temafey/ArduinoWindStation/tasks/README.md

# Сборка Wind Station — очередь задач

Каждая задача — отдельная сессия Claude Code.
Стартовый промпт: `Читай tasks/NN-name.md и выполни задачу шаг за шагом. Источники истины: CLAUDE.md, bom-photos.md.`

## Статус

Статусы 01–07 выставлены по факту: станция собрана на макетке и работает — читает батарею
и сигнал датчика, светодиодами рулит прошивка. Плата с 2026-09-11 — `d4:e9:f4:02:c4:48`
(старая признана бракованной), IP плавает по DHCP: искать
`arp -a | Select-String 'd4-e9-f4-02-c4-48'`, либо AP 192.168.4.1.
Файлы этих задач писались до сборки и внутри себя выполнение не отмечают.

| # | Задача | Статус | Блокер |
|---|---|---|---|
| 01 | [Светодиоды на макетке](01-leds.md) | ✅ Сделано | — |
| 02 | [Настройка boost-модулей](02-boost-config.md) | ✅ Сделано | — |
| 03 | [Подготовка батарей](03-batteries.md) | ✅ Сделано | — |
| 04 | [Силовая шина (diode-OR)](04-power-rail.md) | ✅ Сделано | — |
| 05 | [Делитель батареи GPIO32](05-battery-divider.md) | ✅ Сделано | — |
| 06 | [Делители сигнала GPIO34/35](06-signal-dividers.md) | ✅ Сделано (нужен только GPIO34 — датчик без направления) | — |
| 07 | [Подключение датчика](07-sensor.md) | ✅ Сделано | — |
| 08 | [Монтаж в корпус IP65](08-enclosure.md) | ⏸ **Делать последней** | сначала 10, иначе корпус вскрывать; PPTC нужен на 3 А, а не 2 А |
| 09 | [Пересоздать KiCad-проект (с тестами)](09-kicad-project.md) | ▶️ Pass 2 разблокирован | KiCad закрыт ✅ |
| 10 | [4G/GPS-модуль A7670E](10-a7670e-4g-gps.md) | ▶️ **Канал замкнут 2026-09-12.** Данные по 4G ходят, PPP поднимается, брокер HiveMQ работает с тремя учётками, прошивка публикует шесть топиков, **публичная копия дашборда показывает живой ветер с мачты** через свой MQTT-клиент по `wss://`. **Вся работа по коду и документам закрыта 2026-09-12** — pull-OTA сделан и проверен на железе (шаг 38), FQBN в `WindStation-kit.zip` поправлен (39), энергобюджет с модемом пересчитан (36). Остались только проверки на железе | ⛔ темп 5 Гц, радиополя по 4G и pull-OTA **через сам модем** — упираются в **11** и в ключ питания модема GPIO33 |
| 11 | [Выключатель и путь заряда](11-power-switch-and-charge-path.md) | ⏭ **Следующая после 10.** Отложена 2026-09-11, но задача 10 упёрлась в неё двумя пунктами: `powerSource` намертво `battery`, поэтому облако вечно в режиме 1 Гц, а 5 Гц физически непроверяем | — |
| 12 | [Плата J5019 — ресерч](12-j5019-evaluation.md) | 📋 Ресерч сделан, вердикт «в станцию не ставить» | — (стендовые замеры по желанию) |

Все компоненты на руках. Долги по железу собраны в **задачу 11**, но она отложена:
вход `IN+` TP4056 не припаян, банки в держателе нет, тумблер стоит после обоих бустов.
Там же — сверка номинала PPTC (нужен 3 А, не 2 А) и недоверие к делителю GPIO32.

⚠️ **Прямое следствие для задачи 10:** станция работает от USB, поэтому `battery` и
`batteryPercent` отдают `null`, `chargeState` — `absent`, `powerSource` — `battery`.
Это ожидаемо и за поломку не считается; дашборд уже разбирает такой случай по флагам
присутствия. Силовые замеры модема (TP1 под передачей, заряд до STDBY, пресет буста №3)
уехали в **задачу 08** — делать их до посадки модема в корпус не на чем.

## Порядок выполнения

```
Железо:  01 ✅ → 02 ✅ → 03 ✅ → 04 ✅ → 05 ✅ → 06 ✅ → 07 ✅ → 11 (отложена)
KiCad:   09 (документация электрики, независимо от железа)
4G/GPS:  10 (в работе) → 08 (корпус и вся силовая часть модема, в самом конце)
```

> **Порядок поменялся 2026-09-11: сначала 10, потом 11.** Прежний довод («мерить нечем,
> станция не отвечает») отпал — станция отвечает, модем отвечает, а работа фазы 3 задачи 10
> это код и один замер ваттметром, которым долги по зарядному узлу не мешают. Всё, что
> в 10 действительно упиралось в питание, перенесено в **08**: посадка модема в макетку,
> буст №3, TP1 под передачей, заряд до STDBY.

> **Актуальная схема — `wiring-v8.html`**: с 2026-09-06 в станции плата 38-pin DevKitC,
> она заняла колонки 1–19 вместо 1–15, и всё правее сдвинулось. Блок модема на ней
> нарисован целиком: кол. 36–42 наклейкой вниз, `GPIO27 (TX) → кол.37 «R»`,
> `GPIO25 (RX) ← кол.38 «T»`, SW1 в разрыве `OUT+` (вход блока — `51h`, не `49j`),
> земля модема — перемычка `41b`→`44b`. Контакты опознаются **по буквам шелкографии**,
> а не по номерам.
>
> ⚠️ **Но собрано сейчас не так.** До задачи 08 модем остаётся **внешним модулем со своим
> питанием**: три провода, и как именно — `wiring-v8-3.html`. Провод общей земли там
> обязателен, без него UART молчит при живом модеме. «Плюс» модема не брать с пина «5V» платы.
> `wiring-v7.html` (30-pin), `wiring-v6.html` и `wiring-v5.html` оставлены для сравнения.

> **08 переехала в конец очереди.** Закрывать корпус до интеграции 4G — значит вскрывать его
> обратно: модем добавляет блок питания, два провода UART и две антенны, которые надо разнести
> на 10–15 см. Заодно меняется и номинал PPTC (3 А вместо 2 А — расчёт в задаче 10, §Питание).

> Задача 09 опирается на `wind-station-schematic.md` — выверенный нетлист (источник истины для схемы).
