temafey/ArduinoWindStation/kicad/WindStation_drc_report.txt

** Drc report for WindStation.kicad_pcb **
** Created on 2026-06-30T23:53:48 **
** Report includes: Errors, Warnings **

** Found 34 DRC violations **
[silk_overlap]: Silkscreen clearance
    Rule: board setup constraints silk; warning
    @(115.9950 mm, 115.7750 mm): Rectangle of R5 on F.Silkscreen
    @(119.2650 mm, 118.8250 mm): Reference field of R6
[silk_overlap]: Silkscreen clearance
    Rule: board setup constraints silk; warning
    @(167.8550 mm, 98.2500 mm): Segment of BT2 on F.Silkscreen
    @(119.2650 mm, 98.5750 mm): Reference field of R1
[silk_overlap]: Silkscreen clearance
    Rule: board setup constraints silk; warning
    @(115.9950 mm, 99.5750 mm): Rectangle of R1 on F.Silkscreen
    @(119.2650 mm, 102.6250 mm): Reference field of R2
[silk_overlap]: Silkscreen clearance
    Rule: board setup constraints silk; warning
    @(129.6550 mm, 110.1250 mm): Arc of D4 on F.Silkscreen
    @(129.6550 mm, 113.6350 mm): Reference field of D5
[silk_overlap]: Silkscreen clearance
    Rule: board setup constraints silk; warning
    @(129.6550 mm, 117.5950 mm): Arc of D5 on F.Silkscreen
    @(129.6550 mm, 121.1050 mm): Reference field of D6
[silk_overlap]: Silkscreen clearance
    Rule: board setup constraints silk; warning
    @(119.2650 mm, 114.7750 mm): Reference field of R5
    @(115.9950 mm, 111.7250 mm): Rectangle of R4 on F.Silkscreen
[silk_overlap]: Silkscreen clearance
    Rule: board setup constraints silk; warning
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
    @(150.3750 mm, 99.5750 mm): Rectangle of D1 on F.Silkscreen
    @(153.0950 mm, 102.8250 mm): Reference field of D2
[silk_overlap]: Silkscreen clearance
    Rule: board setup constraints silk; warning
    @(115.9950 mm, 127.9250 mm): Rectangle of R8 on F.Silkscreen
    @(119.2650 mm, 130.9750 mm): Reference field of R9
[silk_overlap]: Silkscreen clearance
    Rule: board setup constraints silk; warning
    @(119.2650 mm, 135.0250 mm): Reference field of R10
    @(115.9950 mm, 131.9750 mm): Rectangle of R9 on F.Silkscreen
[silk_overlap]: Silkscreen clearance
    Rule: board setup constraints silk; warning
    @(129.6550 mm, 125.0650 mm): Arc of D6 on F.Silkscreen
    @(129.6550 mm, 128.5750 mm): Reference field of D7
[silk_overlap]: Silkscreen clearance
    Rule: board setup constraints silk; warning
    @(115.9950 mm, 119.8250 mm): Rectangle of R6 on F.Silkscreen
    @(119.2650 mm, 122.8750 mm): Reference field of R7
[silk_overlap]: Silkscreen clearance
    Rule: board setup constraints silk; warning
    @(119.2650 mm, 126.9250 mm): Reference field of R8
    @(115.9950 mm, 123.8750 mm): Rectangle of R7 on F.Silkscreen
[silk_overlap]: Silkscreen clearance
    Rule: board setup constraints silk; warning
    @(119.2650 mm, 139.0750 mm): Reference field of R11
    @(115.9950 mm, 136.0250 mm): Rectangle of R10 on F.Silkscreen

** Found 0 unconnected pads **

** Found 0 Footprint errors **

** Ignored checks **
    - Footprint has no courtyard defined
    - Track endpoint not centered on via
    - Tuning profile track geometries
    - Footprint doesn't match symbol's footprint filters
    - Footprint component type doesn't match footprint pads

** End of Report **
