temafey/ArduinoWindStation/DISPLAY.md

# Дисплей в корпусе — ESP32-2432S028 («Cheap Yellow Display»)

Отдельная плата со своим ESP32 и экраном 2.8″ 320×240. Показывает то же, что дашборд:
скорость, порыв, балл Бофорта, график за 10 минут, батарею, связь. Скетч —
`wind_display/wind_display.ino`, шрифты — `wind_display/display_fonts.h`
(генератор `gen_display_fonts.py`, руками не править), стеклянные фоны —
`wind_display/glass_bg.h` (генератор `gen_glass.py`, тоже руками не править).

## Что это за плата

«TPM408-2.8» — маркировка **стекла**, а не платы. На фото (`images/tft-tmp408-28.avif`)
у платы два USB (Type-C + micro), значит это **CYD 2USB**:

| Узел | Что стоит | Пины (зашиты платой) |
|---|---|---|
| MCU | ESP32-WROOM-32, 4 МБ | — |
| USB | **CH340C** (`VID_1A86&PID_7523`), не CP2102 как у станции | — |
| Экран | ST7789, 240×320, HSPI | SCK 14, MOSI 13, MISO 12, CS 15, DC 2, RST = EN |
| Подсветка | ШИМ | **GPIO21** |
| Тач | XPT2046, резистивный, свои пины | CLK 25, MOSI 32, MISO 39, CS 33, IRQ 36 |
| Датчик света | LDR | GPIO34 |
| RGB-светодиод | активный LOW | R 4, G 16, B 17 |
| Кнопки | BOOT / RST | GPIO0 / EN |

Разъёмы — Molex PicoBlade 1.25 мм (в комплекте обычно есть кабели):

- **P1**: `VIN` · `TX` · `RX` · `GND` — питание сюда
- **CN1**: `GND` · `IO22` · `IO27` · `3.3V` — данные сюда
- **P3**: `GND` · `IO35` · `IO22` · `IO21` — ⚠️ `IO21` это подсветка, не трогать

## Почему провод, а не WiFi

Дисплей мог бы подключиться к точке станции и читать `/api/stream`, но это ломает саму станцию:

- подключённый клиент AP **навсегда глушит поиск домашней сети** — `serviceUplink()`
  молчит, пока на точке кто-то есть (защита от дыр в чужом сеансе);
- занимает одно из четырёх мест на точке;
- зелёный WiFi-светодиод горит всегда и перестаёт что-либо означать, а `wifiRssi`
  начинает показывать сигнал дисплея вместо человека.

По проводу у дисплея радио выключено вовсе — это ещё и половина его тока.

## Разводка

Три провода, и только один из них — сигнал.

| От (станция) | Куда (дисплей) | Что |
|---|---|---|
| **GPIO23** — макетка **`18j`**, нижний ряд платы, между GPIO22 (`17j`) и GND (`19j`) | **CN1 `IO27`** | данные, 115200 8N1, 3.3 В логика с обеих сторон |
| «+» LOAD, **правая половина** рельса (колонки 32–61, там же, где питание модема) | **P1 `VIN`** | ~4.7 В шины; на плате свой AMS1117 |
| «−» **правая половина** рельса | **P1 `GND`** | единственная земля дисплея |

Не подключать: CN1 `3.3V`, P1 `TX`/`RX`, P3 целиком.

⚠️ **Землю дисплея — только на правую половину рельса.** Верхний «−» между колонками
21 и 31 — опорная земля АЦП: там низы делителей (`27a`, кол. 31), а слив с неё один —
перемычка в кол. 21. Подсветка на ШИМ — это десятки мА пульсирующего тока; пустить их
через этот участок значит смешать с сигналом датчика. Отдельный провод GND в кабеле
данных **не нужен и вреден**: земля у плат уже общая через рельс, второй путь сделал бы петлю.

**Проверка, что земля правильная:** в `/api/data` сравнить `speedMv` при подсветке 100%
и при погашенном экране (5 минут без касаний). Разница больше пары мВ — земля
подключена не туда.

Дисплей питается **после SW1** (см. `tasks/11`): выключил станцию — погас и дисплей.

Необязательно: герметичная кнопка между CN1 `IO22` и CN1 `GND` — будит подсветку, если
экран стоит за стеклом, через которое резистивный тач не нажать.

## Корпус

- Резистивный тач **через акрил не работает** — либо окно в крышке с уплотнителем
  по рамке стекла, либо стекло + кнопка на `IO22`.
- ЖК работает от −20 до +60 °C. На морозе ниже −20 он замедляется и бледнеет, но
  не портится; на солнце под чёрной крышкой нагрев — главный враг.
- Крепёж — четыре отверстия M3 по углам платы.

## Первый запуск

Библиотеки (ставятся один раз):

```powershell
& "C:\Program Files\Arduino CLI\arduino-cli.exe" lib install LovyanGFX ArduinoJson
```

TFT_eSPI **не нужна**: вся настройка LovyanGFX лежит в самом скетче. Драйвер CH340
Windows 11 ставит сам (устройство `USB-SERIAL CH340 (COMx)`).

Сборка:

```powershell
& "C:\Program Files\Arduino CLI\arduino-cli.exe" compile --fqbn esp32:esp32:esp32 `
  --output-dir build-display wind_display
```

Заливка. `arduino-cli upload -p COMx …` у этой платы часто падает с
**«Wrong boot mode detected (0x13)»**: конденсатор на EN мал, и автосброс не успевает.
Лечится руками — запустить заливку с ожиданием и перевести чип в загрузчик кнопками:

```powershell
$e = "$env:LOCALAPPDATA\Arduino15\packages\esp32\tools\esptool_py\5.3.0\esptool.exe"
$b = "$env:LOCALAPPDATA\Arduino15\packages\esp32\hardware\esp32\3.3.10\tools\partitions\boot_app0.bin"
cd build-display
& $e --chip esp32 --port COM8 --baud 115200 --before no-reset --connect-attempts 0 `
  write-flash -z --flash-mode dio --flash-freq 40m --flash-size detect `
  0x1000 wind_display.ino.bootloader.bin 0x8000 wind_display.ino.partitions.bin `
  0xe000 $b 0x10000 wind_display.ino.bin
```

Пока висит `Connecting…`: зажать **BOOT**, нажать и отпустить **RST**, отпустить **BOOT**.
Навсегда лечится заменой конденсатора EN на 1–10 мкФ (у Type-C версий это C4/C5), но для
редких заливок кнопок достаточно.

## Экран проверки цвета

Первые 2.5 с после включения — три полосы «КРАСНЫЙ / ЗЕЛЁНЫЙ / СИНИЙ» и стрелка в угол.
По ней одним взглядом настраиваются три константы в начале скетча:

| Что видно | Что поменять |
|---|---|
| красный и синий перепутаны | `PANEL_BGR` |
| фон белый, цвета негативом | `PANEL_INVERT` |
| стрелка не в левом верхнем углу | `DISPLAY_ROTATION` 1 ↔ 3 |

Если картинки нет вовсе (белый экран с подсветкой) — экземпляр с ILI9341:
`lgfx::Panel_ST7789` → `lgfx::Panel_ILI9341` в классе `LGFX`.

## Калибровка тача

Прошивка, как и станция, ничего не пишет в NVS. Калибровка — константа:
зажать **BOOT** при включении → коснуться четырёх меток → из Serial скопировать строку
`uint16_t touchCal[8] = {…};` поверх той, что в скетче, и поставить `TOUCH_CAL_VALID true`.
Для одного действия «тап = следующая страница» калибровка не обязательна.

## Что на экране

- **Главная**: часы (местное время из `epoch` станции, `--:--` пока у станции нет SNTP),
  плашки Wi-Fi / 4G / Облако (рисуются, только если поле есть в кадре), батарея;
  скорость крупно, порыв, балл Бофорта, шкала с отметками 5 и 15 м/с (пороги светодиодов
  станции, цвета те же); график за 10 минут — **пропуск, а не ноль**, если данных не было.
- **Тап** — страница «подробно»: напряжение, питание, адреса, 4G и оператор, облако,
  аптайм и причина ресета, `speedMv`/ноль, `loopMax`, счётчики провода.
- Нет кадров 3 с — красная строка «Нет данных от станции N с». Если кадров не было
  никогда, экран говорит, **где** искать: «не пришло ни байта» — провод или земля;
  «байты идут, кадров нет» — скорость порта или прошивка станции без `HAS_DISPLAY_LINK`.

## Стеклянный фон

Оформление — «Liquid Glass» из iOS 26/27 в варианте **Tinted** (плотное тонированное
стекло: читается издалека, а на экран ветра смотрят именно так). Выбран 2026-09-26
по превью из трёх вариантов: плоский, Clear, Tinted.

Посчитать стекло на лету плате нечем: размытие, линза у скруглённого края, блик по
кромке, тёмная кайма iOS 27 и тень — это работа для компьютера. Поэтому
`gen_glass.py` считает **готовый фон** 320×240 на каждую страницу и кладёт его во флеш
(`glass_bg.h`, два массива по 150 КБ). Плата только копирует нужный кусок фона в спрайт
области и рисует цифры сверху; полупрозрачные элементы (сетка графика, огибающая
порывов, отметки шкалы) — `fillRectAlpha()` поверх фона. У текста тень в 1 px, иначе
тусклые подписи тонут в светлых местах панели.

- Фон квантуется в RGB565 **с дизерингом Флойда–Стейнберга** — без него тёмный
  градиент на 16-битной панели ложится ступенями
- Всё неподвижное запечено в фон, включая дорожку шкалы. Поэтому раскладка в скетче
  обязана совпадать с `PANELS_MAIN` / `PANELS_DETAILS` / `TRACK` в генераторе: сдвинули
  панель — перегенерировать и пересобрать
- Цена — флеш: прошивка выросла с 48% до **71%** (931 203 из 1 310 720 байт)
- Скорость — **один размер на все значения**, 84 px. Это самый крупный кегль, при котором
  «28.8» (цифры DejaVu моноширинные, так что это худший случай) влезает слева от «м/с».
  На 96 px двузначная скорость уезжала за левый край; переключение размера на лету
  проверили и отвергли — прыгающие цифры хуже чуть более мелких
- Другой вариант: `GLASS_VARIANT` в генераторе. Превью всех вариантов:

```powershell
python wind_display\gen_glass.py --preview <папка>
```

## Подсветка

- гаснет через 5 минут без касаний (`BACKLIGHT_TIMEOUT_MS`, 0 = всегда горит);
- загорается сама при порыве ≥ 15 м/с;
- яркость по LDR. Пороги `LDR_BRIGHT_RAW`/`LDR_DARK_RAW` — стартовые: сырое значение
  печатается в Serial раз в 5 с, записать его в темноте и на свету и вписать.

## Проверка без станции

- `DEMO_WITHOUT_STATION 1` — синтетический ветер;
- или открыть монитор порта на 115200 и вставить строку, скопированную из
  `http://<станция>/api/data`, — USB-консоль читается тем же разборщиком, что и провод.

## На стороне станции

`HAS_DISPLAY_LINK 1` в `esp32_wind_station.ino`. UART1, только TX на GPIO23, кадр раз в
200 мс, пишется **только если целиком влезает** в кольцевой буфер, иначе пропускается и
считается в `dispDrop` строки телеметрии — `loop()` не блокируется никогда. Отключённый
или мёртвый дисплей станции не стоит ничего: UART не знает, слушает ли его кто-нибудь.

Ради этого PPP-аплинк переехал с UART1 на **UART2** (`MODEM_PPP_UART`): они с AT-консолью
`Serial2` и так никогда не держат порт одновременно. ⚠️ Это правка пути 4G — после заливки
проверить `/api/modem`: `state: online`.
