temafey/ArduinoWindStation/FLASHING.md

# Прошивка ESP32 Wind Station

Инструкция под конкретный ПК (Windows 11, PowerShell). Всё, что здесь написано, проверено на живой плате 2026-08-04; адреса и способ подключения обновлены 2026-08-07 под режим «только точка доступа» и 2026-08-15, когда плата снова стала появляться в домашней сети.

**Основной путь — OTA по WiFi.** Он быстрее (~20 секунд), не требует кабеля и не требует плясок с кнопками. USB нужен только когда OTA недоступен: точка доступа не поднялась, залита неисправная прошивка, или меняется схема разделов.

**Где искать плату.** Своя точка `WindStation` (пароль из `secrets.h`, плата всегда на 192.168.4.1) есть всегда — она не выключается ни при каких условиях. С 2026-08-15 плата вдобавок входит в домашнюю сеть `HomeSSID`, и тогда её видно оттуда по адресу от роутера. Заливать можно с любой из двух сторон; по домашней сети удобнее, потому что ПК не теряет интернет.

> **Разовая оговорка про первый переход.** Плата с *прежней* прошивкой сидит в домашней сети на 192.168.31.235 — именно туда и надо залить первое обновление, по старым адресам из истории этого файла (`-i 192.168.31.235 -I 192.168.31.150`). После перезагрузки она уже поднимет свою точку, и дальше действует раздел 2 в его нынешнем виде.

---

## 0. Окружение (уже установлено, проверять не нужно)

| Что | Версия | Где |
|---|---|---|
| arduino-cli | 1.5.1 | `C:\Program Files\Arduino CLI\arduino-cli.exe` |
| ядро ESP32 | `esp32:esp32@3.3.10` | `%LOCALAPPDATA%\Arduino15\packages\esp32\` |
| Python | 3.14.6 | `%LOCALAPPDATA%\Python\pythoncore-3.14-64\` |
| esptool | 5.3.1 | вызывать как `python -m esptool` |
| драйвер USB | **CP210x** (Silicon Labs), Windows 11 обычно ставит сам | порт — **посмотреть в диспетчере устройств** |

Плата: **ESP32 DevKitC, 38 pin**, модуль **ESP32-WROOM-32U** (антенна только внешняя, на u.FL),
мост **CP2102** (`VID_10C4&PID_EA60`). FQBN: **`esp32:esp32:esp32:PartitionScheme=min_spiffs`**
— от смены платы он не меняется, как и вся прошивка.

> **Схема разделов сменена 2026-09-11** с `default` на `min_spiffs`: `app0` вырос
> с 1 310 720 до 1 966 080 байт, `spiffs` ужался до 128 КБ, `nvs` остался на месте
> (`0x9000`, `0x5000`). Причина — задача 10: PPP + TLS + MQTT в остаток от 96% не помещались.
> **Суффикс обязателен во всех сборках**: без него компилятор сверяется со старым лимитом
> 1 310 720 и врёт про переполнение.

> **Плата сменилась 2026-09-06.** До этого стояла ESP32 DevKit V1, 30 pin, модуль
> ESP32-WROOM-32, мост CH340C (`VID_1A86&PID_7523`) на **COM15**. Отсюда два следствия
> для заливки: другой драйвер (Silicon Labs CP210x вместо WCH CH341SER) и **другой номер
> COM-порта** — команды ниже с `COM15` надо править под свой. Всё остальное — FQBN, адреса
> разделов, порядок кнопок, OTA — не изменилось. Оговорка «CH340 капризничает на 460800»
> к CP2102 **не относится**: 460800 для него штатная скорость.

Две ловушки, о которые легко споткнуться:

- **`arduino-cli` не виден в уже открытых окнах PowerShell.** Он попадает в machine PATH, но открытая сессия его не подхватит. Либо открой новое окно, либо зови по полному пути (как во всех командах ниже).
- **esptool 5.x перешёл на дефисы.** `write-flash`, `--before no-reset`. Старые `write_flash` и `no_reset` из гайдов под esptool 4 просто не запустятся.

---

## 1. Сборка

### Разовое исправление: имя папки

arduino-cli требует, чтобы **папка называлась ровно как главный `.ino`**. Сейчас папка `Esp-32`, а файл `esp32_wind_station.ino` — компиляция падает с «в скетче отсутствует основной файл: Esp-32.ino».

Проще всего исправить раз и навсегда:

```powershell
Rename-Item "C:\Users\temaf\OneDrive\Documents\Projects\TymurWindStation\Esp-32" -NewName "esp32_wind_station"
```

Дальше по тексту папка называется `esp32_wind_station`. Если переименовывать не хочешь — перед каждой сборкой копируй `esp32_wind_station.ino` и `web_content.h` во временную папку с правильным именем и собирай оттуда.

### Собственно сборка

```powershell
$cli = "C:\Program Files\Arduino CLI\arduino-cli.exe"
$sk  = "C:\Users\temaf\OneDrive\Documents\Projects\TymurWindStation\esp32_wind_station"
$out = "C:\Users\temaf\OneDrive\Documents\Projects\TymurWindStation\build"

& $cli compile --fqbn esp32:esp32:esp32:PartitionScheme=min_spiffs --output-dir $out $sk
```

Ожидаемый результат:

```
Скетч использует 1264219 байт (64%) памяти устройства. Всего доступно 1966080 байт.
Глобальные переменные используют 54432 байт (16%) динамической памяти.
```

**Запас снова есть: свободно ~685 КБ** (проверено 2026-09-11). На схеме `default` та же прошивка занимала 96% от 1 310 720, то есть 46 КБ свободных — и именно это заставило сменить разделы. Растёт при этом чаще не код прошивки, а дашборд внутри `web_content.h` — 13 ресурсов, 656 КБ исходно и **227 КБ в сжатом виде** (во флеше лежит сжатый): **если запас снова начнёт кончаться, сжимать надо дашборд, а не `.ino`**.

⚠️ **Суффикс `:PartitionScheme=min_spiffs` обязателен.** Без него сборка сверяется с лимитом 1 310 720 и сообщает о переполнении там, где его нет, а залитый образ окажется собран под другую таблицу разделов.

`web_content.h` генерируется из веб-исходников скриптом `gen_web_header.py`. Если правил дашборд — сначала прогони генератор, потом собирай (см. следующий раздел).

---

## 1a. Пересборка дашборда

Нужна, только если менял веб-интерфейс. Правки в самой прошивке (`.ino`) этот шаг не требуют — `web_content.h` уже лежит готовый и соответствует тому, что работает на плате (сверено побайтово).

Полный цикл:

```powershell
cd C:\Users\temaf\OneDrive\Documents\Projects\TymurWindStation\wind-ui
npm run build
cd ..
python esp32_wind_station\gen_web_header.py
```

Генератор ждёт исходники строго в `wind-ui/dist` и пишет `esp32_wind_station/web_content.h`. Дальше — обычная сборка прошивки из раздела 1 и заливка.

**Обязательная проверка после генерации (2026-09-12):**

```powershell
python esp32_wind_station\check_web_header.py
```

Сторож проверяет уже записанный заголовок — то есть ровно то, что уйдёт в git и во флеш, а не то, что генератор намеревался сделать. Ждём две вещи в его выводе: ни одного маршрута с префиксом `/assets/wind-cloud` и ни одного значения из `wind-ui/.env` внутри распакованного содержимого. Сам генератор при этом печатает, что облачный чанк **пропущен**, и **падает, если пропускать оказалось нечего** — молча промахнувшийся фильтр и есть тот самый регресс, ради которого всё это заведено.

⚠️ **Грепом заголовок проверять бесполезно.** Содержимое хранится как gzip, развёрнутый в десятичные байты, — искомой строки в файле нет как текста, и `Select-String` честно ответит «не найдено» на файл, где пароль лежит. Поэтому сторож распаковывает, в том числе массивы, на которые не ссылается ни один маршрут: такой ресурс прошивка никому не отдаст, но его байты всё равно уезжают в публичный коммит.

Почему это вообще важно: облачный чанк — **единственное исключение** из правила «один бандл на оба места». На хостинг он выкладывается (иначе публичная копия не покажет живой ветер), во флеш — нет. Разбор — `PUBLISHING.md` и `CLAUDE.md`, §Облачный канал.

Для разработки удобнее дев-сервер: `npm run dev` в `wind-ui`. Он слушает все интерфейсы (`server: { host: true }`), так что дашборд открывается с телефона по IP ноутбука — Vite печатает адрес в строке «Network». Обращается он при этом к живой плате по её адресу.

### Что где лежит

Код дашборда — **один файл `wind-dashboard.jsx` (~4300 строк) в корне проекта**, а не внутри `wind-ui/`. `wind-ui/src/App.jsx` только импортирует его как `'../../wind-dashboard.jsx'`. Об этом легко забыть при переносе проекта: скопировать одну папку `wind-ui` недостаточно, сборка упадёт на неразрешённом импорте.

Node.js 24.19.0 установлен (`winget install OpenJS.NodeJS.LTS`), npm 11.17.0. `node_modules/` уже на месте и переустановки не требует — бинарные зависимости в ней (`@rolldown/binding-win32-x64-msvc`, `lightningcss-win32-x64-msvc`) как раз под Windows x64. Если начнёт на них ругаться — `npm ci` в `wind-ui`.

Цикл проверен целиком 2026-08-04: пересборка даёт **бит в бит тот же `dist`**, что и был (совпадали и хэши в именах ассетов). Файлов в `dist` с тех пор стало 14, а маршрутов во флеше 13 — дашборд разъехался на ленивые чанки (`wind-map`, `wind-meteo`, `wind-live`, `wind-tutor`, `wind-permissions`, `wind-cloud`), и во флеш идут все, кроме последнего.

### Про размеры после пересборки

Длины gzip в новом `web_content.h` получатся немного другими, чем в текущем, даже если содержимое не менялось ни на байт: zlib в Python 3.14 жмёт чуть иначе, чем версия, которой генерировали исходный заголовок. Расхождение в пару сотен байт на файл — это норма, а не признак изменений. Проверять надо содержимое, а не размер.

**Чего ждать от строки «Скетч использует …» (2026-09-12, после шагов 26 и 33–35):**

| сборка | байт | % от `app0` |
|---|---|---|
| с облаком (`SECRET_HAS_CLOUD 1`) — то, что на плате | 1 500 769 | 76% |
| то же до полей шага 26 и новых панелей дашборда | 1 490 757 | 75% |
| без облака (`SECRET_HAS_CLOUD 0`) | 1 366 205 | 69% |

Разница в ~125 КБ между первой и последней строкой — это esp-mqtt, TLS и корневые сертификаты. ОЗУ: 59 400 байт глобальных, 18%. Сильное отклонение от этих чисел в меньшую сторону — повод посмотреть, а не выпал ли из сборки целый блок: **`SECRET_HAS_CLOUD` проверяется через `#if`, и в старом `secrets.h`, где макроса нет вовсе, он молча считается нулём.**

⚠️ **Отклонение вверх на десяток килобайт и больше после пересборки дашборда читать иначе: скорее всего во флеш уехал облачный чанк.** Он весит 9.4 КБ (4.3 КБ в gzip) и содержит учётку зрителя MQTT, а `web_content.h` коммитится в публичный репозиторий. Проверка — в следующем разделе; она стоит одну команду и делается **до** заливки, потому что после коммита секрет считается сгоревшим и меняется, а не вычищается.

---

## 2. Заливка по OTA (основной путь)

### 2.1 Выбрать сеть и узнать два адреса

Заливать можно двумя путями. `espota` в обоих случаях работает **с IP, а не с именем**, и ему нужны два адреса: платы и твоего ПК.

**Путь А — по домашней сети (основной с 2026-08-15).** Плата сидит в `HomeSSID` вместе с ПК, переключаться никуда не нужно, интернет не пропадает. Адрес платы выдал роутер, поэтому его надо спросить:

```powershell
(Invoke-WebRequest "http://192.168.4.1/api/data" -UseBasicParsing).Content |
  ConvertFrom-Json | Select-Object staConnected, staIp
```

— или, если плата уже видна из дома, тот же запрос по её домашнему адресу. Совсем без адреса: `staIp` печатается в Serial при подключении, а роутер показывает плату под именем `mywindprobebeta`. Стоит закрепить за ней адрес в DHCP роутера — иначе он однажды сменится.

Свой адрес в той же сети:

```powershell
Get-NetIPAddress -AddressFamily IPv4 -InterfaceAlias "Wi-Fi" |
  Select-Object IPAddress, InterfaceAlias
```

**Путь Б — через точку доступа платы.** Нужен, когда аплинка нет (плата на мачте, дома нет роутера) или когда на плате прошивка **старее 2026-08-15** — в ней домашней сети ещё не существует, и первая заливка возможна только так.

| | |
|---|---|
| SSID | `WindStation` |
| пароль | из `secrets.h` |
| IP платы | всегда **192.168.4.1** |
| дашборд | `http://MyWindProbeBETA.org` |
| IP ПК | выдаётся платой, обычно 192.168.4.2 |

Подключись к `WindStation` в системном меню WiFi. Дашборд после этого предложит открыться
сам — станция работает как captive-портал. Для заливки это не нужно, нужен адрес ПК:

```powershell
Get-NetIPAddress -AddressFamily IPv4 | Where-Object { $_.IPAddress -like "192.168.4.*" } |
  Select-Object IPAddress, InterfaceAlias
```

Пусто — значит ПК не в сети платы; всё остальное в этом разделе работать не будет. Искать адрес платы не нужно, он фиксированный.

Про интернет: пока ПК сидит на `WindStation`, интернета у него нет — точка никуда не ведёт. Это и есть причина, по которой путь А удобнее: собрал, залил, никуда не переключался.

### 2.2 Залить

```powershell
$ota = "$env:LOCALAPPDATA\Arduino15\packages\esp32\hardware\esp32\3.3.10\tools\espota.exe"
$bin = "C:\Users\temaf\OneDrive\Documents\Projects\TymurWindStation\build\esp32_wind_station.ino.bin"

# пароль OTA берём из secrets.h, а не пишем в командную строку: репозиторий публичный,
# а история PowerShell (ConsoleHost_history.txt) хранит всё, что было набрано руками
$otapw = (Select-String -Path C:\Users\temaf\OneDrive\Documents\Projects\TymurWindStation\esp32_wind_station\secrets.h `
  -Pattern 'SECRET_OTA_PASSWORD\s+"(.+)"').Matches.Groups[1].Value

# путь Б, через точку доступа платы
& $ota -i 192.168.4.1 -I 192.168.4.2 -p 3232 -P 45678 -a $otapw -f $bin -r

# путь А, по домашней сети — подставить staIp платы и свой адрес
& $ota -i 192.168.1.xxx -I 192.168.1.yyy -p 3232 -P 45678 -a $otapw -f $bin -r
```

`-I` — реальный адрес ПК из предыдущего шага; если DHCP платы выдал не `.2`, подставь свой.

> ⚠️ **Звать надо `espota.exe`, а не `python espota.py`** (проверено 2026-09-11).
> Скрипты делают одно и то же, но правило брандмауэра на этой машине заведено на
> **`espota.exe`**, а `python.exe` в нём не значится. Через питон заливка каждый раз
> доходит до `Authenticating … OK`, потом `Waiting for device...` и таймаут: плата
> аутентифицировалась и попыталась подключиться обратно на порт 45678, а Windows
> её не пустил. Симптом читается как «плата не отвечает», хотя не отвечает ПК.
> Тот же `.exe` лежит рядом с `.py` в `tools/`.
>
> ⛔ **`-d` не добавлять.** Debug-режим печатает `Namespace(... auth='…')` — то есть
> **пароль OTA открытым текстом** в консоль и в её историю. Репозиторий публичный;
> если это всё-таки случилось, пароль считать засвеченным и менять.

Параметры: `-i` — IP платы, `-I` — IP твоего ПК, `-p 3232` — OTA-порт платы, `-P 45678` — порт, который открывает у себя ПК, `-a` — пароль OTA (задан в `esp32_wind_station/secrets.h`, `SECRET_OTA_PASSWORD`).

Признак успеха:

```
Authenticating (PBKDF2-HMAC-SHA256)... OK
Result attempt 1: 'OK'
Success
```

Заливается только раздел приложения, примерно 20 секунд. Раздел `nvs` не трогается. После успеха плата перезагружается сама — и ПК на несколько секунд теряет её сеть, это ожидаемо.

Учти: OTA идёт через ту же точку доступа, на которой висит ПК. Обрыв заливки роняет соединение целиком, поэтому во время неё не трогай настройки WiFi на ПК и не подключай к плате телефон.

**OTA и 4G-модем — больше не враги, но по одной конкретной причине.** Перезагрузка ESP32 оставляет A7670E в CMUX, и на голый `AT` он отвечает полной тишиной (`total=0`), а снять CMUX нечем: PWRKEY притянут к земле через R104, штатный выход из CMUX у A7670 сломан. Лечится только снятием питания с модуля. Спасает то, что `ArduinoOTA.onStart()` выводит модем из CMUX **до** перезагрузки — проверено на четырёх OTA подряд, аплинк каждый раз возвращался с первой попытки за ~2 с и с тем же PPP-адресом, то есть PDP-контекст даже не рвался. Отсюда два следствия:

- после заливки смотреть `/api/modem`: **`tries: 1`** — модем вышел и вернулся штатно; больше единицы или `state: error` — застрял, и до снятия питания 4G не будет;
- **любая перезагрузка мимо кода** — паника, brownout, сторожевой таймер, а также **открытие USB-порта** (DTR дёргает ресет) — этой вежливости не получает. Посмотреть Serial кабелем на живой станции теперь стоит 4G-аплинка. Ровно за этим `loopMax`, `logMs` и `sseDrop` вынесены в `/api/data`.

**На мачте этот раздел не работает вовсе, и для неё есть отдельный путь.** `espota` требует входящего TCP-соединения к плате, а оператор выдаёт CGNAT-адрес — значит там обновление тянущее: станция сама скачивает образ по подписанной команде `ota`. Сделано и проверено на железе 2026-09-12, разбор — **раздел 2a** ниже. Локальный путь от этого главным быть не перестал: он быстрее и не требует класть прошивку на хостинг.

### 2.3 Если OTA не идёт

**`Test-NetConnection -Port 3232` показывает False — это НЕ проблема.** ArduinoOTA слушает 3232 по UDP, а не по TCP; TCP-соединение инициирует сама плата в сторону ПК. Не используй эту проверку как диагностику.

**Не суди об успехе по перехваченному выводу espota.** Строки `Result attempt 1: 'OK'` и `Success` печатает модуль `logging`, то есть они идут в **stderr**, и при захвате вывода в переменную (`$out = python … 2>&1`) в PowerShell 5.1 теряются. Внешне это выглядит как оборвавшаяся на середине заливка, хотя прошивка легла нормально. Надёжных признака два: **код возврата процесса** (`Start-Process -Wait -PassThru`, `ExitCode` 0) и состояние самой платы. Если вывод запускается прямо в консоль, без перехвата, строки видны и всё в порядке.

| Симптом | Причина |
|---|---|
| `Waiting for device...` и таймаут | Брандмауэр Windows блокирует входящее TCP на том процессе, который слушает 45678. **На этой машине правило заведено на `espota.exe`** — звать надо его, а не `python espota.py` (проверено 2026-09-11). Либо разреши `python.exe`, либо открой порт 45678 |
| `Authentication Failed` | Пароль не совпал с `SECRET_OTA_PASSWORD` той прошивки, которая **сейчас на плате** |
| `Error Uploading: timed out` на 8–35% по домашней сети | Не транзиент, а слабый канал. У ESP32 **одно радио** на свою точку и на аплинк, и при `uplinkRssi` около −75 dBm полтора мегабайта по нему не доходят: наблюдалось 2026-08-18, три попытки оборвались на 35%, 8% и отказе аутентификации подряд. Прошивка при этом не пострадала. Лечится не повтором, а сменой канала: заливать через точку платы (сильный сигнал, без хопа через роутер) или по USB |
| `Authentication Failed` сразу после сорвавшейся заливки | `ArduinoOTA` ещё не закончил откат прошлой сессии. Подождать полминуты, пароль тут не при чём |
| Windows не держится на точке платы | Ассоциируется, но не успевает взять DHCP и уходит назад «из-за отсутствия интернета». `netsh wlan set profileparameter name="WindStation" connectionmode=manual autoSwitch=no` этого **не** решает — наоборот, после него интерфейс может вообще перестать подключаться, и настройку придётся вернуть (`connectionmode=auto autoSwitch=yes`). Проверено 2026-08-18; проще уйти на USB |
| `No response from device` сразу после `Authenticating… OK` | Приглашение плата приняла, но обратное TCP-соединение к ПК не открыла. **Чаще всего транзиентно — просто повтори.** Наблюдалось 2026-08-07: первая попытка сорвалась, вторая с теми же параметрами прошла. Прошивка при неудаче не портится, на плате остаётся прежняя. Если повторяется устойчиво — проверь `-I` (адрес ПК мог смениться при переподключении) и брандмауэр: сеть станции Windows относит к профилю **Public**, а не Private |
| Плата на другой подсети | `-I` обязателен, если у ПК несколько интерфейсов — иначе espota сообщит плате неправильный обратный адрес |
| 192.168.4.1 не пингуется | ПК подключён не к `WindStation`, а к домашней сети. Проверь через `Get-NetIPAddress` из 2.1 |
| Windows сам ушёл с точки | «Нет интернета» — у точки его и нет. Сними у сети `WindStation` галку автопереключения на подключение с интернетом |

---

## 2a. Pull-OTA через облако (когда до платы не дойти)

Работает с 2026-09-12, проверено на железе. **Это не замена обычной заливке, а способ
дотянуться до станции, до которой нельзя дойти ногами.** Локальный путь — раздел 2 —
остаётся главным: он быстрее, он не требует хостинга, и он не оставляет копию прошивки
лежать в интернете.

**Почему вообще отдельный механизм.** `espota` открывает соединение **к плате**, а оператор
выдаёт станции CGNAT-адрес — входящего соединения до неё не существует в принципе, и
пробросом портов это не лечится. Значит обновление должно быть **тянущим**: станция сама
скачивает образ по ссылке, которую ей назвали подписанной командой.

### ⛔ Сначала про то, что лежит внутри `.bin`

Собранный образ несёт **открытым текстом все пароли станции**: ключи домашних сетей,
пароль точки, пароль OTA, учётку брокера и HMAC-ключ команд. Прошивка не пишет NVS, деть
их некуда — они просто лежат в коде.

Из этого три правила, и они не формальность:

- **хостинг не публичный и не индексируемый**, ссылка неугадываемая. Публичная копия
  дашборда для этого **не годится** — туда ходят посторонние;
- **файл удалить сразу после того, как станция его забрала.** Успешная заливка видна в
  ответном `ack` и по сброшенному аптайму;
- если образ всё-таки где-то полежал открыто — пароли считать сгоревшими и **менять**,
  ровно как с секретом в публичном коммите.

### Что послать

Команда — обычная подписанная команда облачного канала (формат подписи — §Облачный канал
в `CLAUDE.md` и `tasks/10`), операция `ota`, два обязательных аргумента:

```
op   = ota
args = url=https://хост/путь/wind-2026-09-12.bin&sha256=<64 hex>
```

`sha256` — хеш **того самого файла**, посчитанный до отправки:

```powershell
(Get-FileHash build\esp32_wind_station.ino.bin -Algorithm SHA256).Hash.ToLower()
```

Хеш здесь — не защита от битого скачивания, этим занят TCP. Он **и есть право на заливку**:
он едет внутри подписанной команды, поэтому подменённый на хостинге файл не сойдётся с
хешем, а подменённый хеш не сойдётся с подписью. Команда без хеша означала бы «залей то,
что по этой ссылке лежит сегодня», и поэтому отвергается, а не трактуется как «любой файл».

Ограничения, каждое из которых проверено на железе:

| | |
|---|---|
| URL не длиннее 159 символов | длиннее не влезет в аргументы команды, ответ — `need url=..., at most 159 chars` |
| **в URL не должно быть `&`** | разбор аргументов режет строку по `&`, хвост URL потеряется молча — наружу это выйдет как `http 404` |
| только `http://` и `https://` | всё прочее — `url must start with http:// or https://` |
| перенаправление **со сменой схемы не выполняется** | `http://`, который хост заворачивает на `https://`, кончается как `http 301`. Давать конечную ссылку |
| хост обязан отдавать `Content-Length` | без него ответ `no content-length (chunked?)`: чанковую передачу пришлось бы разбирать до того, как байты можно хешировать. Статика длину отдаёт всегда |
| образ меньше 200 000 байт не рассматривается | `N B is too small to be firmware` — это ловушка на страницу «404», отданную с кодом 200 |

### `https://` или `http://`

**Оба работают, и вопросы у них разные.**

- *Что можно залить* решают подпись и хеш — и они работают поверх обычного `http`. Поэтому
  `http://` здесь есть и должен остаться: в прошивке лежит корневая связка Let's Encrypt
  (`CLOUD_ROOT_CA`), и станция, умеющая тянуть обновление **только** по TLS, в день смены
  корня у хостинга превращается в мачту, которую уже нечем починить, кроме обновления,
  которое она больше не может получить.
- *Кто может прочитать образ* — вопрос отдельный, и ответ на него не «никому не интересно»
  (см. про пароли выше). По `http://` полтора мегабайта секретов едут по сотовой сети
  открытым текстом.

**Правило: `https://`, если корень хоста есть в прошивке; `http://` — запасной путь,
который работает всегда.** Проверено 2026-09-12: хост с сертификатом Let's Encrypt плата
принимает, хост с сертификатом GlobalSign — отвергает (`http -1`), то есть проверка цепочки
действительно работает, а не пропускает что попало.

### Как это выглядит со стороны оператора

На одну команду `ota` приходит **два подтверждения** — это нарочно:

```
ok=true   fetching over http in 1.5 s         ← приняли, начинаем (по TLS — «over TLS»)
ok=true   1548144 B in 9 s, sha ok, rebooting ← чем кончилось
```

Первое уезжает до того, как начнётся скачивание, иначе оператор ждал бы минуту в тишине.
Второе — результат. По каналу, где ответ может идти минутами, «начал» без «кончил» ответом
не является. Неудача выглядит так же, только `ok=false` и с причиной:

```
ok=false  sha256 mismatch, 1548064 B discarded   ← файл не тот, что назвали в команде
ok=false  http 404                                ← ссылка не туда; отрицательный код = транспорт
ok=false  stalled at 331776 of 1548064 B          ← 30 с ни одного байта
ok=false  link dropped at 331776 of 1548064 B     ← хост закрыл соединение
ok=false  heap 41000 B, need 60000 B              ← не хватило кучи, до рукопожатия
ok=false  an update is already queued             ← команду прислали дважды
```

**Провалившееся обновление не трогает работающую прошивку.** Хеш сверяется **до** того, как
раздел объявляется загрузочным: не сошёлся — образ выбрасывается, станция продолжает жить
на старой прошивке и остаётся на связи. Проверено: после подсунутого неверного хеша аптайм
не сбросился. Последняя причина отказа лежит ещё и в `/api/cloud` в поле `otaLast` — до
следующей перезагрузки.

### Чего это стоит станции

- **`loop()` стоит всё время скачивания** — то есть опрос датчика тоже. По домашней сети
  это 9 с на полтора мегабайта, по 4G — заметно дольше. Ровно та же цена, что у обычной
  заливки по воздуху, и по той же причине;
- порт 80 на это время закрывается, а подписчик SSE отключается — иначе неразобранные
  запросы съедают 16 TCP-соединений lwIP, и сборщик убивает саму загрузку;
- TLS-сессия просит десятки килобайт кучи поверх той, что уже держит MQTT. Если свободной
  меньше 60 КБ (20 КБ для `http`), станция откажется **до** рукопожатия и назовёт число —
  это лучше, чем падение посреди handshake, после которого читать нечего.

### Модем и pull-OTA

После успешной заливки станция выводит модем из CMUX ровно так же, как это делает
`ArduinoOTA.onStart()` (раздел 2.3) — иначе новая прошивка поднялась бы к модулю, который
молчит на голый `AT`, и на мачте это означало бы удачное обновление и мёртвую станцию.

⚠️ **Сам путь по 4G на 2026-09-12 не проверен**, и причина не в коде: модем сейчас сидит в
CMUX после одной из прошлых перезагрузок (`/api/modem` так и пишет: «needs its power
cycled»), а ключ питания на GPIO33 ещё не поставлен — это задача 11. Скачивание идёт по
маршруту по умолчанию, дома это WiFi (приоритет 100 против 20 у PPP), на мачте PPP будет
единственным маршрутом. Проверено всё, кроме последней мили: отказы, TLS, сверка хеша и
настоящая заливка с перезагрузкой — по домашней сети.

---

## 3. Заливка по USB (фолбэк)

Нужна, когда OTA недоступен. Здесь начинаются пляски с кнопками.

> **Наблюдение 2026-08-18: автосброс сработал.** С кабелем, который был в этот раз
> (CH340 на COM15), `esptool` 5.3.0 вошла в загрузчик **сама, с первой попытки** — подняла
> stub flasher, прочитала MAC, по окончании сделала `Hard resetting via RTS pin`. Кнопок
> не потребовалось, `--before no-reset` тоже. Полная заливка 1.16 МБ на 921600 прошла
> за 12.2 с, оба региона подтвердились хешем.
>
> Значит запрет ниже — не про чип, а про **конкретную сборку и кабель**: сопротивление
> и ёмкость в цепи сброса у разных кабелей и разных макеток разные. Порядок действий
> такой: сначала попробовать обычный `esptool ... chip-id` и посмотреть, синхронизируется
> ли она. Если да — заливать без кнопок. Если `Failed to connect` — тогда ручной вход
> по 3.1 и `--before no-reset`. **`arduino-cli upload` по-прежнему не использовать
> ни в каком случае**: он сам решает, когда и как сбрасывать, и подменяет адреса.
>
> Заливка по-адресно, которая сработала (`merged.bin` по `0x0` не трогать — затирает `nvs`):
>
> ```powershell
> $et = "$env:LOCALAPPDATA\Arduino15\packages\esp32\tools\esptool_py\5.3.0\esptool.exe"
> $b0 = "$env:LOCALAPPDATA\Arduino15\packages\esp32\hardware\esp32\3.3.10\tools\partitions\boot_app0.bin"
> & $et --chip esp32 --port COM15 --baud 921600 write-flash `
>     0xe000 $b0 `
>     0x10000 build\esp32_wind_station.ino.bin
> ```
>
> `0xe000` — это `otadata`, и писать его **обязательно**. Без него плата, однажды
> обновлённая по OTA, продолжит грузиться из `app1` со прежней прошивкой: заливка
> отрапортует успех, хеши сойдутся, а на устройстве ничего не изменится. `boot_app0.bin`
> возвращает выбор на `app0`. Загрузчик (`0x1000`) и таблицу разделов (`0x8000`) писать
> не нужно, если схема разделов не менялась.

> **Наблюдение 2026-09-07: на новой плате 38-pin автосброс НЕ сработал — и она была голой.**
> Первая заливка ESP32 DevKitC (ESP-32U, мост **CP2102**, `COM12`): плата на столе, одна,
> без макетки, без электролита, кабель тот же. `esptool ... chip-id` всё равно ответила
> `Wrong boot mode detected (0x13)! The chip needs to be in download mode` — то есть сброс
> прошёл, а GPIO0 при нём прижат не был. Помогли кнопки по 3.1. Вывод для документа:
> объяснение «виноват электролит» верно не всегда, дело ещё и в самой цепи автосброса
> на плате. Порядок остаётся прежним — сначала `chip-id`, и только при отказе кнопки.
>
> **Драйвер моста пришлось ставить отдельно.** До установки плата висела в диспетчере как
> `CP2102 USB to UART Bridge Controller` с ошибкой **28** («драйверы не установлены»)
> и COM-порта не давала вовсе: в системе был только CH340 от старой 30-pin платы.
> Ставится пакетом Silicon Labs `CP210x_Universal_Windows_Driver`
> (`pnputil /add-driver silabser.inf /install`, нужны права администратора; встал как
> `oem229.inf`). После `pnputil /scan-devices` появился `Silicon Labs CP210x USB to UART
> Bridge (COM12)`.
>
> Плата новая, флеш пустой, поэтому заливались **все четыре региона** — `0x1000` загрузчик,
> `0x8000` таблица разделов, `0xe000` `boot_app0`, `0x10000` прошивка. Сокращённый вариант
> из блока выше (только `0xe000` + `0x10000`) годится лишь для платы, на которой загрузчик
> уже есть.

**Почему вручную:** на плате стоит электролит по питанию, который ломает автосброс. Схема автоматического входа в download mode не срабатывает, а esptool своим дёрганьем DTR/RTS отменяет ручной вход. Поэтому — ручные кнопки плюс `--before no-reset`, и **никакого `arduino-cli upload`**.

### 3.1 Ввести плату в download mode

1. Зажми и держи **BOOT**.
2. Не отпуская BOOT — нажми и отпусти **EN**.
3. Продолжай держать **BOOT**. Отпустить можно, когда в выводе пойдёт `Writing at 0x...`.

### 3.2 Залить

```powershell
$core = "$env:LOCALAPPDATA\Arduino15\packages\esp32\hardware\esp32\3.3.10"
$b    = "C:\Users\temaf\OneDrive\Documents\Projects\TymurWindStation\build"

python -m esptool --chip esp32 --port COM15 --baud 460800 `
  --before no-reset --after no-reset `
  write-flash --flash-mode dio --flash-freq 40m --flash-size 4MB `
  0x1000  "$b\esp32_wind_station.ino.bootloader.bin" `
  0x8000  "$b\esp32_wind_station.ino.partitions.bin" `
  0xe000  "$core\tools\partitions\boot_app0.bin" `
  0x10000 "$b\esp32_wind_station.ino.bin"
```

После записи нажми **EN**, чтобы плата стартовала (`--after no-reset` намеренно не дёргает ресет сам).

> ⚠️ **`--flash-freq 40m` в этой команде — не опечатка и не временный костыль.** Частота
> шины флеша лежит в заголовке образа загрузчика по адресу `0x1000` (байт 3, младший
> полубайт: `0` = 40 МГц, `f` = 80 МГц), и **OTA этот заголовок не переписывает** —
> настройка переживает любое число заливок по воздуху. Значит поменять её можно только
> здесь, по USB, и **любая заливка с `0x1000` молча возвращает то, что стоит в этой
> строке**. До 2026-09-11 здесь стояло `80m`, и выполнение команды буквально откатывало
> плату обратно на 80 МГц. Обоснование выбора 40 МГц — в CLAUDE.md, раздел про схему v8:
> двойной запас по таймингам шины при незаметной на этой станции потере полосы.
> Проверить, что реально лежит на чипе:
>
> ```powershell
> python -m esptool --chip esp32 --port COM12 --before no-reset read-flash 0x1000 4 header.bin
> ```

> **Заливай поадресно, а не `merged.bin` на 0x0.** В папке сборки лежит готовый `esp32_wind_station.ino.merged.bin`, и соблазн залить его одной командой велик. Но он покрывает весь флеш целиком, включая раздел `nvs` на 0x9000 — а там сохранённые через `Preferences` настройки и WiFi-креды. После merged-заливки станция поднимется в режиме точки доступа `WindStation-Setup` и сеть придётся настраивать заново. Используй merged.bin только если именно этого и хочешь — полного сброса.

### 3.3 Если USB не идёт

| Симптом | Что делать |
|---|---|
| `Wrong boot mode detected (0x13)` | BOOT отпустили слишком рано. Повторить с шага 3.1 |
| `Failed to connect` | Плата не вошла в download mode. Повторить последовательность кнопок |
| Рвётся посреди записи | Снизить скорость: `--baud 115200`. Это была болячка CH340 на старой плате; у CP2102 460800 штатная, так что здесь смотреть в первую очередь на кабель |
| COM-порт вообще не появился | Кабель. Он должен быть data-capable, а не только зарядный — это самая частая причина |

Проверить, что порт на месте:

```powershell
Get-PnpDevice -PresentOnly | Where-Object { $_.InstanceId -match 'USB\\VID_10C4' } |
  Select-Object Status, Class, FriendlyName, InstanceId
```

Ожидается `Status: OK`, `Class: Ports`, `Silicon Labs CP210x USB to UART Bridge (COMxx)`.
Найденный номер порта и подставлять в команды выше. Для старой 30-пиновой платы тот же
запрос шёл по `VID_1A86` и находил `USB-SERIAL CH340 (COM15)`.

---

## 4. Проверка после заливки

Выполнять именно в таком порядке — каждая следующая проверка глубже предыдущей.

Выполнять с ПК, подключённого к точке `WindStation`.

```powershell
# 1. плата в сети и отзывается
Test-Connection -ComputerName 192.168.4.1 -Count 2

# 2. веб-дашборд поднялся
$r = Invoke-WebRequest -Uri "http://192.168.4.1/" -TimeoutSec 15 -UseBasicParsing
"$($r.StatusCode)"
if ($r.Content -match '<title>(.*?)</title>') { $matches[1] }

# 3. режим точки подтверждён самой прошивкой
(Invoke-WebRequest "http://192.168.4.1/api/wifi" -UseBasicParsing).Content

# 3a. облачный канал жив: connected=true, errors=0, pubLive растёт
#     (404 здесь означает сборку с SECRET_HAS_CLOUD 0, а не поломку)
(Invoke-WebRequest "http://192.168.4.1/api/cloud" -UseBasicParsing).Content

# 3b. 4G-аплинк пережил перезагрузку: state=online и tries=1
#     tries больше единицы или state=error — модем застрял в CMUX, см. ниже
(Invoke-WebRequest "http://192.168.4.1/api/modem" -UseBasicParsing).Content

# 4. имя резолвится через DNS-сервер платы
Resolve-DnsName MyWindProbeBETA.org -Server 192.168.4.1 -Type A
Invoke-WebRequest "http://MyWindProbeBETA.org/" -UseBasicParsing | Select-Object StatusCode
```

Ждём `200`, `MyWindProbe BETA`, `"mode":"ap"` с `"apOnly":true` и `192.168.4.1` в ответе DNS.

Отдельно стоит убедиться, что плата раздаёт **свежий** бандл, а не закэшированный старый: имя JS в `assets/` содержит хэш Vite и меняется с каждой сборкой. Возьми имя из вывода `npm run build` и запроси его напрямую — 200 означает, что на плате именно новая сборка.

Если DNS отвечает, а `Invoke-WebRequest` по имени — нет, значит ПК не спросил плату: Windows держит свой список DNS-серверов из DHCP. `ipconfig /all` покажет, какой сервер прописан на интерфейсе `WiFi`; должен быть 192.168.4.1.

Отдельная проверка, ради которой всё и затевалось: **точка должна остаться в списке сетей и через минуту, и через десять.** Если она пропадает секунд через пятнадцать после включения — на плате старая прошивка, заливка не прошла.

Проверка captive-портала (`Invoke-WebRequest` тут не годится — он превращает 302 в исключение,
чей ответ эта версия PowerShell не показывает):

```powershell
curl.exe -s -o NUL -m 15 -w "%{http_code} %{redirect_url}`n" http://192.168.4.1/generate_204
```

Ждём `302 http://MyWindProbeBETA.org/`. При этом `http://192.168.4.1/` обязан остаться `200` —
если редиректится и он, значит маршрут дашборда потерялся и портал зациклится.

### Serial-монитор

Штатный вариант (интерактивный, работает в обычном окне PowerShell):

```powershell
& "C:\Program Files\Arduino CLI\arduino-cli.exe" monitor -p COM15 -c baudrate=115200
```

Эталонный вывод исправной прошивки:

```
rst:0x1 (POWERON_RESET),boot:0x13 (SPI_FAST_FLASH_BOOT)
...
=== Wind Station ===
AP 'WindStation' up  IP: 192.168.4.1
DNS: catch-all -> 192.168.4.1  (http://MyWindProbeBETA.org)
Captive portal: DHCP option 114 advertised
mDNS: http://mywindprobebeta.local
OTA ready
HTTP: 80
Uplink: 1 network(s) to try in the background (2.4 GHz only)
Uplink: trying 'HomeSSID' (1/1)
V=0.0 m/s  D=0°  G=0.0  Bat=0.00V (0%) battery/absent  RSSI=-42
Uplink 'HomeSSID' joined  IP: 192.168.1.87  RSSI=-58
```

Нечитаемые символы в самом начале — это ROM-загрузчик, он говорит на 74880 baud. Норма, не баг. Дальше должен пойти читаемый текст.

**`Uplink ... joined` и адрес в ней** — то, ради чего этот лог стоит смотреть после заливки: другого способа узнать адрес платы в домашней сети без роутера нет (кроме поля `staIp` в `/api/data`). Строка приходит через несколько секунд после `HTTP: 80`, не мгновенно. Если её нет — плата не нашла сеть: проверь, что указана половина **2.4 ГГц**, а не `-5G`, и что пароль верен. Отсутствие аплинка ничего больше не ломает, точка доступа работает как работала.

Когда сетей в списке несколько, строки `Uplink: trying '…' (N/M)` идут одна за другой с шагом 12 секунд — это перебор кандидатов, а не ошибка. После неудачного прохода по всему списку следующий начнётся не раньше чем через 30 секунд, и дальше пауза удваивается до десяти минут.

Строк `Scanning for N known network(s)...` и `WiFi OK: …` быть не должно: их печатал **старый** станционный режим, который выключал точку доступа. Нынешний аплинк печатает `Uplink ...`. Если увидел старые строки — залита прошивка до 2026-08-07.

Строка `V=... D=... G=... Bat=...` печатается периодически. Нули в ней означают, что датчики ветра и батарея не подключены либо не отвечают. `RSSI` показывает уровень **подключённого к точке клиента**, а если на точке никого — уровень аплинка. `0` означает, что нет ни того ни другого, и это не признак неисправности.

---

## Быстрая шпаргалка

```powershell
# собрать
& "C:\Program Files\Arduino CLI\arduino-cli.exe" compile --fqbn esp32:esp32:esp32:PartitionScheme=min_spiffs `
  --output-dir C:\Users\temaf\OneDrive\Documents\Projects\TymurWindStation\build C:\Users\temaf\OneDrive\Documents\Projects\TymurWindStation\esp32_wind_station

# залить по воздуху. -i = адрес платы, -I = адрес ПК в той же сети:
#   из домашней сети — staIp платы и свой IP от роутера (интернет не пропадает)
#   через точку платы — 192.168.4.1 и 192.168.4.2 (сначала подключиться к 'WindStation', пароль из secrets.h)
$otapw = (Select-String -Path C:\Users\temaf\OneDrive\Documents\Projects\TymurWindStation\esp32_wind_station\secrets.h `
  -Pattern 'SECRET_OTA_PASSWORD\s+"(.+)"').Matches.Groups[1].Value
& "$env:LOCALAPPDATA\Arduino15\packages\esp32\hardware\esp32\3.3.10\tools\espota.exe" `
  -i 192.168.4.1 -I 192.168.4.2 -p 3232 -P 45678 -a $otapw `
  -f C:\Users\temaf\OneDrive\Documents\Projects\TymurWindStation\build\esp32_wind_station.ino.bin -r

# убедиться, что живая
Invoke-WebRequest http://192.168.4.1/ -UseBasicParsing | Select-Object StatusCode

# хеш образа — если заливка идёт тянущей командой ota из раздела 2a
(Get-FileHash C:\Users\temaf\OneDrive\Documents\Projects\TymurWindStation\build\esp32_wind_station.ino.bin `
  -Algorithm SHA256).Hash.ToLower()

# узнать адрес в домашней сети
(Invoke-WebRequest http://192.168.4.1/api/data -UseBasicParsing).Content |
  ConvertFrom-Json | Select-Object staConnected, staIp
```

---

## Справочные значения

| Параметр | Значение | Где задано |
|---|---|---|
| адрес дашборда | `MyWindProbeBETA.org` | `esp32_wind_station.ino`, `portalHost` |
| hostname / mDNS | `mywindprobebeta` → `mywindprobebeta.local` | `esp32_wind_station.ino`, `hostname` |
| пароль OTA | в документе не печатается | **`secrets.h`**, `SECRET_OTA_PASSWORD` |
| SSID точки | `WindStation` | `esp32_wind_station.ino`, `apSsid` |
| пароль точки | в документе не печатается (WPA2) | **`secrets.h`**, `SECRET_AP_PASSWORD` |
| домашние сети | список, 2.4 ГГц | **`secrets.h`**, `SECRET_HOME_NETWORKS` |
| аплинк вкл/выкл | `1` | **`secrets.h`**, `SECRET_HAS_HOME_NETWORK` |
| облачный канал вкл/выкл | `1` | **`secrets.h`**, `SECRET_HAS_CLOUD` |
| брокер MQTT | TLS, порт 8883 | **`secrets.h`**, `SECRET_MQTT_HOST`/`PORT` |
| учётка станции | в документе не печатается | **`secrets.h`**, `SECRET_MQTT_USER`/`PASSWORD` |
| ключ подписи команд | 64 hex-символа, в документе не печатается | **`secrets.h`**, `SECRET_CMD_HMAC_KEY` |
| учётка зрителя | в документе не печатается | **`wind-ui/.env`**, `VITE_MQTT_VIEWER_*` |
| топики станции | `wind/<id>/` + `live`, `state`, `status`, `hist`, `cmd`, `ack` | `<id>` = `SECRET_MQTT_STATION_ID` |
| OTA-порт платы | 3232 (UDP) | дефолт ArduinoOTA |
| HTTP-порт | 80 | прошивка |
| IP платы | 192.168.4.1 | фиксированный, дефолт SoftAP |
| IP ПК | 192.168.4.x | выдаёт DHCP платы |
| клиентов на точке | до 4 | `esp32_wind_station.ino`, `apMaxClients` |
| serial | 115200 baud | прошивка |

Домашняя сеть в схеме снова участвует — с 2026-08-15 плата работает в режиме **AP+STA**: точка доступа поднимается безусловно, домашняя сеть добавляется к ней. Имена сетей и пароли — в `secrets.h` (`SECRET_HOME_NETWORKS`), адрес платы в домашней сети — в `staIp` из `/api/data`. Старый *станционный* режим (пул сетей в NVS, точка гасилась после подключения) не вернулся — см. `FIRMWARE.md`, раздел 5.

Разделы флеша — **`min_spiffs`, сменены 2026-09-11** (было `default`): `nvs` 0x9000 (20 КБ), `otadata` 0xe000, `app0` 0x10000 (**0x1E0000 = 1.875 МБ**), `app1` 0x1F0000, `spiffs` 0x3D0000 (128 КБ), `coredump` 0x3F0000. Таблица вычитана с чипа и совпала. ⚠️ Сменить её можно **только по USB** — OTA не переписывает `0x8000`, и на мачте этот ход недоступен.
