temafey/ArduinoWindStation/A7670E-DRIVERS.md

# Драйверы и первый запуск платы 4G/GPS (BK-A7670 V1 / SIMCom A7670E)

Как поднять модуль на Windows и начать говорить с ним AT-командами. Всё проверено
на живом железе 2026-08-16: по этой процедуре модуль завёлся, показал GNSS, встал в LTE
и выдал координаты. Ставится один раз на машину; дальше плата просто определяется.

Плата, распиновка, питание и вся интеграция со станцией — в `tasks/10-a7670e-4g-gps.md`.
Здесь только про то, как компьютер начинает видеть модуль.

---

## Коротко

```powershell
# 1. распаковать вендорский архив (лежит в репозитории)
cd C:\Users\temaf\OneDrive\Documents\Projects\TymurWindStation\drivers
& "C:\Program Files\7-Zip\7z.exe" x A7600X-Windows-Driver.7z -oa7600x -y

# 2. поставить драйверы (скрипт сам попросит UAC)
.\install-drivers.ps1

# 3. проверить, что модуль отвечает (COM-порт взять из вывода шага 2)
.\at.ps1 -PortName COM10 -Cmds "ATI","AT+CPIN?","AT+CSQ"
```

Успех выглядит так: в диспетчере устройств три порта `SimTech HS-USB …` и модем,
а `ATI` возвращает `A7670E-MASA`.

---

## Шаг 0. Сначала физика, потом драйверы

**Это не формальность — на этой самой плате шаг 0 съел больше времени, чем всё остальное.**

Подключить micro-USB **до** установки драйверов и посмотреть в диспетчер устройств.
Питания платы хватает от порта ноутбука: VBUS заведён на VCC, внешний источник для
отладки не нужен.

Три возможных картины:

| Что видно | Что это значит |
|---|---|
| `SimTech HS-USB …` — уже есть | драйверы стоят, идти к шагу 3 |
| Неизвестные устройства с `VID_1E0E&PID_9011` | плата видна, не хватает драйверов → шаг 1 |
| `Unknown USB Device (Port Reset Failed)`, `VID_0000` | **проблема НЕ в драйверах** → см. ниже |

> ⚠️ **`Port Reset Failed` лечится сменой USB-порта, а не драйвером.** У нас плата
> висела именно так, при этом светодиод D5 на ней исправно мигал — то есть питание шло,
> а дескриптор не читался. Никакой драйвер тут не поможет: Windows ещё не знает, что
> это за устройство. **Помогло просто переткнуть кабель в другой USB-порт ноутбука.**
> Симптом «питание есть, а устройства нет» всегда отрабатывать портом и кабелем.

Проверить, что кабель именно **для данных**, а не только для зарядки — дешёвая
типовая причина того же симптома.

---

## Шаг 1. Пакет драйверов

**Архив лежит в репозитории: `drivers/A7600X-Windows-Driver.7z`.** Он закоммичен намеренно,
хотя это бинарник от вендора: единственный живой источник — GitHub стороннего человека,
а официальная страница Waveshare отдаёт 403 автозагрузчикам. Дважды искать этот файл
по форумам не хочется.

| | |
|---|---|
| Размер | 10 835 759 байт |
| SHA-256 | `E63208C1720A063577E041F7B23A537080C337AD44014E50444D36C7B2ADB4BF` |
| Источник | <https://github.com/TDLOGY/SIMCOM_USB_DRIVER> — их readme прямо называет этот архив для A7670 |

Проверить, если качаешь заново:

```powershell
Get-FileHash .\A7600X-Windows-Driver.7z -Algorithm SHA256
```

Распаковать в подпапку `a7600x` (её ждёт `install-drivers.ps1`):

```powershell
& "C:\Program Files\7-Zip\7z.exe" x A7600X-Windows-Driver.7z -oa7600x -y
```

Внутри — папки под XP-Vista / Windows7 / Windows8 / Windows10. **Нам нужна `Windows\Windows10`**,
она же годится для Windows 11.

---

## Шаг 2. Установка

```powershell
.\install-drivers.ps1
```

Скрипт сам перезапустится с запросом UAC и поставит **два** `.inf`:

- **`simser.inf`** — три COM-порта: Diagnostics, NMEA и **AT Port**. Ради последнего всё и делается
- **`simmdm.inf`** — модем

Остальные `.inf` в пакете (`simwwan`, `simfilter`, `simgnssusb`, `android_winusb`) не нужны:
WWAN/RNDIS-канал мы не используем, работа идёт через AT-порт.

Руками то же самое — две команды в консоли администратора:

```powershell
pnputil /add-driver .\a7600x\Windows\Windows10\simser.inf /install
pnputil /add-driver .\a7600x\Windows\Windows10\simmdm.inf /install
```

> **Подпись в порядке — отключать её проверку не нужно.** Все `.cat` и `.sys` в пакете
> подписаны WHQL, `Get-AuthenticodeSignature` даёт `Valid`. Любой совет из интернета
> «загрузись с отключённой проверкой подписи драйверов» для этого пакета — лишний риск
> без причины.

> ⚠️ **Встроенный `usbser.sys` не подходит.** Соблазн «указать драйвер вручную →
> USB Serial Device» есть, но у SimCom свой `simlteusbser.sys`. Через inbox-драйвер
> порты либо не поднимутся, либо будут вести себя странно.

---

## Шаг 3. Проверка: карта портов

После установки в диспетчере устройств должно появиться четыре записи. Композитное
устройство `VID_1E0E&PID_9011` раскладывается так:

| Интерфейс | Устройство | Зачем нам |
|---|---|---|
| `MI_00` | Remote NDIS | не используем |
| `MI_02` | SimTech HS-USB **Diagnostics** | не используем |
| `MI_03` | SimTech HS-USB **NMEA** | сюда идёт поток NMEA после `AT+CGNSSTST=1` |
| **`MI_04`** | **SimTech HS-USB AT Port** | **рабочий порт — сюда все AT-команды** |
| `MI_05` | SimTech HS-USB Modem | не используем |

Найти номера COM:

```powershell
Get-PnpDevice -Class Ports | Where-Object FriendlyName -like "*SimTech*" |
  Select-Object Status, FriendlyName
```

> ⚠️ **Номера COM плавают** от перетыкания кабеля и не закреплены за интерфейсами.
> В том сеансе вышло Diagnostics = COM7, NMEA = COM9, **AT = COM10**, но полагаться
> на эти числа нельзя — смотреть по имени. Заодно: в тот же день от перетыканий
> **CH340 самой станции уехал с COM8 на COM4**, так что после возни с модемом порт
> ESP32 тоже стоит перепроверить перед заливкой.

---

## Шаг 4. Первый разговор

```powershell
.\at.ps1 -PortName COM10 -Cmds "ATI","AT+SIMCOMATI","AT+CPIN?","AT+CSQ"
```

Что должно прийти:

```
Model: A7670E-MASA
Revision: A131B03A7670M6C_M
+CPIN: READY          ← PIN не запрошен, в прошивке setPin() не нужен
+CSQ: 27,99           ← ≈ −59 dBm
```

Скрипт `at.ps1` держит две вещи, без которых модуль молчит и это выглядит как поломка:

- **`DtrEnable` и `RtsEnable` в `$true`** — иначе модуль не считает порт открытым
- **завершать команду именно `CR` (`\r`), не `CRLF`**

Долгим командам давать окно: `-Wait 8000` для `AT+CFUN=1,1` и подобных.

---

## Разбор ошибок

**`Unknown USB Device (Port Reset Failed)` / `VID_0000`.**
Не драйвер. Другой USB-порт ноутбука, затем другой кабель. Мигающий светодиод на плате
означает только питание и ничего не говорит о данных.

**Порты появились, но на любую команду тишина.**
Скорее всего открыт не тот порт — Diagnostics или NMEA вместо AT. Проверить по имени
устройства, а не по номеру. Второе по частоте — не выставлены DTR/RTS.

**Порт есть, но открывается с ошибкой «занят».**
Порт держит другая программа: PuTTY, Arduino IDE, предыдущий зависший скрипт. Один порт —
один клиент.

**Порт исчез посреди сеанса, модуль перезагрузился.**
⚠️ **Это питание, а не софт.** У нас так случилось дважды подряд на USB ноутбука: пропадал
COM-порт, а после возврата оказывалось, что настройки GNSS сброшены. USB 2.0 на 500 мА
не тянет момент включения передатчика. Брать USB3 или порт с зарядным профилем, короткий
толстый кабель, а для долгих сеансов — внешние 5 В на VCC. Подробности и арифметика —
в `tasks/10-a7670e-4g-gps.md`, раздел «Питание».

**`AT+CGNSSINFO` вечно пустой.**
Два разных случая, и они лечатся по-разному:
- `AT+CGNSSPWR?` вернул `0` — **приёмник выключен**. Состояние GNSS не хранится в NVM,
  и любой перезапуск модуля его гасит. Давать `AT+CGNSSPWR=1` после каждого старта
- `AT+CGNSSPWR?` вернул `1`, а координат нет — **нет фикса**. Различить «мёртвая антенна»
  и «мало сигнала» за 30 секунд: `AT+CGNSSTST=1`, слушать **порт NMEA** (не AT!) и смотреть
  строки `GSV`. Проверено: в помещении SNR 9–30 и фикса не будет никогда, на улице SNR 33–46
  и фикс приходит за 15 секунд

**`AT+CLTS` отвечает `ERROR`.**
В этой прошивке команды нет, обычный рецепт SimCom не работает. Время включается
через `AT+CTZU=1`.

---

## Файлы

| | |
|---|---|
| `drivers/A7600X-Windows-Driver.7z` | вендорский пакет, закоммичен |
| `drivers/install-drivers.ps1` | установка через `pnputil`, сама просит UAC |
| `drivers/at.ps1` | отправить пачку AT-команд и показать ответы |
| `tasks/10-a7670e-4g-gps.md` | сама задача: питание, UART, прошивка, облако |
