temafey/ArduinoWindStation/full-sensor.md

# Полная сборка 01–07 — нетлист макетки (машиночитаемый)

> **Что это.** Полное определение станции на этапе задач 01–07: элементы, сети, пины, физические точки макетки. Портирование `full-sensor.html` в текст **без потери связей**.
>
> **Для кого.** Основной читатель — LLM-агент. Поэтому здесь нет картинки и нет ASCII-раскладки: схема представлена нетлистом. В EDA схема и нетлист — одна и та же информация, картинка лишь её рендер. Нетлист читается текстом и не теряет ничего, кроме внешнего вида.
>
> **Почему нет Mermaid/PlantUML-диаграммы.** Сеть — это *гиперребро*: она соединяет N пинов сразу. Графовые форматы умеют только парные рёбра, а сеть из 4+ пинов **невозможно** точно представить парными рёбрами — это доказанная теорема, а не вопрос вкуса: Ihler, Wagner & Wagner, «Modeling hypergraphs by graphs with the same mincut properties», *Information Processing Letters* 45(4):171–175, 1993 — *«There is no cut-model for k ≥ 4»* (модель существует только при k=3). `GND` здесь содержит 22 пина. Диаграмма не «упростила бы» её — она бы её подделала, выдумав порядок и электрическую дистанцию, которых нет.
>
> **Структура таблиц (§4 + §5) не компромисс, а необходимость.** Ни один формат не несёт одновременно точные сети и физическое размещение — это видно на этом же проекте: `kicad/WindStation.kicad_pcb` имеет координаты, но рассыпает `/GND` на 84 пада без списка; `.dsn` хранит сеть одной строкой, но без геометрии. Отсюда два слоя: §4 — физическая реализация сети, §5 — пины. §5 — это нормализованная форма гиперграфа (`сеть → {пины}` восстанавливается группировкой по колонке «Сеть»); в VLSI ровно эта форма стандартна — hMETIS `.hgr` пишет **одну строку на гиперребро со списком всех участников**.
>
> **Источники (сверено 2026-07-16).** Электрика — `wind-station-schematic.md` §3 (объявлен источником истины для KiCad). Физические координаты — сетка SVG внутри `full-sensor.html` (`x = 17·N + 71`, проверено на линейке колонок 20/25/30/35/40/45/50/55 → x=411/496/581/666/751/836/921/1006, отклонение 0). Распиновка и коэффициенты — `esp32_wind_station/esp32_wind_station.ino`.
>
> **Расхождения между источниками не сглажены, а вынесены в §9.** Одно из них (§9.1) — вероятный дефект схемы, а не разночтение.

---

## 1. Инварианты (нарушать нельзя)

1. **Аналоговые входы только на ADC1: GPIO32/34/35.** ADC2 (GPIO 0, 2, 4, 12–15, 25–27) не работает при активном WiFi.
2. **«−» пакета 18650 идёт на пад `B−` TP4056 отдельным проводом. НЕ на «−» рельс.** Между `B−` и `OUT−` внутри модуля стоят MOSFET'ы защиты DW01; связать их снаружи = отключить защиту.
3. **Делитель сигнала: верх 10k+5k = 15k (к сигналу), низ 10k (к GND).** Наоборот — нельзя.
4. **Верх делителя батареи (R5) — на `TP_B+`, после F1. НЕ на «+» рельс.**
5. **Питание ESP32 только через `VIN`** (шина ~4.7В), не через USB в рабочем режиме.
6. **Полоска (катод) обоих 1N5819 — к шине** (вправо).
7. **Рельсы 830-макетки разрезаны посередине. Нужны 4 моста** — по одному на каждый рельс.
8. **Boost#1 (U3) выдаёт 12В. На его вход 12В не подавать** — вход это `LOAD_RAIL` ~4.7В.
9. **Проверить `U3.OUT+` = 12В ДО подключения датчика.**
10. **GPIO ↔ роль жёстко связаны с прошивкой.** Менять GPIO = менять `.ino`.

---

## 2. Нотация

**Физическая точка** — где пин физически сидит:

| Запись | Значение |
|---|---|
| `f-j.48` | нижний банк (ряды f–j), колонка 48 |
| `a-e.10` | верхний банк (ряды a–e), колонка 10 |
| `рельс.низ.+` | нижний «+» рельс = сеть `RAIL_4V7` («ШИНА») |
| `рельс.низ.−` | нижний «−» рельс = `GND` |
| `рельс.верх.+` | верхний «+» рельс = сеть `LOAD_RAIL` («LOAD») |
| `рельс.верх.−` | верхний «−» рельс = `GND` |
| `клемма` | вывод модуля на проводах, вне макетки |

**Электрические правила макетки** — заявлены явно, выводить их самостоятельно не нужно и не следует:

1. Все 5 отверстий одной колонки одного банка (`a.10`, `b.10`, `c.10`, `d.10`, `e.10`) — **один узел**. Запись `a-e.10` обозначает этот узел целиком; конкретное отверстие внутри колонки роли не играет и в §5 не указывается.
2. Банки `a-e` и `f-j` **не соединены** между собой ничем, кроме явных перемычек из §4.
3. Каждый рельс — один узел по всей длине, **кроме разреза посередине**: у 830-точечной макетки половины каждого из 4 рельсов независимы. Сшивают их 4 связи типа `мост`; конкретные колонки разреза и мостов — только в §4, здесь не дублируются.
4. Ряды `a-e` и `f-j` разделены жёлобом; DIP-модули садятся верхом на жёлоб, и два их ряда пинов попадают в разные банки. У `U4` (ESP32) **все задействованные пины — в банке `a-e`** (`a-e.1` … `a-e.12`); противоположный ряд приходится на `f-j.1` … `f-j.15` и не разведён (см. §9.3 — прежде чем занимать эти колонки, сверься с платой).

> [!WARNING]
> **Номер колонки сам по себе не определяет узел — банки электрически независимы.** Ряды a–e и f–j разделены жёлобом, а нумерация колонок сквозная. Поэтому `f-j.48` (узел X, делитель батареи) и `a-e.48` (катод D6, WiFi-светодиод) — **разные сети с одним номером**. То же для колонок 20, 44, 46, 52, 54, 56. Всегда указывай банк.

> [!CAUTION]
> **Агенту, читающему этот файл: физический слой (колонка §4/§5) — твоё слабое место, и это измерено.** PCEval (arXiv 2601.02404) замерил LLM на физической разводке макетки против логической схемы: **13.6 % против 65.6 %** (Claude 3.7). То есть по сетям и пинам ты почти вчетверо надёжнее, чем по отверстиям.
> **Отсюда императивы:** координату колонки **бери из §4/§5 буквально, не выводи и не достраивай по соседям**. Обнаружил расхождение колонки с реальной платой — верь плате и скажи об этом, а не подгоняй. Собираешься занять колонку — сначала проверь по §5, не занята ли она **в том же банке**.

**Тип связи** — чем пин присоединён к сети:

| Тип | Значение |
|---|---|
| `колонка` | пружинный контакт колонки макетки (оба конца в одной колонке) |
| `рельс` | контакт через полосу рельса |
| `перемычка` | провод-перемычка макетки (цвет указан) |
| `мост` | перемычка через разрез рельса |
| `провод` | пайка / клемма модуля, вне макетки |
| `кабель` | внешний кабель (датчик на мачте, через PG7) |

**Пины** записаны как `элемент.пин` — номер пина символа из `wind-station-schematic.md` §1–2. Для двухвыводных деталей `.1`/`.2`; у полярных `.1` = «+»/анод.

---

## 3. Элементы

| Refdes | Тип | Номинал | Назначение |
|---|---|---|---|
| `U4` | ESP32 DevKit V1 (DOIT, 30 pin) | — | контроллер |
| `U1` | TP4056 Type-C | заряд + защита DW01 | заряд батареи, защита |
| `U2` | Mini Boost MT3608 | → 5.14 В | подъём батареи до шины |
| `U3` | Mini Boost MT3608 | → 12 В (пресет 1 1) | питание датчика |
| `D1` | 1N5819 Schottky | — | diode-OR, ветвь адаптера |
| `D2` | 1N5819 Schottky | — | diode-OR, ветвь батареи |
| `F1` | PPTC | 2 A | защита по току батареи |
| `BT1`, `BT2` | 18650 LG HG2 | ~3.95 В, 6000 мАч (параллель) | автономное питание |
| `C1` | конденсатор полярный | 1000 µF / 16 В | буфер шины |
| `C2` | конденсатор | 100 нФ | развязка питания ESP32 |
| `C3` | конденсатор | 100 нФ | фильтр узла скорости |
| `C4` | конденсатор | 100 нФ | фильтр узла направления |
| `C5` | конденсатор | 100 нФ | фильтр узла батареи |
| `R1` | резистор | 10 kΩ | верх делителя скорости, 1-й в серии |
| `R2` | резистор | 10 kΩ | низ делителя скорости |
| `R3` | резистор | 10 kΩ | верх делителя направления, 1-й в серии |
| `R4` | резистор | 10 kΩ | низ делителя направления |
| `R12` | резистор | 5 kΩ | верх делителя скорости, 2-й в серии (узел `SPEED_MID`) |
| `R13` | резистор | 5 kΩ | верх делителя направления, 2-й в серии (узел `DIR_MID`) |
| `R5` | резистор | 100 kΩ | верх делителя батареи |
| `R6` | резистор | 100 kΩ | низ делителя батареи |
| `R7`…`R11` | резистор | 220 Ω | токоограничение светодиодов |
| `D3` | LED зелёный | — | станция OK |
| `D4` | LED жёлтый | — | ветер > 5 м/с |
| `D5` | LED красный | — | ветер > 15 м/с |
| `D6` | LED зелёный | — | WiFi подключён |
| `D7` | LED красный | — | ошибка |
| `SW1` | выключатель SPDT | клавишный, на проводах | главный выключатель |
| `J1` | USB-C 5 В | панельный, пигтейл | внешний адаптер |
| `J2` | датчик ветра | Polycarbonate 0–5 В, 25 мА | 0–60 м/с, 0–360° |

---

## 4. Сети — физическая реализация

Уровень сети: чем сеть является физически и какие точки в неё входят. Пины — в §5.

| Сеть | В | Физические точки и связи между ними |
|---|---|---|
| `ADAPTER_5V` | 5.0 | `f-j.22` |
| `RAIL_4V7` | 4.6–4.8 | `f-j.25`, `f-j.33`, `f-j.38` — каждая красной перемычкой на `рельс.низ.+`. Рельс разрезан между кол.31/32 → **мост кол.30↔34** |
| `BOOST2_OUT` | 5.14 | `f-j.30` |
| `TP_OUT` | ~3.95 | только провод `U1.OUT+` → `U2.IN+`, вне макетки |
| `VBAT` | ~3.95 | `f-j.44` |
| `TP_B+` | ~3.98 | `f-j.46` |
| `PACK_MINUS` | 0 | **только отдельный фиолетовый провод пакет → `U1.B−`. Макетки не касается. См. §9.1** |
| `LOAD_RAIL` | 4.6–4.8 (SW1 вкл) | `рельс.верх.+`; `a-e.1` и `a-e.17` — красными перемычками на него. Рельс разрезан → **мост кол.30↔34** |
| `V12_SENSOR` | 12.0 | только провод `U3.OUT+` → `J2.VCC`, вне макетки |
| `SPEED_SIG` | 0–5 | `f-j.52` |
| `SPEED_ADC` | 0–2.0 | `f-j.54` («узел·54») → оранжевая перемычка на `a-e.12` |
| `DIR_SIG` | 0–5 | `f-j.16` |
| `DIR_ADC` | 0–2.0 | `f-j.18` («узел·18») → оранжевая перемычка на `a-e.11` |
| `BAT_ADC` | ~1.99 | `f-j.48` («узел X») → оранжевая перемычка на `a-e.10` |
| `LED_GREEN` | 0/3.3 | `a-e.7` → зелёная перемычка на `a-e.20` |
| `LED_YELLOW` | 0/3.3 | `a-e.6` → жёлтая перемычка на `a-e.28` |
| `LED_RED` | 0/3.3 | `a-e.5` → оранжевая перемычка на `a-e.36` |
| `LED_WIFI` | 0/3.3 | `a-e.8` → синяя перемычка на `a-e.44` |
| `LED_ERROR` | 0/3.3 | `a-e.9` → серая перемычка на `a-e.52` |
| `N_R7_D3` | — | `a-e.22` |
| `N_R8_D4` | — | `a-e.30` |
| `N_R9_D5` | — | `a-e.38` |
| `N_R10_D6` | — | `a-e.46` |
| `N_R11_D7` | — | `a-e.54` |
| `GND` | 0 | `рельс.верх.−` + `рельс.низ.−`, связаны **чёрной перемычкой по кол.57**. Оба рельса разрезаны → **мосты кол.29↔35** (по одному на рельс). Отводы: `a-e.2/19/24/32/40/48/56` на `рельс.верх.−`; `f-j.20/40/50/56` на `рельс.низ.−` |

**Итого 4 моста через разрез:** красные `кол.30↔34` на `рельс.верх.+` и `рельс.низ.+`; чёрные `кол.29↔35` на `рельс.верх.−` и `рельс.низ.−`.

---

## 5. Нетлист — соединения по пинам

Одна строка = один пин. Каждый подключённый пин каждого элемента присутствует ровно один раз.

### 5.1 Питание

| Сеть | Пин | Имя пина | Точка | Тип связи | Цвет |
|---|---|---|---|---|---|
| `ADAPTER_5V` | `J1.1` | +5В | клемма → `f-j.22` | провод | красный |
| `ADAPTER_5V` | `U1.1` | IN+ | клемма → `f-j.22` | провод | красный |
| `ADAPTER_5V` | `D1.1` | A (анод) | `f-j.22` | колонка | — |
| `RAIL_4V7` | `D1.2` | K (катод) | `f-j.25` | колонка | — |
| `RAIL_4V7` | `D2.2` | K (катод) | `f-j.33` | колонка | — |
| `RAIL_4V7` | `C1.1` | + (длинная ножка) | `f-j.38` | колонка | — |
| `RAIL_4V7` | `SW1.2` | B (общий) | `рельс.низ.+` @ кол.55 | провод | красный |
| `TP_OUT` | `U1.5` | OUT+ | клемма | провод | красный |
| `TP_OUT` | `U2.1` | IN+ | клемма | провод | красный |
| `BOOST2_OUT` | `U2.3` | OUT+ | клемма → `f-j.30` | провод | красный |
| `BOOST2_OUT` | `D2.1` | A (анод) | `f-j.30` | колонка | — |
| `VBAT` | `BT1.+` | + пакета | клемма → `f-j.44` | провод | красный |
| `VBAT` | `BT2.+` | + пакета | клемма → `f-j.44` | провод | красный |
| `VBAT` | `F1.1` | — | `f-j.44` | колонка | — |
| `TP_B+` | `F1.2` | — | `f-j.46` | колонка | — |
| `TP_B+` | `U1.3` | B+ | клемма → `f-j.46` | провод | красный |
| `TP_B+` | `R5.1` | — | `f-j.46` | колонка | — |
| `PACK_MINUS` | `BT1.−` | − пакета | клемма → `U1.4` | провод | **фиолетовый** |
| `PACK_MINUS` | `BT2.−` | − пакета | клемма → `U1.4` | провод | **фиолетовый** |
| `PACK_MINUS` | `U1.4` | B− | клемма | провод | **фиолетовый** |
| `LOAD_RAIL` | `SW1.1` | A (нагрузка) | `рельс.верх.+` @ кол.55 | провод | красный |
| `LOAD_RAIL` | `U4.1` | VIN | `a-e.1` | перемычка | красный |
| `LOAD_RAIL` | `U3.1` | IN+ | клемма ← SW1 LOAD | провод | красный |
| `LOAD_RAIL` | `C2.1` | — | `a-e.17` | перемычка | красный |
| `V12_SENSOR` | `U3.3` | OUT+ | клемма | провод | красный |
| `V12_SENSOR` | `J2.1` | VCC | клемма | кабель | красный |

`SW1.3` (пин C, третий бросок SPDT) — **не подключён**.

### 5.2 Сигнал — датчик → делители → ADC

| Сеть | Пин | Имя пина | Точка | Тип связи | Цвет |
|---|---|---|---|---|---|
| `SPEED_SIG` | `J2.3` | SPEED_OUT | клемма → `f-j.52` | кабель | бирюзовый |
| `SPEED_SIG` | `R1.1` | — | `f-j.52` | колонка | — |
| `SPEED_MID` | `R1.2` | — | `f-j.53` | колонка | — |
| `SPEED_MID` | `R12.1` | — | `f-j.53` | колонка | — |
| `SPEED_ADC` | `R12.2` | — | `f-j.54` | колонка | — |
| `SPEED_ADC` | `R2.1` | — | `f-j.54` | колонка | — |
| `SPEED_ADC` | `C3.1` | — | `f-j.54` | колонка | — |
| `SPEED_ADC` | `U4.12` | GPIO34 | `a-e.12` | перемычка | оранжевый |
| `DIR_SIG` | `J2.4` | DIR_OUT | клемма → `f-j.16` | кабель | бирюзовый |
| `DIR_SIG` | `R3.1` | — | `f-j.16` | колонка | — |
| `DIR_MID` | `R3.2` | — | `f-j.17` | колонка | — |
| `DIR_MID` | `R13.1` | — | `f-j.17` | колонка | — |
| `DIR_ADC` | `R13.2` | — | `f-j.18` | колонка | — |
| `DIR_ADC` | `R4.1` | — | `f-j.18` | колонка | — |
| `DIR_ADC` | `C4.1` | — | `f-j.18` | колонка | — |
| `DIR_ADC` | `U4.11` | GPIO35 | `a-e.11` | перемычка | оранжевый |
| `BAT_ADC` | `R5.2` | — | `f-j.48` | колонка | — |
| `BAT_ADC` | `R6.1` | — | `f-j.48` | колонка | — |
| `BAT_ADC` | `C5.1` | — | `f-j.48` | колонка | — |
| `BAT_ADC` | `U4.10` | GPIO32 | `a-e.10` | перемычка | оранжевый |

### 5.3 Светодиоды — GPIO → 220 Ω → анод, катод → GND

| Сеть | Пин | Имя пина | Точка | Тип связи | Цвет |
|---|---|---|---|---|---|
| `LED_GREEN` | `U4.7` | GPIO26 | `a-e.7` | перемычка | зелёный |
| `LED_GREEN` | `R7.1` | — | `a-e.20` | колонка | — |
| `N_R7_D3` | `R7.2` | — | `a-e.22` | колонка | — |
| `N_R7_D3` | `D3.A` | анод | `a-e.22` | колонка | — |
| `LED_YELLOW` | `U4.6` | GPIO27 | `a-e.6` | перемычка | жёлтый |
| `LED_YELLOW` | `R8.1` | — | `a-e.28` | колонка | — |
| `N_R8_D4` | `R8.2` | — | `a-e.30` | колонка | — |
| `N_R8_D4` | `D4.A` | анод | `a-e.30` | колонка | — |
| `LED_RED` | `U4.5` | GPIO14 | `a-e.5` | перемычка | оранжевый |
| `LED_RED` | `R9.1` | — | `a-e.36` | колонка | — |
| `N_R9_D5` | `R9.2` | — | `a-e.38` | колонка | — |
| `N_R9_D5` | `D5.A` | анод | `a-e.38` | колонка | — |
| `LED_WIFI` | `U4.8` | GPIO25 | `a-e.8` | перемычка | синий |
| `LED_WIFI` | `R10.1` | — | `a-e.44` | колонка | — |
| `N_R10_D6` | `R10.2` | — | `a-e.46` | колонка | — |
| `N_R10_D6` | `D6.A` | анод | `a-e.46` | колонка | — |
| `LED_ERROR` | `U4.9` | GPIO33 | `a-e.9` | перемычка | серый |
| `LED_ERROR` | `R11.1` | — | `a-e.52` | колонка | — |
| `N_R11_D7` | `R11.2` | — | `a-e.54` | колонка | — |
| `N_R11_D7` | `D7.A` | анод | `a-e.54` | колонка | — |

### 5.4 GND

| Сеть | Пин | Имя пина | Точка | Тип связи | Цвет |
|---|---|---|---|---|---|
| `GND` | `U4.2` | GND | `a-e.2` → `рельс.верх.−` | перемычка | чёрный |
| `GND` | `C2.2` | — | `a-e.19` → `рельс.верх.−` | перемычка | чёрный |
| `GND` | `D3.K` | катод | `a-e.24` → `рельс.верх.−` | перемычка | чёрный |
| `GND` | `D4.K` | катод | `a-e.32` → `рельс.верх.−` | перемычка | чёрный |
| `GND` | `D5.K` | катод | `a-e.40` → `рельс.верх.−` | перемычка | чёрный |
| `GND` | `D6.K` | катод | `a-e.48` → `рельс.верх.−` | перемычка | чёрный |
| `GND` | `D7.K` | катод | `a-e.56` → `рельс.верх.−` | перемычка | чёрный |
| `GND` | `C1.2` | − | `f-j.40` → `рельс.низ.−` | перемычка | чёрный |
| `GND` | `R2.2` | — | `f-j.56` → `рельс.низ.−` | перемычка | чёрный |
| `GND` | `C3.2` | — | `f-j.56` | колонка | — |
| `GND` | `R4.2` | — | `f-j.20` → `рельс.низ.−` | перемычка | чёрный |
| `GND` | `C4.2` | — | `f-j.20` | колонка | — |
| `GND` | `R6.2` | — | `f-j.50` → `рельс.низ.−` | перемычка | чёрный |
| `GND` | `C5.2` | — | `f-j.50` | колонка | — |
| `GND` | `J1.2` | GND | клемма → `рельс.низ.−` | провод | чёрный |
| `GND` | `U1.2` | IN− | клемма → `рельс.низ.−` | провод | чёрный |
| `GND` | `U1.6` | OUT− | клемма → `рельс.низ.−` | провод | чёрный |
| `GND` | `U2.2` | IN− | клемма → `рельс.низ.−` | провод | чёрный |
| `GND` | `U2.4` | OUT− | клемма → `рельс.низ.−` | провод | чёрный |
| `GND` | `U3.2` | IN− | клемма → `рельс.низ.−` | провод | чёрный |
| `GND` | `U3.4` | OUT− | клемма → `рельс.низ.−` | провод | чёрный |
| `GND` | `J2.2` | GND | клемма → `рельс.низ.−` | кабель | чёрный |

> `U4.17` (GND, нижний ряд ESP32) в KiCad-модели тоже на `GND`, но **на макетке не разведён** — используется только `U4.2`. См. §9.3.

---

## 6. ESP32 — физическая карта пинов

Модуль стоит верхом на жёлобе и занимает **колонки 1–15 в обоих банках**: верхний ряд пинов в банке `a-e`, нижний — в банке `f-j`.

| Колонка | 1 | 2 | 3 | 4 | 5 | 6 | 7 | 8 | 9 | 10 | 11 | 12 | 13 | 14 | 15 |
|---|---|---|---|---|---|---|---|---|---|---|---|---|---|---|---|
| **Ряд `a-e`** | VIN | GND | 13 | 12 | **14** | **27** | **26** | **25** | **33** | **32** | **35** | **34** | VN | VP | EN |
| **Ряд `f-j`** | 3V3 | GND | 15 | 2 | 4 | 16 | 17 | 5 | 18 | 19 | 21 | RX | TX | 22 | 23 |

Жирным — задействованные GPIO (все в банке `a-e`). Точная привязка к сетям — в §5.

**Свободные пины** — то, чего нет в нетлисте. Прежде чем занять любой из них, сверься с инвариантом №1:

| Пин | Колонка/банк | Можно занимать? |
|---|---|---|
| `13`, `12` | `a-e.3`, `a-e.4` | ⚠️ ADC2 — **нельзя** под аналог |
| `VN`, `VP` | `a-e.13`, `a-e.14` | ADC1 — можно (входы-only) |
| `EN` | `a-e.15` | нет — сигнал сброса |
| `3V3` | `f-j.1` | выход LDO, наружу не разводим |
| `GND` | `f-j.2` | земля платы; у нас берётся с `a-e.2` |
| `15`, `2`, `4` | `f-j.3`…`f-j.5` | ⚠️ ADC2 — **нельзя** под аналог |
| `16`, `17`, `5`, `18`, `19`, `21`, `22`, `23` | `f-j.6`…`f-j.11`, `f-j.14`, `f-j.15` | цифровые — можно |
| `RX`, `TX` | `f-j.12`, `f-j.13` | нет — занято USB/Serial при прошивке |

---

## 7. Математика делителей

Константы в `esp32_wind_station/esp32_wind_station.ino` (строки 45, 47) и номиналы обязаны совпадать. Изменил резистор — меняй константу.

| Делитель | Верх | Низ | Формула | Константа прошивки |
|---|---|---|---|---|
| Скорость (`R1`+`R12`/`R2`), направление (`R3`+`R13`/`R4`) | 10k+5k (=15 kΩ) | 10 kΩ | `Vsensor = Vadc × 2.5` | `SIGNAL_DIVIDER_RATIO = 2.5f` |
| Батарея (`R5`/`R6`) | 100 kΩ | 100 kΩ | `Vbat = Vadc × 2.0` | `BATTERY_DIVIDER_RATIO = 2.0f` |

**Почему 15k, а не 20k.** ADC ESP32 @ 11 dB линеен только в 150 мВ … 2.45 В. Со старым 20k полный размах датчика давал 3.0 В на входе — нелинейная зона, занижение скоростей >49 м/с на 5–15 %. С 15k: 5 В → 2.0 В, чистая зона. **15k набран из 10k+5k последовательно** (номинала 15k нет в наличии): сумма точна, `Vadc` и коэффициент 2.5 те же — прошивку менять не надо. Узел стыка пары (`SPEED_MID` = `f-j.53`, `DIR_MID` = `f-j.17`) несёт только эти два резистора, ничего больше.

**Почему два boost'а.** AMS1117 роняет 0.8–1.25 В (не 0.3 В). Без `U2` один диод от батареи оставил бы шину на 3.4 В → brownout ESP32 на WiFi TX. `U3` отдельный, потому что датчику нужно 12 В, а шина ~4.7 В.

**Читать АЦП только через `analogReadMilliVolts()`** — она применяет калибровку eFuse. Сырой `analogRead()` не применяет.

---

## 8. Точки замера

Мультиметр в `V⎓` (автодиапазон). Чёрный щуп — всегда в любую дырку `рельс.низ.−`.

| # | Красный щуп | Ждём | Если не так |
|---|---|---|---|
| 1 | `рельс.низ.+` | 4.6–4.8 В | питание не идёт по длине → проверь 4 моста |
| 2 | `рельс.верх.+` (SW1 вкл) | 4.6–4.8 В | SW1 выключен или не пропаян |
| 3 | `U2.3` (OUT+) | 5.14 В | сбит пресет boost'а (задача 02) |
| 4 | `BT1.+` / `BT2.+` | ~3.95 В | плохой контакт батареи |
| 5 | `f-j.46` (`TP_B+`) | ~3.98 В | плохой контакт пакет → `f-j.44` → F1 → `f-j.46` |
| 6 | `f-j.48` (`BAT_ADC`) | **~1.99 В и ровно** | пляшет → плохой контакт `R5`/`R6`/`C5` |
| 7 | `U3.3` (OUT+) — **до подключения датчика** | 12 В | не подключай `J2`, пока не увидел 12 В |

**Проверка по API:** `http://192.168.1.223/api/data` → `battery` ≈ 3.95, `batteryPercent` ≈ 64 %, `speed`/`direction` — реальные.

| Симптом | Причина |
|---|---|
| `battery` = 0.00 | `R5.1` не дошёл до `f-j.46` |
| `battery` ≈ 9.xx | `R6.2` не на `рельс.низ.−` (`f-j.50`) |
| `battery` скачет | нет `C5` — припаять `f-j.48` ↔ `f-j.50` |
| `battery` ≈ 4.7 | `R5.1` сидит на `рельс.низ.+` вместо `TP_B+` |

Дальше — **задача 08: монтаж в корпус**. Датчик внешний, на мачте, кабель через PG7.

---

## 9. Расхождения между источниками

Разночтения не сглажены. §9.1 — дефект, исправлен 2026-07-16. §9.2–9.3 — подписи `full-sensor.html`, приведены к канону тогда же; открытым остаётся только отсутствие refdes у `R1`…`R4` (§9.2).

### 9.1 ✅ `U1.B−` был закорочен на `OUT−` — исправлено 2026-07-16

> [!NOTE]
> **Дефект найден и устранён** в `kicad/WindStation.kicad_sch` и `kicad/WindStation.kicad_pcb` (копии — `*.bak-packminus`). Разбор сохранён: он объясняет, откуда взялась сеть `PACK_MINUS` и почему её нельзя сливать с `GND`. **Две связи осталось развести вручную** — см. конец раздела.

**Что было (проверено 2026-07-16 прямо в файлах проекта):**

| Пад | Сеть в `WindStation.kicad_pcb` |
|---|---|
| `U1.4` — **`B−`** | `/GND` |
| `U1.6` — **`OUT−`** | `/GND` |
| `BT1.2` — «−» банки | `/GND` |
| `BT2.2` — «−» банки | `/GND` |

Символ `WindStation_modules:TP4056_Module` объявляет `B−` пином **4** типа `passive`, а `OUT−` — пином **6**: это **разные узлы**, модуль не считает `B−` «точкой после защиты». Внутри модуля между ними стоят MOSFET'ы FS8205 под управлением DW01. Все четыре пада сведены на одну сеть `/GND` → медь замыкает защитные транзисторы. Сети «минус пакета» в проекте нет вовсе: полный список — 24 сети, `PACK_MINUS`/`BATT_NEG` отсутствуют.

**Это ровно та ошибка, от которой предупреждает `wind-station-assembly.md`** (предупреждение помечено там как load-bearing): ««−» пакета → пад `B−` своей перемычкой, НЕ на «−» рельс». В KiCad-проекте она зафиксирована в меди. Заметить её ERC/DRC не мог: электрически это корректная сеть, дефект — в модели, а не в правилах.

**Здесь смоделировано корректно:** отдельная сеть `PACK_MINUS` = {`BT1.−`, `BT2.−`, `U1.4`}; `GND` начинается с `U1.6` (`OUT−`). Ток пакета обязан идти `пакет −` → `B−` → (FS8205) → `OUT−` → рельс.

**Решено (2026-07-16):**
1. Имя `PACK_MINUS` — утверждено.
2. Починены оба слоя: `wind-station-schematic.md` §3 (источник истины) **и** сами `.kicad_sch`/`.kicad_pcb`.
3. Модуль подтверждён **с защитой**: `bom-photos.md` №2 и фото `images/TP4056-type-c-с-защитой.jpg` — DW01A + 8205A и **шесть** падов (`IN±`, `B±`, `OUT±`). Дефект реален. Вдобавок банки LG HG2 — **без** встроенной защиты, то есть DW01A в этой системе единственная.

**Что сделано в `kicad/`:**

- `.kicad_sch`: метки `GND` → `PACK_MINUS` на `U1.4`, `BT1.2`, `BT2.2`; 24 → 25 сетей.
- `.kicad_pcb`: те же три пада переведены на `/PACK_MINUS`; удалены **три** незаконных сегмента, 256 → 253.
- Проверено парсером: `/PACK_MINUS` = ровно {`BT1.2`, `BT2.2`, `U1.4`}; `U1.6` остался на `/GND`; меди у `U1.4` — **ноль**.

Удаление дорожек вскрыло, насколько глубоко сидел дефект: `GND` распался с одной группы на четыре, осиротив `C2.2`, `C3.2`, `C4.2`, `C5.2`, `U1.2`. Плата вела землю **через пад `B−`** как через перемычку — то есть медь была не просто неверно подписана, а физически заражена.

> [!WARNING]
> **Осталось развести вручную в pcbnew** (выдумывать трассировку я не стал):
> 1. `PACK_MINUS`: `BT2.2` → `U1.4`, ~39.2 мм — этой связи не было никогда.
> 2. `GND`: воссоединить осиротевший кластер — `U1.2`→`D3.1` ~7.4 мм либо `C5.2`→`U1.6` ~8.9 мм.
>
> Плюс `PWR_FLAG` на `PACK_MINUS` в eeschema (все три пина `passive` → ERC «no driver»). Плата намеренно оставлена **шумно недоделанной** (DRC покажет «unconnected items»), а не тихо неправильной. KiCad здесь не установлен — настоящие ERC/DRC не запускались, вся проверка сделана собственным парсером s-выражений.

### 9.2 Refdes конденсаторов и резисторов делителей

Здесь используются **канонические** имена из `wind-station-schematic.md`. Канон подтверждён независимо: футпринты в `kicad/WindStation.kicad_pcb` — ровно `C1`…`C5`, `R1`…`R11`, `D1`…`D7`, `U1`…`U4`, `F1`, `SW1`, `J1`, `J2`, `BT1`, `BT2`, и имена сетей там же совпадают с §4 один в один (25 сетей — после §9.1). `full-sensor.html` **приведён к канону 2026-07-16** (`C6`→`C3`, `C7`→`C4`). Осталось одно отличие:

| Деталь (по месту) | Канон (`wind-station-schematic.md`, здесь) | `full-sensor.html` |
|---|---|---|
| 10k верх-1 скорости, `f-j.52`→`f-j.53` | `R1` | без refdes |
| 5k верх-2 скорости, `f-j.53`→`f-j.54` | `R12` | без refdes |
| 10k низ скорости, `f-j.54`→`f-j.56` | `R2` | без refdes |
| 10k верх-1 направления, `f-j.16`→`f-j.17` | `R3` | без refdes |
| 5k верх-2 направления, `f-j.17`→`f-j.18` | `R13` | без refdes |
| 10k низ направления, `f-j.18`→`f-j.20` | `R4` | без refdes |

`R5`/`R6`, `C1`…`C5`, `D1`, `D2`, `F1`, `SW1` совпадают. Номиналы, колонки и топология сходятся полностью.

Отсутствие refdes у `R1`…`R4`, `R12`, `R13` — **не дефект, а следствие раскладки**: у каждого резистора в SVG ровно один текстовый слот, и занят он номиналом (сборщику из слота нужно знать, какой резистор взять). Вписать refdes рядом нельзя — линейка колонок стоит на `y=396` с шагом 17 px, и у подписи `«10k»`/`«5k»` зазор до соседнего номера уже ~3.5 px. Отдельный ряд `y=386` свободен только над верхними резисторами; у нижних свободного ряда нет. Номинал продублирован цветовыми полосками, и они нарисованы верно.

### 9.3 ✅ Нижний ряд пинов ESP32 — исправлено 2026-07-16

SVG подписывал нижний ряд `3V3, 15, 2, 0, 4, …` — без `GND` и с несуществующим `GPIO0`. У реального DOIT DevKit V1 (30 pin) второй пин со стороны `3V3` — это `GND`, а `GPIO0` на 30-пиновую гребёнку не выведен вовсе (он есть только на 36/38-пиновых). `wind-station-schematic.md` §2 подтверждает: пин символа 17 = `GND`.

Механика ошибки: потерян `GND`, `15`/`2` съехали на позицию влево, а образовавшаяся дырка заткнута правдоподобным `0`; с колонки 5 ряд сам вернулся в фазу — потому битых позиций ровно три. Такой сдвиг не ловится вычиткой: ряд выглядит осмысленным целиком.

Исправлено и в SVG, и в карте §6, которая воспроизводила подписи как есть. Канон: `3V3, GND, 15, 2, 4, 16, 17, 5, 18, 19, 21, RX, TX, 22, 23`.

На сборку это не влияло: `GND` на макетке берётся с `U4.2` (верхний ряд, `a-e.2`), нижний ряд не разведён.

---

## 10. Инварианты для самопроверки

Механически проверяемые утверждения. Агент, правящий эту схему, обязан их удержать:

1. Каждый подключённый пин из §3 встречается в §5 **ровно один раз**.
2. `SPEED_ADC` = ровно {`R12.2`, `R2.1`, `C3.1`, `U4.12`}; `DIR_ADC` = {`R13.2`, `R4.1`, `C4.1`, `U4.11`}; `BAT_ADC` = {`R5.2`, `R6.1`, `C5.1`, `U4.10`}. Верхнее плечо сигнальных делителей — пара 10k+5k: `SPEED_MID` = ровно {`R1.2`, `R12.1`}, `DIR_MID` = ровно {`R3.2`, `R13.1`}.
3. `U4.10/11/12` = GPIO32/35/34 — все на ADC1. Ни один аналоговый вход не сидит на GPIO 0, 2, 4, 12–15, 25–27.
4. GPIO ↔ роль в §5–6 совпадают с `PIN_*` в `esp32_wind_station/esp32_wind_station.ino` (строки 30–38).
5. Номиналы делителей в §3 дают коэффициенты §7, а те равны `SIGNAL_DIVIDER_RATIO` / `BATTERY_DIVIDER_RATIO` в прошивке.
6. `D1.2` и `D2.2` (катоды) оба в `RAIL_4V7`; аноды в **разных** сетях (`ADAPTER_5V` / `BOOST2_OUT`) — иначе diode-OR не работает.
7. `R5.1` в `TP_B+`, не в `RAIL_4V7`.
8. `U4.1` (VIN) в `LOAD_RAIL`, не в `RAIL_4V7`.
9. `U1.4` (B−) **не** в `GND` (см. §9.1).
10. Ни одна сеть не содержит одновременно точку `a-e.N` и `f-j.N` с одинаковым N без явной перемычки между ними.

> Пункты 1–5 проверяются скриптом-парсером этого файла против `.ino`. Такого скрипта в репозитории нет, и по `CLAUDE.md` инфраструктуры сборки/тестов здесь не заводят — скажи, если нужен, добавлю отдельно.
