temafey/ArduinoWindStation/tasks/11-power-switch-and-charge-path.md

# Задача 11: Выключатель в правильном месте + путь заряда

## Промпт для новой сессии
```
Читай tasks/11-power-switch-and-charge-path.md и выполни задачу шаг за шагом.
Источники истины: CLAUDE.md, wind-station-assembly.md.
```

## Статус
- Выключатель выбран и **куплен**: клавишный **KCD4, 250 В / 16 А, четыре ножевых
  контакта** — то есть два независимых полюса на одной клавише (DPST). Это и есть тот
  «апгрейд до двух полюсов», который в прежней редакции задачи был помечен как
  необязательный и «покупать отдельно»
- ✅ Схема нарисована под него — **`wiring-v9.html`** (2026-09-13), см. §Документация
- ⚠️ Станция сейчас **выключена владельцем намеренно** (не отказ). Прежний блокер
  «станция не отвечает» снят: 2026-09-11/12 она работала, канал 4G и MQTT подняты
- ⛔ Открытый долг, без которого половина этой задачи не проверяется: **перемычка от
  платы с диодом до `IN+` TP4056 не припаяна** (шаг 3). Пока её нет, состояние
  «OFF + адаптер = чистый заряд» физически не существует
- ⛔ Второй открытый долг, не из этой задачи, но лезть в ту же макетку:
  **провод датчика `33b` сидит в кол.14 (GPIO35) вместо кол.15 (GPIO34)** — отсюда
  `speedMv` намертво 142.0 при `speedSpreadMv 0`
- Связанные задачи: 04 (силовая шина — переделывается), 08 (корпус), 10 (модем)

## Зачем

Замечено 2026-08-16: **при выключенном тумблере питание всё равно идёт на A7670E, и оба
MT3608 продолжают тянуть из банки.** Это не сбой монтажа, а ошибка топологии — тумблер
стоит после обоих бустов и выключить их не может.

Сейчас (`wind-station-assembly.md`, блок-схема питания):

```
Адаптер ──Schottky_A──┐
                      ├── ШИНА ~4.7В ── SW1 ── ESP32 + Boost#1 (12В, датчик)
Банка ── Boost#2 ─────┘        ▲
   └──── Boost#3 (5.2В) ── модем A7670E    SW1 разрывает только то, что справа от него
```

Оба буста и модем висят на `OUT+` TP4056, то есть **выше по течению, чем SW1**. При
выключенном тумблере банка продолжает кормить холостой ход обоих MT3608 и модем целиком
(20–30 мА в покое, до ~0.65 А на LTE). Именно это высадило банку в ноль за один вечер
тестов 4G — `battery 3.25 В`, `batteryPercent 0`, мигающий красный.

## Решение: перенести SW1 на `OUT+` TP4056

Тумблер переезжает с входа шины (кол. 16/17 схемы v4) в **разрыв между `OUT+` TP4056 (кол. `49j`)
и всем, что от него питается** — входами буста №2 и буста №3. Это **полюс A** нового
выключателя; в схеме v9 он стоит ровно там, где в v8 стоял однополюсный SW1.

⚠️ **С колонки 49 уходят ДВА отвода, и переезжать они обязаны оба.** На схеме v6 это
`49i` → `55c` (вход буста №2, шина и ESP32) и `49j` → ключ → вход буста №3 (модем).
Тумблер встаёт в разрыв **до развилки**: общий контакт — на `OUT+` TP4056 (`49j`), второе
плечо — на новый узел **колонки 51** (`51j`; колонка 52 занята стояком земли датчика), и уже
из него берутся обе ветки — `51i`→`55c` и `51h`→ключ. Если перенести только `49j`, буст №2
останется висеть прямо на `OUT+` — тумблер снова окажется ниже по течению, чем половина
того, что он должен рвать, и таблица ниже станет неверной в двух строках из четырёх.
Проверка после монтажа простая: **при SW1 = OFF и вынутом адаптере на входах обоих
MT3608 ноль вольт**, а не 4 В.

Что даёт **один** полюс A (так было бы, останься выключатель однополюсным —
это состояние схемы v8, а не итог задачи):

| Полюс A | Адаптер | Поведение |
|---|---|---|
| ON | есть | как сейчас |
| OFF | есть | станция **продолжает жить** от адаптера через `D1` — модем и оба MT3608 обесточены, но шина под напряжением, и заряд идёт под нагрузкой ESP32 |
| OFF | нет | всё мертво, разряда **ноль** |
| ON | нет | автономный режим, как на мачте |

Вторая строка и есть причина, по которой одного полюса мало — разбор ниже.

Три следствия, ради которых это и делается:

1. **Выключено — значит выключено.** Банка перестаёт разряжаться в тумбочке.
2. **Разблокируется шаг 17 задачи 10.** Сейчас ток модема идёт через тот же узел и
   постоянно откладывает терминацию заряда, поэтому STDBY не загорается. С тумблером
   в положении OFF заряд идёт без нагрузки — и `chargeState: "full"` наконец можно увидеть.
3. Ток через контакты в худшем случае ~1.83 А (модем 1.5 А + станция 0.33 А на
   разряженной банке 3.0 В) — и это на полюсе A. У KCD4 паспортных 16 А, то есть запас
   почти десятикратный; полюс B несёт всего ~0.2 А. Постоянка при 4 В дугу не тянет,
   ограничение тут по нагреву контактов, а не по разрыву.

## Полюс B: почему одного полюса мало (схема v9)

Одного полюса не хватает по простой причине: **в шину входят два независимых источника** —
адаптер через `D1` и батарея через Boost#2 и `D2`. Полюс A стоит только в батарейной ветке,
поэтому при воткнутом адаптере `D1` продолжает кормить шину, и «выключено» означает
«выключено наполовину». Вынимать адаптер каждый раз — не решение, а ровно то неудобство,
из-за которого выключателем не пользуются.

**Полюс B стоит в разрыве самой шины, сразу за диодным ИЛИ:** `39j` (узел ШИНА, катоды
`D1`/`D2`) → контакт `B1`, контакт `B2` → **нижний «+» рельс, колонка 43** (правая половина;
в v8 она не использовалась вовсе). Ток через него скромный — ~0.2 А среднего
(ESP32 ~100 мА + вход Boost#1 ~75 мА), пики WiFi до 0.6 А.

Полюса ходят от одной клавиши, поэтому никакой новой последовательности действий не
появляется: щёлкнул — обесточено при любом источнике.

⚠️ **Питание платы после этого идёт СПРАВА НАЛЕВО, и мост `31↔32` стал единственной
точкой отказа ESP32.** Цепь: кол.43 низ → связка «+» кол.58 (верх↔низ) → верхний «+»
правый → `61a` (IN+ Boost#1) и параллельно мост `31↔32` через разрез рельса → верхний
«+» левый → кол.3 → по диагонали в `1a` («5V»). В v8 через этот мост шли 75 мА буста №1
слева направо; теперь через него идёт **весь** ток ESP32 в обратную сторону. Отойдёт
мост — умрёт плата, а датчик на 12 В останется живым: симптом читается как «ESP32 сдох»,
а не как «нет питания». Взамен исчез провод `39g` → кол.16 длиной около 40 см поперёк
всей макетки, который в v8 делал ровно ту же работу гораздо худшим способом.

### Четыре состояния — и одно из них новое

| Клавиша | Адаптер | Что происходит |
|---|---|---|
| ON | есть | рабочий режим. ⚠️ Boost#2 (5.14 В) **перебивает** адаптер (5.0 − 0.35 на `D1` = 4.65 В), то есть станция фактически ест из банки, пока TP4056 её заряжает |
| **OFF** | **есть** | **НОВОЕ в v9: всё обесточено полностью, а TP4056 заряжает банку вчистую, без нагрузки.** Это и есть единственный режим, в котором терминация заряда срабатывает и `chargeState` доходит до `"full"` |
| OFF | нет | всё мертво, разряда ноль |
| ON | нет | автономный режим, как на мачте |

⛔ **Вторая строка работает только после шага 3** (перемычка `37f` → `50b`): без неё
адаптер до `IN+` TP4056 не доходит вовсе, заряда нет ни при каком положении клавиши,
а `powerSource` намертво `battery`.

### ⚠️ Четыре контакта — это ещё не гарантия двух полюсов

У KCD4 с четырьмя ножевыми контактами бывает **две разные внутренности**: настоящий
DPST (два независимых полюса) и SPST **с подсветкой** (два контакта — силовые, два —
лампа). Снаружи они неотличимы, а перепутать — значит завести лампу в силовую цепь.

**Проверка мультиметром до монтажа, в режиме прозвонки:**

1. Найти пары. В каждой паре контакты замыкаются **вместе с клавишей**: в ON — звон,
   в OFF — обрыв. У DPST таких пар **две**, и они ведут себя одинаково.
2. **Померить МЕЖДУ парами** (любой контакт первой пары против любого контакта второй)
   в обоих положениях клавиши. У DPST здесь **обрыв всегда** — полюса независимы.
   Если между «парами» есть сопротивление в сотни ом или звон — это не второй полюс,
   а подсветка, и полюс там один.
3. Фолбэк, если попался вариант с подсветкой: **KCD4 ставится на полюс B** (шина, ~0.2 А),
   а полюс A остаётся на старом мини-тумблере из позиции 14 BOM. Схему это не меняет
   ни в одной точке — меняется только то, какая клавиша какой полюс держит, и щёлкать
   придётся две. Переделывать чертёж не надо.

**Это не отменяет P-FET на GPIO33.** Тумблер — ручной мастер-выключатель, полевик —
автоматический, и после ресерча v4 задачи 10 (2026-08-17) его работа изменилась.
Прежняя формулировка «гасить модем между сеансами связи, сеанс ~10 с раз в N минут»
**больше не верна**: канал теперь держится постоянно, 5 пакетов/с всё время работы станции,
пауз между сеансами нет вовсе. Остаются две работы, обе несократимые: снять зависший модем
(R104 держит PWRKEY на земле, выход из CMUX у A7670 сломан — VCC снять больше нечем) и
обесточить его на время заряда, чтобы терминация TP4056 наконец сработала.
⚠️ **И вместе с ключом ставится резистор 1 кΩ последовательно в GPIO27 → `R` модема.**
Ровно ключ и создаёт состояние, которого сегодня не бывает: модем обесточен, а ESP32
работает и держит на GPIO27 высокий уровень покоя UART — то есть питает вход
обесточенного модуля через его защитный диод. Отказ накопительный, а не мгновенный,
и вылезет молчащим модемом уже на мачте. Обратный провод (GPIO25 ← `T`) защищать
не от чего: там источник обесточен. На 115200 резистор не мешает. На мачте, где
тумблер трогать некому, это умеет только полевик.

## Порядок работ

Всё пайка/монтаж — за один заход, потому что лезть в один и тот же угол макетки.

1. **Оживить станцию.** Она пропала из сети целиком после снятия питания модема —
   ни HTTP, ни ping, ни ARP. Проверка «жив ли чип»: видна ли сеть `WindStation` со
   смартфона (точка безусловна, её отсутствие = питания нет; **ноутбук в неё не заводить**).
   Подозреваемые по убыванию: **F1 (PPTC) в кол. 44/46** (рядом C1 на 43/44 и провода
   буста №3; F1 уже давал ровно эту картину в июле, задача «brownout»), три «слепых»
   провода `44a`/`45a` (с 2026-08-30 их два, а не три: `35a` уехал на левый верхний
   «−», на колонку 31), провода буста №3, провода UART `37d`/`38d`.
2. **Померить ячейку без нагрузки.** Была 3.25 В под нагрузкой. ⚠️ Ниже ~2.5 В —
   **менять, не заряжать**: переразряженный Li-ion при зарядке опасен.
3. **Припаять перемычку от платы с диодом до `IN+` TP4056.** Долг с задачи 10, шаг 17:
   без неё банка не заряжается ни при каком адаптере.
4. **Прозвонить KCD4** — две независимые пары или пара + подсветка (методика выше).
   Делать до монтажа: результат решает, ставится ли один выключатель или два.
5. **Поставить полюс A** в разрыв `OUT+` (`49j` → `A1`, `A2` → `51j`), как выше.
6. **Поставить полюс B** в разрыв шины: `39j` → `B1`, `B2` → нижний «+» рельс, кол.43.
7. **Переложить питание платы на правую сторону:** снять связку «+» на кол.20, поставить
   связку «+» на **кол.58** (рядом с уже стоящей связкой «−»), убедиться, что мост «+»
   через разрез (`31↔32`) на месте и сидит плотно — теперь через него идёт весь ток ESP32.
   Длинный провод `39g` → кол.16 из v8 **снять целиком**.
8. **Сверить номинал PPTC в F1** — нужен 3 А, на 2 А сеанс модема идёт вплотную к порогу.
9. **Проверить делитель GPIO32 вольтметром** на живой ячейке. Он врёт: во время сеанса 4G
   показывал 4.24 → 4.33 В при `discharging` (для Li-ion невозможно), а банка при этом
   садилась в ноль. Калибровать батарею до этой сверки бессмысленно.
10. **Отложенные замеры задачи 10** (не блокер, данные по 4G ходят): пресет буста №3 = 5.2 В
   под нагрузкой, TP1 модема в момент передачи (норма ~4.0 В, ниже 3.9 → поднимать B3
   до 5.4 В; если U2 обжигает палец — наоборот, до 5.1 В).

## Проверка

- **Клавиша в OFF, адаптер воткнут:** станция **молчит целиком** — ни `/api/data`, ни сети
  `WindStation` со смартфона, все светодиоды погашены. На TP4056 при этом горит индикатор
  заряда, и через какое-то время он обязан смениться на STDBY: `chargeState` после
  включения покажет `"full"`. Это и есть закрытие шага 17 задачи 10, и ради этого
  состояния делался второй полюс.
  ⚠️ Если станция в этом положении **отвечает** — полюс B либо не поставлен, либо
  KCD4 оказался однополюсным с подсветкой (см. прозвонку выше).
- **Клавиша в OFF, адаптер вынут:** потребления нет, на входах обоих MT3608 ноль вольт
  (а не 4 В), на «+» рельсах ноль.
- **Клавиша в ON:** `powerSource` переключается, станция и модем работают как раньше.
  ⚠️ С воткнутым адаптером ждать `external` не стоит: Boost#2 (5.14 В) перебивает
  адаптер через `D1` (4.65 В), и станция честно рапортует `battery`. Это не ошибка
  прошивки и не повод чинить делитель.
- `speedMv` вернулся к эталону **142.0** при `speedSpreadMv 0` — значит делитель датчика
  при всей этой возне не задет.

## Документация — три пласта вместе

- `wind-station-assembly.md` — блок-схема Mermaid (`SW` переезжает с `RAIL --> SW`
  на разрыв после `TP`), таблица BOM позиция 14, раздел про монтаж тумблера
- ✅ **Схема под KCD4 нарисована — `wiring-v9.html`** (2026-09-13). Генераторы:
  `images/gen_wiring_v9_svg.py` → `images/wiring_v9.svg`, `images/gen_power_v9_svg.py`
  → `images/power_v9.svg`, сборка `images/build_wiring_v9.py`. **Руками не править** —
  генерируется. Что в ней нового по сравнению с v8:
  - выключатель нарисован блоком `bb.switch_dpst()` с четырьмя контактами `A1`/`A2`/`B1`/`B2`
    и пунктирной сцепкой «клавиша одна — полюса ходят вместе»;
  - **десять плюсовых цепей — каждая своим цветом**, с легендой `P1…P10` и подписью
    «что до выключателя, что после». Единый красный на все плюсы и был главной причиной,
    по которой v8 нельзя было читать пальцем;
  - длинный провод `39g` → кол.16 снят, питание платы пошло справа (кол.43 → кол.58 →
    мост `31↔32`), связка «+» на кол.20 удалена;
  - обходных проводов через весь лист больше нет; пересечения разведены дужками (`hop`).
- Прежняя схема под **один** полюс — `wiring-v7.html` (2026-08-30) и `wiring-v8.html`. Генераторы:
  `images/gen_wiring_v7_svg.py` → `images/wiring_v7.svg` → `images/build_wiring_v7.py`,
  копия SVG в корне (`wiring-v7.svg`, как у v4/v5/v6). **Руками не править** — генерируется.
  Что на ней: тумблер в разрыве `OUT+` (`49j` → SW1 → `51j`), новый узел на **колонке 51**
  (52 занята стояком земли датчика), оба отвода взяты уже за ним — `51i`→`55c` (буст №2,
  шина и ESP32) и `51h` → ключ (буст №3, модем), а узел ШИНА доходит до «+» LOAD прямым
  проводом `39g` → кол.4 (**на схеме v8 — кол.16**: плата 38-pin заняла колонки 1–19, а
  в колонках 1–4 у неё выведены контакты SPI-флеша, куда втыкать нельзя ничего).
  Провода `39g`→SW1 и SW1→«+» LOAD сняты. `wiring-v6.html` остаётся
  как «как собрано до этой задачи»; обе строки-предупреждения про невыключаемые бусты в v7
  заменены на разбор четырёх состояний тумблера
- `wind-station-assembly.md` — BOM позиция 14 переписана под KCD4, блок-схема питания
  показывает оба полюса, добавлена таблица четырёх состояний
- `tasks/04-power-rail.md` — пометить, что положение SW1 изменено этой задачей
- `tasks/10-a7670e-4g-gps.md` — шаг 17 разблокирован
