temafey/ArduinoWindStation/tasks/07-sensor.md

# Задача 07: Подключение датчика ветра

## Промпт для новой сессии
```
Читай tasks/07-sensor.md и выполни задачу шаг за шагом.
Источники истины: CLAUDE.md, bom-photos.md.
```

## Статус
- Блокеры: нет (датчик пришёл ✅, KF301-4P куплен ✅)
- Предыдущие задачи: 01–06 должны быть выполнены

---

## Цель
Подключить датчик к схеме, убедиться что скорость и направление показывают реальные данные.

## ⚠️ СТОП — проверь перед подключением датчика

**Обязательно измерь мультиметром:**
- Boost#1 OUT+ → должно быть **12.0 ± 0.3V**
- Если отклонение > 0.3V — НЕ подключай датчик, вернись к задаче 02

## Компоненты
| Компонент | Примечание |
|---|---|
| Датчик ветра Polycarbonate 0–5V | 4 провода (VCC, GND, скорость, направление) |
| KF301-4P клеммная колодка | 4-пин, шаг 5.08мм, под винт |
| Кабель FTP Cat5e 2×2×0.5 | ~3м, от датчика до корпуса |

## Провода датчика (типичная распиновка)
| Цвет | Сигнал | Подключение |
|---|---|---|
| Красный | VCC (10–30V) | Boost#1 OUT+ (12V) |
| Чёрный | GND | Общий GND |
| Жёлтый/зелёный | Скорость 0–5V | Вход делителя скорости (R_top 10k+5k) |
| Синий/белый | Направление 0–5V | Вход делителя направления (R_top 10k+5k) |

> ⚠️ Цвета могут отличаться — смотри инструкцию к своему датчику.
> Если инструкции нет: найди VCC/GND мультиметром (подай 12V, крути чашки — на сигнальных меняется напряжение).

## Проверки перед включением
1. Прозвонка: VCC датчика не замкнут с GND?
2. Прозвонка: сигнальные провода не замкнуты с VCC?

## Ожидаемое поведение
- При штиле: `"speed"` ≈ 0.0, `"direction"` = любое (флюгер в покое)
- При кручении чашек рукой: `"speed"` растёт
- При повороте флюгера рукой: `"direction"` меняется 0–360°
- `"adcError"` = false (оба сигнала > 10мВ)

## Результат задачи
- [ ] Датчик подключён
- [ ] speed меняется при кручении чашек
- [ ] direction меняется при повороте флюгера
- [ ] adcError = false
