temafey/ArduinoWindStation/tasks/09-kicad-project.md

# Задача 09: Пересоздать KiCad-проект «правильно, с тестами»

## Промпт для новой сессии
```
Читай tasks/09-kicad-project.md и выполни задачу шаг за шагом.
Источники истины: wind-station-schematic.md (нетлист!), CLAUDE.md, bom-photos.md.
KiCad должен быть ЗАКРЫТ перед началом.
```

## Статус
- Блокеры: **KiCad должен быть закрыт** (иначе нельзя архивировать старый проект и подменить fp/sym-lib-table).
- Pass 1 (этот документ + `wind-station-schematic.md`) — ✅ готово.
- Pass 2 (создание) — ⏳ ожидает закрытия KiCad.

## Цель
Заменить текущий KiCad-проект чистым, собранным строго по `wind-station-schematic.md`, с прохождением ERC=0, аудитом нетлиста против firmware и DRC=0.

## Что сохранить из старого проекта (выверенные активы)
- `esp32_devkit.kicad_sym` (символ ESP32_30Pin)
- `WindStation_modules.kicad_sym` (TP4056_Module, MiniBoost_HW085, WindSensor_0_5V)
- `WindStation.pretty/ESP32_DevKit_V1_30pin.kicad_mod` (футпринт ESP32, нумерация падов выверена по символу)

## Шаги
1. **Закрыть KiCad.** Проверить, что процесс не запущен.
2. **Архивировать** старый `kicad/` → `archive/kicad_v1/` (НЕ удалять безвозвратно). Скопировать активы выше в новый чистый `kicad/`.
3. `create_project` WindStation.
4. Прописать `sym-lib-table` (ESP32_DevKit, WindStation_modules, Device, Switch, Connector_Generic, power) и `fp-lib-table` (WindStation + глобальные).
5. Создать листы: root + `01_power`, `02_sensor`, `03_battery_monitor`, `04_leds` (иерархия — см. `wind-station-schematic.md §4`).
6. Разместить 33 компонента (§1), развести по нетлисту (§3), hier-метки (§4).
   - **Перед PWR_FLAG**: в `WindStation_modules.kicad_sym` сменить тип пинов `IN−/OUT−/B−` на `passive` (иначе конфликт power-output на GND — см. `wind-station-schematic.md §5.1`).
   - `PWR_FLAG` на `GND/ADAPTER_5V/VBAT/TP_B+/RAIL_4V7/LOAD_RAIL`.
   - `no_connect` на 3V3 ESP32, пин C тумблера и все неиспользуемые пины ESP32.
7. Назначить футпринты (§1).
8. **Тест 1 — ERC** (`run_erc`): добиться **0 ошибок** (§5.1).
9. **Тест 2 — полнота футпринтов** (§5.2): у всех 33 непустое поле, резолвится.
10. **Тест 3 — аудит нетлиста** (`export_netlist`) против §5.3 (галочки по каждому GPIO и делителю).
11. Annotate → `Update PCB from Schematic`.
12. Контур платы под перфоплату 90×60; класс сети POWER ≥0.8мм.
13. **Тест 4 — DRC** (`run_drc`): **0 нарушений** (§5.4).
14. **Тест 5 — кросс-чек BOM** (`export_bom`) против `bom-photos.md` (§5.5).
15. Экспорт: schematic PDF, BOM, netlist.

## Сверить с реальными деталями (см. wind-station-schematic.md §6)
- [ ] межрядное расстояние ESP32 (22.86 vs 25.4 мм)
- [ ] шаг ножек PPTC F1
- [ ] габарит холдера 18650

## Решения при сборке (Pass 2)
- **Схема собрана плоской (один лист), не иерархической.** Причина: связи через net-labels, привязанные к пинам инструментом `connect_to_net`, проверяемы и не зависят от геометрии sheet-pin'ов (в архивном проекте иерархия была разведена с ошибкой). Электрически идентично.
- **На `LOAD_RAIL` PWR_FLAG НЕ ставится**: пин `VIN` ESP32 в символе имеет тип `power_out`, он уже «драйвит» сеть; флаг там даёт ERC-конфликт «power output + power output». Флаги стоят на GND/ADAPTER_5V/VBAT/TP_B+/RAIL_4V7 (5 шт).

## Результат задачи
- [x] Старый проект в `archive/kicad_v1/`, новый `kicad/` собран по нетлисту
- [x] ERC = **0 ошибок** (145 warnings: off-grid из-за mm-координат + 1 lib-sync — безвредны)
- [x] Аудит нетлиста против firmware пройден (все галочки §5.3, 24 сети)
- [x] Все 33 футпринта назначены и резолвятся
- [x] BOM совпадает с `bom-photos.md`
- [x] Update PCB → **33 footprints** на плате (F8 в GUI)
- [x] Контур платы Edge.Cuts 78,48→170,150 (≈92×102 мм) добавлен
- [x] Классы цепей в `.kicad_pro`: **POWER 0.8 мм** (GND/RAIL/LOAD/VBAT/V12/BOOST2_OUT/TP_OUT/TP_B+/ADAPTER_5V), Default 0.4 мм
- [x] Экспорт PDF схемы (`WindStation_schematic.pdf`)
- [x] **Трассировка дорожек** ✅ — Freerouting (родной DSN/SES-круг): 56×0.8мм (POWER) + 25×0.4мм (signal), 0 incomplete
- [x] **DRC**: unconnected 61→**0**, footprint errors 0. Поправлен edge-clearance (контур правый край x170→x178, плата 100×102мм). **silk_overlap 34→0** (2026-07-01): reference-тексты сдвинуты с падов в свободные зоны + уменьшены до 0.8мм; 8 обозначений в тесных кластерах (диоды D1/D2 под холдером BT2; ряд хедеров J2/U2/U3/SW1/J1 4.6мм друг от друга, зажат U1+конденсаторами сверху и медью снизу) перенесены на слой **F.Fab** (designator в дизайне остаётся, на физической шелкографии нет — для перфоплаты неважно). Бэкап: `WindStation.kicad_pcb.bak-silk`.
- ⚠️ kicad-mcp `import_ses` пишет net именами вместо кодов → 61 unconnected; `export_dsn` теряет классы (ширины). Делать Specctra-круг РОДНЫМИ меню KiCad (см. память reference-kicad-mcp-routing).

## Как удалось развести (обход headless-блокеров)
- Поставил **локальную Windows-Java 21** (Temurin, portable, без админа) → у Java на Windows есть доступ к экрану, поэтому `HeadlessException` (как в Docker) не возникает.
- Пайплайн файловым бэкендом: `export_dsn` → `java -jar freerouting.jar -de in.dsn -do out.ses` (через Bash) → `import_ses`.
- ⚠️ Грабли: `import_ses` пишет плату из **stale in-memory** и затирает правки файла. Лечится `open_project` ПОСЛЕ правки файла и ДО `import_ses`.
- Контур сначала был обрезан (старый outline y88 отсекал батареи) → батареи не разводились; исправил контур на (78,48)→(172,150), пере-развёл — батареи подключились.

## Артефакты
- `kicad/WindStation.kicad_pcb` — разведённая плата (198 дорожек)
- `kicad/WindStation_2d_view.png` — рендер
- `kicad/WindStation.dsn` / `.ses` — обмен с Freerouting
