temafey/ArduinoWindStation/FIRMWARE.md

# Wind Station — как устроена прошивка

Разбор `esp32_wind_station.ino` по состоянию на 2026-08-04; раздел 5 и всё, что касается WiFi, переписано 2026-08-07 под режим «только точка доступа» и дополнено 2026-08-15, когда к точке добавился необязательный аплинк в домашнюю сеть (AP+STA). **Раздел 7 добавлен 2026-09-12** — 4G-аплинк по PPP и облачный канал MQTT; прежние разделы 7–9 сдвинулись на 8–10.

Метеостанция на ESP32: меряет скорость ветра аналоговым датчиком, следит за питанием и зарядом батареи, показывает состояние пятью светодиодами и раздаёт всё это по WiFi — веб-дашборд плюс JSON API. Обновляется по воздуху.

Станция **сама раздаёт закрытую паролем сеть, и эта точка безусловна** — её не гасит ни одна строка кода. Всё остальное добавляется к ней, а не заменяет: домашняя сеть (AP+STA, с 2026-08-15), 4G-аплинк по PPP через модем A7670E (с 2026-09-11) и постоянный канал к MQTT-брокеру (с 2026-09-12). Дашборд живёт на 192.168.4.1 при любом раскладе, и станция остаётся полностью работоспособной, когда наружу не ведёт ничего.

---

## 1. Общая картина

Одна задача Arduino, никакой RTOS и никаких потоков. Всё крутится в `loop()` как кооперативная многозадачность на `millis()`: каждая подсистема имеет свой интервал и свою переменную «когда последний раз». Надолго блокирует ровно одна вещь — приём OTA.

```
setup()                          loop()  ── каждые ~единицы мс ──┐
  пины, ADC, LED                   ArduinoOTA.handle()           │
  стереть STA-креды                server.handleClient()         │
  softAP(SSID, пароль) ───┐         20 мс  readSensors()         │
                          │        100 мс  readChargeStatus()    │
   ok ──► mDNS + OTA      │         50 мс  push SSE-кадра        │
   fail ──► LED ошибки    │        500 мс  updateLEDs()          │
                          │        2 с     строка в Serial       │
  регистрация маршрутов   │        5 с     RSSI клиента          │
  server.begin()          │        30 с    readBattery()         │
                          │        10 мин  сброс порыва          │
                          └────────────────────────────────────◄─┘
```

Состояние живёт в глобальных переменных (`windSpeed`, `batteryPercent`, `chargeState`, …). `buildDataJson()` сериализует их в один и тот же JSON и для `/api/data`, и для SSE-потока — единственный источник правды для дашборда.

---

## 2. Железо, на которое опирается код

### Питание — diode-OR с двумя бустами

```
Адаптер 5V ──► Шоттки A ──┐
                          ├──► шина ~4.7V ──► ESP32 VIN + Boost #1 → 12V на датчик
Батарея ─► PTC ─► TP4056 ─► Boost #2 (5V) ─► Шоттки B ──┘
```

Boost #2 существует не для повышения как такового, а чтобы держать шину на 4.7 В при работе от батареи: без него падение на AMS1117 (0.8–1.25 В) роняет ESP32 в brownout на пиках передачи WiFi.

### Датчик ветра

Аналоговый 0–5 В (клон DFRobot SEN0170), диапазон **0–30 м/с**, только скорость. Сигнал делится 15k/10k → максимум 2.0 В на АЦП.

Почему 2.0 В, а не 3.0 В: линейная зона ESP32 ADC на 11 dB — примерно 150 мВ … 2.45 В. Прежний делитель 10k/15k давал 3.0 В и заезжал в нелинейщину, из-за чего скорости выше 49 м/с занижались.

Канала направления у нового датчика нет — `HAS_DIRECTION 0`, GPIO35 висит неподключённым, API отдаёт `direction: null`. Код кругового усреднения через sin/cos (буфер на 5 отсчётов, корректная обработка перехода 0°↔360°) в файле сохранён и оживает установкой флага в 1, если вернут старый датчик 0–60 м/с с направлением.

### Распиновка

| GPIO | Назначение | Примечание |
|---|---|---|
| 34 | скорость ветра (ADC1) | input-only, делитель 15k/10k |
| 35 | направление (ADC1) | не подключён при `HAS_DIRECTION 0` |
| 32 | батарея (ADC1) | делитель 100k/100k |
| 4 | красный LED | ветер >15 м/с или батарея 10–30% |
| 16 | жёлтый LED | ветер >5 м/с или батарея 30–60% |
| 17 | зелёный LED | батарея >60% |
| 5 | LED WiFi | **strapping-пин**, кратко моргает при старте |
| 18 | LED ошибки | ошибка ADC или нет WiFi |
| 13 | TP4056 CHRG | открытый сток, LOW = идёт заряд |
| 19 | TP4056 STDBY | открытый сток, LOW = заряд окончен |
| 26 | UART2 TX → RXD модема | кол. 37 макетки, буква `R`; только при `HAS_MODEM 1` |
| 25 | UART2 RX ← TXD модема | кол. 38 макетки, буква `T`; только при `HAS_MODEM 1` |

Два выбора пинов здесь неслучайны и держат всю схему:

- **GPIO5 под WiFi-LED.** Это strapping-пин, при старте обязан быть HIGH. Светодиод через 220 Ω на землю не в силах удержать его в нуле, поэтому он лишь мигает на долю секунды при подаче питания. Ущерба нет ровно потому, что этот LED и так должен гореть только после подъёма WiFi.

  Что он значит: **ровный свет — станция кому-то доступна**, то есть либо к точке подключён клиент, либо жив аплинк. Мигание — ни того ни другого. До 2026-08-15 он смотрел только на клиентов точки, поэтому плата, спокойно сидящая в домашней сети, мигала бесконечно — и глаз привыкал не смотреть на единственную лампу, которая должна значить «подойди сюда». Зелёных ламп на плате две (вторая — GPIO17, заряд >60%), и путают их постоянно.
- **GPIO13/19 под статус зарядника.** Линии с открытым стоком, притянутые к земле в момент старта. Окажись они на GPIO0/2/12/15 — сменили бы режим загрузки или напряжение флеша и сломали бы запуск.
- **GPIO25/26 под UART модема.** Схема v6 рисовалась под 27/26, но косичка встала на один пин мимо, а переставить её нельзя, не разбирая узел — поэтому прошивка пошла за медью. GPIO27 освободился, затвор P-FET перепланирован на GPIO33. Оба пина формально относятся к ADC2, и это допустимо: запрет ADC2 при работающем радио касается только аналогового чтения, а здесь это UART — тот же случай, что GPIO4 (светодиод) и GPIO13 (вход). Важнее другое: **`Serial2` по умолчанию сидит на GPIO16/17, а это жёлтый и зелёный светодиоды.** Пины передаются в `Serial2.begin()` явно, и это не вопрос стиля — с умолчаниями прошивка начала бы гнать AT-команды в светодиодную панель.

---

## 3. Измерения

### Скорость ветра — каждые 20 мс

32 отсчёта `analogReadMilliVolts()`, **межквартильное среднее** (сортировка, отбрасываются 8 младших и 8 старших, усредняются оставшиеся 16), затем **порог 150 мВ как гейт**: на пороге и ниже — штиль и ноль, выше — милливольты идут в пересчёт как есть.

**Почему не простое среднее.** Пачка из 32 преобразований занимает ~2.6 мс, а передача WiFi — это ~1 мс, в течение которых через те же шины идут сотни миллиампер, а над платой стоит сильное ближнее поле. Пачка достаточно коротка, чтобы целиком попасть внутрь такой передачи, поэтому помеха приходит не белым шумом по всей выборке, а связным куском отсчётов, сдвинутых в одну сторону. Среднее тащит этот сдвиг прямо в показание; отбрасывание восьми крайних с каждой стороны переживает порчу до четверти выборки с каждого края. Плата за это — шум: усреднение по 16 вместо 32 отсчётов, то есть примерно в 1.4 раза больше дрожания на спокойной плате. Из двух ошибок эта дешевле.

Порог — это уровень, ниже которого АЦП ESP32 на 11 dB физически ничего не читает: при нуле на входе он упирается в 143–145 мВ. Измерено на этой плате, причём одинаково на GPIO34 и GPIO35 — совпадение на обоих каналах и доказывает, что дело в АЦП, а не в сигнале.

```
V_датчика = мВ_средн / 1000 × 2.5           (при мВ_средн > 150, иначе 0)
скорость  = V_датчика / 5.0 × 30.0          →  ограничение 0…30 м/с
```

**Почему гейт, а не вычитание.** До 2026-08-08 порог вычитался из каждого измерения — и это был баг, а не калибровка. Насыщение АЦП снизу не является аддитивным смещением сигнала: выше ~150 мВ калиброванное чтение уже верно, ниже — любой вход схлопывается в те же 145 мВ. Вычитание сдвигало вниз всю шкалу: цена деления 66.7 мВ на 1 м/с (5 В / 30 м/с × 0.4 делителя), значит каждое показание занижалось на 2.2 м/с. Реальные 3 м/с показывались как 0.8, реальные 10 — как 7.8, а всё до 2.2 м/с — как ноль. Снаружи это выглядело как «станция молчит, пока не раскрутишь вертушку сильно».

**Что не изменилось:** скорости ниже ~2.3 м/с по-прежнему показываются как 0, и при переходе через гейт число прыгает с нуля сразу на ~2.3. В км/ч это ровно та самая «станция оживает только на 8–12 км/ч»: 150 мВ гейта делить на 66.7 мВ на м/с — это 2.25 м/с, то есть 8.1 км/ч, а дашборд округляет км/ч до целых. Там просто нет измерения, которое можно интерпретировать. Это предел связки «делитель + АЦП»; сдвинуть границу можно только железом — см. следующий раздел.

**Проверка порога на месте:** поле `speedMv` в `/api/data` (и `(N mV)` в строке Serial) отдаёт то самое усреднённое сырое значение до гейта. При неподвижном датчике там должно быть 143–145; если плата изменилась — правится `SPEED_ZERO_MV` на пару милливольт выше измеренного. Подбирать значение можно без перепрошивки через `/api/zero` (см. раздел 6).

Рядом печатается **разброс пачки** — `±N` в Serial, `speedSpreadMv` в `/api/data`: это `max − min` по 32 сырым отсчётам. Два числа вместе отвечают на вопрос, чем вызвано неверное показание: сбитым нулём (мВ уехали, разброс маленький) или помехой (мВ скачут, разброс большой). На спокойной плате при неподвижном датчике разброс — единицы милливольт, и он не должен меняться от того, льётся ли поток на дашборд.

### Сдвиг уровня — как открыть низ шкалы

Ноль датчика лежит на 0 мВ, то есть внутри мёртвой зоны АЦП. Лечится третьим резистором **R3 = 47 кОм с 3V3 на узел делителя** (тот самый, что идёт на GPIO34), поверх существующих 15k/10k:

```
датчик ──[15k]──┬── GPIO34 ──[47k]── 3V3
              [10k]
               GND
```

Номинальная арифметика для 3.30 В на шине:

| | было | стало |
|---|---|---|
| напряжение при 0 м/с | 0 мВ (в мёртвой зоне) | 374 мВ |
| коэффициент делителя | 0.4 (обратный 2.5) | 0.3548 (обратный 2.819) |
| цена деления | 66.7 мВ на м/с | 59.1 мВ на м/с |
| полная шкала (30 м/с) | 2.00 В | 2.15 В — всё ещё в линейной зоне |
| нижняя граница | ~2.3 м/с | ~0.1 м/с (дальше упирается в сам датчик) |

Включается флагом `HAS_LEVEL_SHIFT 1`. **Только после того, как резистор реально впаян:** без него код вычитает смещение, которого нет, и всё показание уезжает вниз примерно на 6 м/с.

Обе константы — `SPEED_BIAS_MV_DEFAULT` (374.0) и `SIGNAL_DIVIDER_SHIFTED` (2.819) — номинальные и обязаны быть заменены измеренными. Шина не ровно 3.30 В, а пятипроцентные резисторы двигают смещение на десятки милливольт, что внизу шкалы — целые десятые доли м/с. Порядок калибровки:

1. Держа вертушку неподвижно, открыть `/api/zero?set=` — плата примет текущее чтение за ноль и вернёт готовую строку с константой. **Знак равенства обязателен**: аргумент без него WebServer выбрасывает, и запрос отработает как обычное чтение.
2. Раскрутить датчик до известной скорости (или сравнить с другим прибором) и подправить `SIGNAL_DIVIDER_SHIFTED` по отношению показанной скорости к настоящей.
3. Вписать оба числа в `.ino` и перезалить — `/api/zero` живёт только в RAM (см. раздел 6).

Альтернатива без пайки в делитель — **внешний АЦП ADS1115** по I²C: 16 бит, честный ноль, собственная опора, и заодно уводит измерение из шумного окружения ESP32. Делитель при этом остаётся 15k/10k, а `HAS_LEVEL_SHIFT` не нужен. Это правильное решение; резистор — то, которое делается сегодня вечером.

Порыв (`windGust`) — просто максимум с момента последнего сброса. Сбрасывается сам раз в 10 минут или вручную через `/api/gust`.

### Детектор потери сигнала

Если среднее держится ниже 10 мВ пятнадцать проходов подряд (~1.5 с) — поднимается `adcError` и зажигается LED ошибки. Ловит только жёсткое замыкание на землю: **оборванный провод поймать нельзя** — открытый вход даёт те же ~145 мВ, что и датчик в покое.

Побочный эффект сдвига уровня, который стоит знать: с впаянным R3 оборванный сигнальный провод перестаёт быть неотличимым от штиля. Верхний конец 15k повисает, и узел делят только R3 и R2 — 3.3 × 10/(47+10) = 579 мВ, то есть постоянные ~3.5 м/с ровно, без дрожания. Автоматически это по-прежнему не ловится, но в `speedMv` такой обрыв виден сразу.

### Батарея — каждые 30 секунд

10 отсчётов, делитель ×2.0, линейный процент между 3.5 В (0%) и 4.2 В (100%).

Нижняя граница 3.5 В взята не от разряда ячейки, а от схемы: ниже неё Boost #2 теряет запас регулирования и шина 4.7 В начинает проседать.

Отдельно решается «а есть ли вообще батарея»: если на пине меньше 500 мВ (то есть пакет ниже 1.0 В) — считается, что пакета нет, и API отдаёт `battery: null` вместо выдуманного напряжения. Делитель для этого специально подключён к проводу самого держателя, а не к TP_B+ — TP4056 подпитывает TP_B+ от USB и убедительно изображает несуществующую батарею.

### Состояние зарядки — каждые 100 мс

`CHRG` и `STDBY` — открытый сток, поэтому `INPUT_PULLUP` и активный уровень LOW.

Внешнее питание нигде не измеряется: TP4056 способен тянуть эти линии вниз только когда запитан сам, значит **любая активная линия равна «кабель воткнут»**. Экономит делитель и ножку АЦП.

Голого чтения тут мало. Без батареи микросхема скачет между «заряд» и «ожидание» примерно раз в секунду, и в промежутке обе линии выглядят неактивными. Поэтому состояние взводится по первому же активному отсчёту, а снимается только после 3 секунд тишины (`STATUS_HOLD_MS`). Дашборд не мигает, а выдернутый кабель всё равно замечается за пару секунд.

Флаги `chrgSeen`/`stdbySeen` закрывают окно загрузки: `millis()` стартует с нуля, и без них первые 3 секунды после сброса выглядели бы как «кабель только что был».

Итог сводится в два поля: `powerSource` (`external` / `battery`) и `chargeState` (`absent` / `charging` / `full` / `discharging`).

> Полезно знать при отладке на столе: питание через USB-разъём ESP32 **не** доходит до TP4056. Его вход — отдельный разъём зарядки. Поэтому плата, запитанная от компьютера, честно рапортует `battery/absent` — это не ошибка.

Константа `HAS_STDBY` стоит в 1. Пока STDBY не подключён, «заряжено» неотличимо от «работаю от батареи»: CHRG уходит в высокий импеданс и когда заряд закончен, и когда USB выдернули.

---

## 4. Светодиоды

Обновляются каждые 500 мс. У каждого три режима — `off` / `on` / `blink`; фаза мигания общая и переворачивается на каждом вызове, поэтому все мигающие LED идут синхронно с частотой 1 Гц.

Автоматическая логика (`ledAutoMode`, включена по умолчанию):

| LED | Условие |
|---|---|
| зелёный | батарея есть и >60% |
| жёлтый | ветер >5 м/с **или** батарея 30–60% |
| красный | ветер >15 м/с **или** батарея 10–30% |
| красный, мигает | батарея <10% — перебивает ветровую индикацию |
| WiFi | мигает, пока к точке никто не подключён; горит ровно, когда есть клиент |
| ошибка | ошибка ADC или точка доступа не поднялась |

Ветер и батарея объединены через ИЛИ. На практике конфликтуют редко: батарея разряжается только когда сети нет.

Через `/api/led?auto=false` автоматика отключается и цветами можно управлять вручную. LED ошибки — исключение: он всегда автоматический и в API не выведен.

Смысл WiFi-LED сменился вместе с режимом. Раньше «мигает» означало «идёт подключение», и на время блокирующей попытки мигание вешалось на аппаратный таймер `Ticker`, потому что `updateLEDs()` в эти 12 секунд не вызывался. Теперь подключаться не к чему, точка поднимается за доли секунды, и вечно горящий индикатор не нёс бы информации — поэтому «мигает» читается как «точка есть, клиентов нет», а «горит ровно» — «кто-то подключён». `Ticker` из проекта убран за ненадобностью.

---

## 5. WiFi — точка доступа плюс необязательный аплинк

### Своя сеть, безусловная

| | |
|---|---|
| SSID | `WindStation` |
| пароль | из `secrets.h` (WPA2-PSK) |
| адрес | `http://MyWindProbeBETA.org` |
| он же | 192.168.4.1 и `mywindprobebeta.local` |
| клиентов | до 4 |
| канал | 1, SSID не скрыт |

Всё это — константы `apSsid` / `apPassword` / `apMaxClients` в начале скетча, но **сам пароль лежит не там**: с 2026-08-16 он приходит из `esp32_wind_station/secrets.h` (`SECRET_AP_PASSWORD`), а этот файл вне git. Пароль обязан быть длиной 8–63 символа: короче — и `softAP()` молча поднимет **открытую** сеть вместо защищённой, без единого сообщения об ошибке.

Без `secrets.h` скетч не соберётся вовсе — `#error` под `__has_include` в начале файла. Это дешевле, чем фолбэк на константу: молчаливый фолбэк как раз и даёт открытую сеть, о которой узнаёшь последним.

SSID не прячется намеренно. Скрытие не мешает никому, у кого есть сканер эфира, зато заметно портит жизнь телефонам; от посторонних защищает пароль.

### Почему старого станционного режима больше нет

До 2026-08-07 плата держала в NVS пул до шести сетей, при старте 12 секунд искала самую сильную из них и подключалась. Точка доступа при этом была лишь запасным вариантом — и в момент успешного подключения `softAPdisconnect()` её гасил. Со стороны это выглядело так: плата раздаёт сеть, секунд через пятнадцать сеть пропадает. Никто к ней не подключался и она ни к кому не «уходила» — просто по замыслу переставала быть точкой доступа, как только находила знакомый роутер.

Вместе со станционным режимом ушли: список сетей в NVS (`wifinets`, функции `loadStoredNetworks` / `storeNetwork` / `removeNetwork`), `WiFiMulti`, `Preferences`, ручное переключение `/api/wifi?connect=`, пересканирование раз в 30 секунд и аварийная точка через 3 минуты офлайна. Флеша это освободило примерно 100 КБ: прошивка занимала ~92% `app0`, стала 84%.

Ничего из перечисленного не вернулось и в версии с аплинком: настраивать сеть через HTTP по-прежнему нельзя, пула нет, сканирования по расписанию нет. Вернулась ровно одна возможность — быть в домашней сети, — и на других условиях.

### Аплинк: AP+STA, а не «или-или»

С 2026-08-15 прошивка работает в `WIFI_AP_STA`: раздаёт свою сеть и одновременно входит в домашнюю. Ключевое отличие от того, что было до 08-07, — **ни одна строка не трогает точку доступа**. Аплинк добавляется к ней, а не заменяет её, и его провал не стоит ничего, кроме самого аплинка.

Зачем: дашборд открывается из дома, не выгоняя ноутбук из сети с интернетом, и OTA идёт по домашней сети, а не через точку без выхода наружу.

| | |
|---|---|
| флаг | `SECRET_HAS_HOME_NETWORK` в `secrets.h` (`0` — чистая точка, кода ретраев не существует) |
| сети | `SECRET_HOME_NETWORKS` в `secrets.h` — пары `{ssid, password}`, не форма на странице |
| попытка | `STA_ASSOC_MS` 12 с на кандидата, по одному за раз, без сканирования |
| ретрай | `STA_RETRY_MIN_MS` 30 с → `STA_RETRY_MAX_MS` 10 мин, удвоением, **между полными проходами** |
| обслуживание | `serviceUplink()` из `loop()`, каждый проход, без блокировок |

**Сетей может быть несколько.** `homeNetworks[]` — список пар «имя, пароль», порядок задаёт приоритет. Добавить сеть = дописать строку в скетч и перезалить: ни формы, ни NVS для этого нет, и это осознанно (см. ниже про пароли и про то, что прошивка не пишет NVS вовсе). Имена всех известных сетей отдаёт `/api/wifi` в поле `uplinkKnown`; пароли не отдаются нигде.

**Список обходится вслепую, без скана.** Один кандидат за попытку, каждому 12 секунд на ответ, дальше следующий. Сканировать эфир, чтобы выбрать сильнейшего, было бы «правильнее» — и стоило бы точке доступа отдельного замирания ещё до первой ассоциации, каждый раз. Список короткий, дешевле перебрать. Именно поэтому здесь нет `WiFiMulti`: он сканирует и блокирует.

**Только 2.4 ГГц.** У ESP32 нет радио на 5 ГГц. Половина `-5G` двухдиапазонного роутера для него не существует — сколько ни вписывай её в `homeNetworks[]`, попытка просто съест свои 12 секунд впустую.

**Радио одно, канал общий.** Точка стартует на канале 1. Когда аплинк ассоциируется с роутером на другом канале, точка **уезжает следом**, и подключённые к ней клиенты один раз отваливаются и переподключаются. На однорадийном чипе этого не обойти. Поэтому поиск аплинка запускается последним делом в `setup()`: к моменту переезда всё остальное уже поднято.

**Почему пауза с удвоением, а не раз в 30 секунд.** Ассоциация не бесплатна: драйвер уходит с канала точки, и на это время каждый клиент AP замирает. Изредка — терпимо. Каждые 30 секунд вечно — нет, а именно это и происходило бы на мачте или на даче, где ни одной из этих сетей рядом нет. Пауза удваивается до десяти минут и сбрасывается в 30 секунд, как только связь появилась. Считается она **по полному проходу списка**, а не по каждому кандидату: иначе пять сетей растянули бы первый же цикл на восемь минут ожидания вместо одной минуты перебора. По той же причине `WiFi.setAutoReconnect(false)`: иначе ретраями рулили бы два места сразу — драйвер и наш таймер, — и эфир занимался бы вдвое чаще.

**Почему не блокирует.** `WiFi.begin()` только запускает ассоциацию; результат читается на следующих проходах `loop()`. Блокирующий `wifiMulti.run()` на 30 секунд из старого режима — ровно то, чего здесь нет: он замораживал дашборд и морил голодом `readSensors()` (см. раздел 6 про то, почему пауза в `loop()` теряет данные, а не задерживает их).

**mDNS перезапускается при подключении.** Он стартует, когда единственным интерфейсом была точка, и на домашней сети имя иначе не отзывается. В момент появления аплинка `serviceUplink()` делает `MDNS.end()` и поднимает заново — теперь на обоих интерфейсах.

**Как узнать адрес платы дома.** Три способа, все без роутера: строка в Serial при подключении, поле `staIp` в `/api/data`, поле `uplinkIp` в `/api/wifi`. Какая именно сеть из списка отозвалась — `staSsid` / `uplinkSsid`; они читаются у драйвера (`WiFi.SSID()`), а не из констант, иначе при нескольких кандидатах поле говорило бы лишь о том, кого пробовали последним.

Пароли лежат в исходнике открытым текстом и попадают в историю git. Репозиторий локальный и без удалённого — но это стоит помнить, если он когда-нибудь куда-нибудь уедет. Спрятать их некуда: прошивка принципиально не пишет NVS, так что пароль, введённый в форму, не пережил бы и перезагрузки.

Цена: **+3.1 КБ флеша** (в тот момент 85% `app0`; на 2026-09-07 сборка занимает 96%).

### Стирание сохранённых кредов при старте

Драйвер WiFi хранит **свою собственную** копию последних SSID и пароля в разделе `nvs` и подключается по ней сам, как только включается станционный режим — в том числе по кредам, оставшимся от какой-нибудь прошлой сборки. Раздел `nvs` при OTA не переписывается, так что такая запись переживает любое обновление. Аплинком должно быть то, что написано в исходнике, и ничто другое, поэтому `setup()` один раз поднимает STA, стирает конфигурацию и только затем ставит рабочий режим:

```cpp
WiFi.mode(WIFI_STA);
WiFi.disconnect(true, true);   // второй аргумент — eraseap
WiFi.persistent(false);
WiFi.mode(WIFI_AP_STA);        // или WIFI_AP при HAS_HOME_NETWORK 0
```

Порядок здесь не косметический: `persistent(false)` переключает хранилище драйвера на RAM, и если поставить его первым, стирание не дойдёт до флеша, а креды останутся лежать на месте.

### Имя вместо адреса — свой DNS-сервер

Дашборд открывается по `http://MyWindProbeBETA.org`. Работает это так: DHCP точки доступа выдаёт клиентам её же адрес (192.168.4.1) в качестве DNS-сервера, а на плате поднят `DNSServer`, который на это одно имя отвечает A-записью с тем же адресом. Клиенту не нужна поддержка mDNS — поэтому имя одинаково работает и на Android, где `.local` капризничает.

Регистр значения не имеет: DNS регистронезависим, а библиотека приводит к нижнему регистру обе стороны сравнения. `MyWindProbeBETA` в коде и в документации — только ради того, как имя выглядит в адресной строке.

**Про `.org`.** Это настоящий TLD, и домен за нами не зарегистрирован — выбран сознательно, ради того как читается адрес. Два следствия, ни одно из которых здесь ничего не ломает:

- Пока устройство подключено к станции, оно спрашивает DNS у платы, поэтому настоящий сайт по этому имени с него не откроется. У точки всё равно нет выхода в интернет, так что не откроется и всё остальное.
- Для настоящего TLD браузер сначала пробует HTTPS и откатывается на HTTP, когда рукопожатие не удалось. На первом заходе это стоит секунды ожидания. Чинить на плате нечего: 443 она не слушает.

Изначально здесь стоял `.internal` — TLD, зарезервированный ICANN в 2024 году под частные сети и потому гарантированно ни с чем не конфликтующий. Заменён по прямому решению владельца станции на более представительный адрес.

### Дашборд открывается сам — captive-портал

С 2026-08-07 станция ведёт себя как страница входа в общественном WiFi: подключился к
сети — телефон сам предложил открыть дашборд, адрес набирать не нужно.

Сделано это тремя вещами:

1. **DNS отвечает на любое имя** (`dnsServer.start(53, "*", ...)`), в том числе на проверки
   связности — `connectivitycheck.gstatic.com`, `captive.apple.com`, `msftconnecttest.com`.
2. **`server.onNotFound()` отдаёт 302** на `http://MyWindProbeBETA.org/`. Каждая система ждёт
   от своей пробы строго определённый ответ (Android — код 204, Apple — страницу со словом
   Success, Windows — свой `connecttest.txt`), и редирект не удовлетворяет ни одну из них
   намеренно: именно так система понимает, что сеть за порталом, и предлагает его открыть.
3. **DHCP-опция 114** (`WiFi.AP.enableDhcpCaptivePortal()`) отдаёт адрес портала напрямую —
   современные клиенты берут его оттуда и не пробуют угадывать. Метод есть только при
   IDF ≥ 5.4.2, поэтому вызов закрыт условной компиляцией.

Редирект ведёт на имя, а не на 192.168.4.1, и это безопасно: чтобы вообще попасть в этот
обработчик, клиент уже должен был что-то разрешить через наш DNS — значит, имя у него
разрешится тоже.

**Почему пришлось.** Изначально DNS отвечал только на своё имя, как раз чтобы не ловить
проверки связности и не раздражать телефон предложением «войти в сеть». На практике
оказалось, что набранный адрес у людей не открывается, и причина не в плате: браузеры
всё чаще резолвят имена через собственный DNS-over-HTTPS (в Chrome и Edge это «Безопасный
DNS», в Android — «Частный DNS»), минуя тот сервер, который выдала точка доступа. Проверки
из PowerShell этого не показывали, потому что он спрашивает системный резолвер. Портал
проблему обходит целиком: адрес набирать не нужно.

**Что за это платим.** Сеть читается системой как «требующая входа», и любой другой сайт,
открытый на подключённом устройстве, приводит на дашборд. Выхода в интернет через эту
точку всё равно нет, так что терять было нечего.

Проверено 2026-08-07 на живой плате: все три пробы отдают `302` с `Location:
http://MyWindProbeBETA.org/`, при этом `/`, `/api/data` и запрос по имени остаются `200`.

Сервер асинхронный, на `AsyncUDP`, и обслуживает запросы из собственной задачи. `processNextRequest()` в этом ядре — пустая заглушка, дёргать его в `loop()` не нужно и бесполезно.

Стоимость: **+7.7 КБ флеша** (84% как было, свободно ~200 КБ) и ~112 байт статической RAM.

### RSSI: с какой стороны меряем

Поле в дашборде одно, а связей теперь может быть две, поэтому `readClientRssi()` отдаёт ту, через которую скорее всего и смотрят на страницу.

Приоритет у клиента точки доступа: список подключённых берётся у драйвера (`esp_wifi_ap_get_sta_list`), возвращается самый сильный. Это прямая связь с тем, кто читает дашборд. И только когда точка пуста, в ход идёт `WiFi.RSSI()` — то есть аплинк, потому что в этом случае страницу отдают по домашней сети и значима именно она. Ноль означает «нет ни того, ни другого».

Единицы и смысл одинаковы в обоих случаях — вопрос «нормальная ли связь», — меняется только то, с какой стороны он задан.

---

## 6. HTTP: API, поток и дашборд

### Почему SSE, а не опрос

`WebServer` обслуживает одного клиента за раз и всегда отвечает `Connection: close`. У lwIP всего 16 TCP-блоков, и каждый закрытый висит в TIME_WAIT по 60 секунд. Опрос чаще раза в секунду просто вычерпывал пул досуха.

Решение — один долгоживущий поток Server-Sent Events. Дашборд подписывается на `/api/stream` единожды, дальше прошивка сама шлёт кадр каждые 50 мс (20 Гц) в то же соединение. TCP-churn нулевой.

Держится это на том, что сокет `NetworkClient` внутри — `shared_ptr`: копия, сохранённая в `sseClient`, не даёт соединению закрыться после того, как `WebServer` отпустит свою ссылку. `server.send()` для этого маршрута намеренно не вызывается — ответ уже написан руками.

### Почему кадр отправляется через `lwip_send`, а не `print()`

Это не микрооптимизация, а обход блокировки, которая роняла всю станцию до неузнаваемости. `NetworkClient::write()` при переполненном окне получателя крутит `select()` с таймаутом 1 секунда и повторяет до 10 раз (`WIFI_CLIENT_SELECT_TIMEOUT_US` и `WIFI_CLIENT_MAX_WRITE_RETRY` в `NetworkClient.cpp` ядра). Значит один вызов `sseClient.print()` мог остановить `loop()` **до десяти секунд**.

А `loop()` здесь — кооперативная многозадачность: встал он — встало всё. В первую очередь `readSensors()`. Датчик в это время просто не опрашивается, и короткий эпизод медленного вращения целиком проваливается в слепое окно — на дашборде он не появляется никогда, а не «с опозданием». Те кадры, что доходили, отставали ровно на длительность затыка. Симптом со стороны: по Serial (без подключённого клиента, то есть без SSE) всё чётко и мгновенно, а в браузере — большая задержка и пропуск всего, кроме сильного ветра.

Стоявший здесь `c.setTimeout(500)` с комментарием «500 ms write timeout» не делал ничего. `NetworkClient` объявляет собственное поле `int _timeout`, перекрывающее одноимённое поле `Stream`, и не переопределяет `setTimeout()` — значение уходило в то поле `Stream`, которое `write()` не читает. А `send()` внутри `write()` вызывается с `MSG_DONTWAIT`, поэтому и `SO_SNDTIMEO` там ни при чём. Единственной реальной границей всегда был цикл повторов.

Теперь кадр уходит через `lwip_send(..., MSG_DONTWAIT)` из `sseFlush()`, которая вызывается каждый проход `loop()` и отдаёт ровно столько байт, сколько сокет готов принять сию секунду:

- в полёте одновременно **не больше одного кадра**; если предыдущий не дописан, очередной тик не ставит новый в очередь, а пропускает его и увеличивает `sseDropped`;
- недописанный кадр дописывается на следующих проходах, как только окно откроется;
- ошибка сокета (не `EAGAIN`) закрывает подписку.

Пропущенный кадр — правильный размен: через 50 мс будет более свежий отсчёт, а очередь из старых дашборду не нужна вовсе. Побочный эффект приятный: поток сам подстраивается под скорость клиента.

### Мощность передатчика

`WiFi.setTxPower()` просит **верх enum'а** — `WIFI_POWER_21dBm` (84 в четвертях дБм), а не значение, про которое заранее известно, что чип его выдаст. Драйвер сам обрежет до того, что позволяют PHY и калибровочные данные, так что запрос потолка даёт реальный потолок этой конкретной платы вместо догадки о нём. Раньше здесь стояло 19.5 дБм — на 1.5 дБ ниже, чем можно просить.

Поэтому же результат **читается обратно** и печатается в Serial. На этой плате (ESP32-D0WD-V3 rev 3.1), замер 2026-08-15:

```
TX power: 18.0 dBm (asked for the maximum the radio allows)
```

**18, а не 21.** Драйвер обрезал запрос по калибровочным данным из eFuse, и потолок этого чипа — 18 дБм. Значит и прежние `WIFI_POWER_19_5dBm` давали ровно те же 18: запрос был выше потолка и раньше, просто об этом никто не знал. **Реальный выигрыш от смены константы — ноль децибел.**

Смысл правки поэтому не в мощности, а в строке лога: до неё цифра в исходнике не имела отношения к тому, что излучает плата, и любые рассуждения про «19.5 дБм» были рассуждениями ни о чём. Теперь в логе стоит измеренное значение. Оставлять запрос на потолке enum'а по-прежнему правильно — он не может дать меньше, чем даст чип, и на плате с другой калибровкой возьмёт больше.

Ток при этом не вырос: 18 дБм были и до правки. Если бы вырос — на этой станции питание уже однажды было узким местом (см. историю с PPTC и brownout), и параметр стал бы первым кандидатом на откат.

Практический вывод: **дальность точки доступа настройками уже не улучшить**, остаётся только антенна — вынести дорожку девкита за край макетки, поставить плату вертикально, увести от бустов MT3608 или перейти на модуль с разъёмом u.FL и внешним штырём.

Настройки применяются **дважды**: в `setup()` после `softAP()` и ещё раз в `serviceUplink()` в момент подключения аплинка. Вход в домашнюю сеть поднимает станционный интерфейс и переводит точку на канал роутера — оба события пере-инициализируют драйвер, а тихо потерянная половина мощности выглядела бы как «точка со временем ослабла» и не отслеживалась бы никак.

### Задержка на радио: DTIM

Клиент в power save слушает эфир только на DTIM-beacon, до этого точка держит его кадры у себя. Arduino в `APClass::create()` обнуляет `wifi_config_t` и `dtim_period` больше не трогает — в драйвер уходит 0, вне документированного диапазона 1…10. Поэтому после `softAP()` конфигурация перечитывается и `dtim_period` явно ставится в 1 (каждый beacon, ~102 мс), `beacon_interval` — 100. Платит за это батарея клиента, а не станции.

Подписчик поддерживается **один** (дашборд и есть один). Новая подписка вытесняет предыдущую. На запись стоит таймаут 500 мс, чтобы полумёртвый клиент не подвесил `loop()` на секунды.

Датчик при этом опрашивается вдвое чаще отправки — каждые 20 мс. Так каждый кадр свежий, и короткие порывы, которые более медленный цикл проглатывал, попадают в максимум.

### Маршруты

| Маршрут | Что делает |
|---|---|
| `GET /api/data` | весь снимок состояния одним JSON |
| `GET /api/stream` | SSE-поток, кадр раз в 50 мс |
| `GET /api/led` | `auto=true\|false`, `green/yellow/red/wifi = off\|on\|blink` |
| `GET /api/gust` | сбросить накопленный порыв |
| `GET /api/zero` | нулевая точка скорости: без аргументов — что действует сейчас, **`?set=`** — принять текущее чтение, `?set=374.0` — задать явно, **`?reset=1`** — вернуть константу из прошивки |
| `GET /api/wifi` | только чтение: режим, SSID точки, её IP, имя `host`, число клиентов; `nets` пуст, `max` равен 0 |
| `GET /api/site` | где стоит станция: `lat`, `lon`, `altM`, `host` из `SECRET_STATION_*` |
| `GET`/`POST` `/api/at` | AT-консоль модема 4G/GPS, только при `HAS_MODEM 1` — см. ниже |
| `GET /api/modem` | 4G-аплинк: состояние netif, `?radio=1` — RSSI и оператор, `?probe=1`/`?ntp=1`/`?dns=` — проверки **с привязанного к PPP сокета**, `?off=1`/`?on=1` |
| `GET /api/cloud` | облачный канал: состояние и счётчики, `?off=1`/`?on=1`, `?via=ppp\|auto` — пришпилить сокет MQTT к модему. Только при `SECRET_HAS_CLOUD 1`, иначе маршрута нет вовсе |
| `GET /` и статика | встроенный дашборд |
| всё остальное | `302` на `http://MyWindProbeBETA.org/` — сигнал captive-портала |

⚠️ **Аргумент без `=` WebServer выбрасывает** (`_parseArguments()`, `log_e("arg missing value")`), поэтому голый `?set`, `?probe` или `?reset` до `hasArg()` не доходит вовсе, и эндпоинт отвечает так, будто его ни о чём не спрашивали. Молча. Рабочая форма — `?set=` или `?set=374.0`, и **`?reset=1` тоже**: он читается тем же `hasArg()` и голым не срабатывает. Проверять по ответу, а не по ожиданиям — эндпоинт в обоих случаях отвечает `200` и текущим состоянием.

Четыре маршрута записи (`/api/led`, `/api/gust`, `/api/zero`, `/api/at`) плюс `/api/modem` и `/api/cloud` начинаются с `crossSiteWrite()`. Угроза не сосед по сети, а **любая страница, уже открытая в том же браузере**: API принимает обычные GET-ы, wildcard CORS прячет от чужого скрипта только ответ, а запрос всё равно доходит и срабатывает. У `/api/at`, `/api/modem` и `/api/cloud` заголовка CORS нет вовсе — через них можно отправить SMS, уронить аплинк и прочитать, куда станция отчитывается.

Поля `/api/data`: `speed`, `direction`, `dirPresent`, `gust`, `speedMv` (диагностическое — сырые усреднённые милливольты на пине скорости до гейта; дашборд его не читает), `speedZeroMv` (действующая нулевая точка), `speedSpreadMv` (`max − min` по 32 отсчётам одной пачки — индикатор помехи), `ledGreen`, `ledYellow`, `ledRed`, `ledWifi`, `ledAuto`, `battery`, `batteryPercent`, `batteryPresent`, `chargeState`, `powerSource`, `speedMax`, `wifiRssi`, `adcError`, `staSsid`, `staConnected`, `staIp`, `hostname`, `uptime`, `resetReason`, `timeValid`, `epoch`, `loopMax`, `logMs`, `sseDrop`,
`siteLat`, `siteLon`, `siteAltM`, а при поднятом модеме и включённом облаке — ещё
`pppState`, `pppIp`, `netOperator`, `netRssi`, `netMode`, `netAttached`, `cloudConnected`
и `cloudError` (шаг 26 задачи 10, 2026-09-12; +2 060 байт флеша, `loopMax` не шевельнулся).

Последние восемь — **условные в буквальном смысле: если сказать нечего, ключа в JSON
нет вовсе.** Не `0`, не `""`, не `null`. Проверено на живой плате: модем заперт в CMUX,
`pppState` равен `"failed"` — и все пять ключей, которым нужен живой линк (`pppIp` и
четыре радиополя), отсутствуют целиком.
Ноль вместо отсутствующего показания — худшее, что может сделать метеостанция, потому
что `0 дБм` это уровень сигнала, а не «модема нет»; правило то же, что у `dirPresent`
и `batteryPresent`, только выраженное отсутствием ключа, а не отдельным флагом.

⛔ **`siteLat` / `siteLon` отдаются с ТРЕМЯ знаками после запятой, и это граница
безопасности, а не формат вывода.** Ровно этот же JSON публикуется в retained-топик
`state`, который читает учётка зрителя из публичного бандла — то есть всё, что попало
в кадр, публично. Три знака это ~100 м: хватит навести карту, мало чтобы получился
адрес. Полная точность осталась в `/api/site` — там плата разговаривает со своим же
дашбордом в своей же сети. Ошибка здесь необратима в одну сторону: retained-сообщение
с пятью знаками пролежит на брокере до перезаписи, а отозвать его нечем. Практическое
следствие шире самих координат: **добавить поле в `buildDataJson()` — значит
опубликовать его в интернете**, и решать это надо до того, как оно туда уедет.

Три диагностических числа в конце обнуляются **с прошлой строки телеметрии**, а не с включения, и их стоит читать вместе:

- `loopMax` — самый длинный проход `loop()`. Больше единиц миллисекунд = что-то блокирует опрос датчика;
- `logMs` — сколько заняла сама строка телеметрии на 115200, и она из `loopMax` **вычтена**. Разделить пришлось потому, что число врало на себя же: `Serial.printf` выполняется, потом `loopMaxMs` обнуляется, и первым в свежий счётчик попадает стоимость этой же диагностической строки — 12–13 мс. `loopMax` показывал длину собственной диагностики, то есть отвечал на вопрос, которого никто не задавал. Та же операция, что уже делалась с `modemBusy`;
- `sseDrop` — сколько кадров потока пропущено из-за неуспевающего клиента.

Отсутствующие величины отдаются как `null` (`direction` без датчика направления, `battery` без пакета) — дашборд отличает «нет данных» от «ноль». Светодиоды передаются строками режима; булевы значения старых прошивок дашборд разбирает для совместимости, но сама прошивка их больше не шлёт. Поле `hostname` содержит человеческий адрес (`MyWindProbeBETA.org`), а не mDNS-метку, как раньше.

`/api/zero` живёт **только в RAM и намеренно**. Прошивка никогда не пишет NVS (образ, залитый по неверному смещению, унёс бы настройки с собой), поэтому смысл эндпоинта — найти число за пять минут проб с неподвижной вертушкой перед глазами, а не хранить его. В ответе есть поле `constant` с готовой строкой исходника, которую остаётся вставить в `.ino`: значение — свойство впаянных резисторов, а они между перезагрузками не меняются. Значения вне 20…1000 мВ отвергаются: ноль отключил бы гейт совсем и пол АЦП читался бы как постоянные 2.2 м/с фантомного ветра.

`/api/wifi` теперь только на чтение: параметры `add` / `del` / `connect` не разбираются вовсе, а дашборд показывает по нему сведения о точке доступа на вкладке «система». Поля `nets: []` и `max: 0` остались в ответе как совместимость со старыми сборками фронтенда.

### AT-консоль модема — `/api/at`

Появилась 2026-08-16 вместе с флагом `HAS_MODEM`. Существует потому, что модуль A7670E сидит штырями на макетке **наклейкой вниз** и его собственный micro-USB смотрит в стол — воткнуться в него нельзя, а два провода UART уже подключены. Альтернатива была бы хуже: временный скетч-мост без WiFi унёс бы с собой дашборд, телеметрию и саму возможность заливать по воздуху.

| Форма | Зачем |
|---|---|
| `GET /api/at?cmd=AT%2BCSQ` | из адресной строки браузера. `+` **обязан** записываться как `%2B`: WebServer декодирует литеральный `+` как пробел |
| `POST /api/at`, тело — сырая команда, `Content-Type: text/plain` | из терминала, без экранирования. Тип содержимого существен: с дефолтным для curl `application/x-www-form-urlencoded` тело снова разбирается как форма и `+` опять станет пробелом |
| `GET /api/at` без аргументов | забрать то, что модем сказал позже: URC, поток NMEA, ответ долгой команды |
| `&wait=N` | сколько ждать ответа, мс. По умолчанию 500, зажимается в 0…3000 |
| `&pins=RX,TX` | переоткрыть UART2 на других пинах, например `pins=25,27`. Принимаются только 25, 26 и 27 — три, на которых эта косичка вообще может оказаться. Рабочее сочетание на плате 38-pin — **RX 25 / TX 27** (на 30-pin было 25/26) |
| `&baud=N` | переоткрыть на другой скорости (9600…921600). Модем, отвечающий не на той скорости, неотличим от неподключённого |

Ответ — не JSON, а `text/plain`: строка `> команда`, сырые байты модема как есть, и трейлер `-- buf=… total=… waited=…мс uart=RX25/TX27@115200`. Пины и скорость печатаются в каждом ответе, чтобы молчащий модем не оставлял вопроса, кто вообще слушал. Обе настройки живут **только в RAM**, как и `/api/zero`: сочетание, которое заработало, надо перенести в константы `PIN_MODEM_RX` / `PIN_MODEM_TX` / `MODEM_BAUD`, иначе оно не переживёт перезагрузку. Экранировать CR/LF модема в строковый литерал значило бы сделать каждый ответ менее читаемым без единого выигрыша.

Три вещи, которые стоит знать до того, как консоль понадобится:

- **`total` — главная диагностика.** Это счётчик всех байтов, принятых с момента загрузки. Консоль, которая честно повторяет команду, но держит `total` на нуле, говорит однозначно: на GPIO25 не приходит ничего. Провода перепутаны, промахнулись колонкой, не та скорость или модем без питания — но не прошивка.
- **Ожидание блокирует `loop()`** на время `wait`, и при 500 мс дашборд замирает примерно на десяток кадров SSE. Это видно в `loopMax` и это ожидаемо: остановка ограничена сверху и вызвана человеком. Она принципиально отличается от неограниченной блокировки на `sseClient.print()`, ради обхода которой существует `sseFlush()`. Выход досрочный — как только последняя строка буфера оказывается финальным кодом (`OK`, `ERROR`, `+CME ERROR`, `+CMS ERROR`, приглашение `>`), так что полный таймаут платит только команда, которая не ответила вовсе. Долгие команды (`AT+COPS=?` — до двух минут) запускаются с `wait=0`, ответ забирается следующим запросом; ради этого буфер и живёт дольше запроса.
- **Буфер 2 КБ, при переполнении выбрасывается старшая половина.** `AT+CGNSSTST=1` включает бесконечный поток NMEA, и на потоке нужен хвост, а не начало.

Единственное место в API, где **намеренно не выставляется** `Access-Control-Allow-Origin`. Весь остальной API — телеметрия на чтение, а здесь команда может отправить SMS или перезагрузить модем. Без этого заголовка страница, открытая в браузере на той же сети, всё ещё может выстрелить запросом вслепую, но **прочитать ответ уже не может** — то есть вытащить IMEI, ICCID или содержимое SIM через чужую вкладку не выйдет. Это сужает дыру, а закрывает её `HAS_MODEM 0`, которым консоль и выключается перед выносом на мачту.

### Встроенный дашборд

Фронтенд (сборка Vite, PWA) вкомпилирован прямо в прошивку: `gen_web_header.py` берёт `wind-ui/dist`, жмёт каждый файл gzip и превращает в массивы PROGMEM плюс таблицу маршрутов в `web_content.h`. Прошивка раздаёт их с `Content-Encoding: gzip`. Сейчас это **13 ресурсов, 656 КБ исходно и 227 КБ в сжатом виде** — во флеше лежит именно сжатый размер; хэшированные имена в `assets/` отдаются с `immutable` на год, остальное — `no-cache`.

⛔ **Одно исключение, и оно единственное: `wind-cloud-*.js` во встроенную копию не попадает** (2026-09-12). Причина не в размере — в чанке лежит учётка зрителя MQTT, а `web_content.h` коммитится в публичный репозиторий. Изоляция сделана в три слоя, потому что у каждого своя дыра: детерминированное имя чанка в `vite.config.js`, `SKIP_PREFIXES` в генераторе **с падением, если под фильтр не попал ни один файл**, и сторож `check_web_header.py` по уже закоммиченному заголовку. Третий слой нужен отдельно: во флеш уходит не то, что генератор собрал сегодня, а то, что лежит в git. ⚠️ Проверять заголовок грепом бесполезно — gzip развёрнут в десятичные байты, текста в файле нет вовсе, поэтому сторож распаковывает содержимое, включая массивы, на которые не ссылается ни один маршрут. Такой ресурс прошивка никому не отдаст, но его байты всё равно уезжают в публичный коммит, а секрет в публичном коммите считается сгоревшим независимо от того, подавал ли его кто-то по HTTP. На плате этот чанк не запрашивается вовсе: импорт стоит под `PUBLIC_COPY`, а страница с платы отдана по HTTP.

Стек — React 19 на Vite 8, зависимостей минимум (`react`, `react-dom`, плюс нативные бинарники rolldown и lightningcss под win32-x64). Никаких библиотек графиков, и облачный клиент тоже написан свой (MQTT 3.1.1 поверх `WebSocket`, ~4.3 КБ gzip): зритель только читает, а подписка на QoS 0 понижает доставку всего, поэтому от полноценной библиотеки требовалось бы ровно то, что в ней не нужно.

Устроен проект необычно: `wind-ui/src/App.jsx` — обёртка в пять строк, а весь дашборд лежит **одним файлом `wind-dashboard.jsx` (~4300 строк) в корне репозитория**, уровнем выше `wind-ui/`. Ради этого в `vite.config.js` прописан `dedupe: ['react', 'react-dom']` — начиная с Vite 8.2 rolldown резолвит импорты от самого файла и не находит react в корне. При переносе проекта об этом файле легко забыть: одной папки `wind-ui` для сборки не хватит.

Цепочка сборки рабочая и проверена 2026-08-07 целиком, вплоть до заливки: `npm run build` → `gen_web_header.py` → `arduino-cli compile` → OTA. Команды — в `CLAUDE.md`.

### Интерфейс

Оформление с 2026-08-07: **чистый чёрный фон, весь текст белый со свечением**, единственное цветное пятно — скорость ветра (цвет по шкале Бофорта, отключается в настройках). Свечение делается `text-shadow` в два слоя и целиком считается в JS из настроек — поэтому оформление живёт инлайн-стилями, а не в CSS-файле.

Экран поделён на три вкладки: **ветер** (шкала, порыв, аптайм, спарклайн, компас при живом датчике направления), **система** (батарея, заряд, сигнал, светодиоды, сведения о точке доступа, а с 2026-09-12 ещё «Место станции», «Связь и время» и «Модем и облако») и **настройки**.

⛔ **`/api/modem` вкладка периодически не опрашивает, и это не лень.** `?radio=1` — четыре синхронных AT-раунда в `loop()`, который держит 50-герцовый опрос датчика; блокировка видна ровно в `loopMax`, то есть регулярный опрос **портил бы собственную метрику той же карточки**. Поэтому один голый запрос при открытии вкладки и отдельные кнопки для `?radio=1`, `?probe=1` и `?ntp=1`, каждая с подписью о цене прямо на месте. Панели «Связь и время» видны по обоим каналам: они собраны из полей кадра, а не из эндпоинтов — по облаку `/api/wifi` и `/api/modem` недостижимы принципиально (нет CORS, нет маршрута). Выбранная вкладка сохраняется в `localStorage`.

Настройки (все — в `localStorage`, ключ `wind_ui_settings`):

| Настройка | Значения |
|---|---|
| единицы скорости | м/с, км/ч, миль/ч, узлы, фут/с, Бофорт |
| знаков после запятой | авто / 0 / 1 / 2 |
| свечение | выкл / обычное / сильное |
| цвет скорости | по Бофорту / белый (полностью монохромный UI) |
| окно графика | 1 / 2 / 5 / 10 мин |
| компас | показывать / скрыть |
| источник данных | станция / демо |

**Пересчёт единиц целиком на стороне UI.** Прошивка всегда отдаёт м/с; смена единиц не требует ни round-trip к плате, ни перезаливки. Бофорт — не множитель, а таблица порогов, поэтому обрабатывается отдельной веткой. Подписи делений на шкале пересчитываются вместе с числом: иначе `30` на дуге и `108` в центре читались бы как ошибка.

Две вещи, убранные оттуда намеренно:

- **Управление WiFi-сетями.** Панель добавления/удаления/переключения сетей дёргала `/api/wifi?add|del|connect`, которых в прошивке больше нет. Вместо неё — сведения о собственной точке доступа только на чтение.
- **`@import` шрифта с fonts.googleapis.com.** Станция раздаёт дашборд без выхода в интернет, так что этот шрифт не загружался никогда и лишь добавлял блокирующий запрос. Заменён на системный моноширинный стек.

---

## 7. Наружу: 4G-аплинк и облачный канал

Добавлено 2026-09-11/12. Обе части необязательны и обе выключаются одним макросом
(`HAS_MODEM` / `MODEM_USE_PPP` в `.ino`, `SECRET_HAS_CLOUD` в `secrets.h`); при нуле
соответствующий код не попадает в сборку вовсе. Цена в байтах: PPP + esp-modem ~80 КБ,
облачный клиент ~125 КБ.

### PPP, и почему `begin()` живёт в `loop()`

Модем поднимается ретрай-машиной из `loop()`, а не одним вызовом в `setup()`. Причина
та же, что у WiFi-аплинка: регистрация в сети занимает десятки секунд, а `setup()`,
который их ждёт, — это станция, которая не показывает ветер, пока оператор не приедет.
`PPP.begin()` только запускает процесс, состояние читается на следующих проходах.

Два следствия, которые видно в API:

- **приоритет маршрута у PPP — 20, у WiFi STA — 100.** Дома маршрут по умолчанию
  всегда WiFi, поэтому любая проверка «а работает ли это через 4G» обязана
  **привязываться к интерфейсу**, иначе она молча измерит домашний роутер. Отсюда
  весь набор аргументов `/api/modem?probe=1|ntp=1|dns=` и `/api/cloud?via=ppp`;
- **`Serial2` и CMUX — один и тот же провод.** Пока PPP не поднят, `/api/at` говорит
  с модемом сырым `Serial2`; когда поднят — те же команды идут AT-каналом внутри CMUX
  и работают одновременно с трафиком. `&pins=`/`&baud=` при живом PPP игнорируются:
  второй UART на те же ноги — это драка за пины.

⛔ **Главная ловушка модема — не в коде.** Перезагрузка ESP32 оставляет A7670E в CMUX,
и на голый `AT` он отвечает **полной тишиной** (`total=0` в трейлере `/api/at`), что
выглядит ровно как оборванный или сожжённый провод. Снять CMUX нечем: PWRKEY притянут
к земле через R104, а штатный выход из CMUX у A7670 сломан прошивкой модуля. Лекарство
одно — снять питание. Единственное место, где это удалось закрыть программно, —
перезагрузка **через код**: `ArduinoOTA.onStart()` выводит модем из CMUX до ресета
(проверено на четырёх OTA подряд — аплинк возвращался за ~2 с с тем же PPP-адресом,
то есть PDP-контекст не рвался), и то же самое делает команда `reboot` из облачного
канала. Паника, brownout, сторожевой таймер и **открытие USB-порта** (DTR дёргает ресет)
до кода не доходят. Именно поэтому `loopMax`, `logMs` и `sseDrop` вынесены в `/api/data`:
посмотреть их кабелем теперь стоит 4G-аплинка.

### Радиосостояние — кэш, а не чтение по требованию

`PPP.RSSI()`, `networkMode()`, `operatorName()` и `attached()` выглядят геттерами, но
каждый из них — **AT-раунд через CMUX**, то есть отправка команды модему и ожидание
ответа. Четыре таких раунда в каждом кадре на 20 Гц остановили бы 50-герцовый опрос
датчика; поэтому в `/api/data` они попадают из структуры `ModemRadio`, которую
`modemRadioRefresh()` обновляет **раз в 60 с** (`MODEM_RADIO_POLL_MS`) и только когда
PPP действительно онлайн. Кэш сбрасывается в `modemPppRelease()`: показывать RSSI
от аплинка, которого больше нет, хуже, чем не показывать ничего.

⚠️ **Стоимость обновления списывается в `modemBusyMaxMs`, а не в `loopMax`** — вызов
стоит внутри того же замера, что и `serviceModem()`. Иначе раз в минуту метрика
«что-то голодает опрос датчика» показывала бы собственную диагностику: ровно та
история, из-за которой пришлось выделить `logMs` из `loopMax`.

Имя оператора приходит из сети свободным текстом и наружу идёт только через
`modemSafeText()` — фильтр выбрасывает кавычки, обратные слэши и управляющие символы.
Дело не в аккуратности вывода: кадр собирается склейкой строк, и одна кавычка в
alpha-tag ломает не поле, а **весь JSON-объект**, причём у каждого зрителя
retained-топика сразу. Через тот же фильтр идёт и `/api/modem?radio=1`.

### Часы — ворота перед первым TLS

Сертификат проверяется по часам, и плата, стартовавшая в 1970 году, отвергнет любой
действующий сертификат. Время берёт SNTP по маршруту по умолчанию; `clockValid` —
это и есть условие, при котором вообще разрешено поднимать MQTT, и оно же ворота для
проверки `exp` у команд.

⛔ **Ни GNSS, ни `AT+CCLK?` источником не годятся, и это проверено, а не предположено.**
GNSS в Киеве подменяют: модуль отдавал связный движущийся фикс в Перу с датой 2028 года,
причём **с качеством лучше настоящего** (HDOP 0.63 против 6.01) — отбор фиксов по
качеству такую подделку принимает. Часы модема врут иначе: `AT+CCLK?` вернул
`26/09/11,16:57:42+00` при настоящем UTC `08:57:42` — дата верна, ход верен, время
суток ровно на 8 часов вперёд (Пекин) при заявленном нулевом смещении.

### Облачный канал

Станция за CGNAT — входящее соединение до неё невозможно в принципе. Поэтому обе
стороны ходят наружу и встречаются на брокере (TLS 8883). Клиент `esp-mqtt` лежит
в SDK ядра и крутится **в собственной задаче FreeRTOS**, а не в `loop()`; из этого
следует всё остальное устройство:

- **публикация только `esp_mqtt_client_enqueue()`.** `publish()` по своей же
  документации «might block for several seconds» в задаче вызывающего — а вызывающий
  здесь `loop()`, то есть 50-герцовый опрос датчика. Это ровно та неограниченная
  блокировка, ради обхода которой в разделе 6 существует `sseFlush()`;
- ⚠️ **аргумент `store` обязан быть `true`.** При `false` в очередь идут только QoS 1
  и 2, а **QoS 0 молча выбрасывается** — то есть вся быстрая половина канала перестаёт
  публиковать, не сообщая ни о какой ошибке;
- **команды исполняются в `loop()`**, а не на задаче MQTT. Обработчик событий делает
  минимум: поднимает флаг или копирует payload в очередь. Всё, чего касается команда, —
  состояние, которым владеет `loop()`, и лезть в него с другого ядра значит получить
  гонку, которая проявляется только невозможным показанием.

Шесть топиков, темпы и подпись команд разобраны в `CLAUDE.md`, §Облачный канал —
здесь только то, что касается самого кода.

**Задержка ~1 с — это очередь, а не сеть.** Измерено 2026-09-12: задача MQTT сидит
в опросе сокета и разгребает outbox только проснувшись, поэтому положенный в очередь
ack ждёт остатка цикла. Круг команды — медиана **1162 мс** сам по себе и **442 мс**,
если разбудить задачу входящим сообщением через 250 мс; настоящий путь ~200 мс.
Запаздывание при этом **постоянное, а не рваное** (живые кадры 1 Гц приходят с медианой
1005 мс). Публичного способа разбудить задачу нет, и размен сделан в пользу сэмплера.

---

## 8. OTA

`ArduinoOTA` на стандартном порту 3232, hostname `windstation`, пароль — `SECRET_OTA_PASSWORD` в `secrets.h`.

Самое интересное здесь — обработчик старта, который **закрывает веб-сервер на время загрузки**:

```cpp
ArduinoOTA.onStart([]() { sseClient.stop(); server.close(); ... });
```

Причина в том же дефиците TCP-блоков. `ArduinoOTA.handle()` блокирует выполнение на всю загрузку, `server.handleClient()` в это время не вызывается, и запросы дашборда копятся непринятыми. Шестнадцать блоков заканчиваются секунд за восемь, после чего lwIP начинает освобождать место принудительно — и первым сносит сам OTA-сокет. Загрузка умирала около 5%.

Поэтому порт 80 закрывается, а SSE-подписчик отключается (его кадры на 20 Гц отбирали бы эфир и буферы у передачи). Успешное обновление заканчивается перезагрузкой, неудачное — восстанавливает сервер через `onError`.

### Вторая половина: pull-OTA

С 2026-09-12 у прошивки есть второй путь обновления, и он существует потому, что первый
на мачте неприменим: `espota` открывает соединение **к плате**, а за CGNAT такого
соединения не бывает. Значит станция идёт за образом сама — команда `ota` облачного канала
несёт `url=` и `sha256=`, и обе половины этой пары важны по-разному.

**Чем занята безопасность, и чем она не занята.** Право на заливку даёт **подпись команды**:
хеш едет внутри подписанного конверта, поэтому подменённый на хостинге файл не сойдётся
с хешем, а подменённый хеш — с подписью. TLS в этом не участвует и `http://` остаётся
рабочим путём: `CLOUD_ROOT_CA` — это связка Let's Encrypt, и обновление, работающее только
по TLS, добавило бы станции второй срок годности. ⛔ А вот **конфиденциальность** — вопрос
отдельный и не праздный: образ несёт все пароли станции открытым текстом, поэтому `https://`
предпочтительнее там, где корень хоста в прошивке есть, и в любом случае файл не место
публичному хостингу.

Устройство кода, по порядку исполнения:

- **исполнение отложено на 1.5 с** (`cloudOtaAt = millis() + 1500`) и стоит в `serviceCloud()`
  **вторым**, сразу за отложенной перезагрузкой. Причина та же: подтверждение обязано уехать
  до того, как `loop()` встанет на минуту. Проверка «канал включён» при этом **не**
  обходится — скачивание обошлось бы без MQTT, а вот отчёт о результате нет, и обновление,
  исхода которого никто не услышит, начинать незачем;
- **ворота по куче**: 60 КБ для https, 20 КБ для http. Отказ с настоящим числом лучше
  провала аллокации посреди рукопожатия, после которого читать нечего;
- **порт 80 закрывается и SSE отключается** — ровно как в `ArduinoOTA.onStart()` и ровно
  по той же причине с шестнадцатью TCP-блоками lwIP;
- **`Content-Length` обязателен.** Без него передача чанковая, а чанки пришлось бы
  де-фреймить прежде, чем байты можно хешировать. Образ меньше 200 000 байт отвергается
  сразу — это ловушка на страницу «не найдено», отданную с кодом 200;
- **SHA-256 считается вручную**, потоком через mbedtls: у `Update` есть только `setMD5()`.
  Сверка идёт **до `Update.end()`**, то есть до того, как раздел объявляется загрузочным;
  не сошлось — `Update.abort()`, и работающая прошивка остаётся работающей. Проверено
  подсунутым образом: `sha256 mismatch, 1548064 B discarded`, аптайм не сбросился;
- **один повтор, и только на отрицательный код.** Это транспортные ошибки `HTTPClient`,
  поднятые до чтения первого байта, поэтому повтор ничего не дублирует; настоящий
  HTTP-статус не повторяется никогда. Причина измеренная: самое первое исходящее соединение
  к незнакомому хосту вернуло `http -1` при том, что запрос до сервера не дошёл вовсе,
  а следующие три к тому же URL дали чистые `404`;
- ⚠️ **редирект со сменой схемы не выполняется** — `HTTPClient::setURL()` отказывается
  менять протокол, поэтому `http://` на хосте, заворачивающем всё на `https://`, кончается
  как `http 301`. Давать конечную ссылку;
- **на успехе модем выводится из CMUX** перед `ESP.restart()` — та же вежливость, что
  в `ArduinoOTA.onStart()`, иначе новая прошивка поднялась бы к модулю, который молчит
  на голый `AT`;
- **подтверждений два**: «начал» уезжает до скачивания, «чем кончилось» — после. По каналу,
  где ответ идёт секундами, первое без второго ответом не является. Последний результат
  лежит в `/api/cloud` в поле `otaLast` — в кадр данных он не попадает намеренно, тот
  публичен.

Цена та же, что у обычной OTA: `loop()` стоит всё время загрузки, то есть опрос датчика
тоже. По домашней сети это 9 с на полтора мегабайта. Инструкция оператора — раздел 2a
в `FLASHING.md`.

---

## 9. Тайминги одним списком

| Что | Период |
|---|---|
| опрос датчика ветра | 20 мс |
| опрос линий зарядника | 100 мс |
| кадр SSE | 50 мс |
| обновление светодиодов | 500 мс |
| строка в Serial | 2 с |
| замер RSSI клиента | 5 с |
| замер батареи | 30 с |
| автосброс порыва | 10 мин |
| удержание статуса зарядки | 3 с |
| облако: отсчёт в пачку | 50 мс |
| облако: пакет `live` | 200 мс от внешнего питания, **1 с от батареи** |
| облако: `state` | 5 с, либо сразу по изменению, но не чаще 1 с |
| облако: минутный агрегат | 60 с (кольцо на 200 = 3.3 часа) |
| облако: keepalive / переподключение | 60 с / 10 с |

⚠️ Реальный темп `live` сейчас всегда 1 Гц: `powerSource` намертво `battery`, пока
внешнее питание не доходит до `IN+` TP4056 (задача 11). И ещё одно, что стоит держать
в голове при чтении этой таблицы: **периоды публикации — не периоды доставки**. Между
ними стоит цикл опроса сокета в esp-mqtt, около секунды (см. раздел 7).

---

## 10. Замечания по итогам разбора

Код аккуратный и необычно хорошо прокомментированный — почти каждое решение объяснено вместе с причиной. Ниже то, что стоит знать; исправлений в коде по итогам самого разбора **не делалось**.

Три замечания из первой редакции этого раздела закрылись сами, когда 2026-08-07 убрали станционный режим, — вместе с кодом, о котором они были: невалидный JSON в списке сетей `/api/wifi` (списка больше нет), подвисание дашборда на 8 секунд при пересканировании (пересканирования больше нет) и молчаливый отказ `/api/wifi?add=` на полном списке.

### Первые 30 секунд батарея не измеряется

`readBattery()` впервые вызывается только когда `millis()` перевалит за 30000 — отдельного вызова в `setup()` нет. До этого момента `batteryPresent = false`, и API с Serial честно показывают `battery: null` / `Bat=0.00V (0%) absent` независимо от того, подключён пакет или нет.

Практический вывод: **нули в первые полминуты после старта ничего не значат.** Судить о батарее можно только со второй минуты. Лечится одним вызовом `readBattery()` в конце `setup()`.

### API по-прежнему без аутентификации

Аутентификации нет, `Access-Control-Allow-Origin: *` стоит на всех ответах, и все операции выполняются обычным GET. Переход на закрытую точку доступа сузил проблему, но не убрал её: теперь дотянуться до API может только тот, кто знает пароль сети, — зато это ровно те же люди, что и раньше, плюс любая веб-страница, открытая в браузере уже подключённого телефона. Опасного из оставшегося немного (управление светодиодами, сброс порыва), самое чувствительное — `/api/wifi?add=…&pass=…` — исчезло вместе со списком сетей.

Для домашней метеостанции размен приемлемый. Знать о нём стоит: пароль на WiFi — это и есть вся защита API.

### Мелочи

- Пара `powerSource` / `chargeState` умеет вставать в логически невозможное сочетание **`battery` + `absent`** — «питаюсь от батареи, батареи нет». Именно это и видно, когда плата запитана от USB-разъёма ESP32: TP4056 не запитан, обе его линии молчат, значит «внешнего питания нет», а пакета действительно нет. Поля вычисляются независимо и не сверяются между собой; разруливать сочетание приходится дашборду.
- `analogSetPinAttenuation()` для пина направления и буферы `dirSinBuf`/`dirCosBuf` живут в коде и при `HAS_DIRECTION 0`. Безвредно, немного мёртвого кода.
- Смена `batteryPresent` доходит до `chargeState` с задержкой до 30 секунд: опрос зарядника идёт каждые 100 мс, но опирается на флаг, обновляемый раз в полминуты.
- Переполнение `millis()` (49.7 суток) обработано корректно — везде беззнаковая разность, а не сравнение абсолютных значений.
