temafey/ArduinoWindStation/PUBLISHING.md

# Публичная копия дашборда

Станция раздаёт дашборд сама, но только внутри своей точки доступа и только когда включена.
Публичная копия — та же самая сборка, выложенная на обычный статический хостинг, чтобы адрес
открывался всегда и с любого устройства.

## Чем публичная копия сильнее платы

Неочевидное следствие: на настоящем HTTPS-хостинге дашборд оказывается **способнее**, чем
на самой станции. Работает всё, что требует интернета и защищённого контекста и чего
у платы нет в принципе:

- живые слои карты — предупреждения NWS, донесения SPC, прогноз конвекции, отражаемость NOAA;
- «Эфир» — снимки GOES и радарные петли;
- фотографии приборов в справочнике «Метеорология»;
- геолокация и уведомления о шквале: браузер даёт их только защищённому контексту;
- **с 2026-09-12 — живой ветер с мачты**, если у станции есть облачный канал.

То есть публичная копия — не урезанная витрина, а вторая половина проекта.

## Что публичная копия может и чего не может

⚠️ **Этот раздел до 2026-09-12 утверждал «живых показаний на ней нет». Для станции
с облачным каналом это больше не так.**

Два запрета, из-за которых их не было, никуда не делись — оба остаются в силе:

1. Хостинг отдаёт страницу по **HTTPS**, а станция слушает только HTTP. Браузер блокирует
   запрос с HTTPS-страницы на `http://` как mixed content — без вариантов и без обхода.
2. Станция сидит за CGNAT оператора либо в изолированной точке доступа, и снаружи
   не адресуема в принципе — никакой проброс портов этого не чинит.

Изменилось направление. Станция **сама** выходит наружу по TLS и публикует показания на
брокер, а страница читает их оттуда по `wss://` — то есть в том же защищённом контексте,
без смешанного содержимого и без входящего соединения. Оба запрета обойдены не нарушением,
а тем, что больше никто не пытается достучаться до платы снаружи.

Что публичная копия умеет и чего не умеет теперь:

| | напрямую (из сети станции) | через облако (откуда угодно) |
|---|---|---|
| показания | поток SSE 20 Гц, задержка ~0 | пачками, задержка **постоянная, ~1 с** |
| управление (светодиоды, сброс порыва, ноль) | ✅ | ❌ по HTTP недостижимо; в канале есть подписанные команды, но дашборд их не шлёт |
| `/api/wifi`, `/api/modem`, `/api/cloud` | ✅ | ❌ у этих эндпоинтов нет CORS и нет маршрута снаружи |
| работает при выключенной станции | ❌ | retained-кадр остаётся видимым с меткой времени, рядом — «станция офлайн» |

⚠️ **Задержка ~1 с — это очередь на плате, а не сеть**, и она постоянная, а не рваная.
Искать её в качестве 4G бесполезно; разбор — `CLAUDE.md`, §Облачный канал.

Станция без облачного канала ведёт себя ровно как раньше: демо-данные и плашка с
объяснением. Различает эти два случая поле `cloudId` в сохранённой записи станции —
не `PUBLIC_COPY`. Три признака, которые до облака выглядели одним и которые теперь
нельзя путать: `PUBLIC_COPY` — «прямого HTTP к плате нет» (**лечится облаком**),
`!GEO_AVAILABLE` — «браузер не отдаёт координаты смотрящего» (не лечится ничем, кроме
HTTPS), `cloudId` — «у ЭТОЙ станции канал есть».

### Один бандл на оба места — принцип с одним исключением

Тот же бандл по-прежнему работает и там и там: на плате он отдаётся по HTTP, значит
`PUBLIC_COPY` там ложь. Отдельной сборки для публикации нет и заводить её не надо.

**Но с 2026-09-12 у принципа есть одно намеренное исключение, и его надо знать:**
облачный транспорт (`wind-cloud-*.js`) собирается в отдельный чанк, который
`gen_web_header.py` во встроенную копию **не кладёт**. Причина не в размере — в чанке
лежит учётка зрителя MQTT, а `web_content.h` коммитится в публичный репозиторий и
зашивается во флеш. Учётка эта по построению публична (она умеет только смотреть), но
одно дело публиковать её в бандле на хостинге, и совсем другое — в git и в образе
прошивки, откуда её уже не вынуть.

Практически это значит две вещи:

- **на хостинг выкладывается `wind-ui/dist` целиком**, вместе с облачным чанком — иначе
  публичная копия останется без живых данных;
- **во флеш идёт тот же `dist` минус этот чанк**, и следит за этим генератор, а не человек.
  На плате чанк не запрашивается вовсе: импорт стоит под `PUBLIC_COPY`, а страница
  с платы отдана по HTTP.

⛔ **Сборка `WIND_SINGLE=1` — отдельный случай, и её нельзя путать с публичной.** Она
склеивает всё в один файл для вставки в артефакт claude.ai, и облачный модуль там
**выброшен**, а не встроен: другой канал, другая аудитория, отозвать нельзя.

## Подключение станции с публичной копии

При первом заходе показывается окно с тремя вариантами: найти ближайшую станцию,
подключить свою или просто посмотреть демо. Отметка о показе лежит в `wind_ui_welcomed`,
вернуть окно можно кнопкой «найти ближайшую» в настройках.

**Каталога станций не существует, и это принципиально.** Станция автономна, сидит в
собственной сети и никуда о себе не сообщает — никакого реестра с координатами нет.
Поэтому «ближайшая» ищется среди станций, которые пользователь сам сохранил в этом
браузере (`wind_ui_stations`), и запрос геоданных осмыслен: он выбирает ближайшую из
своих. Когда сохранять нечего, интерфейс так и говорит, а не подсовывает выдуманные
показания под видом соседской станции.

Расстояние считается по большому кругу (`distanceKm`), Земля — шар: нужна не точность,
а порядок сортировки.

Чем сценарий заканчивается — зависит от того, откуда открыта страница:

| Откуда открыта | Что происходит |
|---|---|
| публичная копия (HTTPS), у станции есть `cloudId` | ближайшая выбирается и **показывает живые данные через брокер**; управление недоступно, и интерфейс объясняет почему |
| публичная копия (HTTPS), `cloudId` нет | ближайшая выбирается, но данные не подтянуть — mixed content. Показывается прямая ссылка `http://<адрес>/`, переход по ней браузер разрешает |
| копия на плате (HTTP) | окно не показывается вовсе: вы уже на станции, выбирать нечего |
| dev-сервер на localhost | работает полностью — localhost считается защищённым контекстом |

Геолокация требует защищённого контекста, поэтому по обычному HTTP браузер её не даёт
(`GEO_AVAILABLE` в коде). На плате это неважно, там поиск и не нужен.

## Что выкладывать

Каталог `wind-ui/dist` целиком — 14 файлов, ~665 КБ. Почти тот же набор зашивается
в прошивку (без облачного чанка, см. выше), так что специально ничего готовить не надо:

```powershell
cd C:\Users\temaf\OneDrive\Documents\Projects\TymurWindStation\wind-ui
& "C:\Program Files\nodejs\npm.cmd" run build
```

⚠️ **`wind-ui/.env` должен существовать на момент сборки.** В нём лежат
`VITE_MQTT_VIEWER_URL` / `_USER` / `_PASSWORD` / `VITE_MQTT_STATION_ID`, и Vite
подставляет их **литералами в момент сборки** — файла нет, значит в бандле нет учётки,
значит публичная копия молча вернётся к демо-режиму. Собирать с чужой машины, где
`.env` не создан (он вне git, шаблона у него нет), — самый вероятный способ выложить
неработающую копию, и признак ровно один: страница показывает демо вместо ветра.

⚠️ **Проверять после сборки, что облачный чанк действительно один и он отдельный.**
В `wind-ui/dist/assets/` должен быть ровно один `wind-cloud-*.js`. Его отсутствие
означает, что код-сплит схлопнулся и облачный код уехал в entry, то есть в прошивку —
а именно этого вся конструкция и не должна допускать. Генератор `gen_web_header.py`
на такой случай падает, но узнать об этом лучше здесь, а не на заливке.

## Куда выкладывать

**Обновление 2026-08-19: git на этой машине установлен** (2.55.0), и репозиторий уже
опубликован на GitHub. Значит GitHub Pages стал возможен — но с оговоркой, которая и
решает выбор площадки.

### Путь к ассетам решает, куда можно выкладывать

Vite собирает страницу с **абсолютными** путями: `/assets/index-*.js`. Плате это ровно то,
что нужно — она отдаёт дашборд из корня. Но это же делает непригодным «проектный» сайт
GitHub Pages вида `temafey.github.io/ArduinoWindStation/`: браузер пойдёт за скриптом на
`temafey.github.io/assets/...` и получит 404.

Чинится параметром `base` в `vite.config.js` — но тогда **тот же бандл перестанет работать
на плате**, а «один бандл на оба места» здесь несущий принцип: из-за него и нет отдельной
сборки для публикации. Отсюда таблица:

| площадка | адрес | работает без правок |
|---|---|---|
| Cloudflare Pages | `<имя>.pages.dev` | **да**, страница в корне |
| Netlify, Vercel | поддомен в корне | **да** |
| GitHub Pages со своим доменом | корень домена | **да** |
| GitHub Pages, проектный сайт | `/ArduinoWindStation/` | нет: нужен `base` и вторая сборка |

Вывод прежний, но теперь обоснованный: проще всего Cloudflare Pages в режиме прямой
загрузки — ни `base`, ни push, ни второй сборки.

1. Завести бесплатный аккаунт на `dash.cloudflare.com`.
2. Workers & Pages → Create → Pages → **Upload assets**.
3. Имя проекта задаёт адрес: `<имя>.pages.dev`. HTTPS-сертификат выпускается сам.
4. Перетащить туда содержимое `wind-ui/dist`.

Обновление после правок дашборда — пересобрать и залить папку заново тем же способом.

Альтернатива без аккаунта у хостера — опубликовать одностраничную версию как артефакт
claude.ai. Для этого `dist` нужно склеить в один самодостаточный файл: CSS и JS внутрь,
ссылки на favicon и манифест выбросить (этих файлов рядом не будет).

## Свой домен вместо поддомена

`mywindprobebeta.org` на 2026-08-07 свободен — в публичном DNS у него нет даже NS-записей.
Чтобы адрес совпал с тем, что вшит в прошивку, домен надо зарегистрировать (~$10–15 в год)
и добавить его в проект Pages как Custom domain; DNS-записи площадка подскажет сама.

Важная оговорка: это **не сделает станцию доступной из интернета**. Совпадёт только имя.
Внутри сети станции то же имя будет резолвиться в 192.168.4.1 её собственным DNS-сервером,
а снаружи — в адрес хостинга. Два разных места под одним адресом, и наружу смотрит витрина.
