temafey/ArduinoWindStation/images/7392863293_w640_h640_shtativ-professionalnyj-2m.webp

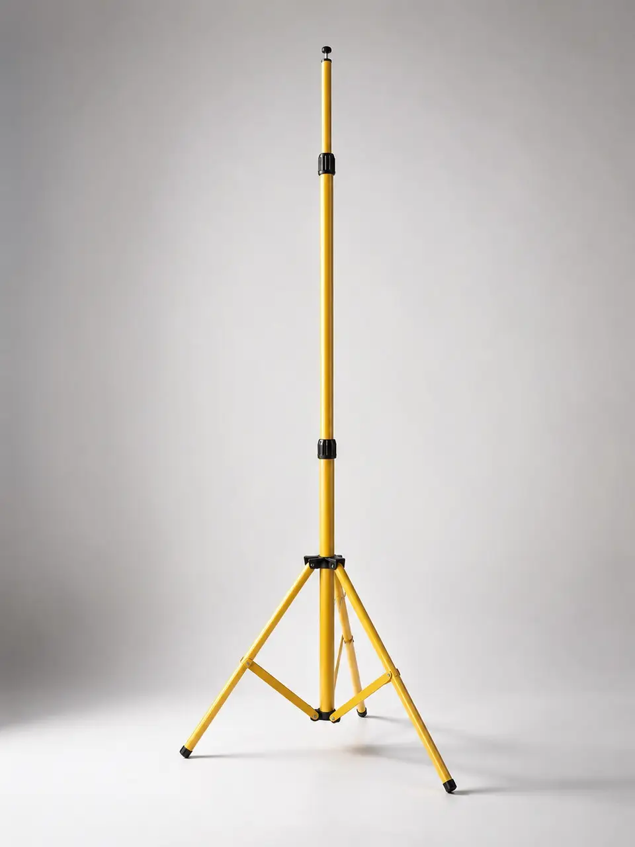
images/7392863293_w640_h640_shtativ-professionalnyj-2m.webp
