temafey/ArduinoWindStation/images/photo_2026-07-01_09-40-58.jpg

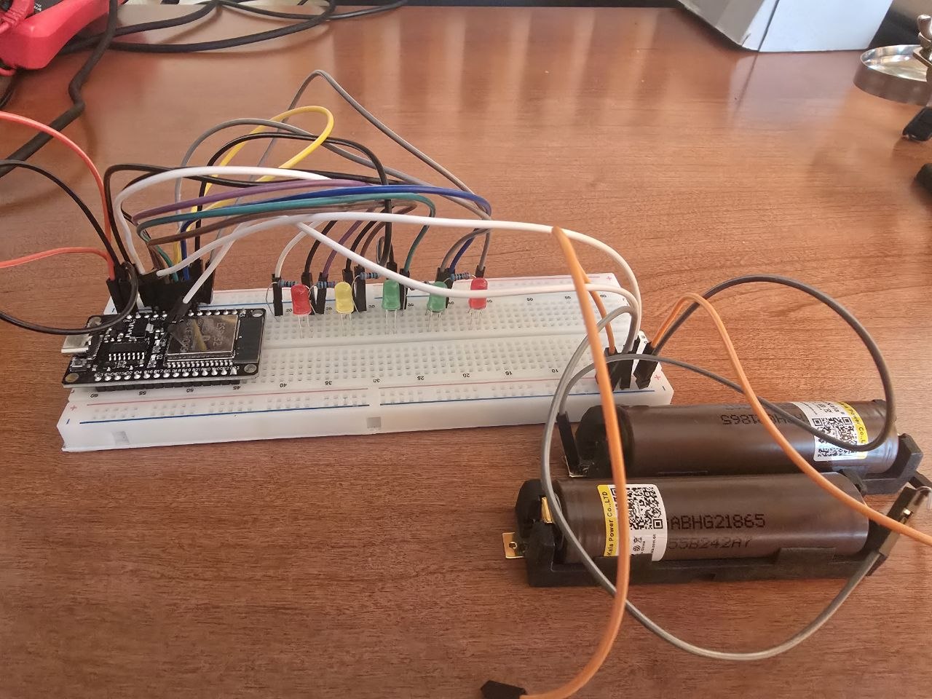
images/photo_2026-07-01_09-40-58.jpg
