temafey/ArduinoWindStation/images/Screenshot 2026-07-01 020659.png

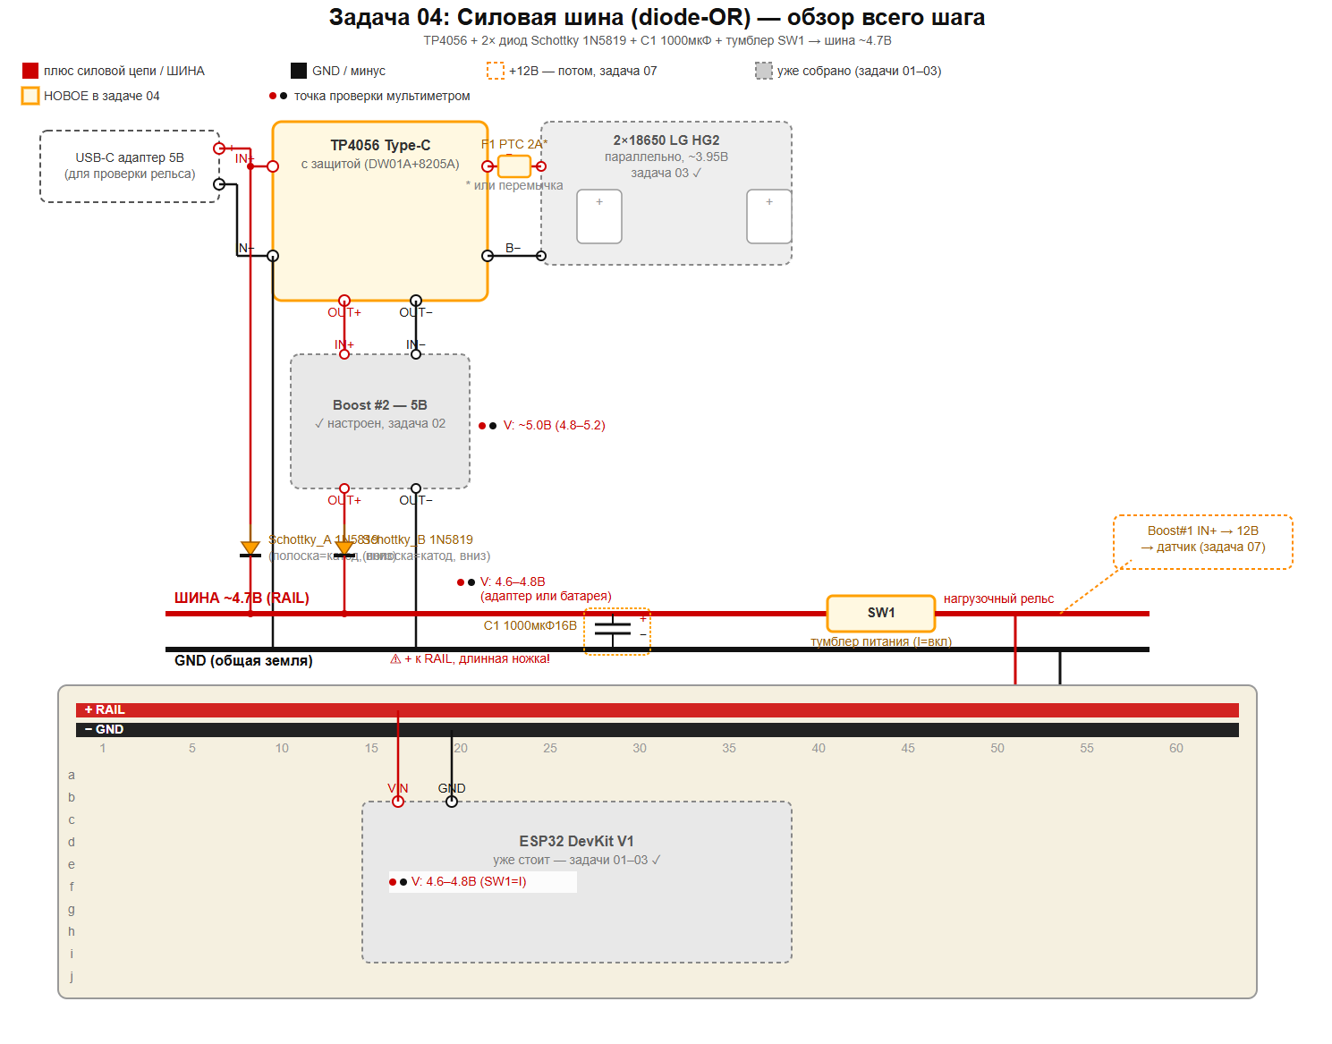
images/Screenshot 2026-07-01 020659.png
