temafey/ArduinoWindStation/images/Screenshot 2026-07-01 091603.png

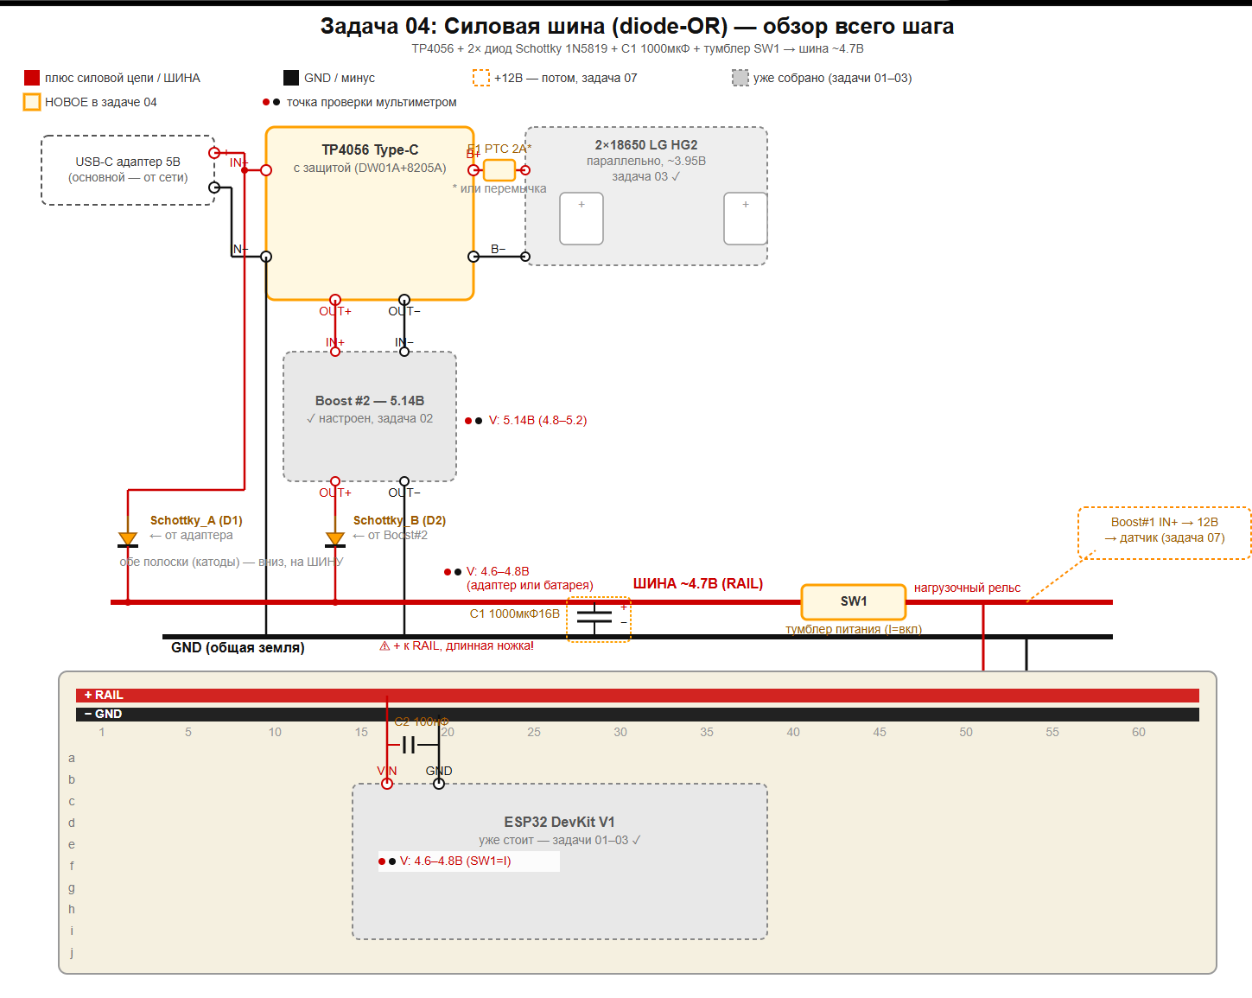
images/Screenshot 2026-07-01 091603.png
