temafey/ArduinoWindStation/images/Screenshot 2026-07-18 212147.png

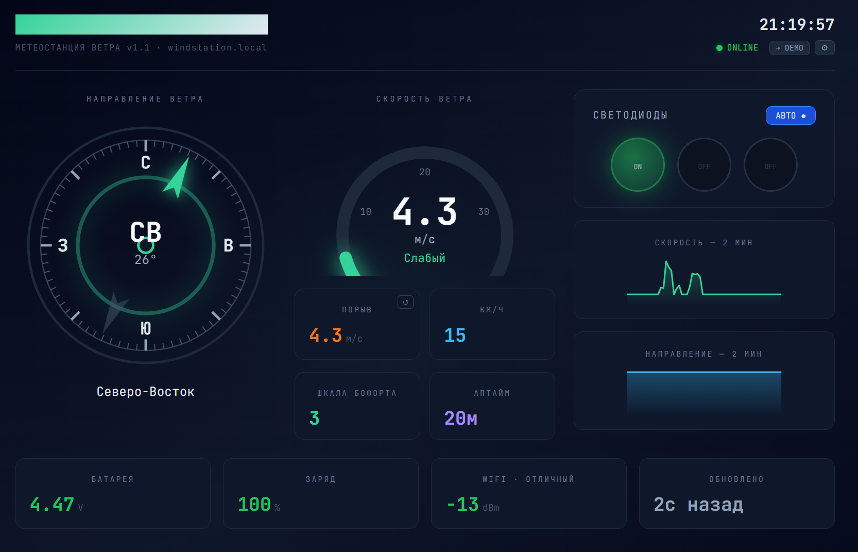
images/Screenshot 2026-07-18 212147.png
