temafey/ArduinoWindStation/images/Screenshot 2026-08-02 115919.png

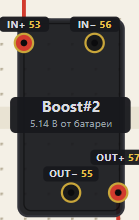
images/Screenshot 2026-08-02 115919.png
