temafey/ArduinoWindStation/images/skins/photo_2026-08-15_18-43-16 (2).jpg

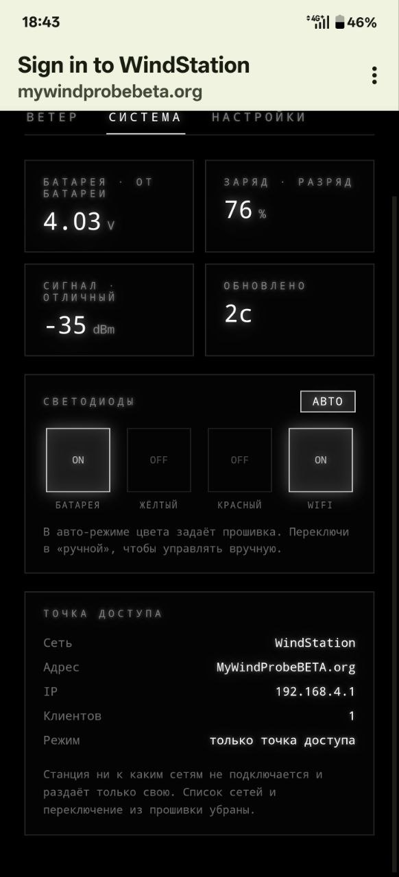
images/skins/photo_2026-08-15_18-43-16 (2).jpg
