temafey/ArduinoWindStation/images/skins/photo_2026-08-15_20-44-21 (2).jpg

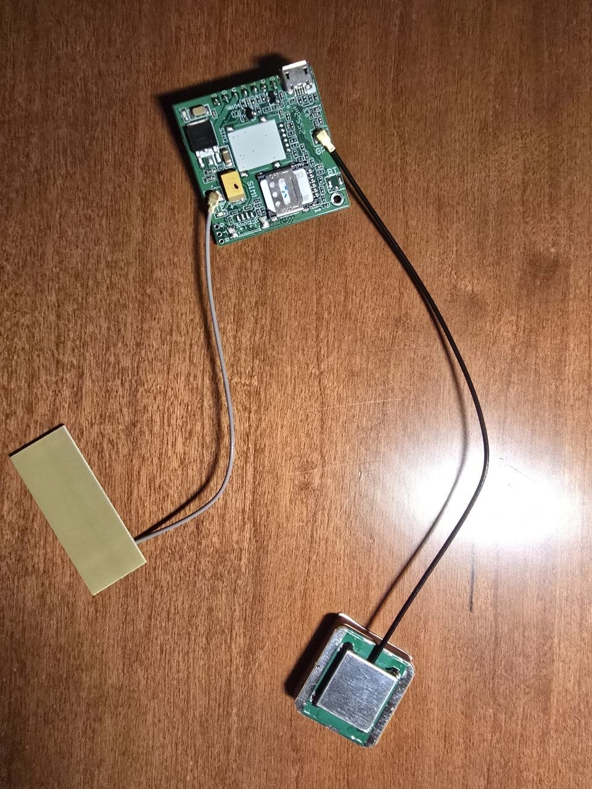
images/skins/photo_2026-08-15_20-44-21 (2).jpg
