temafey/ArduinoWindStation/images/skins/photo_2026-08-15_20-44-21.jpg

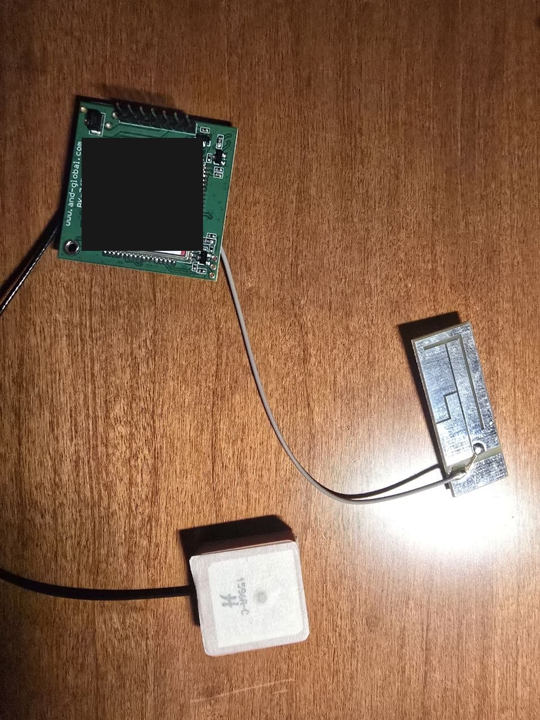
images/skins/photo_2026-08-15_20-44-21.jpg
