temafey/ArduinoWindStation/images/skins/photo_2026-08-15_20-44-44 (2).jpg

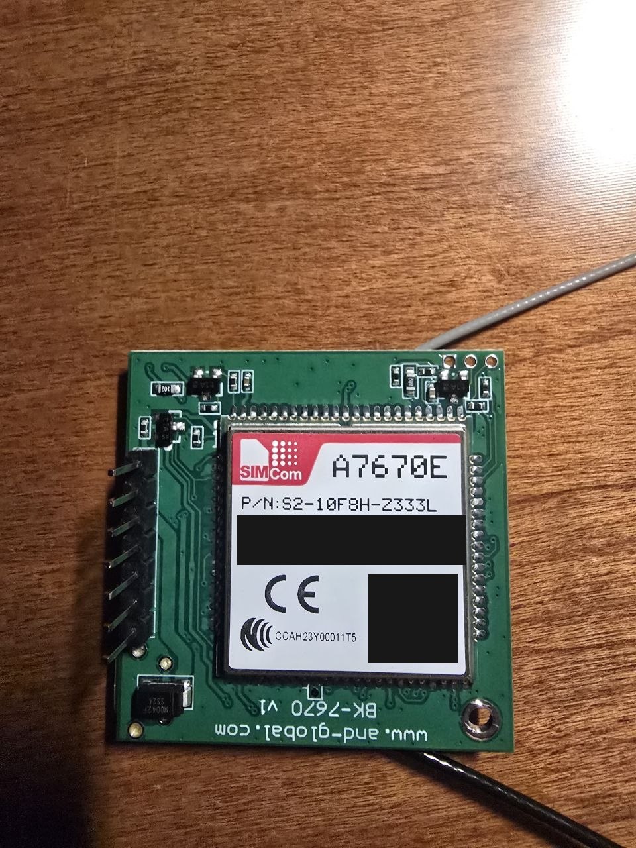
images/skins/photo_2026-08-15_20-44-44 (2).jpg
