temafey/ArduinoWindStation/images/skins/S1ee45f7bb5124ec68ab51d3155c19c0a2.jpg

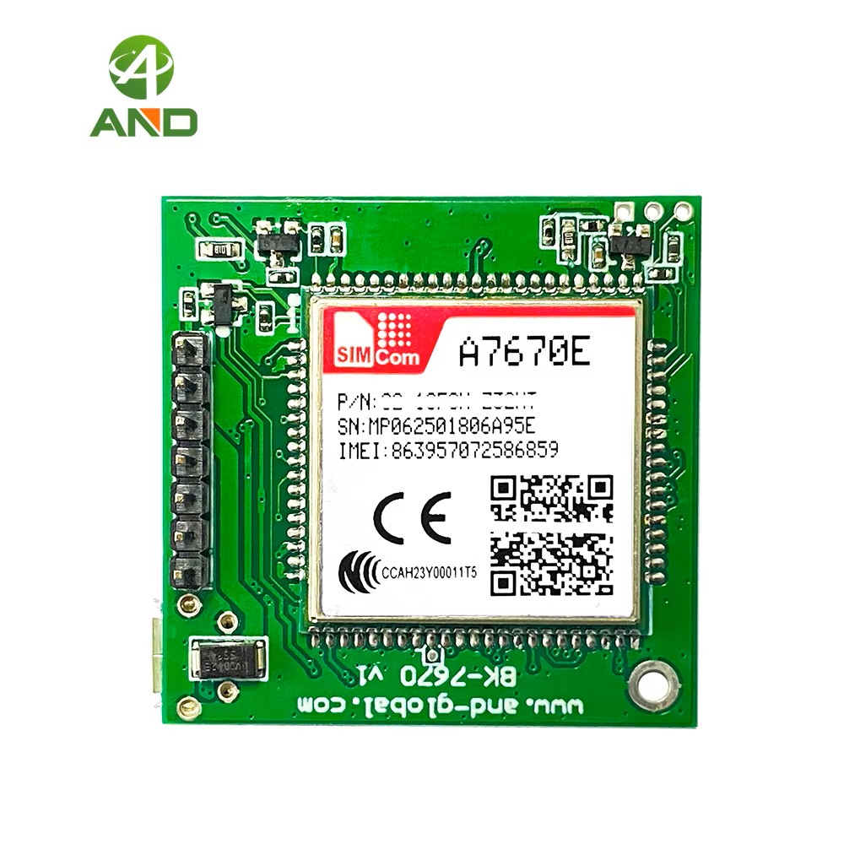
images/skins/S1ee45f7bb5124ec68ab51d3155c19c0a2.jpg
