temafey/ArduinoWindStation/images/skins/S2bed18294ac8498aa4fd548a45347a02p.jpg

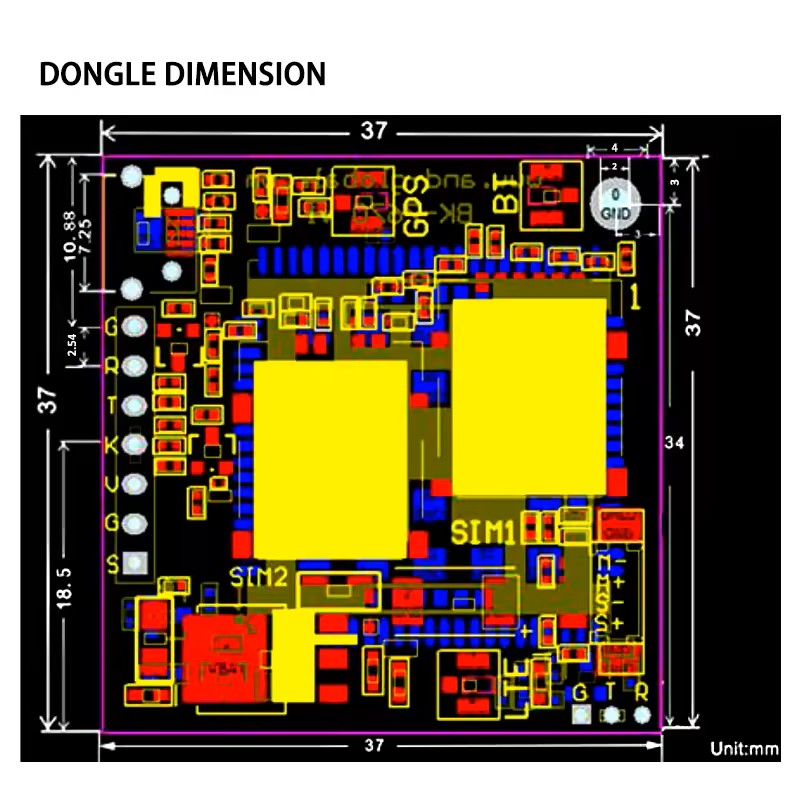
images/skins/S2bed18294ac8498aa4fd548a45347a02p.jpg
