temafey/ArduinoWindStation/images/skins/S3c510f06d18846e48f0040113247b576n.jpg

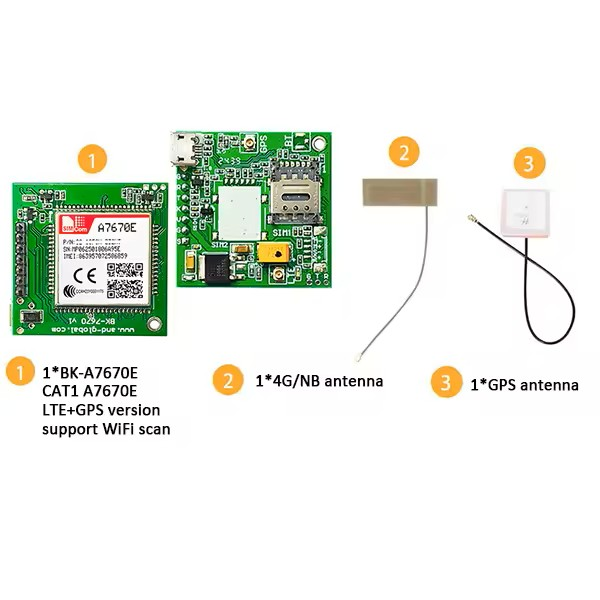
images/skins/S3c510f06d18846e48f0040113247b576n.jpg
