temafey/ArduinoWindStation/images/skins/S15e41d54491f41009dd0d34522d9f2cfC.jpg

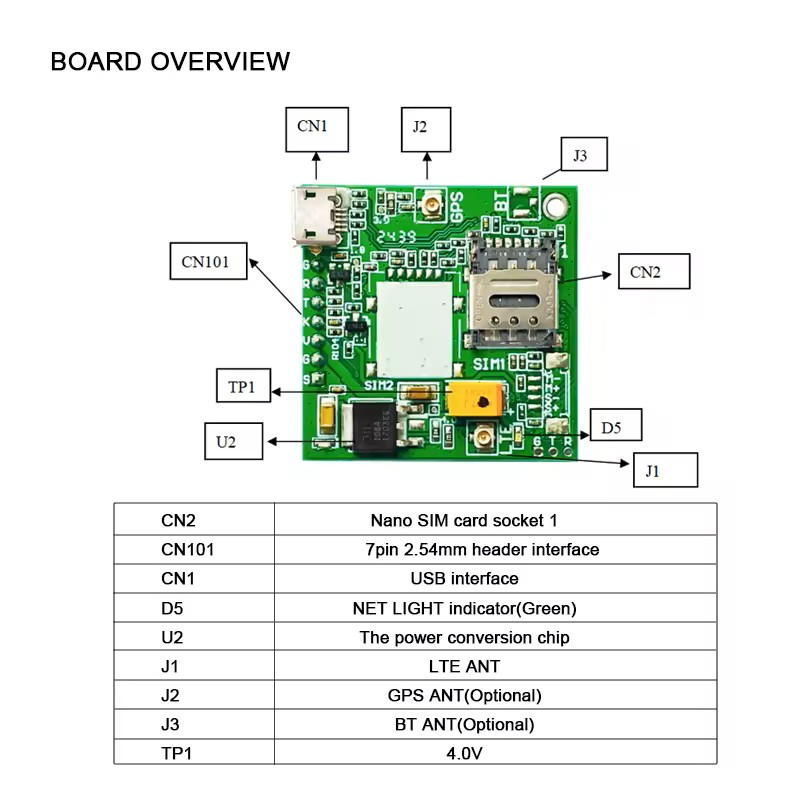
images/skins/S15e41d54491f41009dd0d34522d9f2cfC.jpg
