temafey/ArduinoWindStation/images/skins/S73257e41c41b4d34aadf0ac0ff61f845P.jpg

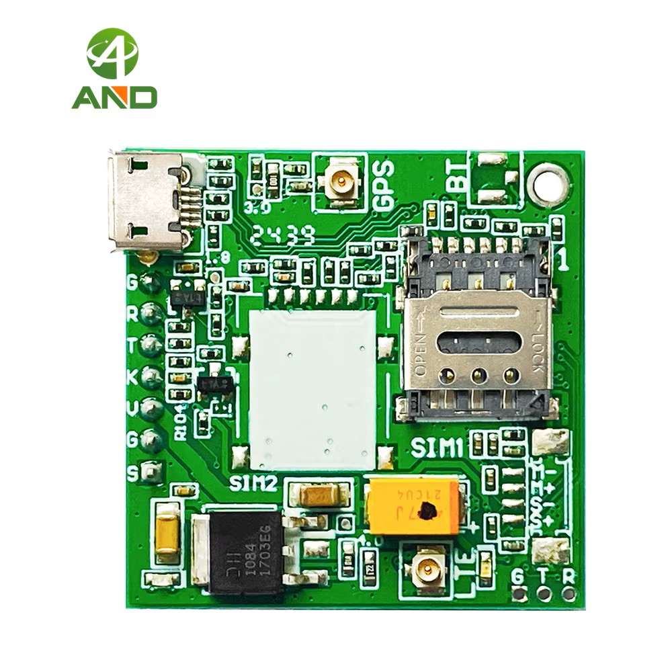
images/skins/S73257e41c41b4d34aadf0ac0ff61f845P.jpg
