temafey/ArduinoWindStation/kicad/WindStation_2d_view.png

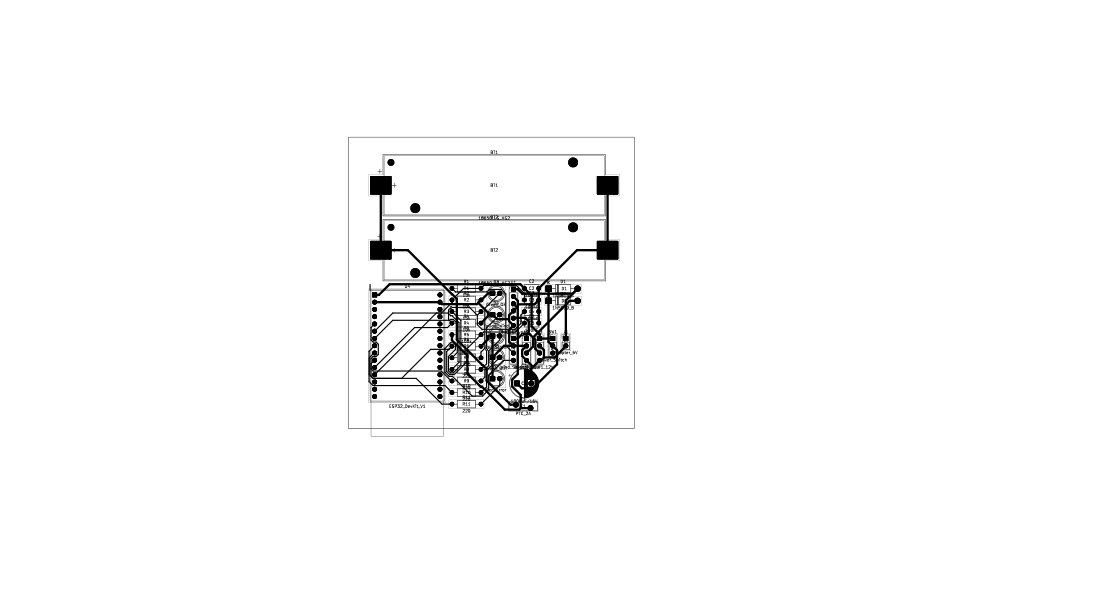
kicad/WindStation_2d_view.png
