temafey/ArduinoWindStation/wind-station-assembly.md

# Метеостанция ветра на ESP32 — Сборочный документ

## Описание проекта

DIY метеостанция для измерения ветра с резервным питанием от аккумулятора 18650 и выводом красивого дашборда на телефон, планшет или монитор через Android TV приставку. Станция **сама раздаёт WiFi** — подключаешься к её сети и открываешь дашборд, домашний роутер не нужен. Обновления прошивки — по OTA без вскрытия корпуса.

**Как открыть дашборд:** подключиться к сети `WindStation` (пароль — в `secrets.h`) и открыть `http://MyWindProbeBETA.org` — или `http://192.168.4.1`, если браузер капризничает. Обычно портал всплывает сам сразу после подключения.

**Датчик:** анемометр 0-5V, **только скорость** (с AliExpress)
**Диапазон:** скорость **0–30 м/с**. Канала направления нет
**Питание датчика:** 10–30V DC (используем 12V)
**Выходной сигнал:** аналоговый 0–5V (один канал)

> ⚠️ **Датчик сменился, и это важнее, чем выглядит.** Раньше стоял Polycarbonate
> «Wind Speed & Direction» на 0–60 м/с с каналом направления. Нынешний — **0–30 м/с
> и без направления**. В прошивке за это отвечают `SPEED_MAX = 30.0` и `HAS_DIRECTION 0`:
> оставленные от старого датчика 60 **удваивают каждое показание**. Канал направления
> (GPIO35) в коде выключен, провод к нему не идёт, второй делитель не собран.

---

## Список компонентов

| # | Компонент | Назначение |
|---|---|---|
| 1 | **ESP32 DevKitC (38 pin, Type-C)** на модуле **ESP-32U**, мост **CP2102** | Контроллер, WiFi, веб-сервер, чтение ADC. С 2026-09-06 заменяет 30-pin DOIT DevKit V1: набор пинов у 38-pin — надмножество 30-pin, прошивка та же, переделывается только медь на макетке (схема v8). ⚠️ У ESP-32U **нет печатной антенны**, только u.FL |
| 1a | Антенна 2.4 ГГц на u.FL (пигтейл либо клеевая плёнка) | Обязательна: без неё плата почти не передаёт. Взамен антенна выносится **за стенку глухого IP65-бокса** и разносится с LTE-антенной модема — B7 (2500–2570 МГц) стоит вплотную к 2.4 ГГц |
| 2 | Датчик ветра 0-5V, **0–30 м/с, только скорость** | Измерение скорости. Канала направления у него нет — прошивка собрана с `HAS_DIRECTION 0` |
| 3 | Mini Boost Module HW-085 / TMF002 (фиксированные пресеты 5/8/9/12V) ×**2** | #1 — повышает 5V→12V для питания датчика; #2 — повышает 3.7V→5V от батареи на шину (даёт стабильные 4.7V при отключении адаптера, без него ESP32 уходит в brownout на рывках WiFi) |
| 4 | TP4056 Type-C с защитой DW01A | Зарядка аккумулятора 18650 |
| 5 | Диод Шоттки 1N5819 ×**2** | Diode-OR load sharing: Schottky_A от адаптера, Schottky_B от boost#2 — на общую шину ~4.7V |
| 6 | Аккумулятор 18650 LG HG2 (INR18650HG2) 3000 мАч ×2 | Резервное питание (параллельно, суммарно 6000 мАч) |
| 7 | Холдер 18650 (1 слот) ×2 | Установка батарей (соединение параллельно) |
| 8 | Резисторы 10kΩ ×4 | Сигнальный делитель: **нижнее** плечо + **верхнее** плечо, 1-й резистор в серии. Собирается **один** делитель (скорость), на него нужно 2 шт; остальные 2 куплены под второй делитель для направления и лежат в запасе |
| 9 | Резисторы 5kΩ ×2 | **Верхнее** плечо сигнального делителя, 2-й резистор в серии (10k+5k = 15k; 5V → 2.0V, чистая линейная зона ADC). Отдельного 15kΩ в наборе нет. Нужен 1 шт, второй — запас |
| 10 | Резисторы 100kΩ ×2 | Делитель для мониторинга напряжения батареи на GPIO32 |
| 11 | Резисторы 220Ω ×5 | Токоограничение для LED |
| 12 | Керамический конденсатор 100 нФ ×4 | Фильтр ADC-входа скорости (×1), VIN (×1), батарейный делитель (×1). Четвёртый — запас, он предназначался второму ADC-входу (направление) |
| 13 | Электролитический конденсатор 1000 мкФ **16V** (или 10V как минимум) ×1 | Буфер на шине ~4.7V (гасит просадки при старте WiFi). **16V рекомендован** вместо 10V: защищает от случайной ошибки, если boost #2 настроен на 12V вместо 5V (10V версия в таком случае вздуется). Предпочтителен рейтинг 105°C. |
| 14 | **Клавиша KCD4, 250 В / 16 А, 4 контакта** (куплена 2026-09-13) | Главный выключатель станции, **на ДВА полюса** (DPST): полюс A рвёт `OUT+` TP4056 (до 1.83 А), полюс B — шину сразу за диодным ИЛИ (~0.2 А). Два полюса нужны потому, что в шину входят два независимых источника, и одним полюсом «выключено» получается только наполовину. Схема — `wiring-v9.html`, монтаж и прозвонка — задача 11. ⚠️ Перед установкой **прозвонить**: четыре контакта бывают и у SPST с подсветкой |
| 14a | Тумблер мини SPDT (~6A/125VAC) | Прежний главный выключатель. Остаётся в запасе: если купленный KCD4 окажется однополюсным с подсветкой, KCD4 ставится на полюс B, а этот — на полюс A. Схему это не меняет |
| 14b | PTC-предохранитель 2A radial самовосстанавливающийся (жёлтый дисковый TAIWAN) | Защита батарейной линии от КЗ (заменяет SMD «N») |
| 15 | LED зелёный 5мм ×2 | Заряд батареи >60% + WiFi (горит, пока станция кому-то доступна) |
| 16 | LED жёлтый 5мм ×1 | Средний ветер (>5 м/с) или заряд 30–60% |
| 17 | LED красный 5мм ×2 | Сильный ветер / низкий заряд (мигает при <10%) + ошибка |
| 18 | Breadboard 830 точек (165×55 мм) | Сборка без пайки |
| 19 | Провода dupont м-м 40 шт | Соединения на breadboard |
| 20 | Провода dupont м-ж 40 шт | Подключение модулей и LED |
| 21 | Корпус IP65 190×150×75 мм | Защита от влаги. ⚠️ Купленный экземпляр **глухой/чёрный, крышка непрозрачная** — исходный план «светодиоды видно через крышку» не сработал, светить придётся наружу или смотреть по дашборду |
| 22 | Гермовводы PG7 ×2 | Ввод кабелей в корпус |
| 23 | Адаптер 5V 2A (USB Type-C) | Основное питание от сети |
| 24 | Мультиметр | Опциональная проверка 12V на выходе boost-модуля |
| 25 | Силикагель (пакетик) | От конденсата в корпусе |

### Планируется для задачи 10 (4G/GPS) — ещё не в сборке

Ничего из этого блока в станции пока не стоит, но **докупать тоже нечего**: после перехода
на компоновку v6 «Компакт-1» весь список закрывается тем, что уже в хозяйстве. Расчёты, из
которых он получен, лежат в `tasks/10-a7670e-4g-gps.md`, §Питание. Позиция 30 не добавляется,
а **заменяет** уже стоящее (PPTC вместо позиции 14b).

| # | Компонент | Наличие | Назначение и почему именно такой |
|---|---|---|---|
| 26 | Плата BK-A7670 V1 (SIMCom A7670E) + плёночная LTE-антенна + патч GPS 1575 МГц | ✅ на руках | 4G-аплинк и координаты. Антенны подключены к J1/J2. Гребёнка CN101 распаяна — паять не нужно. ⚠️ **Штыри торчат со стороны наклейки**, поэтому на макетку модуль ложится наклейкой вниз, а micro-USB после посадки недоступен |
| 27 | Mini Boost MT3608 **№3** | ✅ есть | Отдельный источник 5.2 В для VCC модуля. Шина станции 4.7 В ниже минимума платы (5 В), буст №1 на 12 В — выше максимума |
| 29 | Электролит 1000 мкФ **≥10 В** ×1 | ✅ есть | C4 — в колонки 40/41 макетки, два ряда от контакта VCC модема. **Та же деталь, что позиция 13** (C1 на шине). Штатный тантал 470 мкФ на плате стоит **после** линейного стабилизатора и входную просадку не держит. Корпус ⌀8 мм удобнее ⌀10: рядом стоит C1 |
| 30 | PTC-предохранитель **3 А** radial (замена позиции 14b) | ✅ есть | Пик на разряженной банке ~1.83 А: модем 1.50 А + станция 0.33 А. Двухамперный работал бы на границе срабатывания — а его в июле уже вышибало |
| 32 | P-канальный MOSFET (high-side ключ) + обвязка затвора, на GPIO33 | ⏳ перед мачтой | Снятие питания с модема. PWRKEY прижат к земле через R104, а выход из CMUX у A7670 сломан — повисший модем поднять больше нечем. **Пока плата в руках, вместо ключа стоит перемычка → B3 IN+** (`49j` на схеме v6, после переноса SW1 — `51h`, схема v7). В v6 у него вторая работа: между сеансами он снимает нагрузку с зарядного узла |

> ⚠️ **Ключ обязан быть логического уровня.** `Rds(on)` в даташите должен нормироваться при
> `Vgs = −4.5 В` (годятся AO3401A, IRLML6402, NDP6020P); обычный IRF9540 нормируется при −10 В
> и на наших 4.2 В будет полуоткрыт и горяч. Кроме транзистора нужны **подтяжка 100 кΩ
> затвор→исток** (иначе при сбросе ESP32 состояние ключа неопределённое) и **NPN/N-FET снизу**,
> который тянет затвор к земле по GPIO33 — напрямую с 3.3 В логики верхний ключ не закрывается.
> Логика при этом инвертируется: **GPIO33 HIGH = модем включён**.

> ⚠️ **Вместе с ключом поставить резистор 1 кΩ последовательно в GPIO27 → `R` модема.**
> Сейчас он не нужен: ESP32 и модем включаются и выключаются вместе, и линия UART
> никогда не оказывается под напряжением у обесточенного соседа. Ключ это меняет —
> он выключает модем, **пока ESP32 работает**, и тогда GPIO27, стоящий в высоком уровне
> покоя UART, начинает кормить вход `RXD` обесточенного модуля через его собственный
> защитный диод на шину питания. Ток мелкий, но постоянный, и это худший вид поломки:
> не мгновенная, а накопительная, и проявится она молчащим модемом через месяц на мачте.
> Резистор ограничивает ток и ничего не стоит, а на 115200 не мешает совершенно.
> Второй провод (GPIO25 ← `T`) в такой защите не нуждается: там источник — обесточенный
> модем, то есть источника нет.

> **Как это подключается:** разводка блока нарисована в **`wiring-v7.html`** (модуль воткнут
> штырями прямо в ряд `a`, кол. 36–42, буст №3 кормится только с `OUT+` TP4056, UART
> на GPIO27/25 приходит в колонки 37/38 — на 38-pin передача уехала с GPIO26 на GPIO27). С макетки уходят **три** провода — `51h`, `45i`
> и один обратно в колонку 40 (5.2 В); земля модема — **перемычка `41b` → `44b`** на самой
> макетке (обоснование — в задаче 10, §Питание). Правок существующей платы две:
> **C1 переезжает с 39/41 на 43/44** и **SW1 уходит в разрыв `OUT+`** (задача 11) — из-за
> второй вход блока модема и берётся с `51h`, а не с `49j`, как было в v6.
> `wiring-v6.html` — «как собрано сейчас», без переноса тумблера; ещё более ранний вариант
> (модем на весу, своё диодное ИЛИ на двух Шоттки 3 А) лежит в `wiring-v5.html`
> и к исполнению не берётся. **Актуальная схема — `wiring-v8.html`**: она отличается
> от v7 только платой контроллера (38-pin вместо 30-pin) и сдвигом всего, что правее
> колонки 15. Блок модема в ней не тронут ни одним проводом.
>
> ⚠️ **Контакты CN101 опознаются по буквам, а не по номерам** — цифр у пятаков на плате нет.
> Вдоль ребра идут `S`·`G`·`V`·`K`·`T`·`R`·`G`, и вторая `G` стоит вплотную к **micro-USB**.
> Модуль лежит наклейкой вниз, поэтому вдоль колонок это читается от разъёма: кол.36 = `G`
> (контакт 7), 37 = `R` (RXD), 38 = `T` (TXD), 39 = `K` (PWRKEY), 40 = `V` (VCC), 41 = `G`
> (контакт 2), 42 = `S` (SLEEP). Перепутанные концы = 5.2 В на TXD модуля.
>
> **Что выпало из этого списка при переходе на v6:** гнездовая планка PLS-7 (штыри идут прямо
> в отверстия макетки), два Шоттки 3 А (SS34 / 1N5822 / SR340), адаптер 5 В 3 А либо Rprog
> 2.4 кΩ и стойка M2. Диодного ИЛИ у модема больше нет, а заряд идёт своим током — штатного
> адаптера 2 А (позиция 23) хватает. Цена решения: **без установленной банки модем
> не заводится**, TP4056 в одиночку пик 1.5 А не отдаст. Разбор — в
> `tasks/10-a7670e-4g-gps.md`, §Топология.
>
> **Почему НЕ YX-850:** рассматривался как альтернатива связке TP4056 + диод Шоттки, но не нужен — diode-OR c двух Schottky дешевле и универсальнее. Вычеркнут из списка.
>
> **Почему два boost-модуля:** первый повышает шину 5V до 12V для сенсора (как раньше). Второй поднимает напряжение батареи 3.7V до 5V, чтобы при отключении адаптера шина оставалась в районе 4.7V — это обязательно, потому что у AMS1117 на ESP32 dropout 0.8–1.25V, и из 3.4V (батарея минус диод) регулятор не выдаёт стабильные 3.3V, ESP32 падает в brownout на пиках WiFi (500 мА).

---

## Блок-схема питания и сигналов

```mermaid
flowchart TB
    ADAPTER[Адаптер 5V 2A от розетки]
    SCHOTTKY_A[Schottky_A 1N5819]
    TP[TP4056<br/>зарядка 18650]
    PTC[F1 · PTC-предохранитель 3A<br/>позиция 30, замена двухамперного]
    BAT[2× LG HG2 18650<br/>параллельно — 3.6V / 6000 мАч]
    BOOST2[Mini Boost #2<br/>пресет 5V от батареи]
    KEY[Ключ GPIO33<br/>сейчас перемычка 49j]
    BOOST3[Mini Boost #3<br/>пресет 5.2V]
    MODEM[BK-A7670 4G/GPS<br/>до 1.5 А на передаче]
    SCHOTTKY_B[Schottky_B 1N5819]
    RAIL[Шина питания ~4.7V<br/>буфер 1000 мкФ]
    SW[Тумблер I/O<br/>главный выключатель]
    MT[Mini Boost Module #1<br/>пресет 12V]
    ESP[ESP32 DevKitC 38-pin<br/>модуль ESP-32U · пин VIN]
    SENSOR[Датчик ветра 0–30 м/с<br/>выход 0-5V, только скорость]
    DIV1[Делитель 10k+5k / 10k<br/>канал скорости + 100нФ]
    BATDIV[Делитель 100k+100k<br/>мониторинг батареи]
    LEDS[5 светодиодов<br/>через резисторы 220Ω]
    ANT_LTE[Антенна LTE<br/>снаружи корпуса]
    ANT_GPS[Патч GPS 1575 МГц<br/>снаружи, иначе фикса нет]
    WIFI[WiFi роутер]
    TV[Android TV<br/>+ монитор HDMI]
    BROKER[Сеть оператора<br/>брокер MQTT, TLS 8883]

    ADAPTER --> SCHOTTKY_A
    SCHOTTKY_A --> RAIL
    ADAPTER -.зарядка.-> TP
    TP <-->|B+ через PTC · заряд и разряд по одному проводу| PTC
    PTC <--> BAT
    TP -->|OUT+ · кол.49| BOOST2
    TP -->|OUT+ · тот же узел, кол.49| KEY
    KEY --> BOOST3
    BOOST3 -->|5.2V| MODEM
    BOOST2 --> SCHOTTKY_B
    SCHOTTKY_B --> RAIL
    RAIL --> SW
    SW --> ESP
    SW --> MT
    MT -->|12V питание| SENSOR
    SENSOR -->|скорость 0-5V| DIV1
    DIV1 -->|0-2.0V| ESP
    BAT --> BATDIV
    BATDIV -->|0-2.1V на GPIO32| ESP
    TP -.CHRG + STDBY, катоды LED, LOW=активно.-> ESP
    ESP --> LEDS
    ESP <-->|UART 115200 · GPIO27 в R, GPIO25 из T| MODEM
    MODEM --- ANT_LTE
    MODEM --- ANT_GPS
    MODEM <-->|PPP · маршрут по умолчанию на мачте| BROKER
    ESP <-->|HTTP / JSON / mDNS| WIFI
    WIFI <--> TV

    style SW stroke:#c0392b,stroke-width:3px
    style BOOST2 stroke:#c0392b,stroke-width:3px
    style BOOST3 stroke:#c0392b,stroke-width:3px
```

⚠️ **Обе антенны модема обязаны быть снаружи глухого бокса, и это не перестраховка.**
Патч GPS в помещении давал 5 спутников с SNR 9–30 и ни одного фикса; на подоконнике —
14–36; на улице — 8 спутников с SNR 33–46 и фикс за 15 секунд. Разница +10…25 дБ,
стенка IP65 съедает её целиком. LTE-антенна выносится по другой причине: сеть регулярно
садится на **band 7 (2500–2570 МГц)**, то есть вплотную к 2.4 ГГц — антенну модема
и антенну ESP32 разносить, а не класть рядом.

⚠️ **Красным обведено то, что выключатель не выключает.** SW1 стоит **после** диодного ИЛИ,
на входе нагрузочного рельса, поэтому рвёт он только ESP32 и Boost#1 (12 В на датчик).
Boost#2 и Boost#3 подключены прямо к `OUT+` TP4056 — **выше по течению**, и в положении O
продолжают тянуть из банки: холостой ход обоих MT3608 плюс модем целиком (20–30 мА в покое,
до ~0.65 А на LTE). Именно это высадило банку в ноль за один вечер тестов 4G 2026-08-16.

Два следствия, пока тумблер не переехал:

- **«Выключено» не значит выключено.** Станция в тумбочке разряжается; на хранение — вынимать
  банки или адаптер.
- **Терминация заряда не срабатывает.** Ток модема идёт через тот же узел `OUT+` и постоянно
  перекрывает порог окончания заряда (~1/10 Iprog), поэтому STDBY не загорается и
  `chargeState` не доходит до `"full"`.

Лечится переносом выключателя в разрыв `OUT+` — **`tasks/11-power-switch-and-charge-path.md`**.
Важно, что при переносе за тумблер уходят **оба** отвода с колонки 49: `49i`→`55c` (Boost#2)
и `49j`→ключ (Boost#3). Перенести один — значит оставить под питанием половину того, ради
чего всё затевалось.

**И одного полюса всё равно мало.** В шину входят ДВА независимых источника: адаптер через
`D1` и батарея через Boost#2 и `D2`. Полюс в разрыве `OUT+` стоит только в батарейной ветке,
поэтому при воткнутом адаптере `D1` продолжает кормить шину — «выключено» означает
«выключено наполовину», и заряд по-прежнему идёт под нагрузкой ESP32. Поэтому с 2026-09-13
выключатель — **клавиша KCD4 на два полюса** (позиция 14 BOM), и второй полюс рвёт саму
шину сразу за диодным ИЛИ: `39j` → `B1`, `B2` → нижний «+» рельс, кол.43. Схема — `wiring-v9.html`.

**Четыре состояния клавиши:**

| Клавиша | Адаптер | Что происходит |
|---|---|---|
| ON | есть | рабочий режим. ⚠️ Boost#2 (5.14 В) **перебивает** адаптер (5.0 − 0.35 на `D1` = 4.65 В), то есть станция ест из банки, пока TP4056 её заряжает, и честно рапортует `powerSource: battery` |
| **OFF** | **есть** | **всё обесточено полностью, TP4056 заряжает банку вчистую.** Единственный режим, в котором терминация заряда срабатывает и `chargeState` доходит до `"full"` |
| OFF | нет | всё мертво, разряда ноль — режим хранения |
| ON | нет | автономный режим, как на мачте |

⛔ **Вторая строка работает только после того, как припаяна перемычка от платы с диодом
до `IN+` TP4056** (долг задачи 10, шаг 17). Пока её нет, адаптер до зарядного не доходит
вовсе, банка не заряжается ни при каком положении клавиши, а `powerSource` намертво `battery`.

⚠️ **Питание платы в схеме v9 идёт СПРАВА НАЛЕВО.** Цепь: кол.43 низ → связка «+» кол.58
(верх↔низ) → верхний «+» правый → `61a` (IN+ Boost#1) и параллельно мост `31↔32` через
разрез рельса → верхний «+» левый → кол.3 → по диагонали в `1a` («5V»). **Мост `31↔32`
стал единственной точкой отказа ESP32**: отойдёт — плата умрёт, а датчик на 12 В останется
живым, и симптом прочитается как «ESP32 сдох», а не как «нет питания». Взамен исчез провод
`39g` → кол.16 длиной около 40 см поперёк всей макетки.

**Поток питания в целевой схеме v9** (`ADAPTER` и `BAT` — те же источники, что на большой
диаграмме выше; здесь показано только то, что меняет задача 11):

```mermaid
flowchart LR
    ADAPTER[Адаптер 5 В] --> D1[D1 · 1N5819]
    ADAPTER -.перемычка 37f-50b<br/>НЕ ПРИПАЯНА.-> TP[TP4056]
    BAT[2× 18650] <-->|F1 · PTC 3 А| TP
    TP -->|OUT+ · 49j| A1(["полюс A"])
    A1 -->|51j| NODE51[узел кол.51]
    NODE51 -->|51i| BOOST2[Boost#2 · 5.14 В]
    NODE51 -->|51h| KEY[Ключ GPIO33] --> BOOST3[Boost#3 · 5.2 В] --> MODEM[Модем A7670E]
    BOOST2 --> D2[D2 · 1N5819]
    D1 --> BUS[узел ШИНА · кол.39<br/>катоды D1 и D2]
    D2 --> BUS
    BUS -->|39j| B1(["полюс B"])
    B1 -->|"«+» низ кол.43"| RAILB["«+» LOAD низ"]
    RAILB -->|связка кол.58| RAILT["«+» LOAD верх"]
    RAILT -->|61a| MT[Boost#1 · 12 В] --> SENSOR[Датчик ветра]
    RAILT -->|"мост 31↔32 → кол.3 → 1a"| ESP[ESP32 · пин 5V]
    A1 -.клавиша одна.-> B1

    style A1 stroke:#c0392b,stroke-width:3px
    style B1 stroke:#c0392b,stroke-width:3px
    style RAILT stroke:#c0392b,stroke-width:3px
```

Читается это так: **полюс A снимает питание с обоих бустов и модема, полюс B — со всей
шины**, включая ту её половину, которую кормит адаптер. Пунктир между полюсами — не провод,
а механическая сцепка: клавиша одна.

**Почему diode-OR с двумя Schottky, а не один диод:**

Один диод между TP4056 OUT+ и шиной (старая схема) оставлял шину на 3.4V при отключённом адаптере (батарея 3.7V − 0.35V на диоде). Для AMS1117 ESP32 это ниже dropout 0.8–1.25V ([datasheet](http://www.advanced-monolithic.com/pdf/ds1117.pdf)) — регулятор уже не держит 3.3V под нагрузкой, и любой пик WiFi TX (500 мА) роняет 3V3 ниже порога brownout ESP32 (2.43V).

Новая схема (diode-OR):
- **Адаптер → Schottky_A → шина** — адаптер в работе, шина 5V − 0.35V ≈ **4.7V**
- **Battery → PTC → TP4056 → OUT+ → Mini Boost #2 (пресет 5V) → Schottky_B → шина** — при отключении адаптера boost поднимает 3.7V до 5V, далее через диод: шина остаётся ≈ **4.7V**
- Оба Schottky смотрят катодами на одну и ту же шину; выигрывает источник с большим напряжением, другой закрыт
- AMS1117 на 4.7V VIN с dropout до 1.25V → 3.45V выхода с запасом 0.15V к минимуму 3.3V (под пики WiFi TX этого достаточно плюс буферный электролит 1000 мкФ)

Батарея изолирована от перезаряда: TP4056 работает штатно (IN+ получает 5V с адаптера, B+ подключён к ячейке через PTC, OUT+ замкнут на вход boost#2). Boost#2 не «утекает» в батарею — у него ноль обратной проводимости.

---

## Распиновка ESP32

> **Плата — 38-pin DevKitC (модуль ESP-32U), с 2026-09-06.** Номера GPIO и их назначение
> от смены платы **не изменились ни одним пином**: набор 38-pin — надмножество 30-pin,
> прошивка и FQBN те же. Изменились только колонки макетки: плата занимает **1–19**
> вместо 1–15. Разводка — `wiring-v8.html`, карта колонок ниже.

| Пин ESP32 | Подключение | Назначение |
|---|---|---|
| VIN (5V) | Шина питания | Основное питание платы |
| GND | Общая земля | — |
| GPIO34 (ADC1) | Выход делителя (10k+5k)/10k — скорость | Чтение скорости ветра (0–2.0V) |
| GPIO35 (ADC1) | **Не подключён** — висит в воздухе | Был каналом направления у старого датчика. У нынешнего направления нет, в прошивке `HAS_DIRECTION 0`. Пин зарезервирован на случай возврата старого датчика |
| GPIO32 (ADC1) | Делитель 100k/100k от батареи | Мониторинг напряжения батареи |
| GPIO4  | 220Ω (на плате) → анод LED на крышке | Красный — ветер > 15 м/с или заряд 10–30%; мигает при заряде <10% |
| GPIO16 | 220Ω (на плате) → анод LED на крышке | Жёлтый — ветер > 5 м/с или заряд 30–60% |
| GPIO17 | 220Ω (на плате) → анод LED на крышке | Зелёный — заряд батареи > 60% |
| GPIO5  | 220Ω (на плате) → анод LED на крышке | Зелёный — WiFi: **горит, когда станция кому-то доступна** (клиент на точке ИЛИ домашняя сеть), мигает, когда ни того ни другого (strapping-пин, кратко мигает при загрузке) |
| GPIO18 | 220Ω (на плате) → анод LED на крышке | Красный — ошибка ADC или WiFi |
| GPIO13 | Катод индикаторного LED TP4056 (CHRG), напрямую | Идёт заряд батареи (активный LOW) |
| GPIO19 | Катод второго LED TP4056 (STDBY), напрямую | Заряд завершён (активный LOW); вместе с GPIO13 даёт «от сети / от батареи» |
| GPIO27 | Колонка **37** макетки (буква `R` на модуле A7670E) | UART2 TX → **RXD** модема. Буквы через линк намеренно не совпадают. На 30-pin здесь был GPIO26 — на 38-pin косичка легла иначе |
| GPIO25 | Колонка **38** макетки (буква `T` на модуле A7670E) | UART2 RX ← **TXD** модема. В прошивке включается флагом `HAS_MODEM` |
| GPIO23 | Провод на дисплей CYD (ESP32-2432S028), разъём **CN1, контакт IO27** | UART1 TX → дисплей, JSON-кадр `/api/data` строкой 5 раз в секунду, 115200 8N1. Только передача, ответа нет. Флаг `HAS_DISPLAY_LINK`. Разбор — `DISPLAY.md` |
| GPIO26 | **Не подключён** — лежит между двумя проводами UART | Освободился при переезде на 38-pin. ⚠️ Втыкать в него ничего нельзя: пара UART разъедется, и молчащий модем будет выглядеть как дохлый |
| GPIO33 | **Пока не подключён** — зарезервирован под затвор P-FET, питание модема | Ключ снятия питания с модема (позиция 32). Сейчас вместо ключа стоит перемычка на вход буста №3, то есть модем запитан всегда. **HIGH = модем включён** — логика инвертируется нижним N-транзистором в обвязке затвора. Пока плата в руках, это неудобство; на мачте — единственный способ поднять зависший модем, потому что PWRKEY прижат к земле через R104, а выход из CMUX у A7670 сломан. ⚠️ Ставится **вместе** с резистором 1 кΩ в GPIO27 → `R` |

### Куда сели пины на макетке (плата 38-pin, схема v8)

Плата садится штырями в ряды `a` (верхний ряд пинов) и `j` (нижний), занимая колонки **1–19**.
Отсчёт от USB-C, который смотрит за край макетки.

| Пин | Колонка v8 | Было на 30-pin | Что подключено |
|---|---|---|---|
| 5V (VIN) | **1a** | 1a | «+» LOAD верхнего рельса. Сам пин не уехал, но перемычка от него идёт **по диагонали в кол.3** — см. ниже |
| CLK · D0 · D1 | 1j–3j | *не выведены* | ⛔ **SPI-флеш, держать пустыми** |
| CMD · D3 · D2 | 2a–4a | *не выведены* | ⛔ **SPI-флеш, держать пустыми** |
| GPIO13 (CHRG) | **5a** | 3a | катод CHRG на TP4056 |
| GND | **6a** | 2a | «−» верхнего рельса. Опора АЦП считается относительно **этого** вывода |
| GPIO4 · 16 · 17 · 5 · 18 | **7j…11j** | 5j…9j | пять светодиодов через резисторы 220 Ω |
| GPIO27 / GPIO25 | **9a / 11a** | 7a / 8a (было 26/25) | UART2 к модему (кол.37 / кол.38 макетки) |
| GPIO26 | 10a | — | ⚠️ свободен и лежит **между** проводами UART — не занимать |
| GPIO19 (STDBY) | **12j** | 10j | катод STDBY на TP4056 |
| GPIO33 | **12a** | 9a | затвор ключа питания модема (пока не установлен) |
| GPIO32 | **13a** | 10a | делитель батареи 100k/100k |
| GPIO35 | 14a | 11a | не подключён |
| GPIO34 | **15a** | 12a | делитель датчика (10k+5k)/10k |
| GPIO23 | **18j** | — | провод на дисплей CYD, CN1 IO27 (сосед слева `17j` = GPIO22, справа `19j` = GND) |
| 3V3 | **19a** | *первый в нижнем ряду* | сменил сторону платы; сейчас не разведён |

⚠️ **Рельсы этой макетки короче банка на две колонки с каждой стороны.** Полосы «+»/«−»
идут только от **колонки 3** до **колонки 61**, а ряды `a`…`j` — от 1 до 63. Плата села
от самой первой колонки, поэтому прямо над её «5V» отверстия «+» просто нет: перемычка
идёт **по диагонали**, `1a` → «+» верх, колонка 3. Электрически это ничего не меняет —
полурельс одна цепь по всей длине, важно попасть в цепь, а не в конкретное отверстие.
Тот же случай на правом краю: **Boost#1 IN− сидит в `62a`**, и его перемычка тоже
наискосок, в колонку 61.

⛔ **Шесть контактов SPI-флеша — главная ловушка новой платы.** На 30-pin GPIO6–11 просто
не были выведены. Здесь они есть: снизу `CLK · D0 · D1` (колонки 1–3), сверху `CMD · D3 · D2`
(колонки 2–4). Это ноги кристалла флеша, а не свободные GPIO: **одна перемычка в любую
из них — и плата не загружается вообще**, молча, без сообщения в Serial. Колонки 1–4
держать пустыми. По этой же причине посадка «+» LOAD переехала с колонки 4 на **колонку 16**:
провод там читался бы ровно как такая перемычка.

Три перестановки, которыми оплачены четыре лишние колонки на уже полной макетке:
связки рельсов **16/17 → 20/21**, C2 воткнут **прямо в рельсы** (кол.18 «+» и 19 «−»,
по диагонали, две перемычки к нему исчезли), светодиодные резисторы уплотнились с шага
4 колонки до **3** и встали в полосу **22–36**. Колонки 20 и 21 нижнего банка остаются
**пустыми** — через них проходят связки рельсов.

**Важно:** GPIO32, 34, 35 — это пины ADC1 (34/35 input-only). ADC2 (GPIO 0, 2, 4, 12–15, 25–27) **не работает одновременно с WiFi**, поэтому все аналоговые входы используем только на ADC1 (GPIO32–39).

GPIO13 формально относится к ADC2, но здесь он работает **цифровым входом** — запрет ADC2 касается только аналогового чтения при активном WiFi, цифровые вход/выход на этих пинах разрешены. По той же причине светодиод «ветер >15» стоит на **GPIO4** (тоже ADC2), а он работает **цифровым выходом** — это допустимо. **GPIO5 — strapping-пин** (должен быть HIGH при загрузке): светодиод на землю через 220 Ω не удерживает его в 0, поэтому лишь кратко мигает при включении. Назначен на WiFi-индикатор, который до подключения к сети и так погашен — безвредно.

**GPIO25/27 (UART модема) — тоже ADC2**, и по той же причине это допустимо: они работают как UART, а не как аналоговые входы. Отдельная ловушка не в ADC2, а в другом: **`Serial2` по умолчанию сидит на GPIO16/17, то есть на жёлтом и зелёном светодиодах**. В прошивке пины передаются в `Serial2.begin()` явно — с умолчаниями AT-команды пошли бы в светодиодную панель.

### Индикация заряда: CHRG / STDBY

**Отдельных пятачков `CHRG` и `STDBY` на модуле TP4056 нет** — наружу выведены только `IN+/IN−`, `B+/B−`, `OUT+/OUT−` (см. раздел про TP4056 в `tasks/04-power-rail.md`). Сигнал снимается **с катода индикаторного светодиода**; катодная площадка крупнее ножки микросхемы, паять к ней удобнее.

⚠️ **Какой светодиод есть какой — проверить на своей плате, не полагаться на цвет.** Распайка отличается между партиями. Проверка занимает секунду: вставь батарею и воткни зарядку — светодиод, который загорится и погаснет по окончании заряда, и есть `CHRG`; второй — `STDBY`.

**Делители не нужны, дополнительных деталей в BOM не добавляется.** Выводы `CHRG`/`STDBY` — открытый сток: при активном состоянии микросхема сажает узел на землю, в покое вывод в высокоимпедансном состоянии. Прошивка поднимает пин внутренней подтяжкой (`INPUT_PULLUP`), и уровни получаются полными: ~0.1 В активно, ~3.3 В в покое.

Делитель на землю здесь **применять нельзя**. В покое узел катода подтягивается через светодиод от 5 В и садится нагрузкой делителя примерно до 3.1 В; делитель 10k/15k даёт на пине 1.2–1.9 В — это между `Vil` (0.83 В) и `Vih` (2.48 В), то есть запрещённая зона, состояние будет плавать. Если нужна защита входа — ставится **последовательный** резистор 10 кΩ, но не делитель.

**Диагностика:** мультиметр между выбранным GPIO и землёй. Идёт заряд — около **0 В**; заряд закончен или зарядка не подключена — около **3.3 В**. Если при снятой батарее показания дёргаются примерно раз в секунду, это нормально: TP4056 без банки циклит индикацию.

#### Откуда берётся `powerSource` — почему отдельный съём с `IN+` не нужен

TP4056 способен посадить `CHRG` или `STDBY` к земле **только когда на его собственном входе есть питание** — активный вывод питается от той же шины `IN+`. Значит, обратное тоже верно: если обе линии в покое, на входе питания нет, и станция живёт от банок.

| `CHRG` | `STDBY` | `chargeState` | `powerSource` |
|---|---|---|---|
| активен (0 В) | покой | `charging` | `external` |
| покой | активен (0 В) | `full` | `external` |
| покой | покой | `discharging` | `battery` |

Поэтому **отдельный провод на `IN+` с делителем 100k/100k не ставится**: те же два состояния уже читаются с линий, которые всё равно заводятся ради индикации заряда. Экономия — один вывод ADC, два резистора и пайка к занятому пятачку.

**Оба провода обязательны.** По одному `CHRG` источник питания не определяется: линия уходит в покой и когда зарядка окончена, и когда шнур выдернут — состояния неразличимы. Прошивочный флаг `HAS_STDBY` переведён в `1`; пока `STDBY` физически не припаян, станция будет постоянно показывать `discharging` / «от батареи» — это не сбой, а отсутствие сигнала.

**Дребезг гасится в прошивке, RC-цепочки не нужны.** Без установленной банки TP4056 перекидывается между зарядом и standby примерно раз в секунду, и в момент переключения обе линии успевают побыть в покое. Прошивка опрашивает пины каждые 100 мс и **держит состояние ещё 3 с после пропадания сигнала** (`STATUS_HOLD_MS`) — надпись на дашборде не мигает, но выдернутый шнур замечается за пару секунд. Опрос вынесен отдельно от `readBattery()`: тот вызывается раз в 30 с и попадал бы в случайную фазу мигания.

**Про ADC 2.0V, а не 3.0V/3.3V:** делитель **(10k+5k)+10k** (верхнее плечо 15k собрано из 10k+5k последовательно) снижает 5V до 2.0V. Это сознательно ниже 3.3V, потому что ESP32 ADC при 11dB аттенюации **чисто линеен только в 150 мВ … 2.45V** ([ESP32 Forum](https://esp32.com/viewtopic.php?t=2881), [Arduino-ESP32 docs](https://docs.espressif.com/projects/arduino-esp32/en/latest/api/adc.html)); от 2.45V до 3.10V идёт нелинейная зона, которую factory two-point eFuse калибровка **не компенсирует полностью**, выше 3.10V — насыщение. Обратный вариант (большее плечо 10k+5k снизу, 10k сверху) давал бы 3.0V при 5V и заходил в нелинейную зону: на скоростях ветра >49 м/с показания занижались на 5–15%. Текущий (10k+5k)+10k даёт 0–2.0V — весь диапазон датчика 0–30 м/с в чистой линейной зоне, с запасом и на старый 0–60, если он когда-нибудь вернётся.

Прошивка использует `analogReadMilliVolts()` — функция применяет eFuse-калибровку и выдаёт мВ. Реальная точность в DIY-условиях (наводки на длинный кабель, температурный дрейф) — **±50–100 мВ**, а не ±30 мВ, как часто пишут в туториалах.

---

## Компоновка в корпусе 190×150×75 мм

```mermaid
flowchart TB
    subgraph BOX["КОРПУС IP65  190 × 150 × 75 мм  крышка глухая"]
        direction TB
        subgraph TOP["Верхний уровень — breadboard 165×55"]
            ESP32["ESP32 DevKitC 38-pin<br/>антенна на u.FL — наружу"]
            MODEMMOD["BK-A7670 37 × 37 мм<br/>штырями в ряд a, кол. 36–42<br/>наклейкой вниз, micro-USB недоступен"]
            DIV["Делитель сигнала<br/>резисторы 10k+5k / 10k"]
            LEDROW["5 LED — наружу через отверстия<br/>на проводах dupont"]
        end
        subgraph MID["Средний уровень — модули питания"]
            TP4056MOD["TP4056 Type-C"]
            MT3608MOD1["Mini Boost #1 — пресет 12V"]
            MT3608MOD2["Mini Boost #2 — пресет 5V"]
            MT3608MOD3["Mini Boost #3 — пресет 5.2V<br/>только на модем, с OUT+ TP4056"]
            SCHOTTKYA["Schottky_A 1N5819"]
            SCHOTTKYB["Schottky_B 1N5819"]
            PTCMOD["PTC-предохранитель 3A<br/>позиция 30, замена двухамперного"]
            CAPMOD["Электролит 1000 мкФ ×2<br/>C1 на шине, C4 у VCC модема"]
        end
        subgraph BOTTOM["Нижний уровень"]
            HOLDER["2× Холдер 18650 + аккумуляторы<br/>соединены параллельно"]
            SILICA["Силикагель"]
        end
        subgraph SIDES["Боковые стенки — вводы"]
            PG1["PG7 — кабель датчика"]
            PG2["PG7 — кабель адаптера 5V"]
            ANTHOLE["Три антенны наружу:<br/>2.4 ГГц ESP32, LTE, патч GPS"]
        end
    end
    SENSOR_EXT([Датчик ветра на мачте])
    ADAPT_EXT([Адаптер 5V из розетки])
    SENSOR_EXT -.через PG7.-> PG1
    ADAPT_EXT -.через PG7.-> PG2
```

**Размещение светодиодов:** все 5 LED выносятся длинными проводами dupont м-ж к крышке или стенке корпуса — чтобы статус станции был виден снаружи без открытия.

**Модем занимает правый край макетки и греется.** Плата 37 × 37 мм садится штырями прямо
в ряд `a`, колонки 36–42, и остаётся на верхнем уровне вместе с ESP32 — не вплотную к
банкам. Причина конкретная: **U2 на плате модема — линейный стабилизатор 1084**, дросселя
нет, поэтому весь ток модуля проходит через него, а разница между входными 5.2 В и
рабочими 4.0 В сгорает в тепло. На пике это около 0.8 Вт с корпуса размером с ноготь.
Греть этим литиевые банки в глухом боксе — ровно то, чего делать не надо, и заодно
поплывут показания делителя батареи.

Три вещи, которые вытекают из посадки, а не из схемы:

- **micro-USB модуля после посадки недоступен** — он смотрит в макетку. Поэтому AT-команды
  идут через `/api/at`, а не кабелем; это не удобство, а единственный путь;
- **над модемом нужен зазор для двух пигтейлов** (LTE и GPS), а разъёмы J1/J2 стоят с той
  же стороны, что штыри. Провода уходят вверх и вбок, крышку они держать не должны;
- **выведенный наружу micro-USB как сервисный вход не планируется**: чтобы им пользоваться,
  модуль надо вынуть из макетки, а это и так вскрытие корпуса.

> ⚠️ **Крышка у купленного корпуса непрозрачная.** Исходный план «поставить LED под крышку и смотреть сквозь неё» не работает: нужны отверстия под 5-мм светодиоды с герметизацией (держатель с уплотнителем или капля прозрачного герметика), иначе IP65 теряется. Альтернатива, которая ничего не сверлит: смотреть состояние на дашборде — там те же четыре индикатора отдаются в `/api/data` полями `led*`.

---

## Делитель напряжения сигнала датчика

Сигнал датчика 0–5V нужно понизить до **0–2.0V** — это внутри чистой линейной зоны ADC ESP32 (150 мВ … 2.45V при 11dB).

```
  Сигнал датчика (0-5V)
         │
         ▼
      ┌──┴──┐
      │ 10k │  ← ВЕРХНЕЕ плечо, 1-й в серии
      └──┬──┘
      ┌──┴──┐
      │  5k │  ← ВЕРХНЕЕ плечо, 2-й в серии  (10k+5k = 15k)
      └──┬──┘
         ├─────► GPIO34 (макс 2.0V)
         ├──── 100 нФ ── GND   (фильтр шума от длинного кабеля)
      ┌──┴──┐
      │ 10k │  ← НИЖНИЙ резистор
      └──┬──┘
         │
        GND
```

**Формула:** `V_out = V_in × 10k / ((10k+5k) + 10k) = V_in × 0.4`
При V_in = 5V → V_out = **2.0V** ✓ (целиком внутри линейной зоны ADC 150 мВ – 2.45V, запас до 3.3V — большой буфер)

Инверсный коэффициент в прошивке: `((10+5)+10)/10 = 2.5` — умножаем на него напряжение с ADC, чтобы получить исходное напряжение датчика.

> **Почему именно так (большее плечо 10k+5k сверху), а не наоборот — 10k сверху + большее плечо снизу (то, что обычно советуют в туториалах):** обратный вариант давал бы 3.0V при 5V, что выходит за 2.45V — в нелинейную зону, где eFuse-калибровка не компенсирует ошибку. На скоростях >49 м/с (= 0.6 × 5V × 2.45/3 / делимое) показания занижались на 5–15%. Для метеостанции с потенциально ураганным ветром (>49 м/с это шторм 7 по Бофорту) это критично.

Делитель нужен **один** — канал скорости на GPIO34. У нынешнего датчика второго выхода нет, и в прошивке стоит `HAS_DIRECTION 0`, поэтому делитель направления не собирается, а GPIO35 остаётся не подключённым. Конденсатор 100 нФ на выходе делителя между GPIO34 и GND — фильтр высокочастотных наводок с длинного кабеля от мачты.

> Комплекты резисторов в BOM (10kΩ ×4, 5kΩ ×2) и конденсаторов посчитаны на **два** делителя — так покупалось под старый датчик с направлением. Уменьшать закупку смысла нет: лишние резисторы уже лежат, и второй делитель собирается за пять минут, если старый датчик вернётся.

---

## Делитель для мониторинга батареи

Напряжение батареи 3.0–4.2V нужно понизить, чтобы ADC ESP32 мог его читать (предел линейной зоны ~2.45V).

```
   Батарея (+) ─── PTC 2A ──── шина 3.7V
                                   │
                                ┌──┴──┐
                                │ 100k│
                                └──┬──┘
                                   ├──► GPIO32
                                   ├── 100 нФ ── GND
                                ┌──┴──┐
                                │ 100k│
                                └──┬──┘
                                  GND
```

**Формула:** `V_bat = V_adc × 2.0` (делитель 1:2)
При батарее 4.2V → на GPIO32 будет 2.1V (чистый линейный диапазон).

Прошивка пересчитывает в проценты: **3.5V = 0%**, 4.2V = 100%. 3.5V, а не 2.4V (предел защиты DW01A) — потому что при батарее ниже 3.5V Mini Boost #2 начинает терять регулировку (минимальное входное ≈ 2.0V по datasheet чипа MT3608, но при 3.5V запас для подъёма в 5V быстро тает), шина просаживается ниже 4.3V и AMS1117 на ESP32 выходит из регулировки. Индикатор коррелирует с реальным моментом, когда станция становится нестабильной, а не с теоретическим пределом ячейки (2.4V у DW01A).

**Почему 100k + 100k (большие резисторы):** через делитель постоянно течёт ток `V/(R1+R2) = 3.7V / 200k = 18.5 мкА` — на порядок меньше, чем через сигнальный делитель (10k+5k)+10k (при 5V это `5V/25k = 200 мкА`). За сутки расход `18.5 мкА × 24 ч = 0.44 мАч` — абсолютно ничтожно для батареи 5000 мАч.

---

## Фильтры по питанию

Помимо конденсаторов на делителях, добавь ещё два по питанию:

| Конденсатор | Где ставить | Зачем |
|---|---|---|
| **1000 мкФ 16V электролит** (или 10V как минимум) | на шину ~4.7V breadboard, «плюсом» к шине, «минусом» к GND | гасит просадки при рывке тока на старте WiFi (ESP32 может кратковременно потреблять 500–800 мА). 16V рекомендован: защита от ошибки пресета boost #2. Рейтинг 105°C предпочтителен (долгая жизнь в тёплом корпусе). |
| **100 нФ керамика** | как можно ближе к пинам VIN/GND ESP32 | фильтр высокочастотных помех, стабилизирует LDO на плате |

Обязательно соблюдай полярность электролита — длинная ножка `+`, полоска на корпусе указывает на минус.

---

## USB-Serial драйвер для Windows 11

На плате рядом с AMS1117 стоит USB-Serial мост — один из трёх вариантов: **CP2102**, **CH9102X** или **CH340**. Это определяет, какой драйвер нужен.

> **На нынешней плате станции (38-pin DevKitC, с 2026-09-06) стоит CP2102** — `VID_10C4 & PID_EA60`,
> драйвер Silicon Labs CP210x, Windows 11 обычно ставит его сам из Windows Update. На прежней
> 30-pin плате был CH340C (`VID_1A86 & PID_7523`), поэтому **номер COM-порта после замены
> сменится**, а скрипты из `WindStation-kit.zip` ставят драйвер по VID/PID и требуют правки.
> Оговорка «CH340 нестабилен на 460800» к CP2102 не относится.

**Порядок проверки:**

1. Воткни ESP32 в USB (**до установки датчика и батарей** — просто посмотреть, определяется ли плата)
2. Открой `Диспетчер устройств` → раздел `Порты (COM и LPT)` или `Другие устройства`
3. Найди новое устройство, ПКМ → `Свойства` → вкладка `Сведения` → `ИД оборудования`
4. По VID/PID определи чип:

| VID & PID | Чип | Драйвер |
|---|---|---|
| `VID_10C4 & PID_EA60` | **CP2102** | Silicon Labs CP210x (обычно Windows 11 ставит сам) |
| `VID_1A86 & PID_55D4` | **CH9102X** | WCH CH343SER (скачать с wch-ic.com) |
| `VID_1A86 & PID_7523` | **CH340C** | WCH CH341SER |

**Если плата не появляется вообще** — попробуй другой USB-C кабель: у дешёвых бывает только заряд без data. Кабель должен быть **data-capable**.

**Если появляется как «неизвестное устройство» с жёлтым треугольником** — нужен драйвер, см. таблицу выше.

После установки драйвера в Arduino IDE появится новый COM-порт — его и выбирай для прошивки.

---

## PWR LED и автономность

На плате ESP32 DevKit стоит красный PWR LED, который горит всегда, пока есть питание. Он потребляет ~5 мА непрерывно.

**Реалистичная автономка от батареи (2× LG HG2 6000 мАч суммарно, прошивка always-on webserver, три boost-модуля).**

Считать надо **не по току, а по ватт-часам**, и обязательно **со стороны батареи**: у станции
две независимые ветки с разными КПД, и складывать их токи бессмысленно. ESP32 и датчик
питаются с шины 4.7 В через boost#2 (η ≈ 85%), а модем — со своего boost#3 на 5.2 В,
подключённого прямо к `OUT+` TP4056.

- **Запас батареи: `6000 мАч × 3.6 В = 21.6 Вт·ч`** — это точка отсчёта для обеих веток

**Ветка 1 — станция (шина 4.7 В):**

| Потребитель | Ток на шине |
|---|---|
| ESP32 + WiFi (сервер, SSE, облачный клиент) | ~100 мА |
| датчик 25 мА через boost#1 на 12 В (η ≈ 85%) | ~75 мА на входе boost#1 |
| PWR LED на плате DevKit | ~5 мА |
| статусные LED (в среднем 2 активных) | ~10 мА |
| **итого** | **≈ 190 мА × 4.7 В ≈ 0.89 Вт на шине** |

С учётом boost#2 от батареи уходит `0.89 / 0.85` ≈ **1.05 Вт**. Потери на Schottky_B
(`0.35 В × 0.2 А ≈ 0.07 Вт`) в эту цифру уже входят — они часть тех же 190 мА.

**Ветка 2 — модем (5.2 В со своего буста):**

Модуль **не спит и не сваливается в idle**: облачный канал шлёт пакет каждую секунду
от батареи и каждые 200 мс от внешнего питания, и этого трафика достаточно, чтобы
RRC-соединение держалось постоянно. То есть платить приходится за работающее радио,
а не за средний ток «редких сеансов».

| Режим | Ток модуля | От батареи (boost#3, η 0.9, 5.2 В) |
|---|---|---|
| зарегистрирован, канал молчит | ~25 мА | ~39 мА @3.7 В ≈ 0.14 Вт |
| **постоянный канал (рабочий режим)** | **~100–200 мА** | **~155–310 мА @3.7 В ≈ 0.57–1.15 Вт** |
| GNSS включён | +30–50 мА | **не платим** — фикс снимается один раз и гасится |

⚠️ **Ток модуля = ток по VCC, без деления.** На плате BK-A7670 стоит **линейный** U2 (1084),
дросселя нет — значит от буста уходит `I × 5.2 В`, а не `I × 3.8 В`, и разница сгорает
в стабилизаторе. Это и есть причина, по которой модем греется (см. раскладку в корпусе)
и по которой его нельзя считать «как обычную 3.8-вольтовую нагрузку».

**Итог:**

```
От батареи:  станция 1.05 Вт  +  модем 0.57–1.15 Вт  =  1.62–2.20 Вт
Автономка:   21.6 Вт·ч / 2.20 ≈ 9.8 ч   …   21.6 Вт·ч / 1.62 ≈ 13.3 ч
```

**≈ 10–13 часов** против 20.7 без модема — то есть 4G съедает примерно половину резерва.
(В `tasks/10`, §Энергобюджет та же оценка записана как 9–12 часов; расхождение целиком
внутри погрешности неизмеренного тока и содержательным не является.)

> ⚠️ **Диапазон 100–200 мА — оценка по классу модулей Cat-1, а не замер.** В `A7670 Series
> Hardware Design` раздел Current Consumption (стр. 46) лежит картинкой без текстового слоя.
> Замер USB-ваттметром — открытый долг задачи 10, и сейчас от него зависит половина этого
> расчёта. **Мерить в разрыв входа буста №3, а не по USB модуля**: по USB питание идёт
> мимо VCC и мимо U2, то есть меряется не то.

**Что даёт выпайка PWR LED.** На шине это 5 мА × 4.7 В ≈ 23.5 мВт, от батареи ≈ 28 мВт.
За 11 часов — 0.3 Вт·ч из 21.6, то есть **1.4% расхода, примерно 9 минут автономки**.
С модемом аргумент стал слабее, чем был: раньше выигрыш считался в полчаса.

**Рекомендация та же: оставить.** Станция работает у розетки, батарея — резерв на часы
перебоев, и девять минут не стоят вскрытия SMD. Если всё же хочется выпаять: паяльником
25–40 Вт разогреть одну сторону компонента, наклонить плату, перенести кончик на вторую —
компонент отскочит. Искать резистор 1 кΩ или сам LED рядом с надписью `PWR` возле AMS1117.

**Чем можно растянуть, если понадобится.** Ровно двумя вещами, и обе уже есть в прошивке
или в плане:

1. **темп облачного канала от батареи уже снижен** — 1 Гц вместо 5 Гц (`CLOUD_LIVE_MS_BATTERY`).
   Дальше вниз это уже не темп, а сеансы: канал раз в несколько минут отпускает RRC
   и роняет средний ток модема к ~39 мА, то есть возвращает автономку почти к 20 часам —
   ценой того, что «живой ветер» перестаёт быть живым;
2. **ключ на GPIO33** (позиция 32) — он умеет полностью снимать питание с модема, а не
   только с радио. Ставился он ради аварийного ресета, но между сеансами это ещё и
   единственный способ убрать модуль из расхода целиком, включая холостой ход U2.

**Многодневная автономия** с этой прошивкой недостижима в принципе: WiFi always-on,
опрос датчика 50 Гц, канал наружу постоянный. Для недель нужен Deep Sleep с отключением
датчика и модема между замерами — это переделка и прошивки, и питания, см. «Что можно
улучшить потом».

---

## Сеть станции, портал и OTA

**Своя сеть у станции есть всегда.** Она поднимается при включении, и никакая логика в прошивке
её не выключает — это главное отличие от прежней версии, где AP жила лишь пока не найдена
знакомая сеть, и через ~15 секунд после включения станция просто пропадала с телефона.

**Вдобавок к своей сети плата с 2026-08-15 входит в домашнюю** (режим AP+STA). Это не возврат
старого поведения: домашняя сеть — дополнение, а не замена, и если её нет рядом, не меняется
ровно ничего.

| Параметр | Значение |
|---|---|
| Имя сети (SSID) | `WindStation` |
| Пароль | из `secrets.h` |
| Адрес дашборда | `http://MyWindProbeBETA.org` |
| Он же по IP | `http://192.168.4.1` |
| Клиентов одновременно | до 4 |
| Домашние сети | список `SECRET_HOME_NETWORKS` в `esp32_wind_station/secrets.h` (файл вне git) |
| Адрес в домашней сети | выдаёт роутер; смотреть поле `staIp` в `/api/data` или строку в Serial |

**Про домашнюю сеть.** Вписывать её через дашборд нельзя и не задумано — это список констант
в скетче, меняется вместе с перепрошивкой. Что важно знать:

- **Сетей может быть сколько нужно.** `SECRET_HOME_NETWORKS` в `secrets.h` — список пар
  «имя, пароль», порядок задаёт приоритет: дом, дача, телефон-раздача. Плата пробует их по очереди, по 12 секунд
  на каждую, и останавливается на первой, которая отозвалась
- **Только 2.4 ГГц.** У ESP32 нет радио на 5 ГГц, поэтому сеть с суффиксом `-5G` он не увидит
  никогда. У двухдиапазонного роутера нужна вторая половина, без суффикса
- **Точка доступа один раз моргнёт.** Радио у чипа одно: своя сеть стартует на канале 1, а при
  входе в роутер переезжает на его канал. Подключённый к `WindStation` телефон в этот момент
  отвалится и подключится заново. Это происходит один раз, через несколько секунд после включения
- **Если ни одной из сетей рядом нет** (мачта, дача, поле) — плата пробует всё реже:
  30 секунд, минута, две… до десяти минут между полными проходами по списку. Так сделано потому,
  что каждая попытка уводит радио с канала своей сети, и дашборд на это время замирает.
  Совсем отключить попытки — поставить `SECRET_HAS_HOME_NETWORK 0` в `secrets.h`

**Про адрес.** Имя резолвится DNS-сервером самой платы, который отвечает этим адресом на любой
запрос. Поэтому оно работает даже там, где `.local` ненадёжен — например на Android. Плата ещё
анонсирует captive-portal через DHCP option 114, так что телефон обычно сам предлагает открыть
дашборд сразу после подключения. Bonjour и прочие пляски с mDNS больше не нужны.

Две мелочи, которые не сломают ничего, но заметны:
- домен на нас не зарегистрирован, поэтому пока устройство подключено к станции, настоящий сайт
  по этому адресу для него будет недоступен. У точки всё равно нет выхода в интернет
- браузер для настоящего домена сначала пробует HTTPS и только потом откатывается на HTTP —
  первое открытие занимает лишнюю секунду. Плата на 443 порту не слушает и слушать не будет

**mDNS** тоже работает, как запасной путь: `http://mywindprobebeta.local` — и из своей сети
станции, и из домашней (при подключении к домашней сети mDNS перезапускается на обоих
интерфейсах). На Windows `.local` капризничает, там надёжнее IP.

**OTA (обновление по воздуху):**
- Из домашней сети — по адресу из `staIp`. Компьютер никуда переключать не нужно, интернет
  не пропадает. Это основной путь
- Если аплинка нет (или прошивка на плате старее 2026-08-15) — подключить компьютер к сети
  `WindStation` и заливать по `192.168.4.1`
- Arduino IDE → `Инструменты → Порт → Network Port` → `mywindprobebeta`
- Пароль OTA: `SECRET_OTA_PASSWORD` в `esp32_wind_station/secrets.h` — этот файл вне git,
  на свежем клоне копируется из `secrets.example.h`
- Прошивай, не открывая корпус IP65. Подробности и разбор ошибок — в `FLASHING.md`

---

## Пошаговая сборка

### Этап 1: Проверка пресетов двух boost-модулей (ОБЯЗАТЕЛЬНО до подключения датчика и батареи!)

У тебя **два** модуля Mini Boost, оба с фиксированными пресетами (5V / 8V / 9V / 12V), которые выбираются джамперами — двумя падами `A` и `B` на лицевой стороне платы.

**Нужные пресеты:**
- **Boost #1** → **12V** (для датчика ветра) — пресет `1 1`
- **Boost #2** → **5V** (поднимает батарею на шину) — пресет `0 0`

**Таблица выбора напряжения (типовая для HW-085, см. врезку ниже):**

| A | B | VOUT | Применение в проекте |
|---|---|---|---|
| **0** | **0** | **5V** | ← **Boost #2** (от батареи на шину) |
| 0 | 1 | 8V | — |
| 1 | 0 | 9V | — |
| **1** | **1** | **12V** | ← **Boost #1** (для датчика) |

`0` = пад разомкнут, `1` = пад замкнут каплей припоя. С завода обычно оба пада замкнуты → **12V**. Для boost#2 **надо снять припой** с обоих падов.

⚠️ **Таблица для HW-085.** У клонов (TMF002 и безымянные) логика пресета может быть инвертирована или пары расположены иначе. Доверяй мультиметру, не таблице.

⚠️ **Не перепутай физически IN и OUT.** Различающий признак — расстояние между контактами, а не сторона платы: **два коннектора, расположенные РЯДОМ (близко друг к другу) — это IN**; **два коннектора, разнесённые К КРАЯМ платы — это OUT**. Оба модуля легко вставить в макетку развёрнутыми на 180° — визуально они почти симметричны. Ошибка не бьёт по защите (нет защиты от переполюсовки, см. ниже), но выход остаётся без питания или недобирает напряжение: датчик или шина молчат, а прошивка это не отличит от обрыва сигнального провода. Проверяй ориентацию мультиметром на шаге 3 ниже, а не на глаз.

**Пошагово для каждого модуля:**

1. Посмотри на лицевую сторону модуля — найди пады с буквами `A` и `B`
2. Настрой пресет:
   - **Boost #1** (для датчика, 12V): убедись, что оба пада замкнуты припоем (конфигурация `1 1`)
   - **Boost #2** (для батареи, 5V): оба пада должны быть **разомкнуты**. Если залиты припоем с завода — аккуратно выпаять/размыть паяльником
3. **Обязательная** проверка мультиметром (для обоих):
   - Подай на вход (IN+/IN−) 5V от USB-адаптера (соблюдай полярность! нет защиты от переполюсовки)
   - **Ничего не подключай к выходу**
   - Измерь OUT+/OUT−:
     - Boost #1 → ~12V (11.5–12.5)
     - Boost #2 → ~5V (4.8–5.2)
   - Если не сходится — перепаяй пады по результату, а не по таблице
4. Отключи питание, промаркируй модули «#1 12V» и «#2 5V» маркером

⚠️ **Важные отличия от классического MT3608:**
- Входное напряжение **должно быть меньше выходного** (Vin < Vout − 0.5V). При пресете 12V — вход 5V или 3.7V норм, но **нельзя подавать 12V на вход**.
- Максимальный ток на выходе: ~0.5A при входе 3.7V или 5V. Для датчика ветра (25 мА) это с огромным запасом.
- Нет защиты от переполюсовки — будь внимателен с плюсом/минусом на входе.

### Этап 2: Подготовка и сборка питания

#### 2.1 Выравнивание напряжений батарей (ОБЯЗАТЕЛЬНО перед соединением!)

⚠️ **Два Li-ion аккумулятора нельзя просто так соединять параллельно** — если их напряжения различаются, один начнёт заряжать другой большим током через себя. Это приводит к перегреву, вздутию и в худшем случае возгоранию.

1. Измерь мультиметром напряжение **каждой** батареи отдельно
2. Разница должна быть **не больше 0.05V**
3. Если разница больше — зарядить каждую батарею отдельно (в отдельном TP4056 или бытовом зарядном) до одинакового уровня (например, обе по ~3.7–3.8V)
4. Проверь ещё раз после "отдыха" 30 минут — напряжение должно устояться

#### 2.2 Параллельное соединение батарей

1. Установи обе 18650 в холдеры (соблюдай полярность — знаки на дне холдеров)
2. Соедини холдеры параллельно:
   - Плюс холдера 1 + Плюс холдера 2 → общий провод **+**
   - Минус холдера 1 + Минус холдера 2 → общий провод **−**
3. Получаешь одну виртуальную "батарею" 3.7V / 5000 мАч

```
  Холдер 1 (+) ──┬──► общий +  (к B+ TP4056)
  Холдер 2 (+) ──┘

  Холдер 1 (−) ──┬──► общий −  (к B− TP4056)
  Холдер 2 (−) ──┘
```

#### 2.3 Подключение к TP4056 и схеме питания (diode-OR load sharing с двумя Schottky)

1. Соедини общий **+** батарей → **PTC-предохранитель 2A** → B+ на TP4056
2. Соедини общий **−** батарей → B− на TP4056
3. **Адаптер → Schottky_A → шина:**
   - Плюс адаптера 5V → анод Schottky_A (1N5819, без полоски)
   - Катод Schottky_A (с полоской) → шина breadboard
   - Минус адаптера → общий GND
4. **Батарея → boost#2 → Schottky_B → шина:**
   - От OUT+ TP4056 → IN+ второго Mini Boost (#2, пресет 5V, проверь пады A/B — см. Этап 1)
   - От OUT− TP4056 → IN− boost#2 → общий GND
   - OUT+ boost#2 → анод Schottky_B (без полоски)
   - Катод Schottky_B (с полоской) → шина breadboard (та же шина, что и после Schottky_A — оба диода сходятся в одной точке)
   - OUT− boost#2 → GND
5. Поставь **электролит 1000 мкФ 16V** (или 10V) между шиной и GND (плюс к шине, минус/полоска к GND)
6. Установи **тумблер SPDT** между шиной и нагрузочным рельсом:
   - Один крайний пин тумблера → шина ~4.7V (после конденсатора)
   - Другой крайний или средний пин → нагрузочный рельс (к VIN ESP32 и IN+ Boost#1)
   - SPDT: используй средний пин как «общий» и один крайний как «нагрузка». Третий пин оставь висеть (или на GND через 10k).
   - В положении I (замкнуто): станция работает; в положении O: ESP32 и датчик обесточены (батарея продолжает заряжаться от адаптера через TP4056)
   - ⚠️ **В положении O Boost#2 и Boost#3 остаются под питанием** — они сидят на `OUT+` TP4056, до тумблера. Разряд банки не прекращается, а терминация заряда не срабатывает. Это известная ошибка топологии, разбор и переделка — в `tasks/11-power-switch-and-charge-path.md`; там тумблер переезжает в разрыв `OUT+`, и за ним уходят **оба** отвода с колонки 49
   - ⚠️ **Этот шаг описывает, как собрано сейчас, а не как надо.** Целевая схема — `wiring-v9.html`: вместо одного тумблера здесь стоит **клавиша KCD4 на два полюса**, полюс A в разрыве `OUT+` (`49j` → `A1`, `A2` → `51j`), полюс B в разрыве шины (`39j` → `B1`, `B2` → нижний «+» рельс, кол.43). Провод от шины к нагрузочному рельсу при этом снимается целиком
7. Соедини все GND в одну общую точку:
   - GND TP4056
   - Минус адаптера
   - GND breadboard
   - Общий минус батарей
   - GND boost#2
8. Подай 5V от адаптера → красный LED на TP4056 должен загореться (идёт зарядка), тумблер переведи в I → на нагрузочном рельсе мультиметр показывает **4.6–4.8V**

**Время зарядки:** ~7 часов до полной зарядки (ток 1A на 6000 мАч = 0.17C — щадящий режим, увеличивает срок службы батарей LG HG2).

**Автономность при отключении сети:** ~19–21 час непрерывной работы (считай из энергии: 6000 мАч × 3.6V × 0.85 КПД boost#2 ≈ 18.4 Вт·ч / 0.89 Вт потребления на шине). Без boost#2 (старая схема) было бы 0 часов автономки — шина падала до 3.4V, ESP32 уходил в brownout на первом пике WiFi. Для многодневной автономки всё равно нужен Deep Sleep — см. «Что можно улучшить потом».

### Этап 3: Сборка на breadboard

1. **До посадки платы:** померить штангенциркулем шаг между рядами штырей — должно быть **0.9″**
   (22.9 мм). У части клонов 38-pin ряды разнесены на 1.1″, и тогда свободных отверстий по краям
   не остаётся вовсе, а разводка v8 не собирается. Заодно прозвонить в режиме диода **VBUS
   разъёма USB-C ↔ пин 5V**: если диода нет, воткнутый USB при живом адаптере погонит 5 В назад
   в шину 4.7 В и в выходы обоих MT3608 — тогда USB и адаптер вместе не втыкать
2. **До посадки платы:** прикрутить антенну на u.FL (разъём хрупкий, ставить вертикально, до щелчка)
   и залить прошивку по USB на голой плате — проверить, что точка `WindStation` поднимается.
   Искать причину молчания внутри уже собранной схемы — худший из возможных порядков
3. Установи ESP32 в ряды `a` и `j`, колонки **1–19**, USB-C за край макетки.
   ⛔ **Колонки 1–4 не занимать ничем** — там выведены шесть контактов SPI-флеша
   (`CLK·D0·D1` снизу, `CMD·D3·D2` сверху): перемычка в любую из них, и плата не грузится
4. Подключи VIN ESP32 (кол.1) → шина ~4.7V (посадка «+» LOAD — **колонка 16**, не 4),
   GND (кол.6) → общая земля
5. Поставь керамику **100 нФ** между VIN и GND ESP32 как можно ближе к пинам.
   В v8 она втыкается **прямо в рельсы** (колонки 18 «+» и 19 «−», по диагонали): колонок
   банка под неё не осталось, а обе ноги и так попадают на те же две цепи
6. Собери **один** сигнальный делитель (канал скорости): сверху **10k + 5k последовательно (= 15k)**, снизу **10k**. Второй делитель не нужен — у датчика нет канала направления
   > ⚠️ **Низ делителя — не «любая земля»**. Он задаёт опору АЦП, поэтому сажать его надо в тот кусок «−», по которому ничего не течёт: на схеме v8 это **левая половина верхнего рельса** (провод с `35a` по ряду `a` до колонки **31**, разрез рельсов на 31/32; единственный сток слева — связка на **колонке 21**, поэтому по участку 21…31 не течёт ничего). Правая половина принимает возвратный ток модема — 0.65 А через пружинные контакты дают 11–17 мВ, а это **0.15–0.25 м/с призрачного ветра** в каждом отсчёте, пока идёт передача. Делитель батареи (`27a`) стоит в той же мёртвой зоне и по той же причине
7. На выход делителя (перед GPIO34) поставь **100 нФ** на землю — фильтр шумов
8. Подключи выход делителя к GPIO34 (скорость). **GPIO35 не трогай** — он остаётся не подключённым, в прошивке `HAS_DIRECTION 0`
9. Собери делитель мониторинга батареи: **100k + 100k** между шиной 3.7V (после PTC) и GND, средняя точка → GPIO32 + **100 нФ** на GND
10. Поставь 5 резисторов 220Ω **на плату** (нижний банк), к пинам нижнего ряда ESP32; сами светодиоды — на крышке:
    - GPIO нижнего ряда (**4, 16, 17, 5, 18**, колонки **7–11** на плате 38-pin) → резистор 220Ω
      на плате → провод к длинной ножке (аноду) LED на крышке
    - Резисторы стоят в ряду `i`, полоса **22–36**, шаг 3 колонки: (22,24) (25,27) (28,30) (31,33) (34,36).
      Колонки **20 и 21 остаются пустыми** — через них проходят связки рельсов, обойти плату им негде.
      Правее колонки 36 нельзя: там D1, диод ряда `h` и резистор ряда `i` разошлись бы на 2.5 мм
    - Короткие ножки (катоды) всех 5 LED соединены вместе → общий провод назад на GND
    - Всего к крышке идёт 6 проводов: 5 анодов + 1 общий катод
11. Подключи **Mini Boost #1** (IN+/IN-) к шине ~4.7V, выход (OUT+/OUT-) 12V выведи на клеммы для датчика
12. **Mini Boost #2** уже подключён в Этапе 2.3 (вход от OUT+ TP4056, выход через Schottky_B на шину). Проверь мультиметром: OUT+ boost#2 должен показывать **~5V** при подключённой батарее (даже если адаптер в розетке)

### Этап 4: Прошивка и проверка без датчика

1. Подключи ESP32 к компьютеру через USB
2. Если плата не определяется или COM-порт не появляется → см. раздел **«USB-Serial драйвер для Windows 11»** выше
3. Открой Arduino IDE, установи ESP32 Board Manager
4. Открой скетч `esp32_wind_station.ino`
5. **Скопируй `esp32_wind_station/secrets.example.h` в `secrets.h`** — без него скетч не
   соберётся, компилятор так и напишет. Ничего дописывать туда не обязательно: в шаблоне
   уже лежат пароли точки и OTA из этого документа, а домашние сети выключены.
   Пароль точки — строго 8–63 символа, короче ESP32 молча поднимет **открытую** сеть
6. Выбери плату: **ESP32 Dev Module**, правильный COM-порт
7. Нажми Upload
8. Открой Serial Monitor (115200 бод) — увидишь `AP 'WindStation' up  IP: 192.168.4.1`
   и строку про DNS catch-all
9. Подключи телефон или ПК к сети `WindStation` (пароль — в `secrets.h`) и открой
   `http://MyWindProbeBETA.org`. Обычно портал всплывает сам
10. При отсутствии датчика LED `ОШИБКА` (GPIO18) **не загорится** — это не поломка.
    Детектор срабатывает только на глухое замыкание сигнала на землю (<10 мВ), а
    неподключённый вход читается тем же полом АЦП ~145 мВ, что и датчик на нуле.
    Скорость на дашборде при этом будет `0.00` — гейт `SPEED_ZERO_MV = 150` режет всё,
    что ниже порога
11. Дальше обновления идут по OTA — но только с компьютера, подключённого к сети станции:
    Arduino IDE → `Инструменты → Порт → Network Port → mywindprobebeta`

### Этап 5: Подключение датчика

1. **Выключи питание полностью**
2. Подключи провода датчика по схеме (цвета уточни в инструкции датчика):
   - VCC (обычно красный) → выход Mini Boost **#1** +12V
   - GND (обычно чёрный) → общая земля
   - Сигнал скорости (0–5V) → вход делителя
   - Четвёртого провода (направление) у этого датчика нет
3. Подай питание
4. Проверь что датчик вращается свободно (подуй на чашки)
5. Открой веб-дашборд — должно появиться реальное значение скорости. Направление там не показывается: `dirPresent` в `/api/data` всегда `false`

### Этап 6: Монтаж в корпус

1. Выключи питание
2. Просверли 2 отверстия под гермовводы PG7 в боковой стенке корпуса
3. Установи гермовводы, протяни через них кабели датчика и адаптера
4. Закрепи breadboard на дно корпуса (двусторонний скотч 3M или термоклей)
5. Модули питания (TP4056, Mini Boost **#1** для 12V, Mini Boost **#2** для 5V) → на термоклей к дну
6. Холдер 18650 → в свободный угол
7. Выведи светодиоды проводами к крышке — крышка глухая, так что либо отверстия с герметизацией, либо смотреть статус на дашборде (см. «Размещение светодиодов»)
8. Брось внутрь пакетик силикагеля
9. Закрой крышку, проверь что уплотнитель плотно прилегает

### Этап 7: Дашборд на мониторе

1. На Android TV приставке установи **Fully Kiosk Browser** (APK)
2. Подключи приставку к домашней сети — станция там тоже есть, и интернет у приставки
   останется. Если дома роутера нет, подключай к `WindStation` (пароль — в `secrets.h`), но учти:
   в этой сети интернета у приставки не будет — станция его не раздаёт
3. Пропиши в настройках URL: адрес станции в домашней сети (`staIp` из `/api/data`) либо
   `http://192.168.4.1`, если приставка сидит на сети станции. Для киоска лучше именно IP:
   он не зависит ни от DNS, ни от того, как прошивка Fully обрабатывает переход с HTTPS на HTTP.
   Адрес в домашней сети стоит закрепить в роутере за MAC платы, иначе DHCP его однажды сменит
4. Включи автозапуск и полноэкранный режим
5. Подключи монитор по HDMI
6. При включении приставка будет сразу показывать дашборд
7. В дашборде есть кнопка ⚙ в правом верхнем углу — там можно поменять хост ESP32 без правки кода (сохраняется в localStorage браузера)

---

## Безопасность

⚠️ **Li-ion 18650 — опасны при неправильном обращении:**
- Никогда не замыкай клеммы аккумулятора
- Используй только защищённую схему (DW01A в TP4056 защищает от переразряда и перегрузки)
- При вздутии, нагреве или запахе — немедленно изолируй и утилизируй
- Не заряжай при температуре ниже 0°C или выше +45°C

⚠️ **Оба boost-модуля — проверь пресеты ДО подключения:**
- Boost **#1** → 12V (пады A и B **замкнуты** припоем) — иначе датчик не запустится
- Boost **#2** → 5V (пады A и B **разомкнуты**) — иначе шина при автономке либо не дотянет до нужных 4.7V (пресет меньше), либо даст слишком много и опасно нагрузит электролит. При 16V электролите риск только выше 16V (пресета такого нет, безопасно); при 10V электролите — взорвётся при любом пресете от 12V. Рекомендуется 16V.

⚠️ **Полярность аккумуляторов** — TP4056 не имеет защиты от переполюсовки. Перепутаешь плюс и минус — модуль сгорит сразу. При параллельном соединении двух батарей будь особенно внимателен: неправильно соединённые батареи (плюс к минусу) дадут короткое замыкание на ~5000 мАч — это очень опасно.

⚠️ **Выравнивание напряжений** — перед соединением двух 18650 параллельно обязательно проверь мультиметром что у обеих напряжение одинаковое (разница < 0.05V). Иначе одна батарея начнёт заряжать другую большим током через себя — перегрев, вздутие, возможно возгорание.

⚠️ **Корпус не на солнце** — внутри IP65 без вентиляции быстро перегреется ESP32 и батарея. Монтируй в тень или под козырёк крыши.

⚠️ **ESP32 не любит 5V на GPIO** — поэтому делитель напряжения обязателен. Без него ADC пин получит 5V и может выйти из строя.

⚠️ **Грозовая защита** — длинный кабель датчика на мачте работает как антенна. Для серьёзного монтажа добавь газовый разрядник или TVS-диоды на линии датчика. Для домашнего варианта на балконе можно не делать.

---

## Проверочный чеклист перед запуском

- [ ] USB-Serial драйвер установлен, плата определяется как COM-порт в Arduino IDE
      (на 38-pin это **CP2102**, `VID_10C4 & PID_EA60` — номер порта после замены платы другой)
- [ ] **Антенна прикручена к u.FL** — у ESP-32U печатной антенны нет, без пигтейла связь на метр
- [ ] **Колонки 1–4 макетки пустые** — там выведены контакты SPI-флеша, перемычка в любую = плата не грузится
- [ ] Шаг между рядами штырей 0.9″ (не 1.1″), диод VBUS↔5V прозвонен
- [ ] Связки рельсов на колонках **20/21**, C2 воткнут прямо в рельсы (18/19), колонки 20–21 нижнего банка пусты
- [ ] Mini Boost **#1** настроен на 12V (пады A и B замкнуты, проверено мультиметром)
- [ ] Mini Boost **#2** настроен на 5V (пады A и B разомкнуты — конфигурация `0 0`, проверено мультиметром)
- [ ] Напряжения обеих 18650 выровнены до разницы < 0.05V **перед** соединением
- [ ] Полярность 18650 правильная (проверена по маркировке холдеров)
- [ ] Батареи соединены параллельно: плюс к плюсу, минус к минусу
- [ ] PTC-предохранитель 2A установлен на плюсовой линии батарей
- [ ] **Schottky_A** установлен между плюсом адаптера 5V (анод) и шиной (катод/полоска)
- [ ] **Schottky_B** установлен между OUT+ boost#2 (анод) и шиной (катод/полоска)
- [ ] Обе катодные стороны Schottky_A и Schottky_B сходятся в одну точку шины
- [ ] Все GND объединены в одну общую точку (включая GND boost#2)
- [ ] Электролит 1000 мкФ стоит на шине ~4.7V (полярность соблюдена)
- [ ] Тумблер SPDT установлен между шиной и нагрузочным рельсом (средний пин → шина, крайний → нагрузка) — *состояние до задачи 11*
- [ ] **Целевое (схема v9):** KCD4 прозвонен (две независимые пары, между парами обрыв в обоих положениях); полюс A в разрыве `OUT+` (`49j`→`A1`, `A2`→`51j`); полюс B в разрыве шины (`39j`→`B1`, `B2`→«+» низ кол.43); связка «+» кол.58 стоит, связка «+» кол.20 снята, мост `31↔32` сидит плотно
- [ ] Керамика 100 нФ стоит у VIN ESP32 и на выходе сигнального делителя (GPIO34)
- [ ] Сигнальный делитель собран **один**: сверху **10k + 5k последовательно (= 15k)** (со стороны сигнала), **10k** снизу (к GND); GPIO35 не подключён
- [ ] Делитель батареи: 100k + 100k на GPIO32, конденсатор 100 нФ на GND
- [ ] Резисторы 220Ω стоят на плате (ряд `i`, полоса **22–36**, шаг 3 колонки), 5 LED — на крышке; анод каждого LED через резистор к GPIO (4, 16, 17, 5, 18 — колонки 7–11), катоды общие → GND
- [ ] Сеть `WindStation` видна с телефона и пускает по паролю из `secrets.h`
- [ ] Дашборд открывается по `http://MyWindProbeBETA.org` (и по `http://192.168.4.1`)
- [ ] Датчик вращается свободно, показания меняются при ветре
- [ ] Напряжение батареи на дашборде адекватное (3.5–4.2V)
- [ ] Гермовводы затянуты, силикагель внутри, крышка закрыта
- [ ] Корпус не под прямыми солнечными лучами

---

## Диагностика проблем

| Проблема | Возможная причина | Решение |
|---|---|---|
| Плата не определяется как COM-порт | Нет драйвера USB-Serial | См. раздел «USB-Serial драйвер». Проверь также что кабель data-capable |
| Плата видна но не прошивается | Выбран неверный чип в Arduino IDE | ESP32 Dev Module + правильный COM + скорость 115200 |
| Плата вообще не запускается: тишина в Serial, точки доступа нет | Что-то воткнуто в колонки **1–4** — там на 38-pin выведены шесть контактов SPI-флеша (`CLK·D0·D1` снизу, `CMD·D3·D2` сверху) | Вынуть всё из колонок 1–4. Это единственная ловушка, которой на 30-pin плате не было: перемычка туда останавливает загрузку молча, без сообщения |
| Связь есть, но на метр: телефон видит сеть только вплотную | На плате ESP-32U **не прикручена антенна** — печатной у этого модуля нет вовсе | Поставить пигтейл или плёнку на u.FL. Разъём хрупкий, до щелчка, вертикально. Не путать с историей «ноутбук заходит, телефон никогда» — та про WPA3/PMF и закрыта прошивкой 2026-08-23 |
| ESP32 не включается | Нет 5V на VIN | Проверь диод Шоттки, полярность |
| Сети `WindStation` нет в списке | Плата не запустилась или AP не поднялась | Смотри Serial: должна быть строка `AP 'WindStation' up`. Нет строки — питание/brownout |
| Сеть открытая, без пароля | `apPassword` короче 8 символов | ESP32 в этом случае молча поднимает открытую сеть. Верни пароль длиной 8–63 |
| Подключился, но дашборд не открывается | Браузер ушёл на HTTPS | Открой `http://192.168.4.1` напрямую — плата на 443 не слушает |
| Телефон отваливается от сети станции | Android уходит на сеть с интернетом | Выключить «переключаться на мобильные данные» / «умный выбор сети» |
| OTA не видит плату | Другая подсеть или файрвол | Прошей один раз по USB, проверь что Arduino IDE и ESP32 в одной сети |
| Датчик показывает 0 | Нет 12V питания | Проверь пресет A/B на boost **#1** (12V для сенсора) и выход мультиметром |
| Автономка не работает (ESP32 уходит в brownout при отключении адаптера) | boost #2 не выдаёт 5V или неправильный пресет | Мультиметр на OUT+ boost #2: должно быть ~5V. Проверь пресет A/B = `0 0` (оба пада **разомкнуты**). Schottky_B в правильную сторону (анод к boost, катод к шине) |
| Дашборд показывает «ADC · ОШИБКА» | Сигнальный провод замкнут на землю (<10 мВ дольше 1.5 с) | Обрыв этот детектор **не ловит** — висящий вход даёт те же ~145 мВ, что и датчик на нуле. Ищи короткое: выход делителя, 100 нФ, пайку GPIO34 |
| Скорость всегда `0.00`, а датчик крутится | Нет 12V на датчике, оборван сигнальный провод, или скорость реально ниже ~2.3 м/с | Посмотри `speedMv` в `/api/data`: ~145 мВ = сигнала нет вовсе; выше 150 мВ = сигнал есть, но гейт `SPEED_ZERO_MV` его режет — это предел железа, см. раздел про порог АЦП |
| Значения скачут | Наводки на кабель | Укороти кабель, добавь экранирование, конденсаторы 100 нФ на ADC |
| Батарея не заряжается | Адаптер слабый | Используй 5V 2A минимум |
| TP4056 греется | Ток заряда 1A слишком большой | Это нормально, добавь радиатор |
| ESP32 перезагружается | Просадка по питанию | Проверь электролит 1000 мкФ на шине ~4.7V; также проверь, что boost#2 выдаёт 5V и Schottky_B подключён правильно |
| LED не горят | Перепутан катод/анод | Переверни LED |
| Показывает «Заряд: 0%» при подключённом адаптере | Делитель батареи не подключён или GPIO32 висит | Проверь делитель 100k/100k на GPIO32 |
| Автономия меньше ожидаемой | С модемом это норма: 10–13 ч вместо 20. Радио держит RRC постоянно и ест больше всей остальной станции | См. «PWR LED и автономность». Выпайка PWR LED даёт ~9 минут и проблемы не решает; либо реже сеансы канала, либо ключ GPIO33 |

---

## Что можно улучшить потом

- **OLED дисплей SSD1306 0.96"** прямо на корпусе для локального отображения
- **WS2812B лента** вместо обычных LED — красивая шкала ветра
- **RS485 версия датчика** — если кабель будет длиннее 10 метров
- **SIM800L / A7670E** — для работы без WiFi, в поле
- **Grafana + InfluxDB** на домашнем сервере — для истории и графиков за месяцы
- **Deep Sleep** — если работает только от батареи, можно растянуть автономность на недели (потребует переделки питания)
- ~~**WiFiManager / Captive Portal** — настройка SSID/пароля без перепрошивки~~ — ✅ снято с повестки (2026-08-07): станция стала точкой доступа и только ей, настраивать нечего. Промежуточный вариант с пулом до 6 сетей в NVS и своей AP `WindStation-Setup` прожил с 2026-08-02 по 2026-08-07 и лежит в `archive/firmware-v2-multiwifi-2026-08-02/`
- **Возврат в домашнюю сеть вторым режимом** — если однажды захочется и дашборда из дома, и автономности в поле. Осознанно не сделано: именно совмещение двух ролей и приводило к тому, что AP гасла через 15 секунд после старта
- **TVS-диоды или газовый разрядник** на линии датчика — грозовая защита для монтажа на высокой мачте

---

## Итог

После сборки у тебя будет:
- Автономная метеостанция с резервным питанием и мониторингом заряда
- Красивый дашборд в реальном времени на телефоне или большом мониторе — станция раздаёт его сама, без роутера и интернета
- Индикация состояния через 5 LED (видно снаружи корпуса)
- Защита от дождя (IP65), от КЗ на батарее (PTC), от помех на ADC (конденсаторы)
- Возможность управлять светодиодами с дашборда и сбрасывать порыв
- Обновление прошивки по WiFi (OTA) без вскрытия корпуса
- Калиброванные показания ADC через `analogReadMilliVolts()` (точность ±50–100 мВ в DIY-условиях)

Удачи со сборкой! 🌬️
