temafey/ArduinoWindStation/tasks/12-j5019-evaluation.md

# Задача 12: Плата J5019 — ресерч и решение, ставить ли её в станцию

## Промпт для новой сессии
```
Читай tasks/12-j5019-evaluation.md и выполни задачу шаг за шагом.
Источники истины: CLAUDE.md, wind-station-assembly.md, tasks/11-power-switch-and-charge-path.md.
```

## Статус
- Ресерч по документации: сделан 2026-08-30 (этот файл)
- Стендовые замеры: **не сделаны** — они и есть работа этой задачи
- Блокеров нет, станцию не трогает: вся проверка делается на столе, отдельно от макетки
- Связанные задачи: 04 (силовая шина), 11 (перенос SW1 — именно с ней J5019 конфликтует)

## Что это за плата

Комбо-модуль на одной плате 33×24 мм: **зарядка Li-ion на TP4056 + повышающий
преобразователь на MT3608**, холдер/пады 18650, вход micro-USB либо Type-C, выход
регулируемый подстроечником. `J5019` и `HW-357` — одна и та же плата, маркировки
разных партий; попадается ещё имя `AC01`. Куплена 2026-07-18 как возможная замена
связке «TP4056 + Mini Boost №2» одной платой.

Ревизия на руках (подтверждено осмотром 2026-07-18): **вход Type-C**, **выход
регулируемый** подстроечником.

## Что известно достоверно (уровень datasheet, а не описания продавца)

Описания магазинов противоречат друг другу вплоть до физически невозможного —
один и тот же модуль продаётся как «ток заряда до 2.5 А» (TP4056 больше 1 А не отдаёт
в принципе), как «есть защита DW01A» и тут же как «защиты батареи нет, при просадке
вынимайте банку». Верить можно только двум datasheet'ам и осмотру конкретной платы.

**TP4056** ([разбор](https://www.best-microcontroller-projects.com/tp4056.html)):
- Терминация заряда — по спаданию тока до **C/10**. Ток заряда задан Rprog, 1.2 кΩ = 1 А
- **Нагрузка, висящая параллельно банке во время заряда, ломает терминацию**: ток
  не падает до C/10, чип не заканчивает заряд. Это datasheet-уровень факта, не мнение
- **Сам по себе TP4056 защиты от переразряда не имеет** — она приходит только с
  DW01A + 8205A на конкретной плате

**MT3608** ([параметры модуля](https://components101.com/modules/mt3608-2a-dc-dc-step-up-power-module)):
- Вход 2–24 В, выход до 28 В, внутренний ключ ~4 А, выпрямитель внешний (Шоттки на плате)
- Собственное потребление в работе **1.6–2.2 мА** — это «всегда включено», пока
  на входе есть банка
- **2 А — это ток ключа, а не выход.** Реалистичный потолок этой платы на 5 В от
  ячейки 3.7 В — около **1–1.4 А**, дальше греется дроссель и просаживается выход
- Выход **не может быть ниже входа**: при пресете ниже напряжения банки плата
  просто пропускает вход через дроссель и диод

## Четыре вывода, ради которых ресерч делался

### 1. «Заряд и разряд одновременно» — работает физически, но ломает индикацию заряда

Вход буста на J5019 сидит на узле батареи, поэтому выход **не гаснет** при воткнутом
заряде (отсюда и продажа как «mini UPS»). Цена — та самая терминация: пока нагрузка
тянет ток, TP4056 никогда не увидит C/10, `CHRG` горит вечно, `STDBY` не загорается
никогда, а ячейка стоит в CV на 4.2 В сколько угодно долго (ускоренная деградация).

Для станции это не абстракция: **ровно этот симптом уже пойман** — шаг 17 задачи 10
не закрывается, потому что модем тянет ток мимо терминации. Задача 11 лечит его
переносом SW1 на `OUT+`, то есть «заряд — только без нагрузки». J5019 отменил бы
этот фикс: `chargeState` в `/api/data` навсегда застрял бы в `"charging"`.

### 2. J5019 конфликтует с топологией задачи 11 — это главный аргумент против

Смысл задачи 11 — тумблер в разрыве **`OUT+` TP4056**, то есть между зарядным узлом
и обоими бустами. Этот узел существует именно потому, что зарядка и буст — разные платы.

**На J5019 такого узла наружу не выведено:** вход MT3608 разведён внутри платы. SW1
сможет рвать только `OUT+` самого J5019, а это:
- не гасит внутренний буст (1.6–2.2 мА из банки круглосуточно, ~1 А·ч в месяц);
- не гасит буст №3 и модем, если их не перевесить на пады `B+` — а это отвод
  **до** тумблера, то есть снова «выключено, а разряжается».

Обходной путь есть (тянуть отвод с пад `B+` и ставить SW1 туда), но он возвращает
ровно ту ошибку, которую задача 11 исправляет.

### 3. Подстроечник на мачте — минус, а не плюс

Регулируемый выход 4.3…27 В означает, что **сбитый подстроечник кладёт на шину 4.7 В
до 27 В**: ESP32 и электролит на 16 В умирают сразу. Mini Boost HW-085 в этой роли
безопаснее принципиально — у него пресет паяными падами `A`/`B`, дрейфовать нечему,
а вибрация мачты — рабочее условие, а не гипотеза. Лак на винт помогает, но не
меняет класс отказа.

### 4. Мощности хватает только на шину, не на модем

~1–1.4 А на 5 В — это шина станции (ESP32 + буст №1, ~0.2–0.35 А) с запасом.
Пик модема 1.5 А на 5.2 В (≈2 А от ячейки 3.7 В) — **вне возможностей платы**.
Буст №3 J5019 не заменяет ни при каком раскладе.

## Вердикт

**В станцию не ставить.** Не из-за качества платы, а из-за топологии: она убирает
узел, на котором стоит весь фикс задачи 11, и меняет фиксированный пресет на
подстроечник в вибрации. Текущая связка «TP4056 с DW01A + Mini Boost №2» для мачты
строго лучше.

**Где плата полезна:**
- **план Б по зарядному узлу** — TP4056 уже подозревался в отказе (см. `tasks/11`,
  история brownout), а J5019 это готовая зарядка с холдером;
- автономная переносная снасть на столе (питание чего угодно от 18650 с регулировкой),
  где нет ни мачты, ни требования «выключено — значит выключено».

## Стендовые замеры (то, что закрывает задачу)

Всё делается мультиметром UT33A+, без БП, вне макетки. Пять пунктов, ~20 минут.

1. **Есть ли защита банки.** Осмотреть плату у пад `B-`: DW01A — корпус SOT-23-6 с
   надписью `DW01A`, рядом SOT-23-8 `8205A`. Электрическая проверка: без банки
   померить сопротивление `B-` ↔ `OUT-` в обе стороны. **0 Ω в обе стороны = защиты
   нет** (пады соединены напрямую), несимметричные показания = стоят полевики защиты.
   ⚠️ Если защиты нет — плату **нельзя** использовать с незащищённой ячейкой: MT3608
   работает до 2 В входа и высадит банку насмерть. Ровно так 2026-08-16 ушла в ноль
   текущая банка (3.25 В под нагрузкой).
2. **Тип выхода и диапазон.** Вставить банку, померить `OUT+`, покрутить подстроечник
   от края до края, записать минимум и максимум. Убедиться, что 5.10–5.15 В ставится
   уверенно, а не на самом краю хода.
3. **Выход при воткнутом заряде.** С банкой и нагрузкой на `OUT+` воткнуть Type-C:
   держит ли выход 5 В, что делают светодиоды. Ожидание по ресерчу — держит, красный
   горит не выключаясь. Если выход **падает в 0** — это ревизия «глохнет при заряде»,
   и она годится только в схеме с диодным ИЛИ и живой адаптерной веткой.
4. **Ток покоя.** Банка вставлена, нагрузки нет, `OUT+` свободен: измерить ток по
   входу от банки (ожидание 1.5–3 мА). Это цифра «сколько плата ест в тумбочке».
5. **Индикация для прошивки.** Если плату когда-нибудь поставят в станцию: проверить,
   что светодиоды сидят на выводах `CHRG`/`STDBY` TP4056 (катод к земле через LED,
   активный уровень LOW), и найти пады под провода на GPIO13/19. У некоторых комбо-плат
   индикация разведена иначе, и прошивка тогда прочитает мусор.

## Документация — если по итогам замеров решение изменится

Только при решении «ставим»; сейчас ожидание — «не ставим», и тогда правится один
этот файл + строка в `tasks/README.md`.

- `wind-station-assembly.md` — BOM (позиции 3, 4), блок-схема Mermaid потока питания,
  раздел «Этап 2.3», чек-лист
- `images/gen_wiring_v7_svg.py` → перегенерировать схему (руками не править;
  действующая версия — `wiring-v7.html`)
- `tasks/04-power-rail.md` и `tasks/11-power-switch-and-charge-path.md` — положение SW1

## Источники

- [TP4056: терминация C/10, Rprog, load sharing, отсутствие защиты в голом чипе](https://www.best-microcontroller-projects.com/tp4056.html)
- [MT3608 — параметры модуля и datasheet](https://components101.com/modules/mt3608-2a-dc-dc-step-up-power-module)
- [DW01A — пороги защиты (4.3 В / 2.4 В / ~3 А с 8205A)](https://www.best-microcontroller-projects.com/dw01a.html)
- [J5019/HW-357 — карточка с пинами и токами по напряжениям (5 В 1.4 А / 9 В 0.8 А / 12 В 0.6 А)](https://www.circuitpointbd.com/product/DC%20to%20DC%20Boost%20Module%20-%20J5019%20HW-357)
- [J5019 — вариант Type-C, регулировка подстроечником](https://www.robotics.org.za/J5019-USBC)
- [Модификация TP4056 под load sharing (P-FET + Шоттки + резистор) — если когда-нибудь понадобится](https://forum.arduino.cc/t/tp4056-lithium-charger-module-modification-to-add-power-sharing/1008473)
