temafey/ArduinoWindStation/diag-measure.png

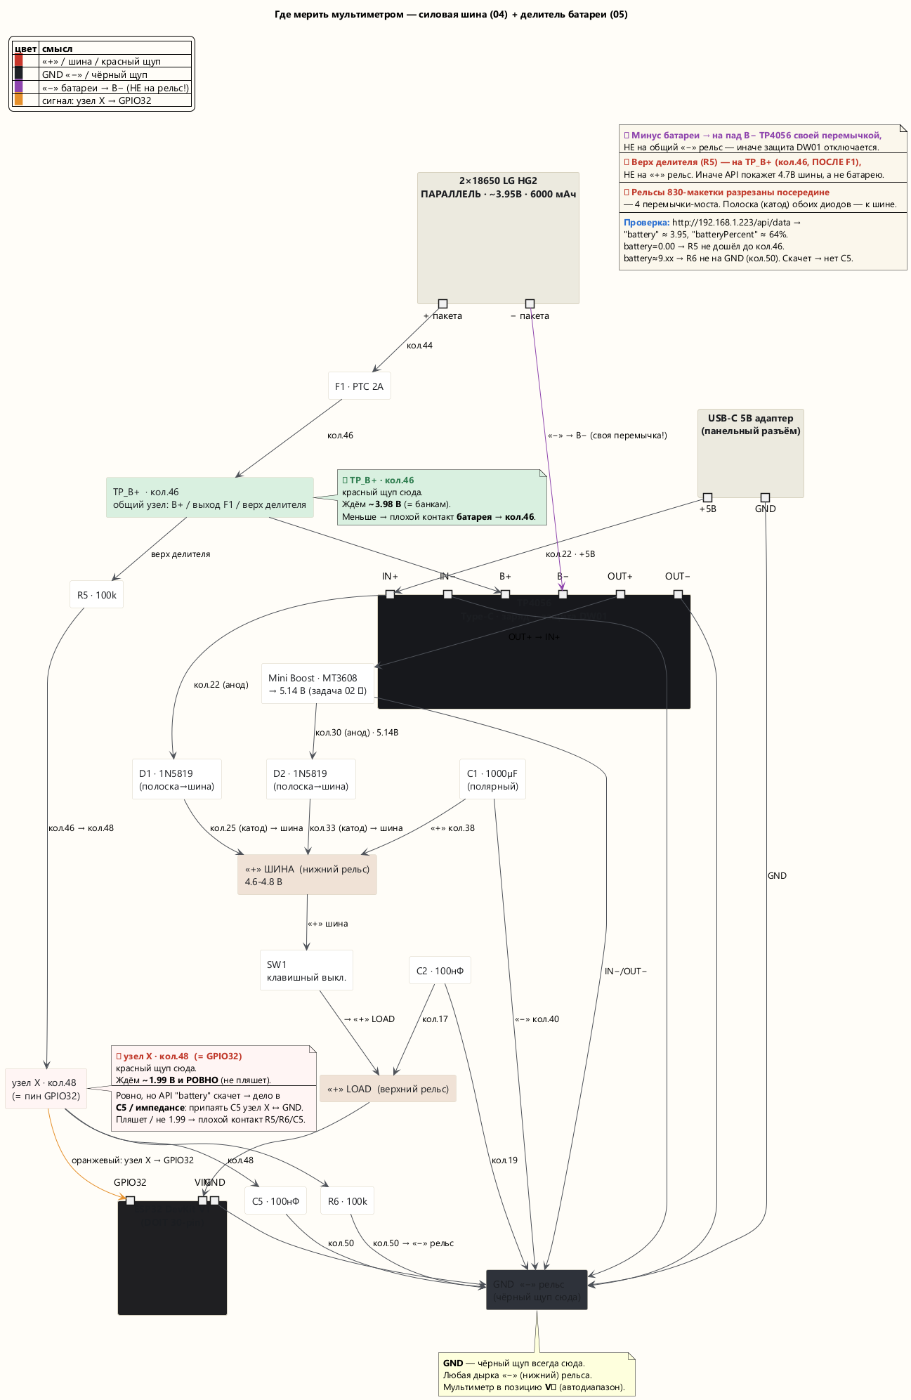
diag-measure.png
