temafey/ArduinoWindStation/kicad/WindStation_schematic.pdf

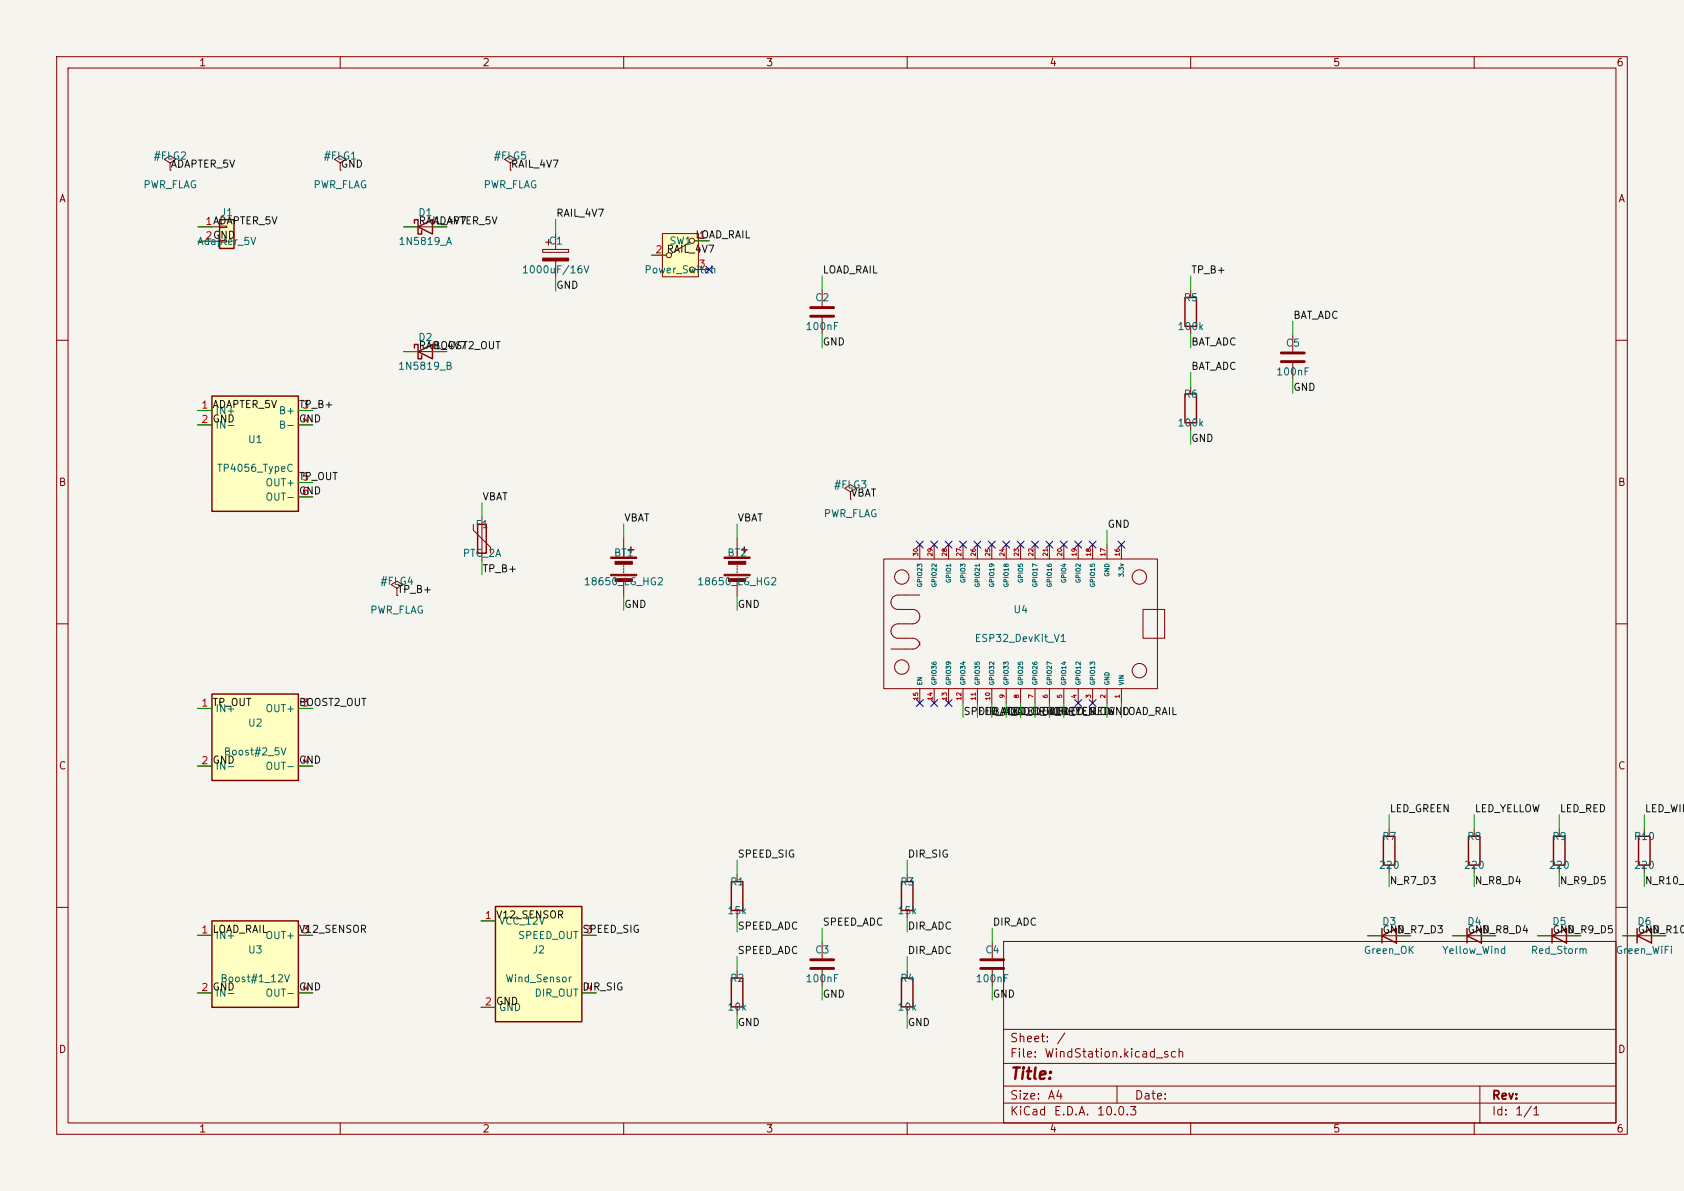
[picture p56: page 1]

Size: A4 | Rev:
KiCad E.D.A. 10.0.3 | Id: 1/1
