temafey/ArduinoWindStation/(list of files, drawings)

Other design files:
kicad/freerouting.dsn
kicad/temp-freerouting.dsn
kicad/WindStation.dsn
