temafey/ArduinoWindStation/kicad/WindStation.kicad_pcb

## KiCad design kicad/WindStation.kicad_pcb (2026-08-15)

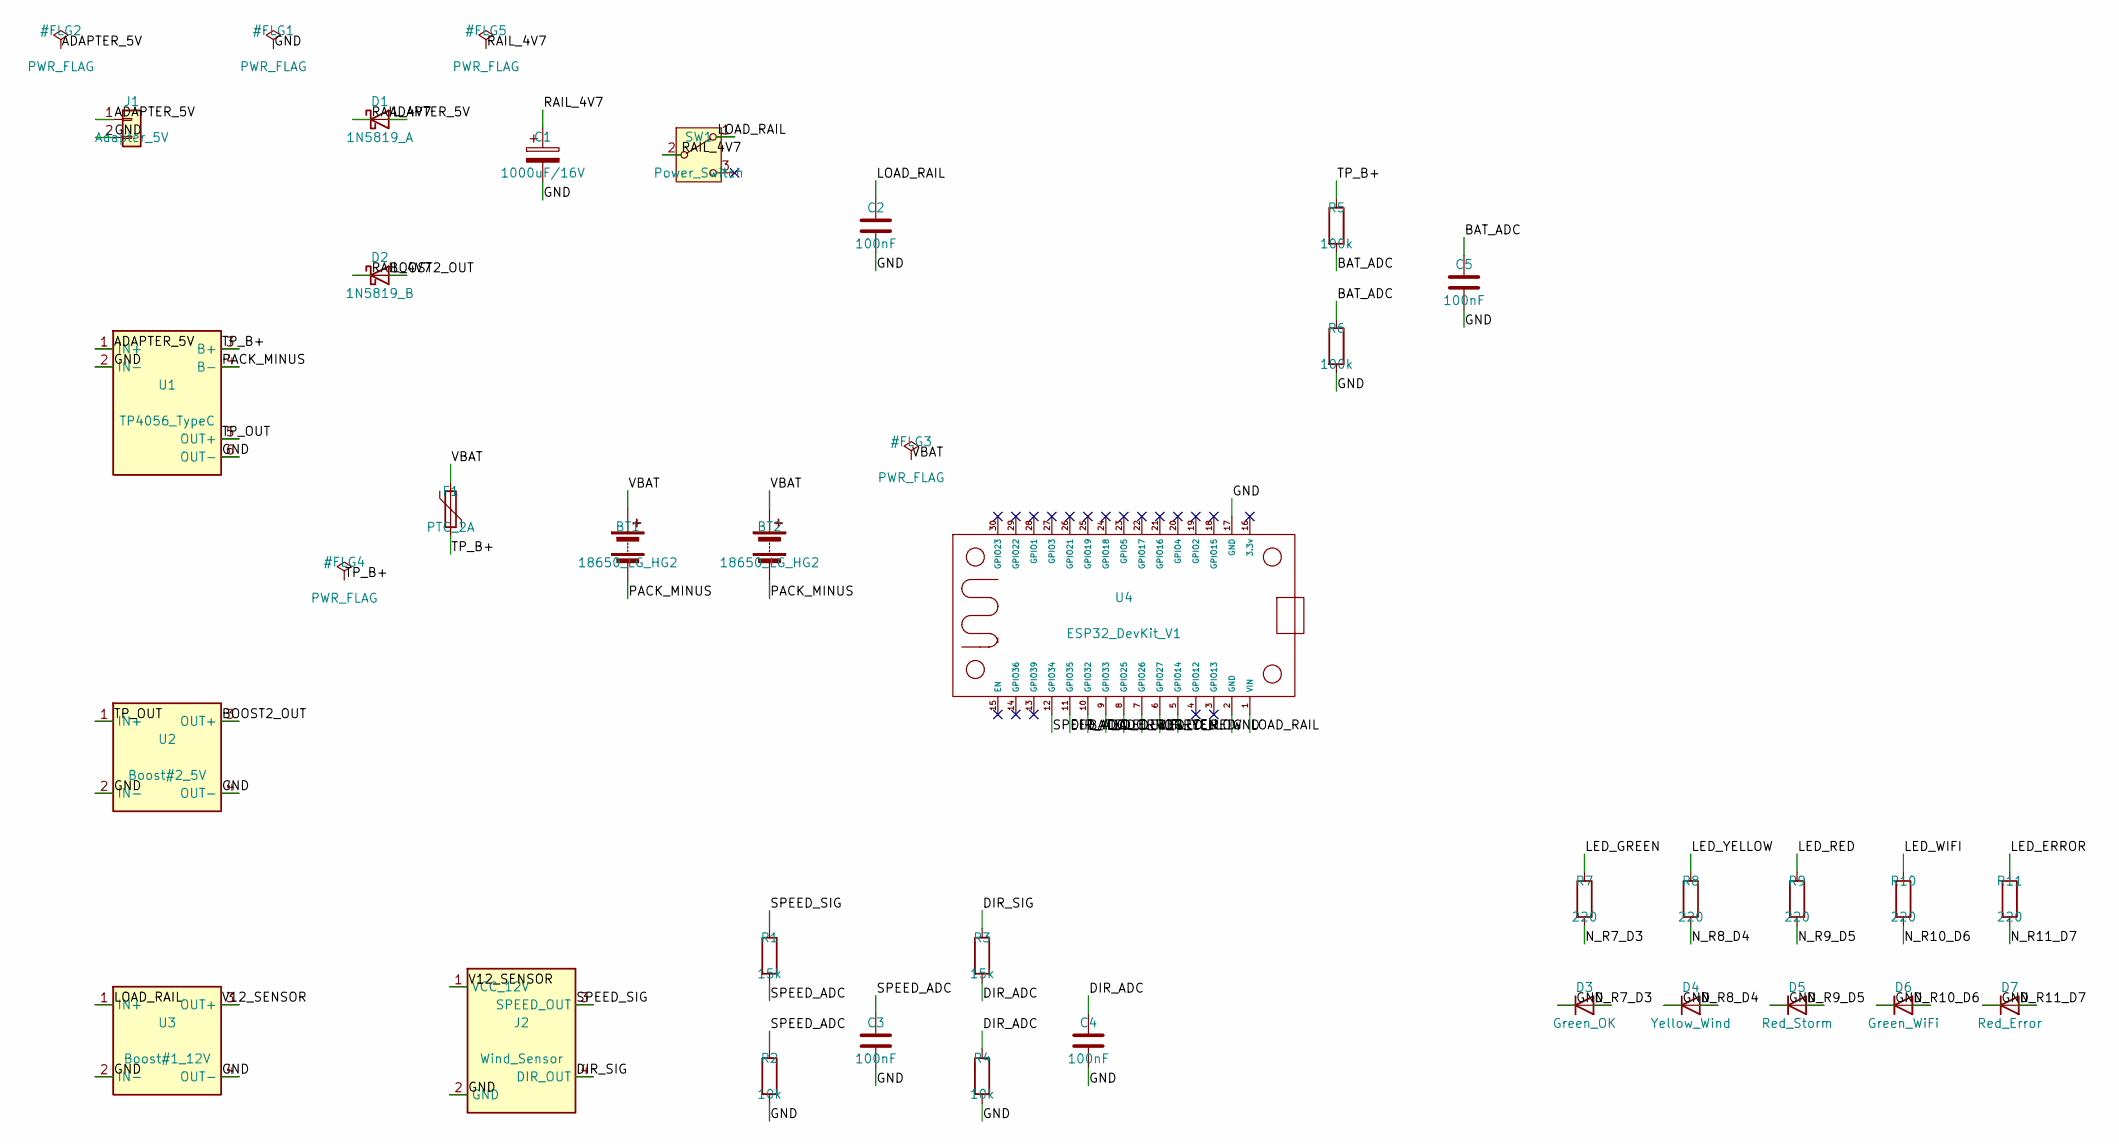
[picture p57: schematic WindStation.kicad_sch]

Parts:
BT1, BT2: 18650_LG_HG2; BatteryHolder_Keystone_1042_1x18650
C1: 1000uF/16V; CP_Radial_D10.0mm_P5.00mm
C2, C3, C4, C5: 100nF; C_Disc_D5.0mm_W2.5mm_P5.00mm
D1: 1N5819_A; D_DO-41_SOD81_P10.16mm_Horizontal
D2: 1N5819_B; D_DO-41_SOD81_P10.16mm_Horizontal
D3: Green_OK; LED_D5.0mm
D4: Yellow_Wind; LED_D5.0mm
D5: Red_Storm; LED_D5.0mm
D6: Green_WiFi; LED_D5.0mm
D7: Red_Error; LED_D5.0mm
F1: PTC_2A; Fuse_Bourns_MF-RG400
J1: Adapter_5V; PinHeader_1x02_P2.54mm_Vertical
J2: Wind_Sensor; PinHeader_1x04_P2.54mm_Vertical
R1, R3: 15k; R_Axial_DIN0207_L6.3mm_D2.5mm_P10.16mm_Horizontal
R2, R4: 10k; R_Axial_DIN0207_L6.3mm_D2.5mm_P10.16mm_Horizontal
R5, R6: 100k; R_Axial_DIN0207_L6.3mm_D2.5mm_P10.16mm_Horizontal
R7, R8, R9, R10, R11: 220; R_Axial_DIN0207_L6.3mm_D2.5mm_P10.16mm_Horizontal
SW1: Power_Switch; PinHeader_1x03_P2.54mm_Vertical
U1: TP4056_TypeC; PinHeader_1x06_P2.54mm_Vertical
U2: Boost#2_5V; PinHeader_1x04_P2.54mm_Vertical
U3: Boost#1_12V; PinHeader_1x04_P2.54mm_Vertical
U4: ESP32_DevKit_V1; ESP32_DevKit_V1_30pin

Connections:
/ADAPTER_5V: D1.2 (A), J1.1, U1.1 (IN+)
/BAT_ADC: C5.1, R5.2, R6.1, U4.10 (GPIO32)
/BOOST2_OUT: D2.2 (A), U2.3 (OUT+)
/DIR_ADC: C4.1, R3.2, R4.1, U4.11 (GPIO35)
/DIR_SIG: J2.4 (DIR_OUT), R3.1
/GND: C1.2, C2.2, C3.2, C4.2, C5.2, D3.1 (K), D4.1 (K), D5.1 (K), D6.1 (K), D7.1 (K), J1.2, J2.2 (GND), R2.2, R4.2, R6.2, U1.2 (IN-), U1.6 (OUT-), U2.2 (IN-), U2.4 (OUT-), U3.2 (IN-), U3.4 (OUT-), U4.2 (GND), U4.17 (GND)
/LED_ERROR: R11.1, U4.9 (GPIO33)
/LED_GREEN: R7.1, U4.7 (GPIO26)
/LED_RED: R9.1, U4.5 (GPIO14)
/LED_WIFI: R10.1, U4.8 (GPIO25)
/LED_YELLOW: R8.1, U4.6 (GPIO27)
/LOAD_RAIL: C2.1, SW1.1 (A), U3.1 (IN+), U4.1 (VIN)
/N_R7_D3: D3.2 (A), R7.2
/N_R8_D4: D4.2 (A), R8.2
/N_R9_D5: D5.2 (A), R9.2
/N_R10_D6: D6.2 (A), R10.2
/N_R11_D7: D7.2 (A), R11.2
/PACK_MINUS: BT1.2 (-), BT2.2 (-), U1.4 (B-)
/RAIL_4V7: C1.1, D1.1 (K), D2.1 (K), SW1.2 (B)
/SPEED_ADC: C3.1, R1.2, R2.1, U4.12 (GPIO34)
/SPEED_SIG: J2.3 (SPEED_OUT), R1.1
/TP_B+: F1.2, R5.1, U1.3 (B+)
/TP_OUT: U1.5 (OUT+), U2.1 (IN+)
/V12_SENSOR: J2.1 (VCC_12V), U3.3 (OUT+)
/VBAT: BT1.1 (+), BT2.1 (+), F1.1

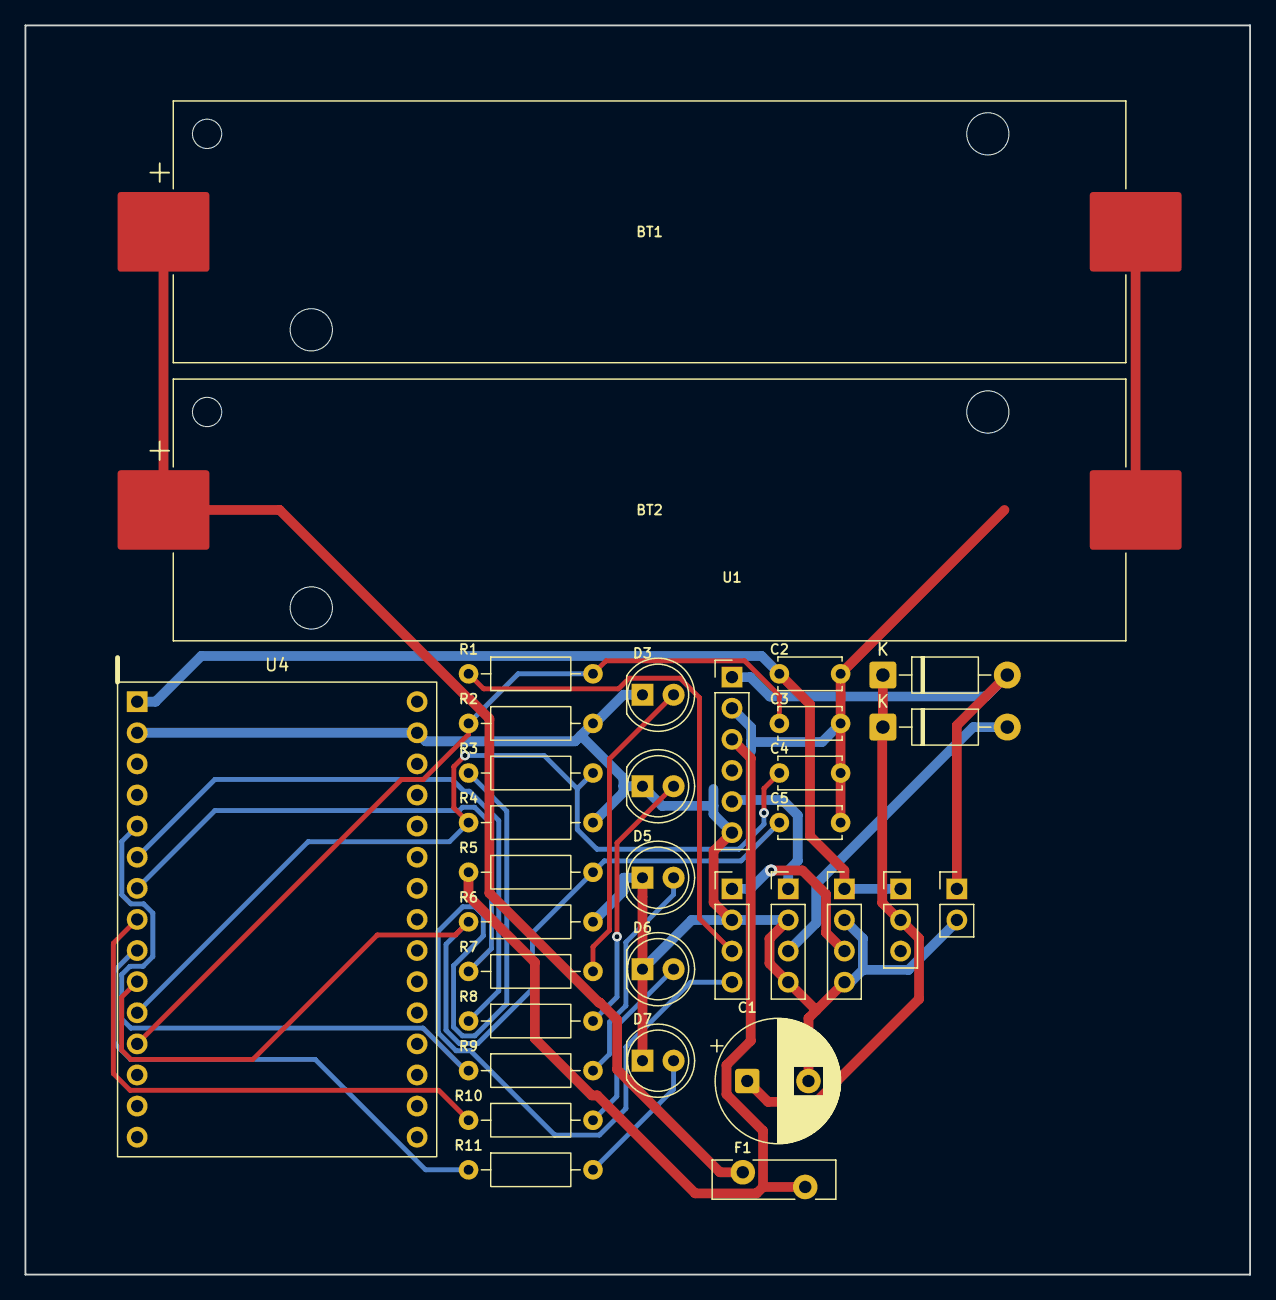
[picture p58: board WindStation.kicad_pcb from above]

Board: 2 copper layers, 100.0 x 102.0 mm, 33 parts (0 on the bottom side), 25 nets.
