temafey/ArduinoWindStation/esp32_wind_station/esp32_wind_station.ino

// ============================================
// WIND STATION — ESP32
// ============================================
// Sensor: Polycarbonate 0-5V (speed + direction)
// Signal divider: 15kΩ top + 10kΩ bottom → 5V → 2.0V (linear ADC zone 150 mV … 2.45V)
// Battery divider: 100kΩ + 100kΩ → GPIO32
// LEDs: 5 standard through 220Ω resistors
// Power (diode-OR load sharing):
//   Adapter 5V ─► Schottky_A ─┐
//                             ├─► Rail ~4.7V ─► ESP32 VIN + Mini Boost #1 → 12V for sensor
//   Bat ─► PTC ─► TP4056 ─► Mini Boost #2 (5V) ─► Schottky_B ─┘
//   Boost #2 keeps rail at 4.7V on battery — without it AMS1117 dropout (0.8–1.25V)
//   causes ESP32 brownout on WiFi TX peaks.
//   Both boosts: Mini Boost Module (HW-085/TMF002, MT3608 IC).
// Access: join the station's own WPA2 network, then http://MyWindProbeBETA.org
//         (192.168.4.1 always works too, and .local where mDNS is supported)
// OTA: flash over that same AP via Arduino IDE → Network Port
// ============================================

#include <WiFi.h>
#include <esp_wifi.h>     // esp_wifi_ap_get_sta_list — RSSI of the connected client
#include <DNSServer.h>    // resolves the station's own name for every client
#include <WebServer.h>
#include <ESPmDNS.h>
#include <ArduinoOTA.h>
#include <PPP.h>          // 4G uplink through the A7670E — see serviceModem()
#include <lwip/sockets.h> // lwip_send — the SSE frame goes out non-blocking, see sseFlush()
                          // and the interface-pinned reachability probe in modemProbe()
#include "web_content.h"  // dashboard build (gzip, PROGMEM) — see gen_web_header.py

// Every password this firmware needs lives in secrets.h, which is NOT in git.
// A missing file stops the build on purpose: the alternative is a board that
// silently comes up on an open network, and that failure is invisible until
// someone else is already on it.
#if __has_include("secrets.h")
  #include "secrets.h"
#else
  #error "secrets.h missing - copy esp32_wind_station/secrets.example.h to secrets.h and fill it in"
#endif

// The cloud channel is compiled in only when secrets.h says so, which is why these
// includes sit below it rather than with the others. All three ship inside the ESP32
// core already — esp-mqtt as libmqtt.a, mbedTLS for the command signatures, esp_random
// for the session nonce — so there is nothing to install and no library manager entry.
#if SECRET_HAS_CLOUD
  #include "mqtt_client.h"
  #include "mbedtls/md.h"
  #include "esp_random.h"
  // Pull-OTA: the station fetches its own image over the default route. HTTPClient pulls
  // NetworkClientSecure in with it, Update is the same staging code ArduinoOTA drives.
  #include <HTTPClient.h>
  #include <Update.h>
#endif

// ===== ACCESS POINT =====
// The AP is the station's own network and it is unconditional: it comes up at boot
// and nothing in this firmware ever takes it down. That is the whole lesson of the
// old station mode, which kept a pool of home/hotspot networks in NVS and joined
// the strongest one at boot — the moment it associated, softAPdisconnect() shut the
// AP down ~15 s after power-up and the station vanished from the phone.
//
// An uplink is back (see HAS_HOME_NETWORK below) but on the opposite terms: AP+STA,
// where joining a network is something the board does IN ADDITION to being an
// access point, never instead of it. What has not come back is the configurable
// part — the network list in NVS, /api/wifi?add|del|connect, the 30 s rescan and
// the 3-minute fallback AP are all still gone, and the uplink is one constant in
// this file rather than a form on a page.
// The address people actually type. It resolves because the station runs its own
// DNS server for exactly this one name — no mDNS support needed on the client, so
// it works on Android too, where .local is unreliable.
//
// A real TLD, chosen deliberately for how it reads. Two consequences worth knowing,
// neither of which breaks anything here:
//   - This name is not registered to us. While a device is joined to the station it
//     asks the board for DNS, so a genuine site at this domain would be shadowed for
//     that device. The AP has no uplink anyway, so nothing else is reachable either.
//   - Browsers try HTTPS first for a real TLD and fall back to HTTP when the
//     handshake fails, which costs a moment on the first visit. Nothing to fix on
//     the board — it never listens on 443.
// Case is irrelevant (DNS is case-insensitive and the server lowercases both sides);
// it is spelled out this way only because that is how it looks in the address bar.
const char* portalHost  = "MyWindProbeBETA.org";
// mDNS label (single word, no dots) → also answers as mywindprobebeta.local, and
// this is the name ArduinoOTA advertises in the IDE's network port list.
const char* hostname    = "mywindprobebeta";
const char* otaPassword = SECRET_OTA_PASSWORD;   // secrets.h
const char* apSsid      = "WindStation";
// WPA2-PSK. The ESP32 needs 8..63 characters here; below 8 softAP() silently
// falls back to an open network, so this length is not incidental.
const char* apPassword  = SECRET_AP_PASSWORD;    // secrets.h
// Four is the driver default and more than one dashboard ever needs — a lower cap
// is one less way for a stranger to occupy a slot even without the password.
const int   apMaxClients = 4;

// ===== HOME NETWORK (optional uplink) =====
// AP+STA: the AP above stays up unconditionally and the board ALSO joins a known
// 2.4 GHz network when one is in range. This is not the station mode that was
// removed — that one called softAPdisconnect() the moment it associated, which is
// why the station used to vanish from the phone ~15 s after power-up. Nothing here
// ever touches the AP; the uplink is strictly additive and its failure costs
// nothing but the uplink itself.
//
// What it buys: the dashboard is reachable from the house without leaving the
// network that has internet, and OTA runs over the LAN instead of forcing the
// laptop onto an AP with no uplink.
//
// Set to 0 for a pure access point (mast, field, anywhere the home net is out of
// range) — the retry loop below then does not exist at all.
// Comes from secrets.h so that a checkout whose secrets.h lists no networks still
// builds — as a pure access point, which is a working station and not a broken one.
#ifdef SECRET_HAS_HOME_NETWORK
  #define HAS_HOME_NETWORK SECRET_HAS_HOME_NETWORK
#else
  #define HAS_HOME_NETWORK 0
#endif

#if HAS_HOME_NETWORK
// The networks to try, in order of preference: home first, then the places the
// station actually travels to. Tried one per attempt, round-robin — never scanned.
// A scan would cost the AP a stall of its own before a single association is even
// attempted, and the list is short enough that walking it blind is cheaper.
//
// 2.4 GHz ONLY. The ESP32 has no 5 GHz radio, so the "-5G" twin of a dual-band
// router is invisible to it no matter what is written here.
//
// The list itself is SECRET_HOME_NETWORKS in secrets.h, which git does not track.
// It still ends up in plain text inside the compiled binary — that has not changed
// and cannot, since the firmware never writes NVS. What changed is that the
// passwords are no longer in the repository or its history.
struct HomeNetwork {
  const char* ssid;
  const char* password;
};
const HomeNetwork homeNetworks[] = { SECRET_HOME_NETWORKS };
const int homeNetworkCount = sizeof(homeNetworks) / sizeof(homeNetworks[0]);
#endif

// One association attempt gets this long before it is abandoned. A successful join
// takes 2-5 s; the rest is margin for a router that answers slowly. Only ever spent
// on a network a scan has just seen, so it is a wait for a slow answer and not a
// wait for silence.
const unsigned long STA_ASSOC_MS = 12000;
// Milliseconds the scan dwells on each of the 13 channels. Thirteen times this is
// how long the AP goes quiet per search, so the number is a direct cost: 120 ms
// gives ~1.6 s, short enough that an associated client rides it out on beacon-miss
// tolerance alone, long enough for a router's probe response to come back.
const unsigned long STA_SCAN_MS_PER_CHAN = 120;
// Backoff between searches. A search costs the AP its channel — the radio is one
// radio, and while it looks elsewhere the station's own network is off the air.
// That is what used to make the board unreachable from a phone in a field: six
// blind WiFi.begin() calls at 12 s each meant 72 s of thrashing after every
// power-up, and a phone's association simply does not survive it (a laptop retries
// long enough to slip through, which is why the fault looked like "phones only").
// Now a search is one scan, and if none of the known networks is on the air it ends
// there — no association is attempted at all. The wait still doubles after each
// failed search and resets the moment a link comes up.
const unsigned long STA_RETRY_MIN_MS = 30000;    // after the first failed search, 30 s
const unsigned long STA_RETRY_MAX_MS = 600000;   // ceiling, 10 min

// ===== PINS =====
#define PIN_WIND_SPEED   34   // ADC1 input-only — speed (via 15k/10k divider, Vadc 0-2.0V)
#define PIN_WIND_DIR     35   // ADC1 input-only — direction (via 15k/10k divider)
#define PIN_BATTERY      32   // ADC1 — battery (via 100k/100k divider)

// v4: LEDs moved to the ESP32 bottom pin row, 220Ω resistors now on the board.
// Old top-row pins were 26/27/14/25/33. GPIO4/16/17/18 are plain GPIO; GPIO5 is a strapping pin
// (must be HIGH at boot) — an LED-to-GND via 220Ω doesn't hold it low, so it only flickers briefly
// at power-up. Harmless: assigned to WiFi LED, which is meant to be off until WiFi is up anyway.
// Breadboard columns below are for the 38-pin DevKitC (schematic v8, board seated from column 1);
// on the old 30-pin board the same five pins sat two columns to the left, in 5..9.
#define PIN_LED_RED       4   // Red — wind > 15 m/s OR battery 10-30% (blink <10%) (col 7, was 14)
#define PIN_LED_YELLOW   16   // Yellow — wind > 5 m/s OR battery 30-60%            (col 8, was 27)
#define PIN_LED_GREEN    17   // Green — battery > 60% (was "station OK")           (col 9, was 26)
#define PIN_LED_WIFI      5   // Green — solid when reachable (AP client or uplink)  (col 10, was 25; strapping, boot flicker)
#define PIN_LED_ERROR    18   // Red — error (ADC/WiFi)                             (col 11, was 33)

// TP4056 status, open-drain: the IC pulls the pin to GND, so INPUT_PULLUP and LOW=active.
// GPIO13/19 chosen because neither is a strapping pin — an open-drain line held LOW at
// power-up on GPIO0/2/12/15 would change boot mode or flash voltage and brick the boot.
#define PIN_CHARGE       13   // TP4056 CHRG  — LOW while charging
#define PIN_STDBY        19   // TP4056 STDBY — LOW when charge complete (see HAS_STDBY)

// ===== 4G MODEM (A7670E) — AT CONSOLE OVER THE NETWORK =====
// Set to 0 on a board with no modem wired and none of this is compiled in. It is a flag
// rather than plain code for two reasons: the spare board has no modem at all, and on the
// mast the console has no business being reachable (see handleAt for what that buys).
#define HAS_MODEM 1

#if HAS_MODEM
// v6 layout: the module sits label-DOWN across breadboard columns 36..42 and its pads are
// identified by silkscreen letter, never by number. Two of them come back here:
//   col 37 = "R" = modem RXD  <- GPIO27 (this board's TX)
//   col 38 = "T" = modem TXD  -> GPIO25 (this board's RX)
// The letters deliberately do NOT match across the link — this board's TX drives the
// modem's RX. Swapping the pair leaves both ends deaf and looks exactly like a dead
// modem, so the letters are spelled out here and not only in the wiring diagram.
//
// Third layout for the same two wires, and every time the copper won: v6 was drawn for
// 27/26, on the 30-pin board the harness actually landed on 26/25, and on the 38-pin board
// (schematic v8) it lands on 27/25. So GPIO26 is now the free one and sits BETWEEN the two
// wires — nothing may be plugged into it, or the pair drifts apart again. GPIO33 stays
// reserved for the P-FET gate that will cut modem power.
//
// Both are ADC2 pins, which is allowed: the ADC2-vs-WiFi conflict is about analog reads
// only, and these two are a UART. Same exemption as GPIO4 (LED) and GPIO13 (CHRG).
#define PIN_MODEM_RX     25   // ESP32 receives here          (breadboard col 11)
#define PIN_MODEM_TX     27   // ESP32 sends here             (breadboard col 9)
// SIMCom's own default, and the module has never been moved off it. Serial2 defaults to
// GPIO16/17 — the yellow and green LEDs — so begin() is always given the pins explicitly.
const unsigned long MODEM_BAUD = 115200;

// The wiring actually in force. Separate from the constants above because both are worth
// changing without a reflash: which of the two wires landed on which pin is a coin flip
// that costs a USB session to guess wrong, and a modem sitting at the wrong baud looks
// exactly like a modem that is not wired at all. RAM only, same rule as /api/zero — the
// value that works has to be copied back into the constants to survive a reboot.
uint8_t       modemPinRx = PIN_MODEM_RX;
uint8_t       modemPinTx = PIN_MODEM_TX;
unsigned long modemBaud  = MODEM_BAUD;

// Everything the modem has said since the last command went out. Sized for the longest
// answer worth reading in one piece (AT+COPS=? runs a few hundred bytes) with room left
// for the NMEA stream AT+CGNSSTST=1 turns on. That stream never stops, which is why an
// overflow drops the OLDEST half instead of refusing new bytes: on a stream the part
// worth having is always the tail.
#define MODEM_BUF_CAP  2048
char   modemBuf[MODEM_BUF_CAP];
size_t modemLen = 0;
// Bytes ever received. This is the number that tells a firmware problem from a wiring
// problem: a console that echoes the command but leaves total at 0 means nothing is
// coming back on GPIO25 — wrong pin, wrong baud, or the modem has no power.
unsigned long modemRxTotal = 0;

// ===== 4G UPLINK (PPP) =====
// Turns the AT console into an actual network interface: esp-modem drives the same two
// wires, dials the operator and hands lwIP a routable address. A separate flag from
// HAS_MODEM because the two really are independent — a modem on the bench is worth
// talking to long before it is worth routing traffic through, and this is the switch
// that gives the UART back to the console if PPP itself turns out to be the problem.
#define MODEM_USE_PPP 1

#if MODEM_USE_PPP
// Not a secret and deliberately not in secrets.h: the operator hands this string to
// anyone who registers on the network, and a wrong APN has to be readable while
// debugging rather than hidden behind a macro. The network volunteered it itself during
// step 0b — it is not guessed.
#define MODEM_APN "internet.mnc003.mcc255.gprs"

// Which UART peripheral esp-modem drives. UART2 — the one Serial2 (the AT console) owns —
// and not the library's default of UART1, because UART1 is the display link's (see
// HAS_DISPLAY_LINK). Sharing is safe by construction: the console calls Serial2.end()
// before PPP.begin(), and modemPppRelease() reopens it only after PPP.end(), so the two
// never hold the peripheral at the same time. Each end() deletes the IDF driver, which
// is what lets the other side install its own.
// Until 2026-09-26 this was UART1. Harmless while nothing else wanted UART1, but note what
// a Serial1 started with default pins would have done then: the core's UART1 defaults are
// RX1=26 / TX1=27, and GPIO27 is the modem's RXD.
#define MODEM_PPP_UART 2

// Retry cadence. The first attempt is cheap because the usual failure is "the modem has
// not finished booting yet"; the ceiling is long because the usual PERSISTENT failure is
// "there is no LTE here at all", and a modem that cannot register burns ~0.1 A doing it.
// Same shape and the same ceiling as the WiFi uplink's backoff, for the same reason.
const unsigned long MODEM_RETRY_MIN_MS   = 15000;
const unsigned long MODEM_RETRY_MAX_MS   = 600000;   // 10 min
// Attachment is re-checked on a timer, not every pass: each check is a real AT+CGATT?
// round trip down the UART, and at 50 Hz that would be a permanent conversation.
const unsigned long MODEM_ATTACH_POLL_MS = 2000;
// Registration is neither instant nor guaranteed. Past this the DCE is torn down and the
// whole thing starts over: a module that has sat unattached for two minutes with a live
// SIM is wedged, not slow, and only a fresh bring-up clears that.
const unsigned long MODEM_ATTACH_MAX_MS  = 120000;
// From "CMUX is up" to "IPCP gave us an address". This part is out of our hands — it is
// the operator's PPP peer answering — and 45 s is several times the worst seen by hand.
const unsigned long MODEM_DIAL_MAX_MS    = 45000;
// How long the pre-flight AT waits for any answer at all before an attempt is abandoned.
// A modem that is awake replies in 10-20 ms, so this is generous by an order of magnitude
// and still two orders cheaper than letting PPP.begin() find out the hard way.
const unsigned long MODEM_PREFLIGHT_MS   = 300;

// Where the reachability probe knocks: 8.8.8.8:53. TCP, not ICMP, because a TCP connect
// is what the station will actually do for MQTT, and because lwIP gives us a raw socket
// but no ping. An address literal on purpose — resolving a name first would confuse "no
// route" with "no DNS", and those two failures have completely different fixes.
const uint32_t      MODEM_PROBE_ADDR     = 0x08080808;
const uint16_t      MODEM_PROBE_PORT     = 53;
const unsigned long MODEM_PROBE_MS       = 4000;
// Time over the modem, checked separately from the TCP reachability probe — see
// modemNtpProbe() for why a synced clock at home proves nothing about the 4G link.
// 216.239.35.0 = time1.google.com, an anycast address, used as a number so the check
// never depends on the resolver.
const uint32_t      MODEM_NTP_ADDR       = 0xD8EF2300;
const unsigned long MODEM_NTP_MS         = 4000;

// Where the bring-up is. Named states rather than a pile of booleans because the whole
// point of this machine is that /api/modem can say exactly which step is stuck, and
// "attached but never dialled" and "dialled but no address" are different faults.
enum ModemPppState : uint8_t {
  MODEM_PPP_STOPPED,    // the console owns the UART: nothing tried yet, or PPP released
  MODEM_PPP_ATTACHING,  // DCE up and answering AT, waiting for the network to attach
  MODEM_PPP_DIALING,    // CMUX entered, waiting for the PPP peer to negotiate an address
  MODEM_PPP_ONLINE,     // address in hand, the interface is usable
  MODEM_PPP_FAILED      // gave up; sitting out the backoff before trying again
};
ModemPppState modemPppState   = MODEM_PPP_STOPPED;
// RAM only, same rule as /api/zero and the pin override above: /api/modem?off turns the
// uplink off for this session, and what should survive a reboot goes into MODEM_USE_PPP.
bool          modemPppEnabled = true;
unsigned long modemNextTry    = 0;      // 0 = try on the very first pass through loop()
unsigned long modemRetryMs    = MODEM_RETRY_MIN_MS;
unsigned long modemStateSince = 0;      // when the current state was entered
unsigned long modemAttachPoll = 0;
uint16_t      modemTries      = 0;
String        modemLastError;

// Worst single stall this subsystem has ever cost loop(). Kept strictly apart from
// loopMaxMs, and that separation is the point: PPP.begin() and every AT round trip are
// synchronous calls that genuinely do block, so folding them in would swamp the telemetry
// window they land in with a number that only ever means "the modem was busy" — exactly
// the window someone would be reading to see whether the modem hurt the sensor loop.
// Unlike loopMaxMs this one is never reset: it is a high-water mark for the whole uptime,
// because the expensive events are rare and the point is to catch them at all. Both
// numbers are reported, neither is hidden. Measured on the bench: 188 ms for a bring-up
// that reached the network on the first attempt, against loopMax 3 ms while online.
unsigned long modemBusyMaxMs  = 0;

// Radio facts, cached. Every one of these is an AT round trip over the CMUX channel —
// PPP.RSSI() alone is a full AT+CSQ conversation with the module — which is exactly why
// /api/modem hides them behind ?radio=1 instead of answering them on every read. The
// telemetry frame is built up to 20 times a second, so asking the modem from inside
// buildDataJson() would put four synchronous UART conversations into every frame and
// starve the 50 Hz sensor loop outright. So they are asked once a minute from loop() and
// the frame only ever reads memory.
//
// One minute is chosen from what the numbers are for: signal strength and operator are
// "what kind of link is this", not a waveform — a dashboard gauge that lags reality by
// under a minute tells the same story, and the cost of being wrong is nil. Going faster
// would buy nothing and spend loop() time on every tick.
struct ModemRadio {
  int      rssi;        // dBm from AT+CSQ as the driver maps it; 99 = "module does not know"
  int      mode;        // PPP::networkMode() code — which radio access technology answered
  char     oper[24];    // network name; long enough for the longest PLMN alpha tag seen
  bool     attached;    // packet service attached, i.e. data is possible at all
  uint32_t at;          // millis() of the refresh that filled this; 0 = never filled
};
ModemRadio modemRadio = { 0, 0, "", false, 0 };
// How stale the cache is allowed to get before loop() spends AT time refilling it.
const unsigned long MODEM_RADIO_POLL_MS = 60000;

// Declared up here because buildDataJson() sits well above the PPP section but reports
// from it, and the .ino preprocessor does not generate prototypes for static functions.
static const char* modemPppStateName();
static void        modemRadioRefresh();
#endif  // MODEM_USE_PPP
#endif

// ===== WALL CLOCK =====
// A real date is not a convenience here, it is the gate in front of the first TLS
// handshake: a certificate is checked against the clock, and a board that boots at
// 1970 rejects every valid certificate it is shown. So nothing that needs TLS may run
// until this says the year is sane.
//
// The time comes from SNTP over whichever uplink is the default route — WiFi at home,
// PPP on the mast — and deliberately NOT from the modem's own clock, even though
// AT+CTZU=1 is set and the network does deliver NITZ. Measured on the bench 2026-09-11:
// AT+CCLK? returned "26/09/11,16:57:42+00" while real UTC was 08:57:42 — the date right,
// the clock ticking at the right rate, and the time of day exactly 8 hours ahead while
// claiming a zero offset. Eight hours is Beijing, which says where the bias comes from
// but not how to correct it portably. It happens to be harmless for certificate validity
// (those are measured in months) and fatal for anything that timestamps a sample, so the
// modem clock is used for one thing only: the cheap "is the year past 2020" sanity check
// on a link that has just come up. Real timestamps come from here.
#define NTP_SERVER_PRIMARY   "pool.ntp.org"
#define NTP_SERVER_SECONDARY "time.google.com"
// 2020-01-01T00:00:00Z. Anything below this is the SDK's un-synced epoch, not a date.
const time_t   CLOCK_VALID_EPOCH = 1577836800;
const unsigned long CLOCK_POLL_MS = 1000;   // time(nullptr) is cheap, but not free

bool          clockStarted   = false;  // configTime() called once; SNTP retries on its own
bool          clockValid     = false;  // latched true the first time the year looks real
unsigned long clockPoll      = 0;
unsigned long clockValidAtMs = 0;      // uptime at first sync — shows how long the gate held

// ===== CALIBRATION =====
// Signal divider: 15k top + 10k bottom → Vout = Vin × 10/(15+10) = Vin × 0.4
// Inverse: Vsensor = Vadc × (15+10)/10 = Vadc × 2.5
// Why 2.0V not 3.0V: ESP32 ADC linear zone at 11dB is 150 mV … 2.45V;
// old 10k+15k gave 3.0V and entered nonlinear zone (speeds >49 m/s were underread).
const float SIGNAL_DIVIDER_RATIO  = 2.5f;
// Battery divider 100k+100k: Vbat = Vadc × 2.0
const float BATTERY_DIVIDER_RATIO = 2.0f;

const float SENSOR_VMAX = 5.0f;    // max sensor output voltage
// NEW sensor (voltage type 0-5V, DFRobot SEN0170 clone): 0-30 m/s, speed only.
// Old sensor was 0-60 m/s — leaving 60 here doubles every reading.
const float SPEED_MAX   = 30.0f;   // m/s at 5V
const float DIR_MAX     = 360.0f;  // degrees at 5V (old sensor only, see HAS_DIRECTION)

// New sensor has no direction channel — GPIO35 hangs unconnected.
// Set to 1 only if the old speed+direction sensor is wired back.
#define HAS_DIRECTION 0

// ESP32 ADC1 @11dB cannot read below ~150 mV: with 0 V in, analogReadMilliVolts()
// bottoms out around this value. Measured on this board at 0 wind: 143-145 mV on
// both GPIO34 and GPIO35 (identical floor on both = proof it is the ADC, not signal).
// Re-measure with the sensor still (see speedMv in /api/data) and update if the
// board changes.
//
// This floor is a SATURATION, not an offset. Above it the calibrated reading tracks
// the input; below it every input collapses onto the same ~145 mV. So it is used as a
// gate — at or under it the air is calm and speed is 0 — and is NOT subtracted from
// readings above it. Subtracting it (what this code did until 2026-08-08) shifted the
// whole scale down by one full floor: at 66.7 mV per m/s that is 2.2 m/s off every
// single sample, so a true 3 m/s reported 0.8 and a true 10 reported 7.8. Symptom:
// the station looked dead unless the cups were spun hard.
// Set a few mV above the measured floor so noise at rest cannot leak a phantom value.
// CONSEQUENCE, unchanged by the fix: real speeds below ~2.3 m/s still report 0, and
// the reading jumps straight from 0 to ~2.3 when the sensor crosses the gate. There is
// no measurement down there to interpret — firmware can stop corrupting the rest of
// the range, but it cannot invent the bottom of it. Only a level shift on the divider
// or an external ADC moves that boundary. HAS_LEVEL_SHIFT below is the first of those.
const float SPEED_ZERO_MV = 150.0f;

// ===== LOW-WIND LEVEL SHIFT (optional hardware mod) =====
// The whole reason the station is deaf below ~2.3 m/s (8 km/h) is that 0 m/s sits at
// 0 mV, i.e. inside the ADC's dead zone. Lift the divider node with a third resistor
// from 3V3 and 0 m/s lands at ~0.37 V instead — 200 mV clear of the floor, so the
// bottom of the range becomes an actual measurement and the gate can go back to being
// a plain offset subtraction.
//
//   sensor ──[15k]──┬── GPIO34        R3 from 3V3 to the same node
//                [10k]                (see FIRMWARE.md for the arithmetic)
//                  GND
//
// Set to 1 ONLY after R3 is physically fitted — with no resistor on the board this
// subtracts a bias that is not there and every reading comes out ~6 m/s low.
#define HAS_LEVEL_SHIFT 0

#if HAS_LEVEL_SHIFT
// R3 = 47k. Nominal figures for 15k/10k/47k off a 3.30 V rail:
//   bias at 0 m/s   0.374 V      gain 0.3548      full scale 2.15 V at 30 m/s
//   scale           59.1 mV per m/s   (was 66.7 without the shift)
// Both constants are NOMINAL and both must be replaced with measured values: the rail
// is not exactly 3.30 V and 5% resistors move the bias by tens of mV, which is whole
// tenths of a m/s at the bottom. Measure with /api/zero, see FIRMWARE.md.
const float SPEED_BIAS_MV_DEFAULT  = 374.0f;
// Inverse of the new divider gain, 1/0.3548. Replaces SIGNAL_DIVIDER_RATIO — R3 loads
// the node in parallel with the 10k, so the sensor sees a different ratio than before.
const float SIGNAL_DIVIDER_SHIFTED = 2.819f;
// Guard band above the measured bias, in mV. Only job is to keep ADC noise at rest from
// reading as a light breeze; at 59 mV per m/s, 6 mV is 0.1 m/s of deadband.
const float SPEED_BIAS_DEADBAND_MV = 6.0f;
#endif

// The zero point actually in use. Starts at the compile-time constant and can be
// re-measured in place through /api/zero without a reflash — the value that matters
// here is a property of this board's resistors and this chip's ADC offset, so it is
// worth being able to correct it with the sensor sitting still in front of you.
// Not persisted: NVS is never written by this firmware (see the OTA notes), so a
// number found in the field has to be copied back into the constant above to survive
// a reboot. /api/zero prints it in a form that can be pasted straight in.
#if HAS_LEVEL_SHIFT
float speedZeroMv = SPEED_BIAS_MV_DEFAULT;
#else
float speedZeroMv = SPEED_ZERO_MV;
#endif

// Battery divider now taps the holder wire, not TP_B+ (TP4056 back-feeds TP_B+ from
// USB and fakes a battery). No pack wired -> node floats, R6 100k pulls it to 0.
const float BATTERY_PRESENT_MV = 500.0f;  // <0.5V on pin (=1.0V pack) means absent

const float BATTERY_MIN = 3.5f;    // 0% — below this Mini Boost #2 loses regulation (MT3608 min Vin ~2V, but margin shrinks at 3.5V), rail 4.7V sags
const float BATTERY_MAX = 4.2f;    // 100%

// Set to 1 once TP4056 STDBY is wired to PIN_STDBY. With CHRG alone "full" cannot be
// told from "running on battery": CHRG goes high-Z both when charging finishes and when
// USB is unplugged. Without STDBY we fall back to a voltage guess, which misreads a
// freshly charged pack on battery power as "full".
#define HAS_STDBY 1
#if !HAS_STDBY
const float BATTERY_FULL_V = 4.05f;  // fallback "full" threshold when HAS_STDBY is 0
#endif

// External power is derived from the two status lines rather than measured on IN+:
// the TP4056 can only pull CHRG or STDBY low while its own input is powered, so
// "either line active" == "cable plugged in". Saves a divider and an ADC pin.
// Sticky release, not a plain sample: with no pack the IC ping-pongs charge<->standby
// at ~1 Hz and both lines read inactive in the gap between the two states. Asserting
// on the first active sample but releasing only after this hold keeps the dashboard
// steady while still noticing an unplugged cable within a few seconds.
const unsigned long STATUS_HOLD_MS = 3000;

// ===== STATE =====
float windSpeed = 0;
float windDir   = 0;
float windGust  = 0;
// Averaged millivolts on the speed pin, before the calm gate. Exposed only so the
// floor can be re-measured in place: open /api/data with the sensor still and read
// speedMv — that number is what SPEED_ZERO_MV has to sit just above.
float speedMvRaw = 0;
// Spread of the 32 raw samples in one burst (max - min), in millivolts. This is the
// number that answers "is the radio getting into the analog side": with the sensor
// still it should be single-digit mV, and it stays that way whether or not a dashboard
// is streaming. Tens of mV that appear only while WiFi is transmitting mean the
// interference is real and belongs in a capacitor, not in a firmware constant.
float speedMvSpread = 0;
float batteryVoltage = 0;
int   batteryPercent = 0;
bool  batteryPresent = false;
// "absent" | "charging" | "full" | "discharging" — what the dashboard shows
const char* chargeState = "absent";
// "external" | "battery" — where the rail is fed from right now
const char* powerSource = "battery";

// Debounce state for the two open-drain status lines. `seen` guards the boot window:
// millis() starts at 0, so a bare "millis() - lastLow < HOLD" would read as recently
// active for the first 3 s after reset and report a cable that is not there.
bool chrgSeen = false,  stdbySeen = false;
unsigned long chrgLastLow = 0, stdbyLastLow = 0;
// In AP mode there is no uplink to measure, so this holds the RSSI of the client
// the station hears best — same units, same "is the link any good" question.
int   wifiRssi  = 0;
bool  adcError  = false;

unsigned long gustResetTimer = 0;

// Ring buffer for circular mean of direction
#define DIR_BUF_SIZE 5
float dirSinBuf[DIR_BUF_SIZE] = {0};
float dirCosBuf[DIR_BUF_SIZE] = {0};
int   dirBufIdx   = 0;
int   dirBufCount = 0;

// Per-LED mode instead of plain on/off: the API accepts "off"/"on"/"blink"
// (legacy true/false still parse). Blink phase is shared and flips in
// updateLEDs() every 500 ms → 1 Hz blink, so all blinking LEDs stay in sync.
enum LedMode : uint8_t { LED_MODE_OFF = 0, LED_MODE_ON = 1, LED_MODE_BLINK = 2 };
LedMode ledGreen  = LED_MODE_OFF;
LedMode ledYellow = LED_MODE_OFF;
LedMode ledRed    = LED_MODE_OFF;
LedMode ledWifi   = LED_MODE_BLINK;  // blinking until WiFi is up
bool ledAutoMode = true;
bool blinkPhase  = false;

// ===== ACCESS POINT STATE =====
bool apUp = false;   // softAP() came up; false only if the radio failed outright

// ===== WHO CAME TO THE AP AND WHY THEY LEFT =====
// A client that cannot associate is invisible from the inside: softAPgetStationNum()
// only counts the ones that made it, so a phone stuck on "Connecting..." leaves no
// trace at all. The driver does say what happened — WIFI_EVENT_AP_STADISCONNECTED
// carries an 802.11 reason code — and this ring is the only place that survives long
// enough to read it: the laptop associates fine, so it can watch the phone fail from
// /api/wifi without a USB cable anywhere near a field.
//
// Written from the WiFi event task and read from the HTTP task without a lock. Both
// indices are single bytes and the entries are plain values, so the worst a race can
// do is print one stale line. A mutex here would cost more than the mistake.
#define AP_LOG_N 8
struct ApEvent {
  unsigned long ms;      // millis() when it happened
  uint8_t  mac[6];
  bool     joined;       // true = associated, false = left or was refused
  uint16_t reason;       // 802.11 reason code, meaningful only when joined == false
};
ApEvent apEventLog[AP_LOG_N];
uint8_t apEventCount = 0;   // how many slots are filled, saturates at AP_LOG_N
uint8_t apEventNext  = 0;   // where the next one goes

void apEventPush(const uint8_t* mac, bool joined, uint16_t reason) {
  ApEvent& e = apEventLog[apEventNext];
  e.ms = millis();
  memcpy(e.mac, mac, 6);
  e.joined = joined;
  e.reason = reason;
  apEventNext = (apEventNext + 1) % AP_LOG_N;
  if (apEventCount < AP_LOG_N) apEventCount++;
}

// Why the chip last started. Reported in /api/data because a station used away from
// the house runs on a battery, and a battery that sags under a transmit burst resets
// the board — which from the outside looks exactly like "it will not let my phone
// connect". Uptime alone does not distinguish a fresh power-up from a brownout loop;
// this does, and it is the one question the dashboard cannot answer by measuring.
const char* resetReasonName() {
  switch (esp_reset_reason()) {
    case ESP_RST_POWERON:  return "poweron";
    case ESP_RST_BROWNOUT: return "brownout";   // supply sagged — battery or wiring
    case ESP_RST_PANIC:    return "panic";
    case ESP_RST_TASK_WDT:
    case ESP_RST_WDT:
    case ESP_RST_INT_WDT:  return "watchdog";
    case ESP_RST_SW:       return "software";   // OTA finished, or Restart()
    case ESP_RST_EXT:      return "external";   // the EN button
    case ESP_RST_DEEPSLEEP: return "deepsleep";
    default:               return "unknown";
  }
}

#if HAS_HOME_NETWORK
// ===== UPLINK STATE =====
// Driver auto-reconnect is turned off in setup() so there is exactly one place that
// decides when to associate — otherwise the driver's own retries and the backoff
// below would both be scanning, and the AP would stall twice as often for it.
bool staUp = false;                              // last observed link state
unsigned long staBackoffMs  = STA_RETRY_MIN_MS;  // wait after a failed search
unsigned long staNextAttempt = 0;                // millis() of the next search
bool staScanning = false;                        // an async scan is in flight
int  staTrying = -1;                             // homeNetworks[] index being joined, -1 = none
unsigned long staAssocDeadline = 0;              // when to abandon that association
// WiFi.status() is only ever written by driver events, never by begin(), so the
// value standing when an association starts is the previous attempt's verdict.
// Kept here so a failure can be told from a leftover: see serviceUplink().
wl_status_t staStatusAtBegin = WL_NO_SHIELD;
// Set when a completed scan saw none of the known networks. It is the "we are
// somewhere else entirely" flag, and it is what buys a client on the AP total
// radio silence: see the guard in serviceUplink().
bool staNoneInRange = false;
// Candidates already tried and failed in the current pass over the list, one bit per
// homeNetworks[] entry. Without this the search re-picks the same network forever:
// `best` is recomputed from preference order on every scan, so a network that is on
// the air but will not let us in — stale password, a neighbour broadcasting the same
// name, a router refusing the join — hides every network below it in the list, and
// the board never tries the one that would have worked. The blind walk it replaced
// did get to them. Cleared when a link comes up and when a pass has tried everything
// the air had to offer.
//
// Entries past bit 31 are simply never excluded. The list is a handful of names in a
// header file, and degrading to the old behaviour is the right failure for a station
// that would have to grow a 33rd network first.
uint32_t staFailedMask = 0;
inline bool staHasFailed(int k) { return k < 32 && (staFailedMask & (1UL << k)); }
inline void staMarkFailed(int k) { if (k < 32) staFailedMask |= (1UL << k); }
#endif

// Catch-all DNS: every name resolves to the station. That is deliberate and it is
// what makes the dashboard open by itself.
//
// It started as name-only resolution, precisely to avoid answering the phone's
// connectivity probe (connectivitycheck.gstatic.com, captive.apple.com,
// msftconnecttest.com) and the "sign in to network" nag that follows. That nag
// turned out to be the feature: answering the probe is how a phone learns there
// is a page worth opening, and it removes the need to type an address at all —
// which also sidesteps the real reason typing failed, namely browsers resolving
// names through their own DNS-over-HTTPS instead of the one the AP handed out.
//
// The trade-off is now accepted on purpose: the network reads as "needs sign-in",
// and any other site opened while joined lands on the dashboard. There is no
// internet through this AP anyway, so nothing else was reachable to begin with.
//
// AsyncUDP-based, so it serves requests from its own task — nothing to pump in
// loop(); DNSServer::processNextRequest() is an empty stub in this core.
DNSServer dnsServer;

// Number of clients currently associated. Cheap enough to call from updateLEDs().
int apClients() {
  return WiFi.softAPgetStationNum();
}

// The dashboard has one signal field, so this reports whichever link the dashboard
// is most likely looking through. A client associated to our AP wins: it is the
// direct link to whoever is reading the page. Only when the AP is empty does the
// uplink RSSI stand in — that is the case where the page is being served over the
// home network and WiFi.RSSI() is the link that matters.
// 0 when there is neither, which is how the UI already renders "no signal".
int readClientRssi() {
  wifi_sta_list_t stations;
  if (esp_wifi_ap_get_sta_list(&stations) == ESP_OK && stations.num > 0) {
    int best = -127;
    for (int i = 0; i < stations.num; i++) {
      if (stations.sta[i].rssi > best) best = stations.sta[i].rssi;
    }
    return best;
  }
#if HAS_HOME_NETWORK
  if (WiFi.status() == WL_CONNECTED) return WiFi.RSSI();
#endif
  return 0;
}

WebServer server(80);

// ===== SENSOR READ =====
// Sampling cadence, deliberately faster than the SSE push: every frame then carries a
// freshly averaged value instead of one up to a whole push period stale, and a gust
// peak lands inside a sample set rather than in the gap between two reads.
const unsigned long READ_INTERVAL_MS = 20;   // 50 Hz

void readSensors() {
  // 32, not 10: averaging N samples of the same instant cuts ADC noise by sqrt(N),
  // so 3.2x more samples buys 1.8x less jitter on the number. At ~80 us per
  // analogReadMilliVolts() the burst costs ~2.6 ms, ~13% of the 20 ms budget.
  const int SAMPLES = 32;
  // Interquartile mean, not a plain average. A WiFi transmit burst is ~1 ms of a few
  // hundred mA through the same rails and a strong near field over the same board, and
  // the 2.6 ms sample burst is short enough to land inside one — so the disturbance is
  // not white noise sprinkled over the set, it is a contiguous run of samples pushed
  // the same way. A mean carries that straight into the reading; discarding the lowest
  // and highest eight survives a burst that corrupts up to a quarter of the set at each
  // end. Price is the noise floor: sqrt(16) instead of sqrt(32) of averaging, ~1.4x more
  // jitter on a quiet board, which is the cheaper of the two errors by far.
  const int TRIM = 8;
  uint16_t s[SAMPLES];
  for (int i = 0; i < SAMPLES; i++) {
    s[i] = (uint16_t)analogReadMilliVolts(PIN_WIND_SPEED);
  }
  // Insertion sort: 32 elements, already-near-sorted in the common case, and it costs
  // a few microseconds against the 2.6 ms the conversions themselves take.
  for (int i = 1; i < SAMPLES; i++) {
    uint16_t v = s[i];
    int j = i - 1;
    while (j >= 0 && s[j] > v) { s[j + 1] = s[j]; j--; }
    s[j + 1] = v;
  }
  speedMvSpread = (float)(s[SAMPLES - 1] - s[0]);   // diagnostic, see the declaration
  uint32_t speedMvSum = 0;
  for (int i = TRIM; i < SAMPLES - TRIM; i++) {
    speedMvSum += s[i];
  }
  float speedMvAvg = speedMvSum / (float)(SAMPLES - 2 * TRIM);

  // Signal loss detector: pin pulled hard to GND for ~30 s.
  // NOTE: this can no longer catch a pulled signal wire — an open input reads the
  // same ~145 mV ADC floor as a sensor sitting at 0 V. Only a dead short shows up.
  // Trip count is tied to READ_INTERVAL_MS, not a bare sample count: the detector is
  // about "dead-low for ~1.5 s", and speeding the loop from 100 ms to 20 ms would
  // otherwise fire the error LED after 300 ms and make it flicker on noise.
  static const uint16_t ZERO_TRIP = 1500 / READ_INTERVAL_MS;
  static uint16_t zeroReadings = 0;
  if (speedMvAvg < 10.0f) {
    if (zeroReadings < ZERO_TRIP) zeroReadings++;
  } else {
    zeroReadings = 0;
  }
  adcError = (zeroReadings >= ZERO_TRIP);

  speedMvRaw = speedMvAvg;   // published for field calibration, see /api/zero

#if HAS_LEVEL_SHIFT
  // With R3 fitted, 0 m/s is a real voltage sitting well above the ADC floor, so the
  // zero point IS an additive offset now and subtracting it is correct — the exact
  // opposite of the no-shift case below, which is why the two must never be mixed up.
  float speedMv = (speedMvAvg <= speedZeroMv + SPEED_BIAS_DEADBAND_MV)
                    ? 0.0f : (speedMvAvg - speedZeroMv);
  float vSpeedSensor = (speedMv / 1000.0f) * SIGNAL_DIVIDER_SHIFTED;
#else
  // Gate on the ADC floor instead of subtracting it: at or below the floor there is no
  // signal to read (calm air), above it the calibrated millivolts are already the input.
  float speedMv = (speedMvAvg <= speedZeroMv) ? 0.0f : speedMvAvg;
  float vSpeedSensor = (speedMv / 1000.0f) * SIGNAL_DIVIDER_RATIO;
#endif
  windSpeed = constrain(vSpeedSensor / SENSOR_VMAX * SPEED_MAX, 0.0f, SPEED_MAX);

#if HAS_DIRECTION
  uint32_t dirMvSum = 0;
  for (int i = 0; i < SAMPLES; i++) {
    dirMvSum += analogReadMilliVolts(PIN_WIND_DIR);
  }
  float dirMvAvg   = dirMvSum / (float)SAMPLES;
  float vDirSensor = (dirMvAvg / 1000.0f) * SIGNAL_DIVIDER_RATIO;
  float dirRaw = constrain(vDirSensor / SENSOR_VMAX * DIR_MAX, 0.0f, DIR_MAX);

  // Circular mean via sin/cos to correctly handle 0°↔360° wrap
  float rad = dirRaw * DEG_TO_RAD;
  dirSinBuf[dirBufIdx] = sinf(rad);
  dirCosBuf[dirBufIdx] = cosf(rad);
  dirBufIdx = (dirBufIdx + 1) % DIR_BUF_SIZE;
  if (dirBufCount < DIR_BUF_SIZE) dirBufCount++;

  float sSum = 0, cSum = 0;
  for (int i = 0; i < dirBufCount; i++) {
    sSum += dirSinBuf[i];
    cSum += dirCosBuf[i];
  }
  float meanRad = atan2f(sSum / dirBufCount, cSum / dirBufCount);
  windDir = fmodf(meanRad * RAD_TO_DEG + 360.0f, 360.0f);
#else
  windDir = 0;   // no direction channel; API reports null, not this value
#endif

  if (windSpeed > windGust) windGust = windSpeed;
}

// ===== BATTERY READ =====
void readBattery() {
  const int SAMPLES = 10;
  uint32_t mvSum = 0;
  for (int i = 0; i < SAMPLES; i++) {
    mvSum += analogReadMilliVolts(PIN_BATTERY);
  }
  float mvAvg = mvSum / (float)SAMPLES;

  // Divider top sits on the pack's own sense wire. Pack unplugged -> the column is
  // fed only by R6 100k to GND -> a few mV -> absent. Do not report a fake voltage.
  batteryPresent = (mvAvg >= BATTERY_PRESENT_MV);
  if (!batteryPresent) {
    batteryVoltage = 0;
    batteryPercent = 0;
    return;
  }

  batteryVoltage = (mvAvg / 1000.0f) * BATTERY_DIVIDER_RATIO;

  float pct = (batteryVoltage - BATTERY_MIN) / (BATTERY_MAX - BATTERY_MIN) * 100.0f;
  batteryPercent = (int)constrain(pct, 0.0f, 100.0f);
}

// ===== CHARGER STATUS =====
// True while the line reads active, and for STATUS_HOLD_MS after it stops. Open-drain:
// LOW means the TP4056 is pulling the line, i.e. that state is on.
static bool heldLow(uint8_t pin, bool &seen, unsigned long &lastLow) {
  if (digitalRead(pin) == LOW) {
    seen = true;
    lastLow = millis();
    return true;
  }
  return seen && (millis() - lastLow < STATUS_HOLD_MS);
}

// Called every 100 ms — readBattery()'s 30 s cadence would land on a random phase of
// the ~1 Hz blink and report charge state at the flip of a coin.
void readChargeStatus() {
  // Both lines must be sampled every pass, so evaluate before combining rather than
  // letting || short-circuit the second call and stall its debounce timer.
  bool charging = heldLow(PIN_CHARGE, chrgSeen, chrgLastLow);
#if HAS_STDBY
  bool charged  = heldLow(PIN_STDBY, stdbySeen, stdbyLastLow);
#else
  bool charged  = false;
#endif

  // The IC drives these pins only when its own input is powered, so either one active
  // proves the cable is in. Both idle means the rail is coming from the pack.
  powerSource = (charging || charged) ? "external" : "battery";

  if (!batteryPresent) {
    chargeState = "absent";
  } else if (charging) {
    chargeState = "charging";
  } else if (charged) {
    chargeState = "full";
#if !HAS_STDBY
  } else if (batteryVoltage >= BATTERY_FULL_V) {
    chargeState = "full";
#endif
  } else {
    chargeState = "discharging";
  }
}

// ===== LEDs =====
static void applyLed(uint8_t pin, LedMode m) {
  bool lit = (m == LED_MODE_ON) || (m == LED_MODE_BLINK && blinkPhase);
  digitalWrite(pin, lit ? HIGH : LOW);
}

void updateLEDs() {
  bool wifiOk = apUp;  // the AP is the whole network now — nothing to lose or retry
  blinkPhase = !blinkPhase;  // called every 500 ms → 1 Hz blink

  if (ledAutoMode) {
    // Green — battery above 60%. Off when no pack is wired (nothing to report).
    ledGreen = (batteryPresent && batteryPercent > 60) ? LED_MODE_ON : LED_MODE_OFF;

    // Yellow/red combine wind and battery with OR: either condition lights the LED.
    // In practice they rarely collide — the pack only drains when mains is gone.
    bool batYellow = batteryPresent && batteryPercent >= 30 && batteryPercent <= 60;
    ledYellow = (windSpeed > 5.0f || batYellow) ? LED_MODE_ON : LED_MODE_OFF;

    if (batteryPresent && batteryPercent < 10) {
      ledRed = LED_MODE_BLINK;  // critically low pack outranks the wind indication
    } else {
      bool batRed = batteryPresent && batteryPercent >= 10 && batteryPercent < 30;
      ledRed = (windSpeed > 15.0f || batRed) ? LED_MODE_ON : LED_MODE_OFF;
    }

    // WiFi LED: solid when the station is reachable by someone, blinking when it is
    // shouting into an empty room. "Reachable" is either a client on the AP or a live
    // uplink — a board sitting on the home network with nobody's phone attached is
    // working perfectly, and it used to blink anyway, which trained the eye to ignore
    // the one LED that is supposed to mean "look at me". Blink is now the exception.
    bool reachable = apClients() > 0;
#if HAS_HOME_NETWORK
    reachable = reachable || staUp;
#endif
    ledWifi = (wifiOk && reachable) ? LED_MODE_ON : LED_MODE_BLINK;
  }

  applyLed(PIN_LED_GREEN,  ledGreen);
  applyLed(PIN_LED_YELLOW, ledYellow);
  applyLed(PIN_LED_RED,    ledRed);
  applyLed(PIN_LED_WIFI,   ledWifi);
  digitalWrite(PIN_LED_ERROR, (adcError || !wifiOk) ? HIGH : LOW);
}

const char* ledModeStr(LedMode m) {
  switch (m) {
    case LED_MODE_ON:    return "on";
    case LED_MODE_BLINK: return "blink";
    default:             return "off";
  }
}

// "on"/"true" → on, "blink" → blink, anything else ("off"/"false") → off.
// true/false kept so an older dashboard build keeps working.
LedMode parseLedMode(const String& v) {
  if (v == "blink")             return LED_MODE_BLINK;
  if (v == "on" || v == "true") return LED_MODE_ON;
  return LED_MODE_OFF;
}

// ===== HTTP API =====
// Read-only endpoints stay wide open. The wildcard is deliberate: the same
// dashboard bundle is also published over HTTPS as a demo, and a browser there
// must at least be able to try.
void sendCors() {
  server.sendHeader("Access-Control-Allow-Origin", "*");
}

// Headers put on every embedded page. None of them make an http:// origin a
// secure context — only real TLS does that, and a station on a private IP cannot
// hold a CA-signed certificate — but they are the part that is actually free.
// Permissions-Policy explicitly *allows* geolocation for our own origin so the
// browser's own gate is the only thing left in the way, and shuts the doors
// nothing here uses.
void sendPageSecurity() {
  server.sendHeader("X-Content-Type-Options", "nosniff");
  server.sendHeader("Referrer-Policy", "no-referrer");
  server.sendHeader("Permissions-Policy",
                    "geolocation=(self), camera=(), microphone=(), usb=(), payment=()");
  // https: is needed wholesale in img/connect: the world map pulls live warnings
  // from api.weather.gov and radar rasters from NOAA, and those hostnames are not
  // ours to pin. 'unsafe-inline' for styles because the whole dashboard is styled
  // with inline style attributes on purpose — see the note in wind-dashboard.jsx.
  server.sendHeader("Content-Security-Policy",
                    "default-src 'self'; script-src 'self'; "
                    // blob: is not decoration either. The live-imagery tab downloads a
                    // GOES frame with fetch() so it can show real progress in bytes, then
                    // hands the assembled Blob to an <img>; the background picker does the
                    // same to measure a photo before shrinking it. 'self' does not cover
                    // blob: — without it both features fail only on the board, where this
                    // header exists, and work in dev and on the public copy, where it does
                    // not. The picker's failure was the nastier one: the CSP block fires
                    // img.onerror, and the code reports a perfectly good photo as "не картинка".
                    "style-src 'self' 'unsafe-inline'; img-src 'self' data: blob: https:; "
                    "connect-src 'self' https:; font-src 'self'; "
                    "object-src 'none'; base-uri 'none'; frame-ancestors 'none'");
}

// Guard for endpoints that change something. The threat is not a neighbour on the
// LAN, it is any page the phone already has open: this API takes plain GETs, so a
// random site can point a request at 192.168.4.1/api/led and the browser will
// send it. A wildcard Access-Control-Allow-Origin hides the *reply* from that
// script and does nothing to stop the request from arriving and taking effect.
// With /api/at on the board that request could send an SMS.
//
// A same-origin GET from our own dashboard carries no Origin header at all, so
// "Origin present and not ours" is exactly the cross-site case and nothing else.
// One string compare, no password to type on a phone keyboard, no state to store.
// localhost is allowed on purpose: that is `npm run dev` pointed at a real board,
// and losing it would cost more than the guard is worth.
bool crossSiteWrite() {
  if (!server.hasHeader("Origin")) return false;
  String o = server.header("Origin");
  if (o == "null") return false;                                  // file:// and sandboxes
  if (o == String("http://") + portalHost)             return false;
  if (o == "http://" + WiFi.softAPIP().toString())     return false;
  if (WiFi.status() == WL_CONNECTED &&
      o == "http://" + WiFi.localIP().toString())      return false;
  if (o.startsWith("http://localhost:") ||
      o.startsWith("http://127.0.0.1:"))               return false;
  sendCors();
  server.send(403, "text/plain", "cross-site request refused\n");
  Serial.printf("HTTP: refused cross-site write from %s\n", o.c_str());
  return true;
}

// Where the station physically is. The coordinates have sat in secrets.h unused
// since they were added -- nothing on the board needed them. The world map does:
// it has to centre on something, and on a copy served over plain http:// the
// browser flatly refuses to hand out the *viewer's* position, so the *station's*
// is the only real coordinate in reach. Served at full precision because this is
// the owner's own device on the owner's own network; the rounding rule in the docs
// is about what goes into git, not about what the board tells its own dashboard.
//
// 0/0 means "not configured" rather than the Gulf of Guinea, and the dashboard
// reads it that way.
void handleSite() {
  sendCors();
  String j = "{";
  j += "\"lat\":"  + String((double)SECRET_STATION_LAT, 5) + ",";
  j += "\"lon\":"  + String((double)SECRET_STATION_LON, 5) + ",";
  j += "\"altM\":" + String((double)SECRET_STATION_ALT_M, 1) + ",";
  j += "\"host\":\"" + String(portalHost) + "\"";
  j += "}";
  server.send(200, "application/json", j);
}

String buildDataJson() {
  String json = "{";
  // One allocation instead of a dozen reallocs per frame. At 20 Hz the old growth
  // pattern churned the heap 20x a second and fragmented it over long uptimes. Raised
  // from 448 when the uplink, cloud and site blocks were added: a full frame with a live
  // 4G link and a cloud error string runs past 700 bytes, and undersizing this puts the
  // realloc churn straight back.
  json.reserve(768);
  // 2 decimals, not 1: 0.1 m/s quantising was coarser than the sensor's own noise
  // after 32x averaging, so the last digit of real resolution was being rounded away
  // before it ever reached the air.
  json += "\"speed\":"          + String(windSpeed, 2) + ",";
#if HAS_DIRECTION
  json += "\"direction\":"      + String(windDir, 0)   + ",";
  json += "\"dirPresent\":true,";
#else
  json += "\"direction\":null,";
  json += "\"dirPresent\":false,";
#endif
  json += "\"gust\":"           + String(windGust, 2)  + ",";
  // Diagnostic, not a measurement: raw averaged mV on the speed pin. Lets the ADC
  // floor be checked without a USB cable — the dashboard ignores this field.
  json += "\"speedMv\":"        + String(speedMvRaw, 1) + ",";
  // Two more diagnostics, also ignored by the dashboard: the zero point currently in
  // force (so /api/zero can be checked without guessing) and the spread of one sample
  // burst, which is how radio interference on the analog side shows itself.
  json += "\"speedZeroMv\":"    + String(speedZeroMv, 1) + ",";
  json += "\"speedSpreadMv\":"  + String(speedMvSpread, 0) + ",";
  // LED fields are mode strings ("off"/"on"/"blink"), not booleans — the dashboard
  // normalizes booleans from older firmware, not the other way around.
  json += "\"ledGreen\":\""     + String(ledModeStr(ledGreen))  + "\",";
  json += "\"ledYellow\":\""    + String(ledModeStr(ledYellow)) + "\",";
  json += "\"ledRed\":\""       + String(ledModeStr(ledRed))    + "\",";
  json += "\"ledWifi\":\""      + String(ledModeStr(ledWifi))   + "\",";
  json += "\"ledAuto\":"        + String(ledAutoMode ? "true" : "false") + ",";
  if (batteryPresent) {
    json += "\"battery\":"        + String(batteryVoltage, 2) + ",";
    json += "\"batteryPercent\":" + String(batteryPercent) + ",";
  } else {
    json += "\"battery\":null,";
    json += "\"batteryPercent\":null,";
  }
  json += "\"batteryPresent\":" + String(batteryPresent ? "true" : "false") + ",";
  json += "\"chargeState\":\""  + String(chargeState) + "\",";
  json += "\"powerSource\":\""  + String(powerSource) + "\",";
  json += "\"speedMax\":"       + String(SPEED_MAX, 0) + ",";
  json += "\"wifiRssi\":"       + String(wifiRssi) + ",";
  json += "\"adcError\":"       + String(adcError ? "true" : "false") + ",";
  // Uplink status. Added fields, not changed ones — a dashboard build that predates
  // them ignores what it does not know. staIp is the only way to learn the address
  // the board answers on at home without opening the router or a serial console.
  // staSsid is which network of the list actually answered, so it is read from the
  // driver rather than from homeNetworks[] — with several candidates the constant
  // would only say which one was tried last.
#if HAS_HOME_NETWORK
  json += "\"staSsid\":"        + (staUp ? "\"" + WiFi.SSID() + "\"" : String("null")) + ",";
  json += "\"staConnected\":"   + String(staUp ? "true" : "false") + ",";
  json += "\"staIp\":"          + (staUp ? "\"" + WiFi.localIP().toString() + "\"" : String("null")) + ",";
#else
  json += "\"staSsid\":null,";
  json += "\"staConnected\":false,";
  json += "\"staIp\":null,";
#endif

  // ----- 4G uplink, cloud channel and where the station stands -----
  //
  // One rule governs everything below: a field that has no answer is ABSENT, not zero,
  // not "" and not null. The dashboard reads a missing key as "do not draw this row at
  // all" and a present-but-empty value as an honest "no data yet", and those are two
  // different pictures. A zero here would be the meteorological sin the optional-sensor
  // contract already spells out: 0 dBm is a signal reading, not the absence of a modem.
  // So the compile-time cases go behind #if and the runtime ones behind a real test.
#if HAS_MODEM && MODEM_USE_PPP
  // Free to report every frame: the state machine's own variable and a netif field, no
  // AT traffic. Same name normalisation /api/modem uses, so the two endpoints cannot
  // drift into describing the same state with two different words.
  json += "\"pppState\":\""     + String(modemPppStateName()) + "\",";
  // Only once IPCP has actually handed over an address. Before that PPP.localIP() reads
  // back 0.0.0.0, which looks like an address and is not one.
  if (PPP.hasIP()) {
    json += "\"pppIp\":\""      + PPP.localIP().toString() + "\",";
  }
  // The cached radio facts. Absent as a group until the cache has been filled at least
  // once — see ModemRadio for why these are never asked from inside this function.
  if (modemRadio.at) {
    json += "\"netOperator\":\"" + String(modemRadio.oper) + "\",";
    json += "\"netRssi\":"       + String(modemRadio.rssi) + ",";
    json += "\"netMode\":"       + String(modemRadio.mode) + ",";
    json += "\"netAttached\":"   + String(modemRadio.attached ? "true" : "false") + ",";
  }
#endif
#if SECRET_HAS_CLOUD
  // Defined far below this function, in the cloud section, and declared here for the same
  // reason as the loop counters further down: the JSON is built above everything it
  // reports on.
  extern volatile bool cloudConnected;
  extern char          cloudLastError[];
  json += "\"cloudConnected\":" + String(cloudConnected ? "true" : "false") + ",";
  // Only when there is something to say. An empty string would make the dashboard draw an
  // error row that reads "error: (nothing)" on a channel that is working perfectly.
  if (cloudLastError[0]) {
    json += "\"cloudError\":\""  + String(cloudLastError) + "\",";
  }
#endif
  // Where the station stands. THREE decimals, and this is a security boundary rather than
  // a formatting preference: this very JSON is what cloudPublishState() pushes to the
  // retained `state` topic, which is read with the viewer credential that ships inside the
  // public dashboard bundle. Anything that lands here is public. Three decimals is ~100 m
  // — enough to centre a map, not enough to be a street address. Full precision stays in
  // /api/site, which only ever answers on the board's own network.
  // 0/0 still means "not configured" here, exactly as /api/site defines it.
  json += "\"siteLat\":"        + String((double)SECRET_STATION_LAT, 3) + ",";
  json += "\"siteLon\":"        + String((double)SECRET_STATION_LON, 3) + ",";
  json += "\"siteAltM\":"       + String((double)SECRET_STATION_ALT_M, 1) + ",";

  // The address to show a human, not the mDNS label — this is what the dashboard
  // prints as "станция доступна по адресу".
  json += "\"hostname\":\""     + String(portalHost) + "\",";
  json += "\"uptime\":"         + String(millis() / 1000) + ",";
  json += "\"resetReason\":\""  + String(resetReasonName()) + "\",";
  // Absolute time, seconds since the epoch, UTC — and 0 when the clock has never been
  // synced. Zero is not a date and the dashboard must read it as "unknown": a board
  // without an uplink genuinely does not know what day it is, and 1970 on a card would
  // be a lie told confidently. The flag is what gates TLS inside the firmware; the
  // number is here so the same fact can be checked from outside without a serial cable.
  // Both are defined below this function — one in the SSE section, one in the main-loop
  // section — and declared here because the JSON is built above them.
  extern unsigned long loopMaxMs;
  extern unsigned long sseDropped;
  extern unsigned long logBusyLast;
  // The health pair that used to exist only in the serial telemetry line. It is here
  // because the cable stopped being free: on this hardware opening the USB port pulses
  // DTR and resets the board, and a reset that does not go through ArduinoOTA.onStart()
  // leaves the modem stuck in CMUX — so reading loopMax over a cable now costs the 4G
  // uplink until someone power-cycles the module. Same numbers, same meaning, and the
  // same reset point: both are zeroed when the telemetry line is printed, so this is
  // "since the last telemetry line", not "since boot".
  json += "\"loopMax\":"        + String(loopMaxMs) + ",";
  json += "\"sseDrop\":"        + String(sseDropped) + ",";
  // How long the telemetry line itself blocked on the UART last time. Subtracted from
  // loopMax rather than left in it, so loopMax means "something starved the sensor loop"
  // and this one means "the console is slow" — two different problems that used to share
  // a number. Nonzero only while something is actually draining the port.
  json += "\"logMs\":"          + String(logBusyLast) + ",";
  json += "\"timeValid\":"      + String(clockValid ? "true" : "false") + ",";
  json += "\"epoch\":"          + String(clockValid ? (uint32_t)time(nullptr) : 0);
  json += "}";
  return json;
}

void handleData() {
  sendCors();
  server.send(200, "application/json", buildDataJson());
}

// ===== DISPLAY LINK (CYD, wired) =====
// A second, separate ESP32 board with its own 2.8" screen (ESP32-2432S028, the "Cheap
// Yellow Display", project folder wind_display/) sits in the enclosure and shows the same
// frame the dashboard gets. It is fed by ONE wire, not by WiFi, and the reasons are all
// on this side:
//   - a display associated to the AP counts as a client, and serviceUplink() stays
//     silent while anyone is on the AP (staNoneInRange && apClients() > 0) — a panel
//     that never leaves would stop the home-network search for good;
//   - it would take one of the four AP slots, pin the WiFi LED on forever, and make
//     wifiRssi report the display's signal instead of a person's;
//   - the display then runs with its radio OFF, which is most of its power budget.
// Set to 0 and nothing below is compiled — GPIO23 is then simply unused.
#define HAS_DISPLAY_LINK 1

#if HAS_DISPLAY_LINK
// Breadboard 18j (bottom header, 38-pin DevKitC seated from column 1, schematic v8) —
// between GPIO22 at 17j and the GND pin at 19j. Chosen because it is free and is not a
// strapping pin, so whatever the display's input does at power-up cannot change how this
// board boots. TX only: the display never answers, so no RX pin is claimed and GPIO23 is
// the only pin this link costs.
#define PIN_DISPLAY_TX   23   // -> CYD connector CN1, pin IO27 (the display's RX)
const unsigned long DISPLAY_BAUD = 115200;
// 5 Hz. A frame is ~800 bytes = ~70 ms of wire time at 115200, so this uses ~35% of the
// line and the ring never has reason to fill. Faster buys nothing: a person reads a number
// off a screen, and the display animates between frames on its own side anyway.
const unsigned long DISPLAY_PUSH_MS = 200;
// The ring the driver drains in the background. Two full frames plus change, so one frame
// can still be leaving while the next is queued behind it. Must be set before begin() —
// the core refuses to resize a running UART.
const size_t DISPLAY_TX_BUF = 2048;

unsigned long lastDisplay    = 0;
// Frames skipped because the ring had no room. Reset with the telemetry line, same as
// sseDropped. The UART has no idea whether anyone listens, so a dead or unplugged display
// does NOT raise this — only a stall on this side can. Nonzero means loop() is slow.
unsigned long displayDropped = 0;

static void displayLinkStart() {
  Serial1.setTxBufferSize(DISPLAY_TX_BUF);
  // rx = -1 on purpose, and it is safe: the core only falls back to its default UART1
  // pins (RX1=26 / TX1=27 — the modem's pair) when BOTH are negative. With tx given, rx
  // stays unassigned and no pin other than GPIO23 is touched.
  Serial1.begin(DISPLAY_BAUD, SERIAL_8N1, -1, PIN_DISPLAY_TX);
  Serial.printf("Display link: UART1 TX=GPIO%u @%lu, frame every %lu ms\n",
                PIN_DISPLAY_TX, DISPLAY_BAUD, DISPLAY_PUSH_MS);
}

// Same rule as sseFlush(): never block loop(). Serial1.write() blocks once the ring is
// full, so a frame is written only if all of it fits RIGHT NOW, otherwise dropped and
// counted. Whole frames, never half of one: the display parses line by line, and a torn
// frame would cost it the next good line too.
// availableForWrite() has a quirk worth knowing: with the ring full the core reports the
// free space of the 128-byte hardware FIFO instead of 0. A frame is always longer than
// 128 bytes, so here that still reads as "no room" — it would not for a short message.
static void serviceDisplayLink() {
  if (millis() - lastDisplay < DISPLAY_PUSH_MS) return;
  lastDisplay = millis();
  String line = buildDataJson();
  line += '\n';
  if (Serial1.availableForWrite() < (int)line.length()) {
    displayDropped++;
    return;
  }
  Serial1.write((const uint8_t*)line.c_str(), line.length());
}
#endif

// ===== SSE STREAM =====
// WebServer serves one client at a time and always replies "Connection: close",
// so polling above 1 Hz used to exhaust lwIP's 16 TCP PCBs (60 s TIME_WAIT each).
// Instead the dashboard subscribes once to /api/stream and we push a frame every
// SSE_PUSH_MS over that single long-lived connection — zero per-sample TCP churn.
// The trick: NetworkClient's socket is a shared_ptr, so keeping a copy here holds
// the connection open after WebServer drops its own reference at end of request.
// One subscriber is enough (one dashboard); a new subscribe replaces the old one.
// 50 ms = 20 Hz. The old 250 ms was chosen against per-sample TCP churn, which the
// single long-lived connection already solved; at ~330 bytes a frame this costs
// ~6.6 kB/s of airtime, nothing on a 802.11n link, and it is what makes the gauge
// track the cups instead of stepping after them.
const unsigned long SSE_PUSH_MS = 50;
NetworkClient sseClient;

// The frame being handed to the socket, and how many of its bytes already left. A new
// frame is only built once the previous one is fully out — see sseFlush() for why the
// socket is written to directly and what happens when the client cannot keep up.
String        sseFrame;
size_t        sseSent    = 0;
unsigned long sseDropped = 0;   // frames skipped because the previous one was still going

// Hand over as much of the pending frame as the socket will take this instant, never
// more, never waiting.
//
// sseClient.print() cannot be used for this. NetworkClient::write() loops up to
// WIFI_CLIENT_MAX_WRITE_RETRY (10) times around a select() whose timeout is
// WIFI_CLIENT_SELECT_TIMEOUT_US (1 s) — so a subscriber whose receive window is full
// stalls the whole of loop() for up to ten seconds. Everything else in loop() stops
// with it, readSensors() included: the sensor is simply not sampled for that period,
// so a short spell of slow rotation lands entirely in the blind window and never
// reaches the dashboard at all, while the frames that do arrive are stale by however
// long the stall lasted.
//
// c.setTimeout(500) used to sit here and was documented as a 500 ms write timeout. It
// was neither. NetworkClient declares its own `int _timeout` that shadows Stream's and
// never overrides setTimeout(), so the value landed in the Stream member that write()
// does not read; and the send() inside write() passes MSG_DONTWAIT, which makes
// SO_SNDTIMEO irrelevant anyway. The retry loop above was always the real bound.
//
// A full buffer therefore costs a skipped frame instead of a stalled loop. That is the
// right trade for a live gauge: 50 ms later there is a newer sample, and a backlog of
// old ones has no value to the dashboard.
void sseFlush() {
  if (sseSent >= sseFrame.length()) return;
  int fd = sseClient.fd();
  if (fd < 0) return;
  int n = lwip_send(fd, sseFrame.c_str() + sseSent, sseFrame.length() - sseSent, MSG_DONTWAIT);
  if (n > 0) {
    sseSent += n;
  } else if (n < 0 && errno != EAGAIN && errno != EWOULDBLOCK) {
    sseClient.stop();   // real socket error, not just a full window
  }
}

void handleStream() {
  NetworkClient c = server.client();
  // Nagle withholds a small segment until the previous one is ACKed, so at 20 Hz it
  // would both delay a frame by up to a full RTT and coalesce neighbouring frames
  // into one segment — the client then gets two samples with one timestamp. Off.
  c.setNoDelay(true);
  // Blocking, but harmless: this is the first thing written to a brand new socket, so
  // the send buffer is empty and the headers go out without ever filling it.
  c.print(F("HTTP/1.1 200 OK\r\n"
            "Content-Type: text/event-stream\r\n"
            "Cache-Control: no-cache\r\n"
            "Access-Control-Allow-Origin: *\r\n"
            "Connection: keep-alive\r\n\r\n"));
  if (sseClient.connected()) sseClient.stop();
  sseClient = c;
  sseFrame = "data: " + buildDataJson() + "\n\n";  // first frame, drained by sseFlush()
  sseSent  = 0;
  // No server.send() on purpose — the response above is the whole reply.
}

void handleLedControl() {
  if (crossSiteWrite()) return;
  if (server.hasArg("auto")) {
    ledAutoMode = server.arg("auto") == "true";
  }
  if (!ledAutoMode) {
    if (server.hasArg("green"))  ledGreen  = parseLedMode(server.arg("green"));
    if (server.hasArg("yellow")) ledYellow = parseLedMode(server.arg("yellow"));
    if (server.hasArg("red"))    ledRed    = parseLedMode(server.arg("red"));
    if (server.hasArg("wifi"))   ledWifi   = parseLedMode(server.arg("wifi"));
  }
  sendCors();
  server.send(200, "text/plain", "OK");
}

// Zero-point calibration in place, with the cups held still.
//   GET /api/zero            — what is in force now, and what the pin reads this instant
//   GET /api/zero?set        — adopt the current reading as the zero point
//   GET /api/zero?set=374.0  — adopt an explicit value
//   GET /api/zero?reset      — back to the compile-time constant
// RAM only, deliberately: this firmware never writes NVS (an OTA image flashed over a
// wrong partition offset would take the settings with it), so the point of the endpoint
// is to FIND the number in five minutes of trying, not to store it. The reply echoes it
// as the source line to paste back into the constant, which is where it belongs anyway —
// the value is a property of the resistors, and those do not change between reboots.
void handleZero() {
  if (crossSiteWrite()) return;
  if (server.hasArg("reset")) {
#if HAS_LEVEL_SHIFT
    speedZeroMv = SPEED_BIAS_MV_DEFAULT;
#else
    speedZeroMv = SPEED_ZERO_MV;
#endif
  } else if (server.hasArg("set")) {
    String v = server.arg("set");
    // Empty value means "take what the sensor reads right now" — that is the whole
    // point of the flag form, and it is the form used with the cups held still.
    float mv = (v.length() == 0) ? speedMvRaw : v.toFloat();
    // Refuse nonsense rather than silently bricking the scale: 0 would disable the gate
    // entirely and let the ADC floor read as 2.2 m/s of permanent phantom wind, and
    // anything past ~1 V is already a good fraction of the useful range.
    if (mv > 20.0f && mv < 1000.0f) speedZeroMv = mv;
  }

  String json = "{";
  json += "\"zeroMv\":"     + String(speedZeroMv, 1) + ",";
  json += "\"speedMv\":"    + String(speedMvRaw, 1) + ",";
  json += "\"spreadMv\":"   + String(speedMvSpread, 0) + ",";
  json += "\"levelShift\":" + String(HAS_LEVEL_SHIFT ? "true" : "false") + ",";
#if HAS_LEVEL_SHIFT
  json += "\"constant\":\"const float SPEED_BIAS_MV_DEFAULT = "
          + String(speedZeroMv, 1) + "f;\"}";
#else
  json += "\"constant\":\"const float SPEED_ZERO_MV = "
          + String(speedZeroMv, 1) + "f;\"}";
#endif

  sendCors();
  server.send(200, "application/json", json);
}

void handleResetGust() {
  if (crossSiteWrite()) return;
  windGust = windSpeed;
  gustResetTimer = millis();
  sendCors();
  server.send(200, "text/plain", "OK");
}

// Read-only. add/del/connect are still gone: the uplink is a compile-time constant,
// not something to type into a form, so there remains nothing here to configure.
// That is why "apOnly" stays true even with the uplink built in — the dashboard
// reads that flag as "no network settings to show", which is still the truth, and
// flipping it would make the old baked-in UI offer an editor backed by endpoints
// that no longer exist. "nets":[] and "max":0 are preserved for the same reason.
// The uplink* fields are additive; a dashboard that predates them ignores them.
void handleWifiControl() {
  String json = "{";
  json += "\"mode\":\"ap\",";
  json += "\"apOnly\":true,";
  json += "\"current\":\"" + String(apSsid) + "\",";
  json += "\"ip\":\"" + WiFi.softAPIP().toString() + "\",";
  json += "\"clients\":" + String(apClients()) + ",";
  json += "\"host\":\"" + String(portalHost) + "\",";
#if HAS_HOME_NETWORK
  json += "\"uplinkSsid\":" + (staUp ? "\"" + WiFi.SSID() + "\"" : String("null")) + ",";
  json += "\"uplinkConnected\":" + String(staUp ? "true" : "false") + ",";
  json += "\"uplinkIp\":" + (staUp ? "\"" + WiFi.localIP().toString() + "\"" : String("null")) + ",";
  json += "\"uplinkRssi\":" + String(staUp ? WiFi.RSSI() : 0) + ",";
  // Names only, never passwords. Answers "which networks will this build even try",
  // which is otherwise only visible by reading the source or the serial log.
  json += "\"uplinkKnown\":[";
  for (int i = 0; i < homeNetworkCount; i++) {
    if (i) json += ",";
    json += "\"" + String(homeNetworks[i].ssid) + "\"";
  }
  json += "],";
#else
  json += "\"uplinkSsid\":null,";
  json += "\"uplinkConnected\":false,";
  json += "\"uplinkIp\":null,";
  json += "\"uplinkRssi\":0,";
  json += "\"uplinkKnown\":[],";
#endif
  // Последние приходы и уходы клиентов точки. Читается с ноутбука, пока телефон
  // пытается подключиться: снаружи «Connecting…» и тишина, а здесь причина отказа
  // числом. `ago` — секунд назад, чтобы не сверять миллисекунды с аптаймом.
  json += "\"apLog\":[";
  for (uint8_t i = 0; i < apEventCount; i++) {
    // Свежие сверху: идём назад от последней записи.
    uint8_t idx = (apEventNext + AP_LOG_N - 1 - i) % AP_LOG_N;
    const ApEvent& e = apEventLog[idx];
    char mac[18];
    snprintf(mac, sizeof(mac), "%02x:%02x:%02x:%02x:%02x:%02x",
             e.mac[0], e.mac[1], e.mac[2], e.mac[3], e.mac[4], e.mac[5]);
    if (i) json += ",";
    json += "{\"ago\":" + String((millis() - e.ms) / 1000);
    json += ",\"mac\":\"" + String(mac) + "\"";
    json += ",\"event\":\"" + String(e.joined ? "join" : "leave") + "\"";
    if (!e.joined) {
      json += ",\"reason\":" + String(e.reason);
      json += ",\"why\":\"" + String(WiFi.STA.disconnectReasonName((wifi_err_reason_t)e.reason)) + "\"";
    }
    json += "}";
  }
  json += "],";
  json += "\"max\":0,";
  json += "\"nets\":[]}";

  sendCors();
  server.send(200, "application/json", json);
}

#if HAS_MODEM
// ===== MODEM AT CONSOLE =====
// (Re)opens UART2 on whatever pins and baud are currently in force. Called once from
// setup() and again from handleAt when either is changed at runtime. end() first, so the
// old pins are released instead of being left driven — moving TX without that would
// leave the previous pin parked HIGH.
static void modemUartStart() {
  Serial2.end();
  // 1 kB instead of the driver's 256 B: at 115200 the default holds only ~22 ms of
  // traffic, and one OTA handshake is longer than that, so a running NMEA stream would
  // lose characters in the gap. Must be called before begin().
  Serial2.setRxBufferSize(1024);
  Serial2.begin(modemBaud, SERIAL_8N1, modemPinRx, modemPinTx);
  Serial.printf("Modem: UART2 RX=GPIO%u TX=GPIO%u @%lu\n", modemPinRx, modemPinTx, modemBaud);
}

// Drains the modem UART into modemBuf. Runs every pass through loop() and never blocks —
// the same rule serviceUplink() and sseFlush() follow, and for the same reason: anything
// that waits in here starves the 50 Hz sensor and the SSE stream along with it. Capped
// per call so an NMEA stream cannot stretch one pass into something loopMax will notice.
static void modemPump() {
  int budget = 512;
  while (Serial2.available() && budget-- > 0) {
    if (modemLen >= MODEM_BUF_CAP) {
      // Keep the tail, and pay one memmove for it rather than shifting per byte.
      memmove(modemBuf, modemBuf + MODEM_BUF_CAP / 2, MODEM_BUF_CAP / 2);
      modemLen = MODEM_BUF_CAP / 2;
    }
    modemBuf[modemLen++] = (char)Serial2.read();
    modemRxTotal++;
  }
}

// True once the buffer ends in a final result code. Lets a command return the moment the
// modem is done instead of always burning the whole timeout — real answers land in
// 20-60 ms, so the full wait is only ever paid by a command that got no reply at all.
// The LAST LINE is tested rather than the tail of the buffer, because "+CME ERROR: 10"
// ends in a number and would never match a word.
static bool modemAnswered() {
  size_t end = modemLen;
  while (end > 0 && (modemBuf[end - 1] == '\r' || modemBuf[end - 1] == '\n')) end--;
  if (end == 0) return false;
  size_t start = end;
  while (start > 0 && modemBuf[start - 1] != '\n' && modemBuf[start - 1] != '\r') start--;
  const char* line = modemBuf + start;
  size_t n = end - start;
  if (n == 2  && memcmp(line, "OK",    2) == 0) return true;
  if (n == 5  && memcmp(line, "ERROR", 5) == 0) return true;
  if (n >= 10 && (memcmp(line, "+CME ERROR", 10) == 0 ||
                  memcmp(line, "+CMS ERROR", 10) == 0)) return true;
  if (line[0] == '>') return true;   // waiting for SMS text
  return false;
}

// True while esp-modem owns GPIO27/25. Everything that touches Serial2 has to ask first:
// the port is closed for the whole time PPP is up, and reading a closed port returns
// nothing at all rather than failing — a silence that looks exactly like a dead modem.
static bool modemPppOwnsUart() {
#if MODEM_USE_PPP
  return modemPppState == MODEM_PPP_ATTACHING
      || modemPppState == MODEM_PPP_DIALING
      || modemPppState == MODEM_PPP_ONLINE;
#else
  return false;
#endif
}

#if MODEM_USE_PPP
static const char* modemPppStateName() {
  switch (modemPppState) {
    case MODEM_PPP_ATTACHING: return "attaching";
    case MODEM_PPP_DIALING:   return "dialing";
    case MODEM_PPP_ONLINE:    return "online";
    case MODEM_PPP_FAILED:    return "failed";
    default:                  return "stopped";
  }
}

static void modemSetState(ModemPppState st) {
  modemPppState   = st;
  modemStateSince = millis();
}

// Hands the UART back to the raw console and forgets the DCE.
//
// Note what this cannot do: take the modem out of CMUX. A7670 firmware breaks on CMUX
// exit — the documented way back is a power cycle — so once the dial step has run, the
// console on the other side of this call sees CMUX framing where it expects plain AT,
// until the module is power-cycled. Before that step (the common case, since most
// failures are "no attach") CMUX was never entered and the console really does come back.
static void modemPppRelease(const char* why) {
  PPP.end();
  modemSetState(MODEM_PPP_STOPPED);
  // Forget the cached radio facts. They describe a link that no longer exists, and a
  // stale operator name next to a dead uplink reads as "the modem is fine" — the one
  // conclusion the reader must not draw. Empty cache means the fields vanish from
  // /api/data entirely, which is honest; a remembered value would be a lie with a
  // timestamp nobody looks at.
  modemRadio.at = 0;
  // end() puts both pin assignments back to -1, so this is not a no-op: the pair has to
  // be handed back to Serial2 explicitly before the console can hear anything again.
  modemUartStart();
  modemLen = 0;
  Serial.printf("Modem: PPP released (%s)\n", why);
}

static void modemBackoff() {
  modemRetryMs = (modemRetryMs > MODEM_RETRY_MAX_MS / 2) ? MODEM_RETRY_MAX_MS : modemRetryMs * 2;
  modemNextTry = millis() + modemRetryMs;
}

// One AT down the console UART, waiting briefly for any final result code. A pre-flight
// for the expensive part, and it earns its place with a measured number: a modem left in
// CMUX by an earlier boot answers a plain AT with total silence, and PPP.begin() takes
// 25 s to discover that — 25 s of frozen loop() on every single retry, for as long as the
// modem stays wedged. This question costs 300 ms and gives the same answer.
//
// Only ever called while Serial2 still owns the pins, i.e. from a STOPPED or FAILED state.
static bool modemRespondsToAt() {
  modemLen = 0;
  Serial2.print("AT");
  Serial2.write('\r');     // SIMCom terminates on a bare CR, never on LF
  unsigned long t0 = millis();
  while (millis() - t0 < MODEM_PREFLIGHT_MS) {
    modemPump();
    if (modemAnswered()) return true;
    delay(2);              // vTaskDelay underneath — the WiFi stack keeps running
  }
  return false;
}

// Brings the 4G interface up and keeps it up, from loop(), in slices.
//
// The station cannot afford the shape the PPP example uses — begin(), then a 60 s busy
// wait for the network to attach — because that is a full minute of dead sensor, dead
// dashboard, dead SSE and dead OTA on a board that is otherwise perfectly healthy, every
// single time the modem is slow. So the wait is turned inside out: the state lives in
// globals, each pass does at most one AT round trip and returns, and a modem that never
// registers at all costs nothing but one poll every two seconds.
//
// What still blocks, stated plainly rather than papered over: PPP.begin() is synchronous
// (~0.3 s when the modem answers, seconds when it does not) and so is every AT round trip
// in here. That time is charged to modemBusyMaxMs and subtracted from the loop timer —
// see the note there for why the two numbers must not be added together.
static void serviceModem() {
  if (!modemPppEnabled) return;
  unsigned long now = millis();

  switch (modemPppState) {

    case MODEM_PPP_ONLINE: {
      // The netif clears CONNECTED by itself when the carrier drops, and nothing else in
      // the firmware watches for it. Free to poll — this reads a status bit, not the UART.
      if (PPP.connected()) return;
      modemLastError = "carrier lost";
      modemPppRelease("carrier lost");
      modemSetState(MODEM_PPP_FAILED);
      // A link that WAS up gets the fast retry instead of the accumulated backoff: it has
      // just proved there is coverage here, so this is a handover, not a dead cell.
      modemRetryMs = MODEM_RETRY_MIN_MS;
      modemNextTry = now + modemRetryMs;
      return;
    }

    case MODEM_PPP_DIALING: {
      // Waiting on IPCP, which runs in the lwIP PPP task — so this poll is a local status
      // bit read and can happen every pass without saying a word to the modem.
      if (PPP.connected()) {
        // Pin public resolvers on the interface. The A7670 hands back 0.0.0.0 for DNS
        // often enough that it has to be handled rather than hoped about: IPCP gives an
        // address and a route, and then every name lookup fails on a link that looks
        // perfectly healthy.
        //
        // Unconditional, and NOT guarded by "only if IPCP gave us nothing", because that
        // test cannot be written: with a WiFi uplink up, dnsIP() reads back the GLOBAL
        // lwIP resolver table (the home router) rather than what this interface
        // negotiated, so the guard would never fire and the fix would never run. Measured
        // on the bench — the first build reported dns0 = the home router on a PPP link
        // that had just come up. Writing, unlike reading, is per interface and lands
        // where it is needed: the value takes effect when PPP becomes the default route,
        // which on the mast it will be, with no WiFi around to outrank it.
        PPP.dnsIP(0, IPAddress(8, 8, 8, 8));
        PPP.dnsIP(1, IPAddress(1, 1, 1, 1));
        modemSetState(MODEM_PPP_ONLINE);
        modemRetryMs   = MODEM_RETRY_MIN_MS;
        modemLastError = "";
        Serial.print("Modem: PPP online, IP ");
        Serial.print(PPP.localIP());
        Serial.print(", DNS ");
        Serial.println(PPP.dnsIP(0));
        return;
      }
      if (now - modemStateSince > MODEM_DIAL_MAX_MS) {
        modemLastError = "no address after CMUX";
        modemPppRelease("dial timeout");
        modemSetState(MODEM_PPP_FAILED);
        modemBackoff();
      }
      return;
    }

    case MODEM_PPP_ATTACHING: {
      if (now - modemAttachPoll < MODEM_ATTACH_POLL_MS) return;
      modemAttachPoll = now;
      if (!PPP.attached()) {
        if (now - modemStateSince > MODEM_ATTACH_MAX_MS) {
          modemLastError = "no attach in " + String(MODEM_ATTACH_MAX_MS / 1000) + " s";
          modemPppRelease("attach timeout");
          modemSetState(MODEM_PPP_FAILED);
          modemBackoff();
        }
        return;
      }
      // Attached. Dialling is the one step with nothing left to slice: set_mode() runs the
      // entire CMUX handshake and starts PPP inside a single synchronous call.
      //
      // CMUX and not plain DATA mode, and this is a one-way door. CMUX multiplexes an AT
      // channel alongside the data channel, which is the only reason /api/at survives the
      // station going online — and the A7670 cannot be taken back out of CMUX without a
      // power cycle, so entering it is a decision rather than a step.
      if (!PPP.mode(ESP_MODEM_MODE_CMUX)) {
        modemLastError = "CMUX refused";
        modemPppRelease("CMUX refused");
        modemSetState(MODEM_PPP_FAILED);
        modemBackoff();
        return;
      }
      modemSetState(MODEM_PPP_DIALING);
      Serial.println("Modem: attached, CMUX up, waiting for an address");
      return;
    }

    default: {   // STOPPED or FAILED — start an attempt once the backoff has run out
      if ((long)(now - modemNextTry) < 0) return;
      modemTries++;

      // Pre-flight on the console UART, before esp-modem is involved at all. Silence here
      // means one of exactly two things, and neither is fixable from this side: no modem
      // on the wires, or a modem still sitting in CMUX from an earlier boot of this chip.
      // Both want the same thing — power removed and restored — which is why GPIO33 is
      // reserved for a P-FET and why this message says so out loud.
      if (!modemRespondsToAt()) {
        modemLastError = "no answer to a bare AT: modem absent, or left in CMUX by an "
                         "earlier boot and needs its power cycled";
        modemSetState(MODEM_PPP_FAILED);
        modemBackoff();
        return;
      }

      // Serial2 and esp-modem want the same two pins from two different UART peripherals.
      // The console has to let go first, or begin() configures pins another peripheral is
      // still driving and the modem hears a fight instead of an AT.
      Serial2.end();
      PPP.setApn(MODEM_APN);
      // (tx, rx) — the opposite order from Serial2.begin(), worth spelling out because
      // getting it backwards leaves both ends deaf and looks exactly like dead hardware.
      // Re-set on every attempt on purpose: PPP::end() puts both pins back to -1, so this
      // is not the one-time call it reads like.
      PPP.setPins(modemPinTx, modemPinRx);
      // No setResetPin(), and that is deliberate. PWRKEY is tied to ground through R104 on
      // this board, so there is no reset line to pulse — and asking for one would send
      // begin() down the path that waits up to 50 s for the modem to answer instead of
      // giving up in half a second. Nothing called from loop() may cost 50 s.
      if (!PPP.begin(PPP_MODEM_SIM7600, MODEM_PPP_UART, (int)modemBaud)) {
        modemLastError = "begin() failed";
        modemPppRelease("begin failed");
        modemSetState(MODEM_PPP_FAILED);
        modemBackoff();
        return;
      }

      // LTE only. Left alone the module falls back to 2G/3G the moment LTE wobbles, and on
      // this operator that is a data path which does not come back on its own. The setting
      // persists in NVM, so this is belt and braces after a factory reset.
      PPP.cmd("AT+CNMP=38", 2000);
      // NITZ. The time the network delivers is the ONLY clock this station will ever trust
      // for TLS: GNSS here reports a coherent, confident, moving fix in another hemisphere
      // whenever the jammers are on, and by every quality metric that fake looks BETTER
      // than the truth. Note AT+CTZU and not AT+CLTS — this module has no CLTS at all.
      PPP.cmd("AT+CTZU=1", 2000);

      modemSetState(MODEM_PPP_ATTACHING);
      modemAttachPoll = now;
      Serial.printf("Modem: PPP attempt %u, waiting for network attach\n", modemTries);
      return;
    }
  }
}

// Refills the radio cache, at most once a MODEM_RADIO_POLL_MS, and only when the link is
// genuinely up. Called from loop() right behind serviceModem() so its cost lands inside
// the same measured window and is charged to modemBusyMaxMs — these are four synchronous
// AT round trips and they must not be allowed to hide inside loopMaxMs, which exists to
// answer a different question ("what starved readSensors()").
//
// The guard is ONLINE and not merely modemPppOwnsUart(): the AT channel only exists once
// CMUX is up, and asking during ATTACHING would talk to a UART that esp-modem is still
// bringing up. PPP.connected() on top of that because the netif clears the carrier bit by
// itself, and a module whose cell has just gone away answers AT+CSQ with a long silence.
// The operator name is the only string in this section that comes back as free text from
// the network, and it must never be emitted raw. Both places that report it build JSON by
// hand, so one stray quote in a PLMN alpha tag does not corrupt "the operator field" — it
// corrupts the whole object, for everyone reading it. On /api/data that reader is also the
// public dashboard subscribed to the retained `state` topic; on /api/modem it is the system
// card, which parses the answer the same way. Control characters go too: they are legal in
// a C string and illegal inside a JSON string literal.
static String modemSafeText(const String& in, size_t maxLen) {
  String out;
  out.reserve(in.length() < maxLen ? in.length() : maxLen);
  for (size_t i = 0; i < in.length() && out.length() < maxLen; i++) {
    char c = in[i];
    if (c == '"' || c == '\\' || (unsigned char)c < 0x20) continue;
    out += c;
  }
  return out;
}

static void modemRadioRefresh() {
  if (modemPppState != MODEM_PPP_ONLINE) return;
  if (!PPP.connected()) return;
  if (modemRadio.at && (millis() - modemRadio.at) < MODEM_RADIO_POLL_MS) return;

  modemRadio.attached = PPP.attached();
  modemRadio.rssi     = PPP.RSSI();
  modemRadio.mode     = PPP.networkMode();

  // Through the same filter, once a minute, rather than on every frame at 20 Hz.
  String op = modemSafeText(PPP.operatorName(), sizeof(modemRadio.oper) - 1);
  strlcpy(modemRadio.oper, op.c_str(), sizeof(modemRadio.oper));

  modemRadio.at = millis();
  // millis() is 0 for exactly one millisecond after boot and 0 is the "never filled"
  // marker here. Cheaper to nudge the timestamp by 1 ms than to carry a second flag.
  if (modemRadio.at == 0) modemRadio.at = 1;
}

// Proves the ESP32's own TCP/IP stack reaches the internet THROUGH THE MODEM. That is a
// narrower claim than either "the modem is online" or "the station has internet", and with
// a WiFi uplink also up all three can disagree. The ordinary test — open a socket, see
// whether it connects — would quietly leave over WiFi and report success for the wrong
// interface, so the socket is bound to the PPP address before it is allowed to connect.
// Worst case that turns into a false NEGATIVE (a bind lwIP declines to route), never a
// false positive, which is the right way round for a test whose whole job is to stop us
// believing the link works when it does not.
//
// Blocks for up to MODEM_PROBE_MS, like /api/at?wait= and for the same reason: an operator
// asked for it, the stall is bounded, and it shows up honestly in loopMax.
static bool modemProbe(String& detail) {
  if (!PPP.hasIP()) { detail = "no PPP address"; return false; }

  int sock = lwip_socket(AF_INET, SOCK_STREAM, IPPROTO_TCP);
  if (sock < 0) { detail = "socket() failed"; return false; }

  bool ok = false;
  struct sockaddr_in src;
  memset(&src, 0, sizeof(src));
  src.sin_family      = AF_INET;
  src.sin_port        = 0;
  src.sin_addr.s_addr = (uint32_t)PPP.localIP();

  if (lwip_bind(sock, (struct sockaddr*)&src, sizeof(src)) != 0) {
    detail = "bind to the PPP address failed, errno " + String(errno);
  } else {
    // SO_SNDTIMEO is what bounds a blocking connect() in lwIP — there is no connect
    // timeout option. Without it a black-holed route hangs in here for over a minute.
    struct timeval tv;
    tv.tv_sec  = MODEM_PROBE_MS / 1000;
    tv.tv_usec = (MODEM_PROBE_MS % 1000) * 1000;
    lwip_setsockopt(sock, SOL_SOCKET, SO_SNDTIMEO, &tv, sizeof(tv));

    struct sockaddr_in dst;
    memset(&dst, 0, sizeof(dst));
    dst.sin_family      = AF_INET;
    dst.sin_port        = lwip_htons(MODEM_PROBE_PORT);
    dst.sin_addr.s_addr = lwip_htonl(MODEM_PROBE_ADDR);

    unsigned long t0 = millis();
    ok = (lwip_connect(sock, (struct sockaddr*)&dst, sizeof(dst)) == 0);
    detail = ok ? ("connected in " + String(millis() - t0) + " ms")
                : ("connect failed after " + String(millis() - t0) + " ms, errno " + String(errno));
  }
  lwip_close(sock);
  return ok;
}

// The same trick as modemProbe(), asking a different question: does a UDP round trip
// complete over the modem, and does the answer carry a date. Together they are the whole
// prerequisite for TLS on the mast — a certificate is checked against a clock, and the
// clock has to arrive over the only link there is.
//
// It exists because serviceClock() cannot answer this at home. SNTP goes out over the
// DEFAULT route, and at home that is WiFi (priority 100 against PPP's 20), so a synced
// clock here proves the house has internet, not the modem. Binding the socket to the PPP
// address is what makes the question specific, exactly as in modemProbe().
//
// The server is an IP, not a name, on purpose: a name would drag in the resolver, and
// the resolver is global in lwIP — so a failure would not say whether DNS or the modem
// was at fault. 216.239.35.0 is one of Google's anycast NTP addresses; it is stable, and
// being anycast it is answered by whatever is nearest rather than by one machine.
static bool modemNtpProbe(String& detail) {
  if (!PPP.hasIP()) { detail = "no PPP address"; return false; }

  int sock = lwip_socket(AF_INET, SOCK_DGRAM, IPPROTO_UDP);
  if (sock < 0) { detail = "socket() failed"; return false; }

  bool ok = false;
  struct sockaddr_in src;
  memset(&src, 0, sizeof(src));
  src.sin_family      = AF_INET;
  src.sin_port        = 0;
  src.sin_addr.s_addr = (uint32_t)PPP.localIP();

  if (lwip_bind(sock, (struct sockaddr*)&src, sizeof(src)) != 0) {
    detail = "bind to the PPP address failed, errno " + String(errno);
  } else {
    struct timeval tv;
    tv.tv_sec  = MODEM_NTP_MS / 1000;
    tv.tv_usec = (MODEM_NTP_MS % 1000) * 1000;
    lwip_setsockopt(sock, SOL_SOCKET, SO_RCVTIMEO, &tv, sizeof(tv));

    struct sockaddr_in dst;
    memset(&dst, 0, sizeof(dst));
    dst.sin_family      = AF_INET;
    dst.sin_port        = lwip_htons(123);
    dst.sin_addr.s_addr = lwip_htonl(MODEM_NTP_ADDR);

    uint8_t pkt[48];
    memset(pkt, 0, sizeof(pkt));
    pkt[0] = 0x1B;   // LI = 0, version 3, mode 3 (client) — the whole request

    unsigned long t0 = millis();
    int sent = lwip_sendto(sock, pkt, sizeof(pkt), 0, (struct sockaddr*)&dst, sizeof(dst));
    if (sent != (int)sizeof(pkt)) {
      detail = "sendto failed, errno " + String(errno);
    } else {
      int got = lwip_recv(sock, pkt, sizeof(pkt), 0);
      unsigned long rt = millis() - t0;
      if (got < 48) {
        detail = "no reply in " + String(rt) + " ms, errno " + String(errno);
      } else {
        // Transmit timestamp, bytes 40..43: seconds since 1900. 2208988800 is the gap
        // between the NTP epoch and the Unix one.
        uint32_t secs1900 = ((uint32_t)pkt[40] << 24) | ((uint32_t)pkt[41] << 16)
                          | ((uint32_t)pkt[42] << 8)  |  (uint32_t)pkt[43];
        uint32_t unix = secs1900 - 2208988800UL;
        struct tm g;
        time_t tt = (time_t)unix;
        gmtime_r(&tt, &g);
        char when[24];
        snprintf(when, sizeof(when), "%04d-%02d-%02d %02d:%02d:%02dZ",
                 g.tm_year + 1900, g.tm_mon + 1, g.tm_mday,
                 g.tm_hour, g.tm_min, g.tm_sec);
        // The delta against the board's own clock is the useful half: it says whether
        // the time the mast would get over 4G agrees with the time it already has.
        long drift = (long)unix - (long)time(nullptr);
        detail = String(when) + ", round trip " + String(rt) + " ms, board clock off by "
               + String(drift) + " s";
        ok = true;
      }
    }
  }
  lwip_close(sock);
  return ok;
}

// Third question of the same shape: does a NAME turn into an address over the modem.
//
// It has to be asked by hand, because lwIP's resolver is global — one table shared by
// every interface — so an ordinary getaddrinfo() at home is answered by the home router
// over WiFi and says nothing about the 4G link. The resolver pinned on the PPP interface
// in the DIALING branch cannot be read back either (dnsIP() reads that same global
// table), so the only honest way to know the pin works is to send the query at it
// directly, from a socket bound to the PPP address. On the mast this whole dance stops
// being necessary — there PPP is the default route and the global resolver IS this one —
// but on the mast is exactly where finding out would be too late.
//
// The query is assembled by hand rather than borrowed from a library: it is 12 bytes of
// header, the name in length-prefixed labels, and four bytes of type and class.
static bool modemDnsProbe(const String& name, IPAddress server, String& detail) {
  if (!PPP.hasIP()) { detail = "no PPP address"; return false; }
  if (name.length() == 0 || name.length() > 200) { detail = "bad name"; return false; }

  uint8_t  q[300];
  uint16_t id = (uint16_t)random(1, 65535);
  q[0] = id >> 8; q[1] = id & 0xFF;
  q[2] = 0x01; q[3] = 0x00;      // standard query, recursion desired
  q[4] = 0x00; q[5] = 0x01;      // one question
  q[6] = q[7] = q[8] = q[9] = q[10] = q[11] = 0;
  int w = 12;

  // Labels: every dot becomes a length byte in front of the piece that follows it.
  int start = 0;
  while (start <= (int)name.length()) {
    int dot = name.indexOf('.', start);
    if (dot < 0) dot = name.length();
    int len = dot - start;
    if (len <= 0 || len > 63) { detail = "bad label in name"; return false; }
    q[w++] = (uint8_t)len;
    for (int i = 0; i < len; i++) q[w++] = (uint8_t)name.charAt(start + i);
    start = dot + 1;
  }
  q[w++] = 0x00;                 // root label ends the name
  q[w++] = 0x00; q[w++] = 0x01;  // QTYPE  = A
  q[w++] = 0x00; q[w++] = 0x01;  // QCLASS = IN

  int sock = lwip_socket(AF_INET, SOCK_DGRAM, IPPROTO_UDP);
  if (sock < 0) { detail = "socket() failed"; return false; }

  bool ok = false;
  struct sockaddr_in src;
  memset(&src, 0, sizeof(src));
  src.sin_family      = AF_INET;
  src.sin_port        = 0;
  src.sin_addr.s_addr = (uint32_t)PPP.localIP();

  if (lwip_bind(sock, (struct sockaddr*)&src, sizeof(src)) != 0) {
    detail = "bind to the PPP address failed, errno " + String(errno);
  } else {
    struct timeval tv;
    tv.tv_sec  = MODEM_NTP_MS / 1000;
    tv.tv_usec = (MODEM_NTP_MS % 1000) * 1000;
    lwip_setsockopt(sock, SOL_SOCKET, SO_RCVTIMEO, &tv, sizeof(tv));

    struct sockaddr_in dst;
    memset(&dst, 0, sizeof(dst));
    dst.sin_family      = AF_INET;
    dst.sin_port        = lwip_htons(53);
    dst.sin_addr.s_addr = (uint32_t)server;

    unsigned long t0 = millis();
    if (lwip_sendto(sock, q, w, 0, (struct sockaddr*)&dst, sizeof(dst)) != w) {
      detail = "sendto failed, errno " + String(errno);
    } else {
      uint8_t r[512];
      int got = lwip_recv(sock, r, sizeof(r), 0);
      unsigned long rt = millis() - t0;
      if (got < 12) {
        detail = "no reply in " + String(rt) + " ms, errno " + String(errno);
      } else if (r[0] != q[0] || r[1] != q[1]) {
        detail = "reply id does not match the query";   // someone else's answer
      } else if ((r[3] & 0x0F) != 0) {
        detail = "server answered rcode " + String(r[3] & 0x0F) + " after " + String(rt) + " ms";
      } else {
        int qd = (r[4] << 8) | r[5];
        int an = (r[6] << 8) | r[7];
        int at = 12;
        // Walk past the echoed question(s): labels until a zero byte, then type+class.
        for (int i = 0; i < qd && at < got; i++) {
          while (at < got && r[at] != 0) {
            if ((r[at] & 0xC0) == 0xC0) { at += 2; break; }   // compression pointer
            at += 1 + r[at];
          }
          if (at < got && r[at] == 0) at++;
          at += 4;
        }
        for (int i = 0; i < an && at + 12 <= got; i++) {
          if ((r[at] & 0xC0) == 0xC0) at += 2;
          else { while (at < got && r[at] != 0) at += 1 + r[at]; at++; }
          if (at + 10 > got) break;
          int type = (r[at] << 8) | r[at + 1];
          int rdl  = (r[at + 8] << 8) | r[at + 9];
          at += 10;
          if (type == 1 && rdl == 4 && at + 4 <= got) {
            detail = name + " -> " + String(r[at]) + "." + String(r[at + 1]) + "."
                   + String(r[at + 2]) + "." + String(r[at + 3])
                   + " in " + String(rt) + " ms, asked " + server.toString();
            ok = true;
            break;
          }
          at += rdl;
        }
        if (!ok) detail = "reply carried no A record, " + String(an) + " answers, "
                        + String(rt) + " ms";
      }
    }
  }
  lwip_close(sock);
  return ok;
}
#endif  // MODEM_USE_PPP

// AT console for the 4G/GPS module, over the network instead of over a cable. It exists
// because the module sits label-down on the breadboard with its own micro-USB facing the
// table: the UART pair is the only way in, and the alternative was flashing a bridge
// sketch that would have taken the whole station (dashboard, OTA, telemetry) with it.
//
//   GET  /api/at?cmd=AT%2BCSQ   from a browser's address bar. "+" MUST be written %2B —
//                               WebServer decodes a literal + as a space.
//   POST /api/at                body = the raw command, Content-Type: text/plain. No
//                               escaping. The content type matters: with curl's default
//                               form type the body is form-decoded and + becomes a space
//                               all over again.
//   GET  /api/at                no command — collect whatever the modem said since:
//                               URCs, the NMEA stream, the answer to a slow command.
//   &wait=N                     how long to wait for the reply, ms (default 500, clamped
//                               to 0..3000). AT+COPS=? can take two minutes: fire it with
//                               wait=0 and pick the answer up afterwards. That is the
//                               whole reason the buffer outlives the request.
//   &pins=RX,TX                 re-open UART2 on other pins, e.g. pins=25,27. Only 25, 26
//                               and 27 are accepted — the three this harness can plausibly
//                               sit on. Which of the two wires landed on which pin is a
//                               coin flip, and guessing wrong otherwise costs a USB
//                               session with the buttons.
//   &baud=N                     re-open at another rate (9600..921600). A modem answering
//                               at the wrong baud is indistinguishable from one that is
//                               not wired at all.
//
// Both are RAM only, same rule as /api/zero: the combination that works has to go back
// into PIN_MODEM_RX / PIN_MODEM_TX / MODEM_BAUD to survive a reboot.
//
// The wait DOES block loop() for its duration — up to 3 s of frozen dashboard if asked
// for. That is a deliberate, operator-initiated, bounded stall and it shows up honestly
// in loopMax; it is a different animal from the unbounded block on a lagging SSE client
// that sseFlush() exists to avoid.
//
// Deliberately NOT wrapped in sendCors(): every other endpoint is read-only telemetry,
// while a command here can send an SMS or reset the modem. Without the header a page open
// in a browser on this network can still fire a request blind, but it cannot read the
// reply — so it cannot lift the IMEI, the ICCID or the SIM contents out of a foreign tab.
// That narrows the hole. HAS_MODEM 0 is what closes it.
void handleAt() {
  if (crossSiteWrite()) return;
  // Re-wiring first, so ?pins=25,27&cmd=AT does both in one request.
  bool reopen = false;
  if (server.hasArg("pins")) {
    String v = server.arg("pins");
    int comma = v.indexOf(',');
    if (comma > 0) {
      int rx = v.substring(0, comma).toInt();
      int tx = v.substring(comma + 1).toInt();
      // Whitelist, not a range check: an arbitrary number here would let a query string
      // point the UART at an LED or a strapping pin.
      bool okRx = (rx == 25 || rx == 26 || rx == 27);
      bool okTx = (tx == 25 || tx == 26 || tx == 27);
      if (okRx && okTx && rx != tx) { modemPinRx = rx; modemPinTx = tx; reopen = true; }
    }
  }
  if (server.hasArg("baud")) {
    long b = server.arg("baud").toInt();
    if (b >= 9600 && b <= 921600) { modemBaud = (unsigned long)b; reopen = true; }
  }
  // Silently ignored while PPP owns the pair: Serial2 is closed, and re-opening it here
  // would point a second UART peripheral at pins esp-modem is actively driving. Use
  // /api/modem?off first if the wiring really has to be moved.
  if (reopen && !modemPppOwnsUart()) { modemUartStart(); modemLen = 0; }

  String cmd;
  if (server.hasArg("plain"))     cmd = server.arg("plain");   // POST body, not form-decoded
  else if (server.hasArg("cmd"))  cmd = server.arg("cmd");
  cmd.trim();

  unsigned long waitMs = 500;
  if (server.hasArg("wait")) waitMs = (unsigned long)constrain(server.arg("wait").toInt(), 0L, 3000L);

  String out;
  unsigned long waited = 0;

#if MODEM_USE_PPP
  // Same console, same URL, different pipe. Once PPP is up the UART belongs to esp-modem
  // and Serial2 is closed, but CMUX carries an AT channel alongside the data channel — so
  // the command goes down that instead and the console keeps working while the station is
  // online. That matters more than it sounds: on the mast this is the only handle on the
  // modem there will ever be, and losing it the moment the link comes up would be the
  // worst possible trade.
  if (modemPppOwnsUart()) {
    if (cmd.length()) {
      // wait=0 is meaningless here — esp_modem takes a timeout, not a poll budget, and 0
      // would fail every command instantly. The console's "fire and collect later" trick
      // does not exist on this path because CMUX answers on its own channel anyway.
      String reply;
      unsigned long t0 = millis();
      bool ok = PPP.cmd(cmd.c_str(), reply, (int)(waitMs ? waitMs : 500));
      waited = millis() - t0;
      out = "> " + cmd + "\n" + reply;
      if (!out.endsWith("\n")) out += "\n";
      out += "-- ok=" + String(ok ? 1 : 0);
    } else {
      // No URC buffer on this path: esp-modem consumes the unsolicited traffic itself.
      out = "-- no command; URCs are consumed by esp-modem while PPP is up";
    }
    out += " via=CMUX state=" + String(modemPppStateName())
         + " waited=" + String(waited) + "ms\n";
    server.send(200, "text/plain", out);
    return;
  }
#endif

  if (cmd.length()) {
    modemLen = 0;              // the reply to THIS command and nothing older
    Serial2.print(cmd);
    Serial2.write('\r');       // SIMCom terminates on a bare CR, never on LF
    unsigned long t0 = millis();
    while (millis() - t0 < waitMs) {
      modemPump();
      if (modemAnswered()) break;
      delay(2);                // vTaskDelay under the hood — the WiFi stack keeps running
    }
    waited = millis() - t0;
    out = "> " + cmd + "\n";
  } else {
    modemPump();
  }

  // Raw bytes, not JSON: this is a console, and escaping a modem's CR/LF into a string
  // literal makes every answer harder to read for no gain in a browser.
  out.reserve(out.length() + modemLen + 96);
  for (size_t i = 0; i < modemLen; i++) out += modemBuf[i];
  // "uart=" is here so a silent modem is never ambiguous about which pins were listening.
  out += "\n-- buf=" + String(modemLen) + " total=" + String(modemRxTotal)
       + " waited=" + String(waited) + "ms"
       + " uart=RX" + String(modemPinRx) + "/TX" + String(modemPinTx)
       + "@" + String(modemBaud) + "\n";

  server.send(200, "text/plain", out);
}
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
void loop() {
  unsigned long loopStart = millis();
  // Time spent inside the Serial telemetry line, charged to its own number and taken back
  // out at the bottom — the same treatment the modem gets, for a sharper reason. The print
  // happens in the very pass that then zeroes loopMaxMs, so its own cost is the first
  // thing written into the fresh counter: without this, loopMax reports the length of the
  // diagnostic string whenever nothing else in the window was slower, and the one number
  // watched for "something is starving readSensors()" answers a question nobody asked.
  unsigned long logBusy = 0;

  ArduinoOTA.handle();
  server.handleClient();

#if HAS_MODEM
  // Every pass, not on a timer: the driver's ring holds well under a second of a running
  // NMEA stream, and what is not drained in time is simply lost. Skipped once PPP owns
  // the pins — Serial2 is closed then, and esp-modem does its own draining.
  if (!modemPppOwnsUart()) modemPump();
#endif

#if HAS_MODEM && MODEM_USE_PPP
  // Unthrottled, like serviceUplink(): an ordinary pass costs one comparison, and every
  // step that is actually expensive sits behind its own timer inside. The cost of the
  // expensive passes is measured here rather than left to loopMaxMs — see modemBusyMaxMs.
  unsigned long modemBusy = millis();
  serviceModem();
  // Inside the same measured window on purpose: the once-a-minute radio refresh is four
  // AT round trips, exactly the kind of stall modemBusyMaxMs exists to account for, and
  // leaving it outside would push it into loopMaxMs where it would read as "something is
  // starving the sensor loop" once every sixty seconds.
  modemRadioRefresh();
  modemBusy = millis() - modemBusy;
  if (modemBusy > modemBusyMaxMs) modemBusyMaxMs = modemBusy;
#endif

  serviceClock();

#if SECRET_HAS_CLOUD
  // Unthrottled like the other service functions: an ordinary pass is a couple of
  // comparisons, every periodic action inside is behind its own timer, and nothing here
  // ever touches the network — publishing is a memcpy into the MQTT task's outbox.
  serviceCloud();
#endif

  if (millis() - lastRead > READ_INTERVAL_MS) {
    readSensors();
    lastRead = millis();
  }

  // Queue a frame for the SSE subscriber (if any); drop the slot once it disconnects.
  // Only one frame is ever outstanding: if the previous one has not finished leaving,
  // this tick is skipped rather than queued behind it, so the link never accumulates a
  // backlog of samples the dashboard would render late.
  if (millis() - lastSse > SSE_PUSH_MS) {
    if (sseClient.connected()) {
      if (sseSent >= sseFrame.length()) {
        sseFrame = "data: " + buildDataJson() + "\n\n";
        sseSent  = 0;
      } else {
        sseDropped++;
      }
    } else {
      sseClient.stop();
      sseFrame = "";
      sseSent  = 0;
    }
    lastSse = millis();
  }

  // Every pass, not every push: a frame the socket could only take half of drains as
  // soon as the window reopens instead of waiting out the next 50 ms tick.
  sseFlush();

#if HAS_DISPLAY_LINK
  serviceDisplayLink();
#endif

  // Serial log stays slow — 250 ms would flood the console.
  if (millis() - lastLog > 2000) {
    lastLog = millis();
    // loopMax and sse are the two numbers that tell a laggy dashboard from a laggy
    // sensor: loopMax is the longest single pass since the last line (anything past a
    // few ms means something in loop() is blocking and readSensors() is being starved),
    // sse counts frames skipped because the subscriber could not take them in time.
    // "±N" is the spread of the last sample burst. It is printed next to the raw mV on
    // purpose: those two together say whether a wrong reading is a wrong zero point
    // (mV off, spread small) or interference (mV jumping, spread large).
    // heap is here because of the cloud channel and it is not decoration: mbedTLS holds
    // two 16 kB record buffers for as long as the MQTT socket lives, so the number to
    // watch is the MINIMUM after the link has been up a while — not the free figure
    // right after boot, which is measured before any of that has been allocated.
    Serial.printf("V=%.1f m/s (%.0f mV ±%.0f, zero %.0f)  D=%.0f°  G=%.1f  "
                  "Bat=%.2fV (%d%%) %s/%s  RSSI=%d  loopMax=%lums (log %lums)  "
                  "sseDrop=%lu  dispDrop=%lu  heap=%lu/min %lu\n",
                  windSpeed, speedMvRaw, speedMvSpread, speedZeroMv, windDir, windGust,
                  batteryVoltage, batteryPercent, powerSource, chargeState, wifiRssi,
                  loopMaxMs, logBusyLast, sseDropped,
#if HAS_DISPLAY_LINK
                  displayDropped,
#else
                  0UL,
#endif
                  (unsigned long)ESP.getFreeHeap(), (unsigned long)ESP.getMinFreeHeap());
    logBusy     = millis() - lastLog;
    logBusyLast = logBusy;
    loopMaxMs   = 0;
    sseDropped  = 0;
#if HAS_DISPLAY_LINK
    displayDropped = 0;
#endif
  }

  // LED status updates independently so LED_WIFI follows the client count without
  // waiting on the 2-second Serial tick.
  if (millis() - lastLed > 500) {
    updateLEDs();
    lastLed = millis();
  }

  if (millis() - lastRssi > 5000) {
    wifiRssi = readClientRssi();
    lastRssi = millis();
  }

  if (millis() - lastBattery > 30000) {
    readBattery();
    lastBattery = millis();
  }

  // Fast poll: the charger blinks at ~1 Hz when it has no pack to work with.
  if (millis() - lastCharge > 100) {
    readChargeStatus();
    lastCharge = millis();
  }

  if (millis() - gustResetTimer > 600000) {
    windGust = windSpeed;
    gustResetTimer = millis();
  }

  // The AP itself has nothing to service — it has no uplink that can drop, so the
  // manual switch, the 3-minute fallback AP and the 30 s blocking wifiMulti.run()
  // that used to sit here are gone for good. What is left is the optional uplink,
  // and it is a different thing entirely: no rescan, no blocking call, and no
  // authority over the AP. Unthrottled because a pass costs one cached status read;
  // the expensive part, WiFi.begin(), is behind staNextAttempt.
#if HAS_HOME_NETWORK
  serviceUplink();
#endif

  unsigned long elapsed = millis() - loopStart;
#if HAS_MODEM && MODEM_USE_PPP
  // Modem time is charged to modemBusyMaxMs and taken back out here. Not to flatter the
  // number: loopMaxMs is reset on every telemetry line, so one synchronous PPP.begin()
  // would make the line that reports the bring-up — the one someone is reading precisely
  // to see whether the modem hurt anything — say 188 ms and hide the only thing it is
  // actually watched for, the sensor loop or an SSE write going slow.
  elapsed = (elapsed > modemBusy) ? elapsed - modemBusy : 0;
#endif
  elapsed = (elapsed > logBusy) ? elapsed - logBusy : 0;
  if (elapsed > loopMaxMs) loopMaxMs = elapsed;
}
