temafey/ArduinoWindStation/images/build_wiring_final.py

# -*- coding: utf-8 -*-
"""Собирает ../wiring-final.html — финальная схема на жёстких перемычках.

Вход:  images/wiring_final.svg (генерится gen_wiring_final_svg.py)
Выход: wiring-final.html в корне проекта (SVG инлайном, без внешних файлов)
"""
import os

ROOT = r"C:\Users\temaf\OneDrive\Documents\Projects\TymurWindStation"
IMG  = os.path.join(ROOT, "images")

with open(os.path.join(IMG, "wiring_final.svg"), encoding="utf-8") as f:
    svg = f.read()

CSS = open(os.path.join(IMG, "_std_css.txt"), encoding="utf-8").read()

EXTRA_CSS = """
.wrap{max-width:1500px}
table.buy{width:100%;border-collapse:collapse;font-size:14px;margin-top:8px}
table.buy th,table.buy td{padding:7px 10px;border-bottom:1px solid #e6e2d8;text-align:left;vertical-align:top;color:#1a1a1a}
table.buy th{font-size:12px;text-transform:uppercase;letter-spacing:.04em;color:#8a8375;font-weight:700}
table.buy td.q{white-space:nowrap;color:#b4552a;font-weight:700}
.two{display:grid;grid-template-columns:1fr 1fr;gap:22px}
@media(max-width:900px){.two{grid-template-columns:1fr}}
.card{background:#fff;border:1px solid #e6e2d8;border-radius:12px;padding:14px 16px}
.card h3{margin:0 0 6px;font-size:15px;color:#1a1a1a;font-weight:800}
.card p{margin:0;font-size:14px;line-height:1.5;color:#4a453c}
"""

STEPS = """
  <li><span><b class="ref">Поставь PPTC на место F1</b> (колонки <b class="col">44j</b>–<b class="col">46j</b>).
      Сейчас там голая перемычка — цепь батареи без защиты. Померь сопротивление нового PPTC:
      должно быть <b>0.1–0.3&nbsp;Ω</b>. Это <b>первый</b> шаг: после фиксации проводов туда уже не залезть.</span></li>
  <li><span><b>Перетыкание — по одному проводу за раз.</b> Вынул dupont из колонки — тут же вставил
      жёсткий 22&nbsp;AWG в <b>ту же колонку, но в свежий ряд</b>. Колонка = 5 отверстий = один узел,
      поэтому электрически ничего не меняется, а пружина берётся нетронутая.
      Не выдёргивай по пять штук «чтобы потом воткнуть» — потеряешь схему.</span></li>
  <li><span><b>Мосты через разрез — по два на каждый рельс, 8 штук.</b> Весь ток станции
      (пики WiFi ~0.5&nbsp;А) идёт через 4 пружинных контакта одиночного моста: он греется и разбалтывается.
      После установки прозвони каждый мост — сопротивление около нуля.</span></li>
  <li><span><b>Проверь ШИНУ мультиметром: 4.6–4.8&nbsp;В</b> в обоих режимах — от адаптера и от батареи.
      Позиция V⎓, чёрный щуп на «−» рельс.</span></li>
  <li><span><b>Wiggle-тест каждого провода.</b> Пошевели каждый провод пальцем, глядя в
      <b class="mono">http://192.168.1.223/api/data</b>: значения не должны дёргаться, станция не должна
      перезагружаться. Провод, который «моргает», — переставь в другой ряд той же колонки.</span></li>
  <li><span><b>Закрытие.</b> Модули — на дно на термоклей, прижимной поролон в крышку,
      пакетик индикаторного силикагеля, дренажное отверстие 2&nbsp;мм в нижней стенке.</span></li>
"""

NOTES = """
  <div class="note warn"><i>⚠</i><span><b>0.5&nbsp;мм (Cat5e) вместо dupont — ловушка.</b>
    Штырёк dupont квадратный <b>0.64&nbsp;мм</b> (диагональ 0.9&nbsp;мм) и необратимо раздвигает пружину,
    рассчитанную на 0.51–0.64&nbsp;мм. Провод 0.5&nbsp;мм в уже разношенном отверстии держит <b>хуже</b>,
    чем держал dupont. Нужен <b>22&nbsp;AWG / 0.64&nbsp;мм круглый</b> — и по возможности свежее отверстие.</span></div>
  <div class="note warn"><i>⚠</i><span><b>Термоклей поверх поля проводов — нельзя.</b>
    Затекает в отверстия по капилляру, гнездо мертво навсегда. Термоклей — только приклеить модули ко дну
    и как разгрузка на паяных узлах. Механику держит прижимной поролон в крышке.</span></div>
  <div class="note warn"><i>⚠</i><span><b>Силикон только нейтральный.</b>
    Acetoxy (пахнет уксусом) выделяет уксусную кислоту и разъедает бронзовые пружины макетки изнутри корпуса.</span></div>
  <div class="note warn"><i>⚠</i><span><b>Колонки 44, 48, 52, 56 живут дважды.</b>
    Верхний банк (ряд a) — светодиоды, нижний (f–j) — питание и делители. Это <b>разные</b> узлы,
    траншея посередине их разделяет. Не перепутай при перетыкании.</span></div>
  <div class="note ok"><i>✓</i><span><b>Корпус внизу, в тени — условие годности решения.</b>
    Без вибрации мачты и без нагрева на солнце пружинные контакты живут годами.
    На мачту идёт только датчик, кабелем до 4&nbsp;м.</span></div>
  <div class="note info"><i>→</i><span><b>Про STDBY / GPIO19 — см. врезку справа на схеме.</b>
    Плата DevKit V1 шириной 25.4&nbsp;мм закрывает свои колонки: свободен только один ряд.
    Если это ряд <b>a</b>, нижние пины (3V3, 19, 21…) в отверстие не выведены и GPIO19 недоступен —
    тогда STDBY идёт на <b>GPIO35</b> через делитель 10k/20k. Проверь на живой плате до пайки.</span></div>
"""

BUY = [
    ("Набор жёстких перемычек 22 AWG (0.64 мм)", "1 набор",
     "Готовые П-образные, уже зачищены и загнуты. Именно 22 AWG — 0.5 мм не держит в разношенном отверстии."),
    ("PPTC 2–3 А (на место F1)", "1 шт",
     "Сейчас там голая перемычка. Ставится ПЕРВЫМ, до фиксации и закрытия корпуса."),
    ("Силикон нейтральный (oxime/alcoxy)", "1 туба",
     "Для гермовводов и уплотнения. НЕ acetoxy — уксусная кислота ест пружины."),
    ("Силикагель индикаторный", "1 пакетик",
     "В корпус. Меняет цвет — видно, когда насытился."),
    ("Поролон / EVA 8–10 мм", "лист",
     "В крышку, прижимает провода к макетке сверху. Заменяет термоклей как механику."),
    ("Дренаж: вентиляционный клапан или сверло 2 мм", "1 шт",
     "Отверстие в НИЖНЕЙ стенке корпуса — выпускает конденсат."),
]

buy_rows = "".join(
    '<tr><td><b>%s</b><br><span style="color:#6b6559">%s</span></td><td class="q">%s</td></tr>' % (n, d, q)
    for n, q, d in BUY)

html = """<!doctype html>
<html lang="ru">
<head>
<meta charset="utf-8">
<meta name="viewport" content="width=device-width, initial-scale=1">
<title>Финальная схема на жёстких перемычках · метеостанция</title>
<style>%s%s</style>
</head>
<body>
<div class="wrap">
  <header>
    <div class="eyebrow">Метеостанция ветра · финальная разводка</div>
    <h1>Карта отверстий и перемычек</h1>
    <p class="lede">Та же схема, что и раньше, — но каждый dupont заменён <b>жёсткой перемычкой 22&nbsp;AWG</b>
      в свежем отверстии. Топология и колонки <b>не меняются</b>: правило «<b>та же колонка, другой ряд</b>»,
      потому что колонка макетки — это 5 отверстий одного узла. Ниже — схема с адресом каждого конца
      и список нарезки с готовыми длинами.</p>
  </header>

  <section>
    <div class="board">%s</div>
    <p class="hint">Точка = контакт в отверстии. Пересечение <b>без точки</b> = провод просто лежит поверх.
      Пунктир = внешний вывод (к модулю, датчику или на пайку) — это не перемычка макетки.
      На узком экране схему можно прокрутить вбок.</p>
  </section>

  <section>
    <h2>Почему это работает</h2>
    <div class="two">
      <div class="card">
        <h3>Колонка = 5 отверстий = один узел</h3>
        <p>Перенести провод из ряда <b>j</b> в ряд <b>g</b> — электрически ничего не меняет,
          но пружина берётся нетронутая. Верхний банк колонок 17–56 почти девственный —
          это и есть запас свежих отверстий.</p>
      </div>
      <div class="card">
        <h3>Жёсткий провод не тянет вверх</h3>
        <p>Гибкий dupont с колпачком висит и работает рычагом на пружину.
          Отрезок жёсткого 22&nbsp;AWG, загнутый под 90°, лежит на плате и сам себя держит —
          вынуть его можно только пальцами.</p>
      </div>
      <div class="card">
        <h3>Два моста вместо одного</h3>
        <p>Рельсы MB-102 разрезаны посередине. Одиночный мост пропускает весь ток станции
          через 4 пружинных контакта: греется, окисляется, разбалтывается. Дублёр снимает половину тока
          и страхует при потере контакта.</p>
      </div>
      <div class="card">
        <h3>Что всё равно паяется</h3>
        <p>Два провода на TP4056 — с катодов красного (CHRG) и синего (STDBY) светодиодов.
          Там нет ни площадки, ни разъёма. Это решено раньше и не меняется.</p>
      </div>
    </div>
  </section>

  <section>
    <h2>Порядок работ</h2>
    <p class="sub">Жёстко по порядку: PPTC — первым, закрытие корпуса — последним.</p>
    <ol class="steps">%s</ol>
  </section>

  <section>
    <h2>Что не перепутать</h2>
    <div class="notes">%s</div>
  </section>

  <section>
    <h2>Что докупить</h2>
    <p class="sub">Без этого работу не начать — особенно PPTC и жёсткие перемычки.</p>
    <div class="card"><table class="buy"><tr><th>Позиция</th><th>Кол-во</th></tr>%s</table></div>
  </section>
</div>
</body>
</html>
""" % (CSS, EXTRA_CSS, svg, STEPS, NOTES, buy_rows)

out = os.path.join(ROOT, "wiring-final.html")
with open(out, "w", encoding="utf-8") as f:
    f.write(html)
print("wrote", out, "%.1f KB" % (len(html.encode("utf-8")) / 1024))
