temafey/ArduinoWindStation/images/build_wiring_v9.py

# -*- coding: utf-8 -*-
"""Собирает ../wiring-v9.html — KCD4 НА ДВА ПОЛЮСА + десять плюсовых цепей своими цветами.

Прямая наследница build_wiring_v8.py. Плата, распиновка, модем, делители, светодиоды,
конденсаторы и вся земля унаследованы от v8 и НЕ тронуты ни одним решением. Меняется
ровно один компонент и всё, что из него следует.

Что меняет v9:

  * SW1 стал клавишным KCD4 (250 В, 16 А, ЧЕТЫРЕ ножевых контакта) — это два
    независимых полюса на одной клавише (DPST). Полюс A остался там же, где стоял
    однополюсный SW1 в v8: в разрыве OUT+ TP4056, 49j → A1, A2 → 51j. Полюс B — новый:
    39j (узел ШИНА) → B1, B2 → нижний «+» рельс, кол.43.
  * из-за полюса B исчез самый длинный провод схемы: 39g → вниз → x≈660 → через всю
    картинку наверх → кол.16 → верхний «+». Его больше нет вовсе.
  * питание платы пошло СПРАВА НАЛЕВО: нижний «+» правый → связка кол.58 → верхний «+»
    правый → 61a (Boost#1) и через мост 31↔32 налево к «5V» ESP32.
  * все плюсовые провода перекрашены: десять цепей — десять цветов (P1…P10), номера
    продублированы в списке соединений на самой схеме.

Вход:  images/wiring_v9.svg и images/power_v9.svg
Выход: wiring-v9.html в корне проекта (обе картинки инлайном, без внешних файлов)
"""
import os

ROOT = r"C:\Users\temaf\OneDrive\Documents\Projects\TymurWindStation"
IMG = os.path.join(ROOT, "images")

with open(os.path.join(IMG, "wiring_v9.svg"), encoding="utf-8") as f:
    svg = f.read()
with open(os.path.join(IMG, "power_v9.svg"), encoding="utf-8") as f:
    svg_power = f.read()

CSS = open(os.path.join(IMG, "_std_css.txt"), encoding="utf-8").read()

# Стили те же, что в v8, плюс три новых класса под таблицу плюсовых цепей: квадрат
# образца цвета, моноширинный hex и подсветка двух пар, которые важнее всех остальных
# (P4/P5 — до и после полюса A, P7/P8 — до и после полюса B).
EXTRA_CSS = """
.wrap{max-width:1560px}
table.buy{width:100%;border-collapse:collapse;font-size:14px;margin-top:8px}
table.buy th,table.buy td{padding:7px 10px;border-bottom:1px solid #e6e2d8;text-align:left;vertical-align:top;color:#1a1a1a}
table.buy th{font-size:12px;text-transform:uppercase;letter-spacing:.04em;color:#8a8375;font-weight:700}
table.buy td.q{white-space:nowrap;color:#b4552a;font-weight:700}
.two{display:grid;grid-template-columns:1fr 1fr;gap:22px}
@media(max-width:900px){.two{grid-template-columns:1fr}}
.card{background:#fff;border:1px solid #e6e2d8;border-radius:12px;padding:14px 16px}
.card h3{margin:0 0 6px;font-size:15px;color:#1a1a1a;font-weight:800}
.card p{margin:0;font-size:14px;line-height:1.5;color:#4a453c}
.card.new{border-color:#e0c2b4;background:#fffaf7}
.card.cost{border-color:#d8c48a;background:#fdfaf0}
.card.esp{border-color:#b9c8e6;background:#f7f9fe}
.card.hot{border-color:#e0a9a1;background:#fdf3f2}
table.pads{width:100%;border-collapse:collapse;font-size:13.5px;margin-top:6px}
table.pads th,table.pads td{padding:6px 9px;border-bottom:1px solid #e6e2d8;text-align:left;color:#1a1a1a}
table.pads th{font-size:11.5px;text-transform:uppercase;letter-spacing:.04em;color:#8a8375;font-weight:700}
table.pads td.c{font-weight:700;color:#b4552a;white-space:nowrap}
table.pads tr.sep td{border-top:2px solid #d8d2c0;padding-top:10px}
table.pads tr.grp4g td{background:#fff3ec}
table.pads tr.grpsw td{background:#eef6ee}
table.pads tr.grpesp td{background:#eef2fb}
.chain{margin:0 0 14px;padding:11px 13px;border:1px solid #e6e2d8;border-radius:7px;background:#fcfbf7}
.chain-h{font-size:12px;text-transform:uppercase;letter-spacing:.04em;color:#8a8375;font-weight:700}
.chain-w{margin:7px 0 6px;font-family:Consolas,monospace;font-size:13px;line-height:1.65;color:#b4552a;white-space:pre-wrap;overflow-x:auto}
.chain-n{font-size:13px;line-height:1.55;color:#4a453c}
table.chk{width:100%;border-collapse:collapse;font-size:13.5px;margin-top:6px}
table.chk th,table.chk td{padding:7px 9px;border-bottom:1px solid #e6e2d8;text-align:left;vertical-align:top;color:#1a1a1a}
table.chk th{font-size:11.5px;text-transform:uppercase;letter-spacing:.04em;color:#8a8375;font-weight:700}
table.chk td.n{color:#8a8375;font-weight:700;white-space:nowrap}
table.chk td.c{font-weight:700;color:#b4552a;white-space:nowrap;font-family:Consolas,monospace}
table.chk td.exp{font-weight:700;color:#2e7d32;white-space:nowrap}
table.circ{width:100%;border-collapse:collapse;font-size:13.5px;margin-top:6px}
table.circ th,table.circ td{padding:7px 9px;border-bottom:1px solid #e6e2d8;text-align:left;vertical-align:top;color:#1a1a1a}
table.circ th{font-size:11.5px;text-transform:uppercase;letter-spacing:.04em;color:#8a8375;font-weight:700}
table.circ td.p{font-weight:800;white-space:nowrap;font-family:Consolas,monospace}
table.circ td.v{font-weight:700;color:#2e7d32;white-space:nowrap}
table.circ td.h{font-family:Consolas,monospace;font-size:12px;color:#8a8375;white-space:nowrap}
table.circ tr.key td{background:#fdf6ec}
.sw{display:inline-block;width:15px;height:15px;border-radius:4px;border:1px solid rgba(0,0,0,.25);
    vertical-align:-2px;margin-right:7px}
.tag{display:inline-block;font-size:11px;font-weight:700;letter-spacing:.04em;
     color:#b4552a;background:#fff0e6;border:1px solid #e8c9b6;border-radius:5px;padding:1px 6px;margin-left:6px}
.tag.v8{color:#2f5da8;background:#eef2fb;border-color:#b9c8e6}
.tag.v9{color:#c0392b;background:#fdf3f2;border-color:#e0a9a1}
.gone{color:#8a8375;text-decoration:line-through}
"""

# ═══════════════════════════════════════════════════ ДЕСЯТЬ ПЛЮСОВЫХ ЦЕПЕЙ
# Порядок и цвета обязаны совпадать с gen_wiring_v9_svg.py и gen_power_v9_svg.py —
# человек сверяет таблицу с картинкой по цвету, а не по номеру. key=True подсвечивает
# две пары, которые и показывают, что выключатель реально рвёт.
CIRCUITS = [
    ("P1", "#ff7043", "+5 В адаптера", "5.0 В", False,
     "внешний провод → 37h (анод D1) и 37f → 50b (IN+ TP4056, ⚠ перемычка не поставлена)"),
    ("P2", "#7d1128", "«+» пакета 18650 через F1", "3.0–4.2 В", False,
     "холдер → 42j → F1 (PPTC) → 44j → перемычка 44j→50j → B+ TP4056"),
    ("P3", "#6d4c41", "отвод холдера на делитель батареи", "3.0–4.2 В", False,
     "клемма холдера → отдельным проводом на верх делителя 100k/100k. НЕ от 42j"),
    ("P4", "#c25e00", "OUT+ TP4056 — ДО полюса A", "3.0–4.2 В", True,
     "49f → 49j → A1 выключателя. Больше отсюда не уходит ничего"),
    ("P5", "#a97400", "колонка 51 — ПОСЛЕ полюса A", "3.0–4.2 В / 0", True,
     "A2 → 51j ─┬─ 51i → 55c (IN+ Boost#2)  └─ 51h → ключ GPIO33 → Boost#3 (модем)"),
    ("P6", "#6b8e23", "выход Boost#2", "5.14 В", False,
     "57h → 41h (анод D2) → катод в кол.39"),
    ("P7", "#00838f", "узел ШИНА — ДО полюса B", "~4.7 В", True,
     "катоды D1 и D2 в кол.39 → 39f (C1 «+») и 39j → B1 выключателя"),
    ("P8", "#d23b2e", "«+» LOAD — ПОСЛЕ полюса B", "~4.7 В / 0", True,
     "B2 → «+» низ кол.43 → связка кол.58 → «+» верх правый → 61a и мост 31↔32 → кол.3 → 1a"),
    ("P9", "#c2185b", "12 В на датчик", "12.0 В", False,
     "OUT+ Boost#1 (63h) → 63j → красный провод кабеля на мачту"),
    ("P10", "#ff8f00", "5.2 В на модем", "5.2 В", False,
     "OUT+ Boost#3 (вне макетки) → 40c → контакт «V» модуля A7670E"),
]

circ_rows = "".join(
    '<tr class="%s"><td class="p">%s</td>'
    '<td><span class="sw" style="background:%s"></span><b>%s</b></td>'
    '<td class="v">%s</td><td class="h">%s</td>'
    '<td style="color:#4a453c">%s</td></tr>'
    % ("key" if key else "", p, hexc, name, volt, hexc, route)
    for p, hexc, name, volt, key, route in CIRCUITS)

# ── что где сидит. Первые группы — v9 (выключатель и новая «+» цепь), дальше v8/v6 ──
PADS = [
    ("SW1 · KCD4 на два полюса — то, что добавляет v9",
     "нижний банк · колонки 39, 43, 49 и 51 · четыре ножевых контакта 6.3 мм, провода точка-в-точку",
     False, [
         ("A1 · вход полюса A", "49j", "← OUT+ TP4056. Ровно то место, где в v8 стоял однополюсный SW1"),
         ("A2 · выход полюса A", "51j", "узел «OUT+ после выключателя». Ток до 1.83 А: модем 1.50 + станция 0.33"),
         ("B1 · вход полюса B", "39j", "← узел ШИНА (кол.39, катоды D1 и D2). В v8 колонки 39i/39j были пусты"),
         ("B2 · выход полюса B", "«+» низ, кол.43",
          "нижний «+» рельс, ПРАВАЯ половина. В v8 она не использовалась вовсе. Ток ~0.2 А, пики WiFi до 0.6 А"),
         ("связка «+» правой половины", "кол.58",
          "верх↔низ. Рядом стоит связка «−» той же колонки, но не вплотную — они расходятся и читаются как две разные перемычки"),
         ("нижний «+» ЛЕВЫЙ", "кол.3…31", "НЕ используется: связка кол.20 снята. Половина остаётся пустой намеренно"),
     ]),
    ("Мост «+» 31↔32 — сменил смысл",
     "верхний банк · единственная точка отказа питания ESP32", False, [
         ("мост «+»", "кол.31 ↔ кол.32",
          "в v8 через него шли 75 мА Boost#1 СЛЕВА НАПРАВО. В v9 через него идёт ВЕСЬ ток ESP32 в обратную сторону: ~100 мА средних, до 0.6 А на пиках WiFi"),
         ("что будет, если отойдёт", "симптом",
          "датчик на 12 В останется живым (он питается правее моста), а ESP32 умрёт. Выглядит как «сдохла плата», а не как «нет питания»"),
         ("верхний «−» — НЕ смощён", "разрез 31/32",
          "⛔ и мостить его нельзя ни при каких обстоятельствах: на этом держится вся точность АЦП"),
     ]),
    ("ESP32 DevKitC 38-pin — унаследовано от v8",
     "колонки 1–19, оба банка · верхний ряд в a, нижний в j · USB-C смотрит влево, за край макетки",
     False, [
         ("«5V» → «+» LOAD", "1a → «+» верх, кол.3",
          "ПО ДИАГОНАЛИ: рельс начинается только над кол.3. В v9 ток сюда приходит справа, через мост 31↔32"),
         ("SPI-флеш · НЕ ТРОГАТЬ", "верх 2·3·4, низ 1·2·3",
          "CMD·D3·D2 сверху, CLK·D0·D1 снизу. Запрет НЕсимметричный: <b>1a — это «5V», и его занимать НАДО</b>"),
         ("GND", "6a → верхний «−»", "опора АЦП считается относительно ЭТОГО вывода, а не относительно рельса"),
         ("GPIO13 · CHRG", "5a", "← катод CHRG TP4056, вход с подтяжкой, активный уровень LOW"),
         ("GPIO27 / GPIO25 · UART2", "9a / 11a", "TX (GPIO27) → «R» кол.37 модема, RX (GPIO25) ← «T» кол.38"),
         ("GPIO26 — СВОБОДЕН", "10a", "лежит ровно между двумя проводами UART. Ничего не втыкать"),
         ("GPIO33 · затвор ключа", "12a", "пунктиром: P-FET блока питания модема, план"),
         ("GPIO32 · батарея", "13a", "← середина делителя 100k/100k"),
         ("GPIO35", "14a", "не подключён: у датчика нет канала направления (HAS_DIRECTION 0)"),
         ("GPIO34 · датчик", "15a",
          "⚠ ← 33b. <b>На железе этот провод сейчас стоит в кол.14 (GPIO35)</b> — см. окрик на схеме"),
         ("GPIO4·16·17·5·18 · LED", "7j…11j", "красный · жёлтый · зелёный · зелёный WiFi · красный АЦП"),
         ("GPIO19 · STDBY", "12j", "← катод STDBY TP4056"),
     ]),
    ("Светодиодные резисторы 220 Ω", "нижний банк, ряд i · полоса 22–36, шаг 3 колонки", False, [
        ("R крас.", "22i→24i", "← GPIO4 · → анод LED «ветер >15»"),
        ("R жёлт.", "25i→27i", "← GPIO16 · → анод LED «ветер >5»"),
        ("R зел.", "28i→30i", "← GPIO17 · → анод LED «станция ОК»"),
        ("R зел.", "31i→33i", "← GPIO5 (strapping) · → анод LED «WiFi»"),
        ("R крас.", "34i→36i", "← GPIO18 · → анод LED «ошибка АЦП»"),
        ("общий катод", "нижний «−», кол.46", "земля светодиодов уходит на НИЖНИЙ «−» — верхний трогать нельзя"),
    ]),
    ("Диодная развязка, узел ШИНА и PTC", "нижний банк · колонки 37–44", False, [
        ("D1 анод", "37h", "+5 В адаптера (внешний провод, цепь P1)"),
        ("ШИНА", "39h",
         "катоды D1 и D2 — локальный узел. Отсюда C1 «+» (39f) и полюс B (39j). Провода в кол.16 больше нет"),
        ("D2 анод", "41h", "← Boost#2 OUT+ (перемычка из 57h)"),
        ("F1 / PPTC", "42j→44j", "вход ← «+» пакета · выход → TP4056 B+ (перемычка на 50j)"),
    ]),
    ("TP4056 · Type-C", "ряды b (верх) и f (низ) · колонки 45–50", False, [
        ("IN−", "45b", "«−» верх — провод заводится ДО посадки модуля"),
        ("IN+", "50b",
         "⚠ +5 В адаптера, перемычка с 37f. <b>На железе её НЕТ</b> — обведена на схеме красным пунктиром"),
        ("OUT−", "45f", "«−» низ (снимается из 45i / 45j)"),
        ("B−", "46f", "«−» батарейного пакета, ОТДЕЛЬНАЯ сеть (из 46i)"),
        ("OUT+", "49f", "→ 49j → полюс A выключателя, и больше никуда"),
        ("B+", "50f", "← F1 / PPTC, защищённый «+» батареи (из 50j)"),
    ]),
    ("Boost#2 · MT3608 → 5.14 В", "ряды c (верх) и h (низ) · колонки 53–57", False, [
        ("IN+", "55c", "узел ПОСЛЕ полюса A (перемычка приходит из 51i)"),
        ("IN−", "56c", "«−» верх (из 56a)"),
        ("OUT−", "53h", "«−» низ (из 53j)"),
        ("OUT+", "57h", "→ анод D2 (перемычка на 41h)"),
    ]),
    ("Boost#1 · MT3608 → 12 В", "ряды c (верх) и h (низ) · колонки 59–63", False, [
        ("IN+", "61a → «+» верх",
         "в v9 питается от ПРАВОЙ половины верхнего «+», то есть напрямую от полюса B — не через мост"),
        ("IN−", "62a → кол.61", "по диагонали: рельс обрывается на две колонки раньше банка"),
        ("OUT−", "61h", "«−» низ (из 61j)"),
        ("OUT+", "63h", "красный провод датчика, +12 В (из 63j)"),
    ]),
    ("4G · контакты CN101 — ряд a, колонки 36–42",
     "модуль воткнут штырями, НАКЛЕЙКОЙ ВНИЗ — считать по буквам шелкографии", True, [
         ("«G» = 7 GND", "кол.36", "тот контакт, что вплотную к micro-USB — с него и отсчёт"),
         ("«R» = 6 RXD", "кол.37", "← GPIO27 (TX ESP32), провод приходит в 37d"),
         ("«T» = 5 TXD", "кол.38", "→ GPIO25 (RX ESP32), провод приходит в 38d"),
         ("«K» = 4 PWRKEY", "кол.39", "НЕ подключается: R104 держит его на земле"),
         ("«V» = 3 VCC", "кол.40", "← 5.2 В с Boost#3 (провод в 40c) · C4 «+» в 40e"),
         ("«G» = 2 GND", "кол.41", "единственная земля модема: перемычка 41b → 44b · C4 «−» в 41e"),
         ("«S» = 1 SLEEP", "кол.42", "НЕ подключается"),
     ]),
    ("Земля — не тронута НИ В ОДНОЙ ТОЧКЕ", "то, что в v9 запрещено менять", False, [
        ("верхний «−»", "разрез 31/32", "НЕ смощён. Мёртвая зона слева от кол.31 — то, на чём стоит точность АЦП"),
        ("низ делителя датчика", "35a → кол.31",
         "по ряду a влево и подъём на ЛЕВЫЙ верхний «−». Перенос на правую половину даёт 18–29 мВ падения = 0.15–0.25 м/с призрачного ветра"),
        ("земля модема", "41b → 44b", "уводит 0.4–0.65 А вправо: 41→44→рельс→45a→медь TP4056→45i"),
        ("мост нижнего «−»", "кол.31↔32", "единственный мост по земле, и он на НИЖНЕМ рельсе"),
        ("связки «−»", "кол.21 и кол.58", "левая и правая половины. Обе остаются на месте"),
    ]),
]

pads_rows = ""
for i, (name, geom, is4g, pins) in enumerate(PADS):
    v9 = name.startswith(("SW1", "Мост"))
    esp = name.startswith(("ESP32", "Светодиодные", "Земля"))
    cls = " ".join(x for x in (("sep" if i else ""),
                               ("grpsw" if v9 else "grpesp" if esp else "grp4g" if is4g else "")) if x)
    tag = ('<span class="tag v9">v9</span>' if v9
           else '<span class="tag v8">v8</span>' if esp
           else '<span class="tag">v6</span>' if is4g else "")
    pads_rows += ('<tr class="%s"><td colspan="3"><b>%s</b>%s <span style="color:#6b6559">— %s</span></td></tr>'
                  % (cls, name, tag, geom))
    for pad, hole, what in pins:
        pads_rows += ('<tr><td style="padding-left:22px"><b>%s</b></td><td class="c">%s</td>'
                      '<td style="color:#4a453c">%s</td></tr>' % (pad, hole, what))

STEPS = """
  <li><span><b class="ref">Проверить выключатель мультиметром ДО установки — четыре шага.</b>
      «Четыре контакта» ещё не значит «два полюса»: у части KCD4 четвёртый контакт — это вывод
      лампы подсветки, а не вторая группа. Порядок — в карточке выше; коротко: найти пару
      полюса A, найти вторую пару, которая ходит той же клавишей, и убедиться, что
      <b>между парами обрыв во всех четырёх сочетаниях и в обоих положениях</b>.
      Нашлось конечное сопротивление — это подсветка, и такой выключатель ставится только
      на полюс B, а полюс A остаётся на старом SW1.</span></li>
  <li><span><b class="ref">Обжать четыре провода 22 AWG наконечниками-мамами 6.3 мм.</b>
      Контакты KCD4 — <b>плоские ножевые 6.3 мм</b>, в макетку они не лезут в принципе.
      На один конец каждого провода — клемма-мама, на другой — голый залужённый кончик
      под отверстие макетки. Длины: A1 ≈ 12 см (<b class="col">49j</b>), A2 ≈ 12 см
      (<b class="col">51j</b>), B1 ≈ 14 см (<b class="col">39j</b>), B2 ≈ 14 см
      (<b class="col">«+» низ, кол.43</b>). Каждую клемму после обжима дёрнуть за провод —
      ножевой контакт, вылезший внутри корпуса, ищется потом сутки.</span></li>
  <li><span><b class="ref">Снять длинный провод 39g → кол.16 — первым делом.</b> Это самый
      длинный провод v8: из узла ШИНА вниз, вправо почти до края, потом через всю макетку
      наверх в левую половину «+». В v9 его нет вовсе — его работу делает полюс B.
      Снимать <b>до</b> установки нового выключателя, иначе шина окажется запитана
      с двух сторон и проверка полюса B ничего не покажет.</span></li>
  <li><span><b class="ref">Снять связку «+» кол.20.</b> Нижний «+» ЛЕВЫЙ в v9 не используется
      вообще: тянуть на него нечего, а лишняя перемычка через разрез мешает читать схему.
      Связку «−» кол.21 <b>не трогать</b> — она несущая.</span></li>
  <li><span><b>Поставить связку «+» на кол.58</b>, верх↔низ, правая половина. Она идёт рядом
      с уже стоящей связкой «−» той же колонки, но не вплотную: между корпусами Boost#2
      и Boost#1 остаётся просвет ~18 мм, и в него помещаются обе. Без этой перемычки
      питание с полюса B до платы не дойдёт вовсе.</span></li>
  <li><span><b>Перецепить полюс A.</b> Старый SW1 снять, вместо него: <b class="col">49j</b> →
      A1, A2 → <b class="col">51j</b>. Оба отвода остаются на колонке 51 —
      <b class="col">51i</b> → 55c (Boost#2) и <b class="col">51h</b> → ключ → Boost#3.</span></li>
  <li><span><b>Поставить полюс B.</b> <b class="col">39j</b> → B1, B2 →
      <b class="col">нижний «+» рельс, кол.43</b>. Колонки 39i/39j в v8 были пустыми,
      правая половина нижнего «+» — тоже, так что оба конца садятся в свежие отверстия.</span></li>
  <li><span><b class="ref">Приёмка выключателя — до того, как собрано что-либо ещё.</b>
      Клавиша в OFF, адаптер воткнут: на входах <b>обоих</b> MT3608 ноль, на верхнем «+»
      рельсе ноль, на кол.43 нижнего «+» ноль — и при этом TP4056 показывает заряд.
      Клавиша в ON: на верхнем «+» ~4.7 В. Если при OFF на верхнем «+» что-то есть —
      либо полюс B не в том разрыве, либо длинный провод из третьего шага не снят.</span></li>
  <li><span><b class="ref">Проверить мост «+» 31↔32 отдельно.</b> В v9 это единственная точка
      отказа питания платы: через него идёт весь ток ESP32, справа налево. Перемычка должна
      сидеть плотно в обеих колонках; отойдёт — датчик на 12 В останется живым, а плата
      умрёт, и симптом будет выглядеть как дохлый контроллер.</span></li>
  <li><span><b class="ref">⚠ Поставить перемычку 37f → 50b, если её всё ещё нет.</b>
      Без неё вся таблица состояний — вымысел: адаптер до <b class="mono">IN+</b> TP4056
      не доходит, банка не заряжается ни при каком положении клавиши,
      <b class="mono">powerSource</b> намертво «battery», и главный новый режим
      («OFF + адаптер = заряд вчистую») недостижим. Ставить <b>ДО</b> посадки TP4056:
      отверстие 50b уходит под корпус.</span></li>
  <li><span><b class="ref">⚠ Переставить провод из 33b на колонку 15 (GPIO34).</b> Сейчас
      на железе он стоит в <b class="col">кол.14</b>, а это <b class="mono">GPIO35</b> —
      канал направления, который прошивка не читает (<b class="mono">HAS_DIRECTION 0</b>).
      Вход скорости висит в воздухе, и АЦП упирается в собственный пол:
      <b class="mono">speedMv 142.0</b> при <b class="mono">speedSpreadMv 0</b>.
      Ориентир для руки: <b>GPIO34 — пятнадцатый пятак от разъёма USB</b>.</span></li>
  <li><span><b>Земля — не трогать ничего.</b> Верхний «−» остаётся разрезанным между
      кол.31 и 32 и <b>не мостится</b>; низ делителя датчика по-прежнему уходит из
      <b class="col">35a</b> влево на кол.31; перемычка <b class="col">41b</b>→<b class="col">44b</b>
      остаётся; общий катод светодиодов — на нижнем «−», кол.46. Любая «безобидная»
      перемычка по земле ломает точность АЦП, и прошивкой это не лечится.</span></li>
  <li><span><b>Проверить пресеты бустов на холостом ходу</b>, до подключения нагрузки:
      Boost#2 — 5.14 В, Boost#1 — 12 В, Boost#3 — 5.2 В. Ориентация IN/OUT определяется
      по шагу контактов: <b>ряд РЯДОМ = IN, ряд К КРАЯМ = OUT</b> (на обоих прошлых бустах
      они были перепутаны).</span></li>
  <li><span><b>Проверка топологии: при внешнем питании TP4056 должен доходить до STDBY</b>
      (зелёный на модуле / <b class="mono">chargeState: full</b> в <b class="mono">/api/data</b>).
      В v9 это делается щелчком клавиши в OFF <b>при воткнутом адаптере</b>: полюс A снимает
      нагрузку с зарядного узла, полюс B обесточивает шину, и зарядный узел видит чистую
      банку.</span></li>
"""

NOTES = """
  <div class="note warn"><i>&#9888;</i><span><b>v9 меняет ровно один компонент — тумблер.</b>
    KCD4 (250 В, 16 А) с четырьмя ножевыми контактами = <b>два независимых полюса на одной
    клавише</b>. Полюс A остался там же, где стоял SW1 в v8: в разрыве
    <b class="mono">OUT+</b> TP4056. Полюс B — новый, в разрыве самой шины после диодного ИЛИ.
    Плата, распиновка, модем, делители, конденсаторы, светодиоды и вся земля не тронуты.</span></div>
  <div class="note warn"><i>&#9888;</i><span><b>Зачем полюс B.</b> В шину входят ДВА источника:
    адаптер через D1 и батарея через Boost#2 и D2. Один полюс в батарейной ветке рвёт только
    половину — при воткнутом адаптере D1 продолжает кормить плату, и «выключено» означает
    «выключено наполовину». Полюс B стоит в разрыве шины сразу за диодным ИЛИ:
    <b class="col">39j</b> → B1, B2 → нижний «+» рельс, <b class="col">кол.43</b>.
    Ток через него ~0.2 А (ESP32 ~100 мА + вход Boost#1 ~75 мА), пики WiFi до 0.6 А.</span></div>
  <div class="note ok"><i>&#10003;</i><span><b>Длинного провода 39g → кол.16 больше нет.</b>
    В v8 узел ШИНА уходил вниз, вправо почти до края макетки, потом через весь чертёж наверх
    в левую половину «+» — около 40 см провода поперёк схемы. Его работу делает полюс B,
    и оба его конца стоят прямо под своими колонками: обхода нет вовсе.</span></div>
  <div class="note warn"><i>&#9888;</i><span><b>Мост «+» 31↔32 стал единственной точкой отказа
    питания ESP32.</b> Питание платы теперь приходит СПРАВА: кол.43 низ → связка кол.58 →
    верхний «+» правый → 61a (Boost#1) и параллельно мост 31↔32 → верхний «+» левый → кол.3 →
    по диагонали в 1a. В v8 через мост шли 75 мА Boost#1 слева направо; теперь через него идёт
    весь ток платы в обратную сторону. Отойдёт — <b>датчик на 12 В останется живым, а ESP32
    умрёт</b>: симптом выглядит как дохлая плата, а не как «нет питания».</span></div>
  <div class="note warn"><i>&#9888;</i><span><b>Землю v9 не трогает НИ В ОДНОЙ ТОЧКЕ.</b>
    Верхний «−» по-прежнему разрезан между кол.31 и 32 и <b>НЕ смощён</b>, мост стоит только
    на нижнем «−», низ делителя датчика уходит из <b class="col">35a</b> влево на кол.31,
    перемычка <b class="col">41b</b>→<b class="col">44b</b> уводит возврат модема вправо,
    общий катод светодиодов сидит на нижнем «−» в кол.46. Перенос низа делителя на правую
    половину даёт 18–29 мВ падения на общем проводе — это <b>0.15–0.25 м/с призрачного
    ветра</b>, который ничем себя не выдаёт.</span></div>
  <div class="note info"><i>&#9675;</i><span><b>Нижний «+» ЛЕВЫЙ (кол.3…31) теперь не используется
    вообще.</b> Связка кол.20 снята: тянуть на неё нечего, а лишняя перемычка через разрез
    только запутывала бы чтение. Половина остаётся пустой намеренно — если однажды туда
    что-то сядет, связку придётся ставить заново и осознанно.</span></div>
  <div class="note warn"><i>&#9888;</i><span><b>Отвод на делитель батареи идёт отдельным проводом
    прямо с клеммы холдера</b> (цепь <b class="mono">P3</b>), а не от колонки 42. Это не
    перестраховка: TP4056 без установленного пакета держит <b class="mono">B+</b> на 4.2–4.5 В
    и таким образом <b>подделывает батарею</b>. Делитель, посаженный на 42j, показывал бы
    полный заряд при пустом холдере.</span></div>
  <div class="note warn"><i>&#9888;</i><span><b>Перемычки 37f → 50b на железе НЕТ.</b>
    На схеме она с v6, здесь обведена красным пунктиром вдоль провода и помечена значком «!».
    От платы с диодом до <b class="mono">IN+</b> TP4056 не припаяно ничего: адаптер до зарядного
    узла не доходит, банка не заряжается, <b class="mono">powerSource</b> намертво «battery»,
    а главный новый режим v9 недостижим. Ставить ДО посадки TP4056 — отверстие 50b уходит
    под корпус.</span></div>
  <div class="note warn"><i>&#9888;</i><span><b>Провод 33b → GPIO34 на железе стоит не в той
    колонке.</b> Он воткнут в <b class="col">кол.14</b> (<b class="mono">GPIO35</b>) вместо
    <b class="col">кол.15</b> (<b class="mono">GPIO34</b>) — соседнее отверстие. GPIO35 это
    канал направления, прошивка его не читает, поэтому вход скорости висит в воздухе и АЦП
    показывает собственный пол: <b class="mono">speedMv 142.0</b>,
    <b class="mono">speedSpreadMv 0</b>. Это и есть весь ответ на «почему датчик молчит».
    Ориентир для руки: <b>GPIO34 — пятнадцатый пятак от разъёма USB</b>.</span></div>
  <div class="note info"><i>&#9675;</i><span><b>Точка = соединение, дуга-мостик = провод просто
    лежит поверх.</b> Проводов в v9 стало больше, и пересечений тоже: там, где две цепи
    пересекаются без соединения, верхняя нарисована дугой в обход. Две нотации намеренно
    не похожи — если на пересечении стоит точка, втыкать надо в один узел; если дуга,
    это два разных узла, случайно оказавшихся в одном месте чертежа.</span></div>
  <div class="note info"><i>&#9675;</i><span><b>Шесть контактов SPI-флеша — запрет
    НЕсимметричный.</b> Снизу <b class="mono">CLK · D0 · D1</b> (кол.1–3), сверху
    <b class="mono">CMD · D3 · D2</b> (кол.2–4). А вот <b class="col">1a</b> — это
    <b class="mono">5V</b>, и его занимать <b>надо</b>: перемычка оттуда по диагонали в кол.3
    и есть питание платы. Считать по буквам шелкографии, а не по номеру колонки.</span></div>
"""

HAVE = [
    ("Клавишный выключатель KCD4, 250 В / 16 А, 4 контакта",
     "КУПИТЬ · 1 шт · единственная покупка v9",
     "Четыре ножевых контакта 6.3 мм = два независимых полюса на одной клавише (DPST). "
     "⚠ Проверить мультиметром ДО установки: у части KCD4 четвёртый контакт — это лампа "
     "подсветки, а не вторая группа. Ток полюса A до 1.83 А, полюса B ~0.2 А — "
     "16 А паспортных с огромным запасом."),
    ("Клеммы-мамы 6.3 мм под обжим, 22 AWG", "КУПИТЬ · 4 шт",
     "В макетку ножевой контакт не лезет в принципе, поэтому к выключателю идут четыре "
     "отрезка 22 AWG: на одном конце обжатая клемма-мама, на другом голый кончик "
     "под отверстие макетки."),
    ("Провод 22 AWG (жёсткий)", "есть · ~0.6 м",
     "Четыре линии к выключателю: A1 ≈ 12 см, A2 ≈ 12 см, B1 ≈ 14 см, B2 ≈ 14 см."),
    ("Перемычка для связки «+» кол.58", "есть",
     "Верх↔низ, правая половина. Ставится в просвет ~18 мм между корпусами Boost#2 и Boost#1, "
     "рядом со связкой «−», но не вплотную."),
    ("Плата ESP32 DevKitC 38-pin, модем, три буста, TP4056, C1…C5, D1/D2, F1",
     "есть · не тронуты",
     "Вся остальная схема унаследована от v8 без единого изменения."),
]

BUY_LATER = [
    ("P-канальный MOSFET (high-side ключ) + обвязка затвора", "перед мачтой",
     "Затвор ← GPIO33, вход — узел за полюсом A (51h). Пока плата в руках, вместо ключа "
     "стоит перемычка, и повисший модем перезагружается рукой. На мачте это единственный "
     "способ снять с модема питание: R104 держит PWRKEY на земле, выход из CMUX у A7670 "
     "сломан по прошивке модуля."),
]

BUY_GONE = [
    ("Миниатюрный тумблер SW1 (однополюсный)",
     "Заменён на KCD4. ⚠ Не выбрасывать: если у купленного KCD4 четвёртый контакт окажется "
     "лампой подсветки, старый тумблер остаётся на полюсе A, а KCD4 идёт на полюс B."),
    ("Связка «+» рельсов на кол.20",
     "Нижний «+» ЛЕВЫЙ в v9 не используется вовсе — перемычка снимается."),
    ("Длинный провод 39g → кол.16",
     "Самый длинный провод v8. Его работу делает полюс B, и оба конца новых проводов "
     "стоят прямо под своими колонками."),
]

# ═══════════════════════════════════════════════════ ПРОВЕРКА ПИТАНИЯ
CHAINS = [
    ("Откуда берётся 4.7 В на шине — до выключателя",
     "адаптер +5В → 37h → D1 (37→39) ──┐\n"
     "                                 ├──→ кол.39 «УЗЕЛ ШИНА»   (цепь P7)\n"
     "Boost#2 OUT+ 57h → D2 (41→39) ───┘",
     "Диодное ИЛИ: кормит тот источник, что выше по напряжению. У обоих диодов катод "
     "смотрит в колонку 39 — перевёрнутый даст либо ноль на шине, либо подпитку адаптера "
     "от батареи. На этом же узле висит C1 1000 мкФ (43e → 39f)."),
    ("Полюс B — то, чего в v8 не было вовсе",
     "кол.39 «ШИНА» → 39j → B1 ═╡ КЛАВИША ╞═ B2 → «+» НИЗ, кол.43     (P7 → P8)\n"
     "«+» низ кол.43 → связка кол.58 → «+» ВЕРХ правый",
     "Разрыв стоит ПОСЛЕ диодного ИЛИ, поэтому рвёт оба источника разом. Это и есть весь "
     "смысл v9: в v8 при воткнутом адаптере D1 кормил шину мимо выключателя."),
    ("Полюс A — там же, где стоял SW1 в v8",
     "TP4056 OUT+ (49j) → A1 ═╡ КЛАВИША ╞═ A2 → 51j ─┬─ 51i → Boost#2 IN+ (55c)\n"
     "                                               └─ 51h → ключ GPIO33 → Boost#3 → модем",
     "Ток до 1.83 А: модем 1.50 + станция 0.33. Оба потребителя обязаны сидеть ПОСЛЕ полюса — "
     "перенести только один значит оставить под питанием половину того, ради чего всё затевалось."),
    ("Потребители — всё после полюса B",
     "«+» верх ПРАВЫЙ → 61a → Boost#1 IN+ → 12 В → 63j → датчик            (P9)\n"
     "«+» верх ПРАВЫЙ → мост 31↔32 → «+» верх ЛЕВЫЙ → кол.3 → 1a «5V»      (P8)",
     "Ток идёт СПРАВА НАЛЕВО — в v8 было наоборот. Мост 31↔32 стал единственной точкой отказа "
     "питания платы: отойдёт он, и датчик на 12 В останется живым, а ESP32 умрёт."),
    ("Батарея и заряд — не тронуто",
     "«+» пакета    → 42j → F1 (PTC 3A) → 44j → TP4056 B+  (50j)           (P2)\n"
     "клемма холдера → отдельный провод → верх делителя 100k/100k          (P3)\n"
     "«−» пакета    → 46i →                     TP4056 B−  ← отдельная сеть, НЕ на рельс\n"
     "адаптер +5В   → 37f →                     TP4056 IN+ (50b)  ⚠ НЕ ПРИПАЯНО",
     "Отвод на делитель идёт отдельным проводом с клеммы холдера, а не от 42j: TP4056 без "
     "пакета держит B+ на 4.2–4.5 В и подделывает батарею. Последняя строка — известный долг."),
]

CHECKS = [
    ("1", "37h", "анод D1 — приходит ли адаптер вообще", "5.0 В",
     "провод от адаптера или сам адаптер"),
    ("2", "50b", "IN+ TP4056 — доходит ли адаптер до зарядного узла", "5.0 В",
     "<b>известный долг:</b> перемычка 37f→50b не припаяна. Ноль здесь при живом "
     "пункте 1 — заряда нет и не будет ни при каком положении клавиши"),
    ("3", "42j и 44j", "по обе стороны F1 (PTC)", "одинаковые",
     "PPTC сработал или оборван"),
    ("4", "49j", "OUT+ TP4056 — вход полюса A", "напряжение банки",
     "TP4056 или сама банка (высаженная в ноль читается как 3.2–3.3 В)"),
    ("5", "51j", "узел за полюсом A", "банка при ON, <b>0 при OFF</b>",
     "не ноль при OFF — полюс A не в том разрыве, станция будет разряжаться выключенной"),
    ("6", "39h", "узел ШИНА — итог диодного ИЛИ, вход полюса B", "~4.7 В <b>всегда</b>",
     "полярность D1/D2: у обоих катод в колонку 39. Здесь напряжение есть и при OFF — "
     "это нормально, разрыв стоит дальше"),
    ("7", "кол.43 «+» низ", "выход полюса B", "~4.7 В при ON, <b>0 при OFF</b>",
     "не ноль при OFF — либо полюс B не в том разрыве, либо длинный провод 39g→кол.16 "
     "из v8 не снят и продолжает кормить шину в обход клавиши"),
    ("8", "кол.58 «+» низ и верх", "связка правой половины", "одинаковые",
     "связка не поставлена или сидит неплотно — питание с полюса B до платы не дойдёт"),
    ("9", "кол.3 «+» верх", "то, что реально приходит на «5V» платы", "~4.7 В при ON",
     "мост 31↔32 или диагональная перемычка 1a → кол.3. Отличительный признак именно "
     "моста: на кол.61 при этом 4.7 В есть, и датчик на 12 В жив"),
]

chain_rows = "".join(
    '<div class="chain"><div class="chain-h">%s</div>'
    '<div class="chain-w">%s</div><div class="chain-n">%s</div></div>' % c
    for c in CHAINS)

chk_rows = "".join(
    '<tr><td class="n">%s</td><td class="c">%s</td><td>%s</td>'
    '<td class="exp">%s</td><td style="color:#4a453c">%s</td></tr>' % c
    for c in CHECKS)

buy_rows = "".join(
    '<tr><td><b>%s</b><br><span style="color:#6b6559">%s</span></td>'
    '<td class="q">%s</td></tr>' % (n, d, q)
    for n, q, d in HAVE)
buy_rows += "".join(
    '<tr><td><b>%s</b><br><span style="color:#6b6559">%s</span></td><td class="q">%s</td></tr>'
    % (n, d, q) for n, q, d in BUY_LATER)
buy_rows += "".join(
    '<tr><td><b class="gone">%s</b><br><span style="color:#6b6559">%s</span></td>'
    '<td class="q" style="color:#8a8375">выпало</td></tr>' % (n, d)
    for n, d in BUY_GONE)

html = """<!doctype html>
<html lang="ru">
<head>
<meta charset="utf-8">
<meta name="viewport" content="width=device-width, initial-scale=1">
<title>Схема v9 · KCD4 на два полюса: выключено значит выключено при любом источнике</title>
<style>%s%s</style>
</head>
<body>
<div class="wrap">
  <header>
    <div class="eyebrow">Метеостанция ветра · разводка v9 · задача 11</div>
    <h1>Выключатель на два полюса и десять плюсовых цепей</h1>
    <p class="lede">Вся схема здесь <b>ровно та же, что в v8</b>: плата 38-pin в колонках 1–19,
      модем штырями CN101 в ряду a, делители, конденсаторы, светодиоды и вся земля — без единого
      изменения. Меняется <b>один компонент</b>: однополюсный тумблер заменён на клавишный
      <b>KCD4</b> с четырьмя ножевыми контактами, то есть на <b>два независимых полюса,
      которые ходят от одной клавиши</b>. Полюс A остался ровно там, где стоял SW1
      (<b class="mono">49j → A1, A2 → 51j</b>), полюс B встал в разрыв самой шины после
      диодного ИЛИ (<b class="mono">39j → B1, B2 → «+» низ, кол.43</b>). Вместе с ним исчез
      самый длинный провод схемы и поменялось направление питания платы.</p>
    <div class="note warn" style="margin-top:14px"><i>&#9888;</i><span><b>Зачем второй полюс.</b>
      В шину питания входят <b>два</b> источника: адаптер через D1 и батарея через Boost#2 и D2.
      Один полюс в батарейной ветке рвёт только половину — при воткнутом адаптере D1 продолжает
      кормить плату мимо выключателя, и «выключено» означает «выключено наполовину». Второй
      полюс закрывает ровно это.</span></div>
    <div class="note ok" style="margin-top:10px"><i>&#10003;</i><span><b>Появилось состояние
      «OFF + адаптер воткнут».</b> Плата, бусты и модем обесточены полностью, а TP4056
      продолжает заряжать банку — и делает это <b>вчистую</b>, без параллельной нагрузки.
      Это единственный режим, в котором зарядный узел вообще способен увидеть порог окончания
      (~1/10 Iprog) и уйти в <b class="mono">STDBY</b>. Ради него всё и сделано.</span></div>
    <div class="note ok" style="margin-top:10px"><i>&#10003;</i><span><b>Длинного провода
      39g → кол.16 больше нет.</b> В v8 узел ШИНА уходил вниз, вправо почти до края макетки,
      потом через всю схему наверх в левую половину «+» — около 40 см провода поперёк чертежа
      и поперёк макетки. Его работу делает полюс B, и оба конца новых проводов стоят прямо
      под своими колонками.</span></div>
    <div class="note warn" style="margin-top:10px"><i>&#9888;</i><span><b>Питание платы пошло
      справа налево, и мост «+» 31↔32 стал единственной точкой отказа.</b> Цепь теперь такая:
      кол.43 низ → связка кол.58 → верхний «+» правый → 61a (Boost#1) и параллельно
      мост 31↔32 → верхний «+» левый → кол.3 → по диагонали в 1a. В v8 через мост шли 75 мА
      Boost#1 слева направо; теперь через него идёт весь ток ESP32 в обратную сторону.
      Отойдёт — <b>датчик на 12 В останется живым, а плата умрёт</b>.</span></div>
    <div class="note warn" style="margin-top:10px"><i>&#9888;</i><span><b>Земля не тронута
      ни в одной точке — это условие, а не пожелание.</b> Верхний «−» по-прежнему разрезан
      между кол.31 и 32 и <b>не смощён</b>; мост стоит только на нижнем «−»; низ делителя
      датчика уходит из <b class="col">35a</b> влево на кол.31. Перенос его на правую половину
      даёт 18–29 мВ падения на общем проводе, а это <b>0.15–0.25 м/с призрачного ветра</b>,
      который ничем себя не выдаёт.</span></div>
    <div class="note info" style="margin-top:10px"><i>&#9675;</i><span><b>Десять плюсов —
      десять цветов.</b> На плате с диодным ИЛИ, тремя бустами и двухполюсным выключателем
      «красный провод» перестаёт что-либо значить: их одиннадцать, и половина под разным
      напряжением. Каждая плюсовая цепь получила свой цвет и номер <b class="mono">P1…P10</b>;
      номера продублированы в списке соединений прямо на схеме. Таблица — ниже.</span></div>
  </header>

  <section>
    <div class="board">%s</div>
    <p class="hint">Точка = контакт в отверстии. Дуга-мостик = провод просто лежит поверх, без
      соединения. Тёмный прямоугольник = корпус модуля, серый пунктир с рваной кромкой =
      проекция платы модема. <b>Пунктир = ещё не куплено или не поставлено</b> (ключ питания,
      перемычка 37f→50b). Зелёная группа в таблице соединений — то, что добавляет v9,
      синяя — плата из v8, красные — наследство v6.
      На узком экране схему можно прокрутить вбок.</p>
  </section>

  <section>
    <h2>Только питание: шесть стадий переноса «+»</h2>
    <p class="sub">Та же схема, с которой снято всё, что не переносит плюс: ни земли,
      ни светодиодов, ни делителей, ни банок. Остаётся путь целиком — от розетки и от
      аккумулятора до пина <b class="mono">5V</b>, и оба разрыва клавиши на нём.</p>
    <div class="board">%s</div>
  </section>

  <section>
    <h2>Десять плюсовых цепей</h2>
    <p class="sub">Подсвечены две пары, которые важнее всех остальных:
      <b class="mono">P4/P5</b> — до и после полюса A, <b class="mono">P7/P8</b> — до и после
      полюса B. Именно они показывают, что выключатель реально рвёт; если их спутать,
      проверка вольтметром покажет «всё в порядке» там, где ничего не в порядке.
      <b class="mono">P8</b> оставлен каноническим красным <b class="mono">#d23b2e</b> —
      это «+» LOAD, тот самый цвет, которым во всех прошлых версиях рисовалась шина.</p>
    <div class="card"><table class="circ">
      <tr><th>№</th><th>Цепь</th><th>Напряжение</th><th>Цвет</th><th>Маршрут</th></tr>%s
    </table></div>
  </section>

  <section>
    <h2>Четыре состояния клавиши</h2>
    <p class="sub">Третье — новое, и ради него весь v9. Остальные три были и в v8, но одно
      из них означало не то, что написано на корпусе.</p>
    <div class="two">
      <div class="card new">
        <h3>ON · адаптер воткнут</h3>
        <p>Рабочий режим. Оба полюса замкнуты: станция и модем питаются от адаптера через D1,
          заряд идёт параллельно. Терминации заряда при этом не будет — ток модема течёт
          через тот же узел, см. «Цена №2» в v8.</p>
      </div>
      <div class="card new">
        <h3>ON · адаптера нет</h3>
        <p>Автономка. Ток идёт <b class="mono">OUT+ → полюс A → кол.51</b> → оба буста, дальше
          Boost#2 → D2 → шина → <b>полюс B</b> → плата. Через полюс A проходит <b>весь</b> ток:
          пик ~1.83 А на разряженной банке против 16 А паспортных.</p>
      </div>
      <div class="card hot">
        <h3>OFF · адаптер воткнут <span class="tag v9">ради этого</span></h3>
        <p><b>Всё обесточено.</b> Полюс A снимает оба буста с <b class="mono">OUT+</b>,
          полюс B рвёт шину сразу за диодным ИЛИ — и D1 больше никуда не кормит.
          TP4056 видит <b>чистую банку</b>, ток спадает, зарядный узел доходит до
          <b class="mono">STDBY</b> и загорается зелёный. В v8 этого состояния не существовало:
          там при воткнутом адаптере станция продолжала работать.</p>
      </div>
      <div class="card new">
        <h3>OFF · адаптера нет</h3>
        <p>Мертво всё. Холостой ход трёх MT3608 и 20–30 мА покоя модема больше не капают
          из банки — это то, из-за чего 16.08 пакет высадили в ноль.</p>
      </div>
    </div>
  </section>

  <section>
    <h2>Проверить выключатель ДО установки: DPST или SPST с лампой</h2>
    <p class="sub">«Четыре контакта» ещё не значит «два полюса». У части KCD4 четвёртый контакт —
      это вывод лампы подсветки, и такой выключатель полюсом B работать не будет.
      Проверяется за четыре шага мультиметром UT33A+ в режиме прозвонки.</p>
    <div class="two">
      <div class="card">
        <h3>1 · Найти пару полюса A</h3>
        <p>Прозвонка, щупы на любые два контакта, клавишу щёлкать. Пара, которая
          <b>замыкается в ON и размыкается в OFF</b>, — это полюс. Запомнить её физическое
          расположение (обычно два контакта на одной стороне корпуса).</p>
      </div>
      <div class="card">
        <h3>2 · Найти вторую такую же пару</h3>
        <p>Оставшиеся два контакта должны вести себя <b>точно так же и одновременно</b>:
          замыкаться в ON, размыкаться в OFF. Если вторая пара звонится <b>всегда</b> или
          <b>никогда</b> — это не полюс.</p>
      </div>
      <div class="card">
        <h3>3 · Проверить изоляцию между парами</h3>
        <p>Измерить сопротивление между парами во <b>всех четырёх сочетаниях</b>
          (A1–B1, A1–B2, A2–B1, A2–B2) и в <b>обоих положениях клавиши</b>. Везде должен быть
          обрыв. Восемь измерений, и ни одно нельзя пропустить.</p>
      </div>
      <div class="card cost">
        <h3>4 · Конечное сопротивление = подсветка</h3>
        <p>Если между парами звонится конечное сопротивление (десятки Ω…единицы кΩ) —
          это лампа, а не второй полюс, и полюса B у такого выключателя нет.
          <b>Запасной ход:</b> поставить KCD4 на <b>полюс B</b> (там ток всего ~0.2 А),
          а полюс A оставить на старом однополюсном SW1. Схема при этом не меняется
          ни в одной точке — просто клавиш становится две.</p>
      </div>
    </div>
    <div class="note warn" style="margin-top:12px"><i>&#9888;</i><span><b>Контакты KCD4 —
      плоские ножевые 6.3 мм</b>, в макетку они не лезут в принципе. К выключателю идут четыре
      отрезка <b>22 AWG</b>: на одном конце обжатая клемма-мама 6.3 мм, на другом голый
      залужённый кончик под отверстие макетки. Длины: A1 ≈ 12 см
      (<b class="col">49j</b>), A2 ≈ 12 см (<b class="col">51j</b>), B1 ≈ 14 см
      (<b class="col">39j</b>), B2 ≈ 14 см (<b class="col">«+» низ, кол.43</b>).
      Каждую клемму после обжима дёрнуть за провод.</span></div>
  </section>

  <section>
    <h2>Куда какая площадка садится</h2>
    <p class="sub">Зелёные группы сверху — то, что добавляет v9: четыре контакта выключателя,
      связка «+» на кол.58 и мост 31↔32, сменивший смысл. Синие — плата 38-pin, светодиоды
      и земля из v8. Оранжевые — модем из v6. Белые не тронуты.</p>
    <div class="card"><table class="pads">
      <tr><th>Деталь / площадка</th><th>Отверстие</th><th>Что на ней</th></tr>%s
    </table></div>
  </section>

  <section>
    <h2>Проверка питания: пять цепочек и девять точек</h2>
    <p class="sub">Плюсовых цепей стало десять, и разрывов на них теперь два. Ниже они свёрнуты
      в пять цепочек: если держать в голове их, а не полсотни отдельных проводов, искать
      неисправность становится нечего.</p>
    %s
    <p class="sub" style="margin-top:18px">Мерить вольтметром между точкой и <b>«−» низ</b>,
      <b>строго по порядку и строго по одной точке за раз</b>. Правило «обходить по одному
      элементу» здесь не формальность: в июле перемычки накидали пачкой, и виноватый PPTC
      нашёлся только когда их сняли и стали ставить обратно поштучно.</p>
    <div class="card"><table class="chk">
      <tr><th></th><th>Точка</th><th>Что мерим</th><th>Ожидание</th><th>Если не так</th></tr>%s
    </table></div>
    <div class="notes" style="margin-top:14px">
      <div class="note warn"><i>&#9888;</i><span><b>Пункты 6 и 7 — те, ради которых сделан v9.</b>
        На узле ШИНА (п.6) напряжение есть <b>всегда</b>, в том числе при OFF: разрыв стоит
        дальше. А вот на кол.43 (п.7) при OFF обязан быть <b>ноль</b>. Если там что-то есть —
        либо полюс B не в том разрыве, либо из v8 не снят длинный провод 39g → кол.16,
        который продолжает кормить шину в обход клавиши.</span></div>
      <div class="note warn"><i>&#9888;</i><span><b>Три причины, по которым станция может
        молчать, и ни одна из них не в схеме.</b> Первая — <b>перемычка
        <b class="col">37f &#8594; 50b</b> не припаяна</b>: адаптер есть, до TP4056 не доходит,
        станция вечно «от батареи». Вторая — <b>провод 33b стоит в кол.14 вместо кол.15</b>:
        вход скорости висит в воздухе, <b class="mono">speedMv</b> намертво 142.0. Третья —
        <b>банка высажена в ноль</b>: при 3.2–3.3 В Boost#2 ещё работает, но ESP32 ловит
        brownout на передаче. Причину последнего перезапуска видно без разборки — поле
        <b class="mono">resetReason</b> в <b class="mono">/api/data</b>.</span></div>
    </div>
  </section>

  <section>
    <h2>Порядок работ</h2>
    <p class="sub">Жёстко по порядку: проверка выключателя — до установки; снятие длинного
      провода — до нового выключателя; связка кол.58 — до приёмки; земля — не трогать вовсе.</p>
    <ol class="steps">%s</ol>
  </section>

  <section>
    <h2>Что не перепутать</h2>
    <div class="notes">%s</div>
  </section>

  <section>
    <h2>Что нужно — и чего не нужно</h2>
    <p class="sub">Покупок две, и обе копеечные: сам KCD4 и четыре клеммы-мамы 6.3 мм под обжим.
      Всё остальное уже в хозяйстве. Зачёркнутые строки — то, что v9 из схемы убирает.</p>
    <div class="card"><table class="buy"><tr><th>Позиция</th><th>Кол-во</th></tr>%s</table></div>
  </section>
</div>
</body>
</html>
""" % (CSS, EXTRA_CSS, svg, svg_power, circ_rows, pads_rows, chain_rows, chk_rows,
       STEPS, NOTES, buy_rows)

out = os.path.join(ROOT, "wiring-v9.html")
with open(out, "w", encoding="utf-8") as f:
    f.write(html)
print("wrote", out, "%.1f KB" % (len(html.encode("utf-8")) / 1024))
