temafey/ArduinoWindStation/images/gen_next_v8_svg.py

# -*- coding: utf-8 -*-
"""ЧТО ДЕЛАТЬ ДАЛЬШЕ · после того как ESP32 вынули из макетки (2026-09-10).

Не схема сборки и не карта замеров, а одна страница на один вопрос: плата сейчас лежит
рядом с макеткой, воткнута в USB-C и прекрасно работает — что сделать, чтобы она так же
работала СТОЯ В МАКЕТКЕ.

Откуда взялась картинка. Поиск неисправности кончился доказательством: с платой,
вынутой из макетки, ноль паник и растущий аптайм; в макетке — загрузка с мусором,
паники в несвязанных подсистемах и «Failed to set QIE bit». Значит грузили не код,
а медь: что-то на макетке висело на линиях SPI-флеша, а они у 38-pin платы выведены
наружу — шесть контактов в первых четырёх колонках.

Три вещи, ради которых страница вообще нарисована:

  1. «Держать колонки 1–4 пустыми» — формулировка, которой нельзя пользоваться буквально:
     в 1a стоит «5V» самой платы. Запрещены РАЗНЫЕ колонки в разных банках: сверху 2·3·4,
     снизу 1·2·3. Отсюда крупный вид первых шести колонок (bb.flash_zoom).
  2. Флеш держим на 40 МГц — это осознанный запас, а не откат: повод оказался ложным
     (виноват был бракованный модуль), но у "40 мало" симптомов не бывает вовсе, а у
     "80 мало" они выглядят как partition invalid magic и паники в случайных местах.
     Частота лежит в заголовке загрузчика (0x1000) и переживает любую OTA, поэтому
     ЛЮБАЯ заливка по USB обязана нести --flash-freq 40m, иначе молча вернёт 80.
  3. Модем стал внешним модулем со своим питанием. У него теперь две ловушки, которых
     не было, пока он сидел в макетке: его «плюс» нельзя брать с пина «5V» платы,
     а общий провод земли стал обязательной деталью — без него UART молчит при
     совершенно живом модеме (проверено: total=0 на любой паре пинов).

Вход:  bb_lib.esp32_38 / flash_warn / flash_zoom / mod_a7670 / legend
Выход: images/next_v8.svg
"""
import os, sys
sys.path.insert(0, os.path.dirname(__file__))
import bb_lib as bb

NCOLS = 63
RAIL_INSET = 2
RAIL_L = 1 + RAIL_INSET
RAIL_TP, RAIL_TM = 250, 262
PLUS, GND, SIG = bb.PLUS, bb.GNDc, bb.SIG
TX_C = "#e0218a"          # GPIO27 -> RXD модема
RX_C = "#3949ab"          # GPIO25 <- TXD модема
OK_C = "#2e7d4f"
NO_C = bb.PAD_FLASH
W = 1900
H = 1150


def X(c):
    return bb.colx(c)


def Y(r):
    return bb.ROWY[r]


board, r3c, r4c = bb.breadboard(bottom="+-", ncols=NCOLS, rail_inset=RAIL_INSET)

esp = bb.esp32_38(subtitle="сейчас ВНЕ макетки, на USB-C — и работает",
                  highlight=["5V", "GND", "27", "25"], usb_label="USB-C")
flash = bb.flash_warn((2, 4), (1, 3))

# ── два провода, которые в запретной зоне СТОЯТЬ ДОЛЖНЫ ────────────────────────
# «5V» платы (кол.1) уходит на «+» рельс по диагонали: рельс начинается только над кол.3.
legit = (
    '<path d="M%d %d L%d 286 L%d %d" fill="none" stroke="%s" stroke-width="3" '
    'stroke-linecap="round"/>' % (X(1), Y("a"), X(1), X(RAIL_L), RAIL_TP, PLUS)
    + '<circle cx="%d" cy="%d" r="3.4" fill="%s"/>' % (X(1), Y("a"), PLUS)
    + '<circle cx="%d" cy="%d" r="3.4" fill="%s"/>' % (X(RAIL_L), RAIL_TP, PLUS)
    + '<path d="M%d %d L%d %d" fill="none" stroke="%s" stroke-width="3" '
      'stroke-linecap="round"/>' % (X(6), Y("a"), X(6), RAIL_TM, GND)
    + '<circle cx="%d" cy="%d" r="3.4" fill="%s"/>' % (X(6), Y("a"), GND)
    + '<circle cx="%d" cy="%d" r="3.4" fill="%s"/>' % (X(6), RAIL_TM, GND))

# ── выноска над запретной зоной ────────────────────────────────────────────────
CX, CY, CW, CH = 78, 112, 486, 86
callout = (
    '<rect x="%d" y="%d" width="%d" height="%d" rx="10" fill="#fdeeec" stroke="%s" '
    'stroke-width="2"/>' % (CX, CY, CW, CH, NO_C)
    + '<text x="%d" y="%d" font-size="15" font-weight="700" fill="%s">'
      '⛔ Запретная зона — из-за неё плата и не грузилась</text>' % (CX + 16, CY + 26, NO_C)
    + '<text x="%d" y="%d" font-size="12" fill="#7a2a22">'
      'СВЕРХУ пусто в кол. 2 · 3 · 4 &#8212; это CMD · D3 · D2</text>' % (CX + 16, CY + 47)
    + '<text x="%d" y="%d" font-size="12" fill="#7a2a22">'
      'СНИЗУ пусто в кол. 1 · 2 · 3 &#8212; это CLK · D0 · D1</text>' % (CX + 16, CY + 64)
    + '<text x="%d" y="%d" font-size="10.5" fill="#8a6a20">'
      'а 1a («5V») и 6a («GND») занимать НАДО: это питание самой платы</text>'
      % (CX + 16, CY + 78)
    + '<path d="M%d %d L%d 276 L%d 276 L%d 292" fill="none" stroke="%s" stroke-width="2" '
      'stroke-dasharray="5 4"/>' % (CX + 60, CY + CH, CX + 60, X(3), X(3), NO_C)
    + '<path d="M%d 286 L%d 294 L%d 286 Z" fill="%s"/>' % (X(3) - 5, X(3), X(3) + 5, NO_C))

# ── три провода к модему: уходят с макетки вправо по канавке ───────────────────
EXIT_X = X(NCOLS) + 22
MOD_LANES = {"tx": 192, "rx": 208, "gnd": 224}
# Земля модема берётся с ПРАВОЙ половины верхнего «−» рельса — там же, где её
# берёт gnd_bond в схеме v8. Левая половина (до разреза 31↔32) — опора АЦП,
# и токи модема через неё гнать нельзя: весь смысл разреза в этом.
GND_COL = 44


def lead(pin, y_lane, color):
    """Провод УХОДИТ С МАКЕТКИ: начинается на самом паде платы (y=311, как в схеме v8),
    поднимается над платой и идёт вправо, за правый край. Дырку банка он не занимает —
    модем внешний, и втыкать этот конец больше некуда."""
    x0 = bb.PIN_TOP38[pin]
    return ('<path d="M%d 311 L%d %d L%d %d" fill="none" stroke="%s" stroke-width="3" '
            'stroke-linecap="round" stroke-linejoin="round"/>'
            % (x0, x0, y_lane, EXIT_X, y_lane, color)
            + '<circle cx="%d" cy="311" r="3.4" fill="%s"/>' % (x0, color)
            + '<text x="%d" y="%d" font-size="10.5" font-weight="700" fill="%s" '
              'text-anchor="end">GPIO%s →</text>' % (EXIT_X - 8, y_lane - 5, color, pin))
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
