temafey/ArduinoWindStation/(commit log)

2026-08-15 Первый коммит: прошивка, дашборд и документация метеостанции
    Содержимое проекта на 2026-08-15: прошивка ESP32 (esp32_wind_station/),
    дашборд (wind-dashboard.jsx + wind-ui/), руководства по сборке и заливке,
    KiCad-проект, генераторы схем макетки (images/), задачи и архив прошлых версий.
    .gitignore исключает пересобираемое и локальное: build-каталоги, node_modules,
    dist, снапшоты-архивы (*.zip кроме WindStation-kit.zip), файлы *.bak-*,
    temp/ и tmp/, логи, слу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
    [01_power.kicad_sch, 02_sensor.kicad_sch, 03_battery_monitor.kicad_sch, 04_leds.kicad_sch, WindStation.dsn, WindStation.kicad_pcb, WindStation.kicad_sch, freerouting.dsn]
2026-08-15 CLAUDE.md: git больше не «не установлен»
    С 2026-08-15 репозиторий существует — убрал запрет предлагать коммиты, описал
    что игнорируется и почему web_content.h и WindStation-kit.zip всё же в истории.
    Откат прошивок из archive/ по-прежнему копированием: тот каталог старше первого коммита.
    .gitignore: добавил корневой /build/ — arduino-cli из CLAUDE.md пишет туда,
    а не в каталог скетча.
2026-08-15 Документация: сборка и заливка переведены на AP-режим
    wind-station-assembly.md: этап первой прошивки больше не требует вписывать SSID
    домашней сети — плата поднимает свою (`WindStation` / `5V_Sensor`, дашборд на
    http://MyWindProbeBETA.org и 192.168.4.1). Обновлены киоск на Android TV (там лучше
    голый IP), финальный чек-лист и таблица неполадок: вместо «WiFi не подключается»
    и mDNS теперь разбор случаев, которые реально бывают у точки до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
2026-08-15 Домашняя сеть вернулась как AP+STA, а не вместо точки доступа
    Станция снова входит в домашнюю сеть (temafey-glint2, только 2.4 ГГц —
    у ESP32 нет радио на 5 ГГц). Это не возврат станционного режима, снятого
    2026-08-07: тот вызывал softAPdisconnect() при подключении и гасил точку
    через ~15 с после старта. Здесь точка доступа безусловна, её не трогает
    ни одна строка, а домашняя сеть добавляется к ней. Провал подключе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
2026-08-15 Аплинк стал списком сетей, а не одной
    homeNetworks[] — массив {ssid, password}, порядок = приоритет. serviceUplink()
    обходит его по одному кандидату за попытку (STA_ASSOC_MS = 12 с), без скана:
    скан стоил бы точке доступа замирания ещё до первой ассоциации, а список короткий.
    Пауза с удвоением 30 с → 10 мин теперь считается между полными проходами списка,
    а не между кандидатами — иначе пять сетей растянули бы первы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
2026-08-15 Четыре сети в списке и максимум мощности передатчика
    homeNetworks[]: temafey-glint2, temafey, ASUS-AIST, AndroidAP — пароли взяты
    из сохранённых профилей Windows. У temafey пароль в нижнем регистре, у glint2
    в верхнем; это не опечатка. Yahta по просьбе не добавлена, 5-гигагерцовые
    профили не годятся физически.
    setTxPower просит WIFI_POWER_21dBm вместо 19_5dBm: драйвер обрежет до того,
    что реально позволяет PHY, так что запрос потолка даёт п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
2026-08-15 Потолок мощности этого чипа — 18 дБм, а не 21
    Замер на железе после заливки: setTxPower(WIFI_POWER_21dBm) даёт 18.0 дБм.
    Драйвер режет по калибровке из eFuse, значит и прежние 19.5 давали те же 18 —
    запрос был выше потолка и раньше. Выигрыш от смены константы нулевой.
    Ценность правки оказалась не в мощности, а в чтении значения обратно: до неё
    цифра в исходнике не имела отношения к тому, что излучает плата.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
2026-08-15 WiFi-светодиод больше не мигает, когда всё работает
    Горел ровно только при клиенте на точке доступа, поэтому плата, спокойно
    сидящая в домашней сети, мигала бесконечно — и глаз научился не смотреть
    на единственную лампу, которая должна значить «подойди сюда».
    Теперь ровный свет = станция кому-то доступна: либо клиент на AP, либо живой
    аплинк. Мигание стало исключением, а не фоном.
    Про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
2026-08-15 Описание WiFi-светодиода приведено к новой логике
    CLAUDE.md, FIRMWARE.md и документ сборки говорили «мигает пока подключается».
    Теперь: горит, когда станция кому-то доступна (клиент на точке ИЛИ аплинк),
    мигает — когда ни того ни другого. Добавлено предупреждение, что зелёных
    ламп две и их путают.
2026-08-15 Комментарий у PIN_LED_WIFI отстал от логики
    Хвост от 0b98948: в #define всё ещё было «blink when idle».
2026-08-15 Задача про 4G/GPS переписана после ресерча
    Разбор A7670E + ESP32 по даташитам и практике: питание пересчитано
    арифметикой, стек взят из ядра (PPP вместо TinyGSM), добавлены разделы
    про безопасный удалённый доступ, дашборд и заливку.
2026-08-15 Цифра занятого флеша отстала от реальности
    Со времён выброшенного станционного режима прошивка занимает не 92%,
    а 85% (1127031 из 1310720). Сверено живой сборкой.
2026-08-15 На фотографиях платы виден линейный стабилизатор
    U2 оказался LDO семейства 1084, а не понижающим преобразователем:
    дросселя на плате нет вовсе. Значит ток модуля приходит на VCC без
    деления, разница напряжений уходит в тепло, а окно питания зажато
    падением снизу и нагревом сверху. Питание и энергобюджет пересчитаны.
2026-08-15 Свои снимки платы подтверждают линейный U2
    Четыре фотографии нашего экземпляра BK-A7670 с наклейкой, читаемой
    целиком. Та же маркировка 1084 и то же отсутствие дросселя, что и на
    вендорских снимках, — вывод про линейный стабилизатор теперь на своём
    железе. Заодно: гребёнка CN101 распаяна, антенны воткнуты, а J3 голый
    вопреки прежней записи.
2026-08-15 На плате написано BK-7670, в мануале BK-A7670
    Сверка наклейки со снимками сошлась по всем полям. Единственное
    расхождение — шелкография без буквы A, из-за неё поиск документации
    по надписи на плате уводит в пустоту.
2026-08-15 Ревизия после внешнего разбора: питание и PPP
    PPP.begin() регистрации не ждёт — шестидесятисекундный цикл был в
    скетче примера, а не в библиотеке; вместо одной попытки в setup()
    нужна ретрай-машина в loop().
    Питание пересчитано с реальным падением на Шоттки: 1N5819 не тянет
    полтора ампера, PPTC нужен на 3 А, а двухамперный адаптер не держит
    случай «модем передаёт при заряде». D4 садится на OUT+ TP4056, инач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
2026-08-15 Правки ревизии доведены до всех трёх пластов
    Внутри задачи снято противоречие, которое я же и внёс: «модем
    последним делом в setup()» против ретрай-машины в loop(). Заодно
    сквозная нумерация шагов и связка sessionId между кадром, подписью
    и чек-листом.
    BOM пополнен блоком «Планируется для задачи 10» — с 3-амперными
    Шоттки вместо 1N5819 и вопросом адаптера, чтобы не купить не то.
    Крышка корпуса: bom-ph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
2026-08-15 Документ сборки всё ещё описывал старый датчик с направлением
    Датчик давно другой: 0-30 м/с, один аналоговый выход. В прошивке это
    SPEED_MAX = 30.0 и HAS_DIRECTION 0, а руководство продолжало требовать
    два делителя, провод на GPIO35 и обещало «реальные значения скорости
    и направления» на дашборде.
    Заодно два места, которые врали про диагностику: LED ОШИБКА при
    отсутствии датчика не загорается (детекто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
2026-08-15 Схема v5: 4G-модуль на своём питании, плата v4 не тронута
    Разводка под шаги 1-2 задачи 10. Блок модема висит справа от макетки:
    своё диодное ИЛИ на двух Шоттки 3 А, третий буст 5.2 В, электролит
    1000 мкФ у самой платы модуля, UART на GPIO27/26. Макетка отдаёт блоку
    три точки — 37j (+5 В адаптера), 49j (OUT+ TP4056, не банка) и 45i (земля).
    В bb_lib добавлены mod_a7670 и mod_pmos_switch, а diode_schottky
    и cap_electrolytic разделены на версии по коло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
2026-08-15 Очередь задач приведена к факту: 01-07 собраны, 08 уехала в конец
    Статусы 01-07 стояли «готово к выполнению», хотя станция давно работает
    и отвечает на /api/data. Корпус (08) переставлен после 4G: закрывать его
    до интеграции модема — значит вскрывать обратно, и PPTC там нужен на 3 А.
2026-08-16 Схема v6 «Компакт-1»: модем садится прямо на макетку
    4G-модуль больше не висит на проводах. Гнездовая планка PLS-7 в ряду a,
    колонки 36-42, свес платы 37x37 уходит вверх за верхние рельсы и за край
    макетки — ряды b-e под ним остаются рабочими. Левее планку не сдвинуть:
    35a это низ делителя датчика, RXD сел бы прямо на землю.
    Диодное ИЛИ модема снято, буст №3 кормится только с OUT+ TP4056. Из BOM
    выпали два Шо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
2026-08-16 Компакт-1 переписал закупку: два Шоттки и адаптер 3 А больше не нужны
    Задача 10 и BOM догнали схему v6. Модем питается только с OUT+ TP4056 —
    диодного ИЛИ у него нет, средний ток 65 мА против зарядного 1 А, сеанс
    на 10 с стоит 0.07 % ёмкости банки. Взамен в списке появились планка
    PLS-7 и стойка M2, а цена честно записана: без установленной банки
    модем не заводится, и нагрузка сидит на узле, по которому TP405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
2026-08-16 Шаг 0 закрыт целиком: GNSS есть, фикс получен с улицы
    50.5102081 N, 30.5000820 E, высота 226.2 м — 3D fix за ~15 с,
    10 GPS + 7 BeiDou, HDOP 6.01. Сошлось с AT+CGPSINFO.
    Решило только вынесение антенны наружу: в помещении 5 спутников
    SNR 9-30, на подоконнике SNR 14-36, на улице 8 спутников SNR 33-46.
    Разница +10..25 дБ — значит патч обязан быть снаружи корпуса,
    за стеклом и в глухом IP65 фикса не будет.
    Модуль дважды перезагрузился сам на USB-пита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
2026-08-16 Гайд по драйверам платы 4G/GPS + пометки шага 0 как пройденного
    A7670E-DRIVERS.md: как поднять BK-A7670 на Windows с нуля — вендорский
    пакет, pnputil, карта интерфейсов MI_xx, первый AT-сеанс, разбор ошибок.
    Всё проверено на железе 2026-08-16, а не переписано из мануала.
    Архив драйверов закоммичен намеренно: живой источник один (GitHub
    стороннего человека), Waveshare отдаёт 403 автозагрузчикам. Искать
    его второй раз незаче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
2026-08-16 Пароли вынесены в secrets.h — файл вне git
    Все шесть паролей (WPA2 точки, OTA, четыре домашние сети) переехали
    в esp32_wind_station/secrets.h. Файл в .gitignore, в репозитории
    остался только шаблон secrets.example.h.
    Без secrets.h скетч НЕ собирается: #error под __has_include. Фолбэк
    на константу был бы хуже — он поднял бы ОТКРЫТУЮ точку доступа,
    а такую ошибку замечают последней. Обе ветки проверены сборкой,
    размер прошивки не изме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
    [esp32_wind_station.ino, secrets.example.h]
2026-08-16 Штыри CN101 торчат со стороны наклейки — модуль ложится вверх ногами
    На фото платы видно: гребёнка CN101 распаяна штырями в сторону наклейки
    A7670E, а со стороны SIM/USB спилена заподлицо. Значит в макетку модуль
    входит наклейкой вниз, и порядок контактов вдоль колонок зеркалится
    относительно мануала: 36 = 1 SLEEP, 37 = 2 GND, 38 = 3 VCC, 39 = 4 PWRKEY,
    40 = 5 TXD, 41 = 6 RXD, 42 = 7 GND. Собранный «как в мануале» узел подал бы
    5.2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
2026-08-16 Появился origin — CLAUDE.md больше не может говорить «удалённого нет»
    Ремоут git@github.com:temafey/ArduinoWindStation.git добавлен, но ничего
    не отправлено и upstream не задан. SSH-ключа для GitHub на машине нет.
    В §Git добавлен список того, что уедет наружу при первом push: координата
    дома (7 мест в задаче 10), пароли самого устройства (13 файлов + история,
    вычистить нельзя — они внутри gzip и внутри kit-архива), IMEI/SN модема,
    имен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
2026-08-16 Контакты CN101 считаем по буквам: «G» у micro-USB — это колонка 36
    Владелец поправил по железу: цифр у пятаков на плате нет вовсе, есть буквы
    S·G·V·K·T·R·G, и вторая «G» стоит вплотную к micro-USB. Прошлый коммит
    7631aef развернул привязку задом наперёд — здесь она возвращается к верной.
    Геометрия выводится однозначно. Модуль лежит наклейкой вниз, сверху видна
    сторона с SIM и micro-USB, ребро с гребёнкой ухо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
2026-08-16 Репозиторий будет публичным — из него убрано всё, что нельзя публиковать
    Три правки, о которых договорились, плюс то, что всплыло при проверке.
    1. Координаты округлены до трёх знаков (~100 м) — полная точность это
    домашний адрес. Настоящие уехали в secrets.h: SECRET_STATION_LAT/LON/ALT_M.
    2. Пароли точки и OTA сменены. Вычистить старые из истории было нельзя —
    они лежат внутри gzip в web_content.h и внутри WindStat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
2026-08-16 Третий проход filter-repo: плейнтекста старых паролей в истории тоже нет
    Push ещё не делался, так что проход стоил ноль. Гzip внутри web_content.h
    и WindStation-kit.zip подстановкой по-прежнему не берутся, но это уже
    не важно: пароли сменены, старые не подходят ни к чему.
2026-08-16 Ветка теперь main — под именем, которое GitHub уже объявил дефолтным
    Заодно записано, каким ключом ходим на origin: отдельный
    ~/.ssh/id_ed25519_github, запись Host github.com в ~/.ssh/config.
2026-08-16 Репозиторий опубликован — правило про историю поменялось
    До первого push переписать историю стоило ноль. Теперь это force-push,
    сломанные клоны и всё равно не отменяет того, что уже прочитали:
    секрет в публичном коммите считаем сгоревшим и меняем.
2026-08-16 AT-консоль модема по воздуху: /api/at, флаг HAS_MODEM
    Модуль A7670E сидит на макетке наклейкой вниз, его micro-USB смотрит
    в стол — воткнуться некуда, а два провода UART уже есть. Временный
    скетч-мост USB↔UART2 отпадал: без WiFi он уносит дашборд, телеметрию
    и саму возможность заливать по воздуху, а возврат — только по USB
    с кнопками.
    Что стоит знать про эндпоинт:
    - `+` в ?cmd= обязан быть %2B, иначе WebServer сделает из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
2026-08-16 Земля модема — перемычкой по макетке, а не четвёртым проводом
    Возражение «через рельс пойдёт помеха в АЦП» снимается геометрией
    самой платы: верхний «−» рельс разрезан между колонками 31 и 32,
    мостом закрыт только нижний, поэтому кусок 32…41 — тупик, а низ
    делителя датчика на 35a стоит ЛЕВЕЕ точки втекания. Реальный путь
    возврата — три колонки вправо: 41 → 44 → рельс → 45a → медь TP4056.
    Общ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
2026-08-16 UART модема — 26/25 по факту сборки; схема пошла за медью, не наоборот
    Косичка при сборке села на один пин мимо нарисованного, и переставить
    её нельзя, не разбирая узел. Дешевле оказалось признать медь: прошивка
    уже стояла на RX25/TX26, теперь под неё перерисованы схема, таблица
    распиновки, BOM и задача 10.
    Подтверждено на железе: AT → OK за 9 мс, uart=RX25/TX26@115200.
    Петля TX-на-RX не понадобилась — линия ож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
2026-08-16 Данные по 4G пошли; ресет модуля оказался редким, а не системным
    AT+NETOPEN поднимает контекст, AT+IPADDR отдаёт CGNAT-адрес, пинг 8.8.8.8
    проходит 4/4 с RTT 35-55 мс — канал рабочий, а не «модуль отвечает на AT».
    Band в этот раз EUTRAN-BAND3, то есть список плавающих диапазонов расширился
    до B1/B3/B7.
    Запись «ресет воспроизводится 2/2» была преждевременной: пять прогонов подряд,
    включая точный повтор рецепта и совмещ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
2026-08-17 Тумблер стоит после обоих бустов — потому «выключено» и разряжается
    Замечено на железе: при выключенном SW1 питание всё равно идёт на A7670E,
    и оба MT3608 продолжают тянуть из банки. Причина не в монтаже, а в топологии
    — по блок-схеме SW1 стоит на шине, то есть ниже по течению, чем бусты №2 и №3,
    которые висят прямо на OUT+ TP4056. Выключить их тумблером физически нельзя,
    отсюда 20-30 мА покоя модема п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
2026-08-19 Дашборд разъехался по модулям — один файл перестал держать нагрузку
    Панель выросла из одного .jsx в одиннадцать. Разделение не косметическое:
    карта, справочник и сцена с торнадо тянут собственные данные и живут по
    своим правилам, а держать их в общем файле означало перечитывать три
    тысячи строк ради правки одной подписи.
    Что появилось:
    - «Метеорология» — приборы к покупке, полевые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
2026-08-19 Клин и конус — разные вещи; в карточках теперь по 3-4 снимка
    Под «клиновидным» стоял кадр из Эли 2007, а это конус: высота там втрое
    больше ширины, тогда как клин по определению шире, чем выше. Снимок никуда
    не делся — он переехал в новый тип «Конусовидный», которого в справочнике
    не хватало, и заодно объясняет, почему эти два облика так часто путают.
    Клин теперь показывает Эль-Рино 2013 —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
2026-08-19 Архив для хостинга — сборочный артефакт, в git ему не место
2026-08-19 Третий источник данных — район; оформление стало настраиваемым
    Станция меряет одну точку одним датчиком. Она не знает ни давления, ни
    осадков, ни качества воздуха, а на разряженном аккумуляторе не знает
    ничего. Отсюда режим «район» рядом со станцией и демо.
    Государственную станцию подключить не вышло, и это не недоработка.
    Классический путь — METAR с ближайшего аэродрома, их выпуск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
2026-08-20 Дашборд грузится частями: первый экран стал вдвое легче
    Сайт открывался минутами. Замер показал, чем это вызвано: канал до платы
    отдавал 667 байт в секунду, и соединение обрывалось раньше, чем бандл
    доходил целиком — за 77 секунд приезжало 51 КБ из 170, после чего браузер
    начинал всё заново.
    Тяжёлые вкладки вынесены в отдельные части и грузятся по требованию:
    карта мира, метеорология с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
2026-08-20 Страховка от ошибок: падение больше не оставляет чёрный экран
    Чёрный экран при переключении вкладки — регрессия от разделения бандла.
    Если часть не догружалась, lazy бросал исключение, а границы ошибок в
    приложении не было вовсе, и React снимал с экрана всё дерево целиком.
    Появился wind-guard.jsx с двумя рубежами. Вокруг всего приложения —
    последний, чтобы вместо пустоты остался понятный т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
2026-08-20 Устаревший кэш больше не даёт пустой экран без объяснений
    «Просто фон и ничего» объяснилось так: имена файлов дашборда содержат хэш
    и после каждой прошивки новые, а браузер держал в кэше прежнюю index.html
    и просил файл по старому имени. Такой запрос попадал в перехват портала и
    получал 302 на главную, то есть HTML вместо JavaScript. Браузер давился
    им и не рисовал ничего — оставался один фон, б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
2026-08-20 Чёрный экран: строка гарнитуры раскрывалась в объект стиля
    Настоящая причина, найденная рендером в Chrome:
    Uncaught TypeError: Failed to set an indexed property [0]
    on 'CSSStyleDeclaration'
    В wind-guard.jsx я написал {...MONO}, а MONO — это строка с именем
    гарнитуры, а не объект стиля. Раскрытие рассыпало её на ключи 0,1,2…,
    и React падал на первом же из них. Падало в заглушке «загрузка раздела»,
    поэтому симптом менялся: сначала гасло пр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
2026-08-20 Раскладка «Основного» стала настройкой, а не разметкой
    В кастомизации появилась кнопка «Кастомизировать раскладку». Она уводит на
    «Основное» и включает режим правки: любой блок можно тащить за уголок,
    двигать стрелками, переносить в другую колонку и скрывать. Часы и знак
    станции неподвижны — так и просили.
    Место блока перестало задаваться тем, в каком месте JSX он написан.
    Размет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
2026-08-20 Страница подстраивается под экран: до трёх колонок и своя ширина
    Раньше содержимое сидело в 1080 пикселях посередине независимо от монитора,
    и на широком экране оставались две колонки в рамке пустоты.
    Появилась настройка ширины: обычная (1080), широкая (1500), во весь экран.
    Ноль в таблице означает «без предела» — писать туда 99999 значило бы
    придумать предел там, где его нет, и однажды в не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
2026-08-20 Приборы одного размера, и у каждого блока свой размер
    Шкала скорости, картушка направления и окно камеры стояли рядом
    разнокалиберными: шкала тянулась до 348 px, картушка до 260, а камера до
    всей ширины колонки — каждая до своего предела по ширине.
    Теперь у всех трёх общая приборная область в 300 px. Задаётся высотой, а
    не шириной, именно потому, что пропорции у них разные: шкала и картушка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
2026-08-20 Свободная сетка, приборы во весь блок и движение на всём
    Раскладка. Колонки заменены сеткой из двенадцати дорожек: у блока теперь
    своя ширина и своя высота, и тянутся они за правый край, нижний край или
    угол. Двенадцать дорожек, а не десять, потому что двенадцать делится на
    2, 3, 4 и 6 — половина, треть и четверть выражаются целыми дорожками.
    Высота стала свойством блока, а не следствие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
2026-08-20 Края ограниченной страницы уходят в фон, а не обрываются
    При «обычной» и «широкой» ширине содержимое кончалось ровной вертикальной
    чертой, и на широком мониторе это читалось как «страница не доехала до
    края».
    Теперь фон за колонкой темнеет постепенно. Перехода нет, потому что нет и
    границы: растяжка начинается ВНУТРИ колонки, за шестьдесят пикселей до её
    края, и полный тон набира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
2026-08-20 Линии шапки гаснут к концам, а не обрываются срезом
    Три горизонтальные линии — под шапкой, над строкой состояния и под ней —
    кончались ровным срезом. На потемневших полях по бокам эти срезы читались
    как границы страницы, то есть ровно как то, что затемнение и убирало.
    Теперь все три гаснут к своим концам общим правилом FADE_LINE. Одно
    правило, а не три записи по месту: линии стоят в трёх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
2026-08-21 Темы оформления и тумблеры вместо пар кнопок
    Четыре темы. Тема меняет не палитру — цвета и так настраиваются, — а материал,
    из которого сделан интерфейс: как поверхность отражает свет, есть ли у неё
    толщина и видно ли сквозь неё.
    приборная — как было
    стеклянная — за Liquid Glass из iOS 26
    матовая — чёрная матовая плёнка, ни одного блика
    фосфор — электронно-лучевая трубка
    У стекля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
2026-08-21 Фосфор ломается по-настоящему, стекло перестало размывать впустую
    Тема «фосфор» получила болезни трубки: прогрев из яркой строки при
    включении, срыв кадровой синхронизации раз в девятнадцать секунд, дёрганье
    строчной развёртки и провалы накала. Главное — тема подменяет обе кривые
    плавности на steps(), и весь интерфейс начинает двигаться ступенями: у луча
    промежуточных положений н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
2026-08-22 «Эфир» показывает, как идёт приём кадра
    Картинки со спутника весят от полумегабайта до двух, и на медленной сети
    плитка просто стояла пустой: было непонятно, грузится она, застряла или
    хост вообще не ответил. Теперь кадр качается через fetch с чтением потока,
    и на месте картинки идёт настоящий приём — проценты и мегабайты из
    Content-Length, а не выдуманная полоса, которая ползёт по таймеру.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
2026-08-22 Карта мира стала мировой, а смерч — смерчем
    Отражаемость кончалась на границе США: под ней лежал растр NOAA на
    материковые штаты, и за его краем слой выглядел поломкой, а не пределом
    источника. Теперь это тайловая мозаика RainViewer — сводка национальных
    радарных сетей от NEXRAD до европейской OPERA, — и она есть везде.
    «Суперклетки» были областями прогноза SPC, то есть тоже только США.
    Отдельн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
2026-08-23 Станция перестала терять телефон в поле
    Плата искала домашние сети вслепую: WiFi.begin() на каждое имя из списка,
    по 12 с на молчание. Шесть сетей — 72 секунды метаний по каналам сразу
    после включения, и всё это время своя же точка доступа фактически не в
    эфире. Дома это незаметно (сеть находится с первой попытки), а в поле
    попадает ровно в тот момент, когда человек подключает телефон. Ассоци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
2026-08-23 Аптайм говорит, почему плата стартовала
    Осталась одна развилка, которую нельзя развести рассуждением: «поле» — это
    не только «нет домашней сети», но и «от батареи». Батарея, проседающая на
    передаче, роняет ESP32 в brownout-ресет, и снаружи это выглядит ровно как
    «станция не пускает телефон». Аптайм сам по себе такое от свежего включения
    не отличает — маленькое число в обоих случаях.
    Теп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
    [esp32_wind_station.ino]
2026-08-23 Точка доступа рассказывает, почему клиент ушёл
    Клиент, который не смог подключиться, изнутри невидим: softAPgetStationNum()
    считает только тех, кто дошёл, и телефон, застрявший на «Connecting…»,
    не оставляет ни следа. Драйвер при этом знает причину — WIFI_EVENT_AP_
    STADISCONNECTED несёт код 802.11, — но её никто не слушал.
    Теперь оба события точки логируются в Serial и складываются в кольцо
    на 8 записей, которое отда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
2026-08-23 Точка доступа наконец WPA2, а не что придётся
    Вызов softAP() кончался на apMaxClients, и режимом шифрования было то, что
    в ядре текущего дня лежит в WIFI_AP_DEFAULT_AUTH_MODE. Сохранённый профиль
    этой сети на ноутбуке — WPA3SAE: когда-то точка выходила в эфир вовсе не
    как WPA2, хотя документация всё это время утверждала обратное.
    А точка WPA3-SAE по стандарту обязана держать защиту управляющих кадров.
    Здесь же pmf_cfg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
2026-08-29 Дашборд должен быть живым — канал стал постоянным, а не раз в 5 минут
    Ресерч v4 задачи 10. Требование «удалённый дашборд как локальный, 1-2 секунды»
    похоронило схему «HTTPS POST раз в 5 минут в Worker + D1»: вместо неё постоянный
    MQTT/TLS, 5 пакетов в секунду на всё время сеанса. Что это потянуло за собой:
    - esp-mqtt уже лежит в ядре 3.3.10 (libmqtt.a + TLS в sdkconfig) — внешних
    библиотек не нужно ни одной, и клиент крути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
2026-09-12 Плата стала 38-пиновой, и вся медь на макетке переехала следом
    Модуль ESP-32U вместо DOIT DevKit V1: тот же чип, но антенна только на
    u.FL, мост CP2102 вместо CH340C и — главное — шесть ног SPI-флеша
    выведены на гребёнку. Прошивку это не тронуло ни одним пином, набор
    38-pin оказался надмножеством 30-pin; переделана только разводка на
    макетке, и переделана она дважды: плата заняла колонки 1–19 вместо 1–15,
    и всё п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
2026-09-12 Публичная копия дашборда показывает настоящий ветер, а не синусоиду
    Канал до брокера заработал на железе ещё 12-го, но дашборд о нём не знал
    ничего: в .jsx не было ни одного упоминания mqtt, а wind-ui/.env лежал
    готовый и не читался ни разу. Публичная копия честно объясняла человеку,
    что живых данных здесь быть не может — страница по HTTPS, плата по HTTP,
    браузер такой запрос блокирует. Брокер убира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
2026-09-12 Комплект для ноутбука собирал под старой таблицей разделов
    Схема сменилась 2026-09-11, app0 вырос с 1 310 720 до 1 966 080 байт, и
    FQBN в основном проекте носит суффикс PartitionScheme=min_spiffs с того
    же дня — а скрипты в архиве остались на голом esp32:esp32:esp32. То есть
    собранное ими попадало под другую таблицу разделов, чем всё остальное.
    Две вещи здесь проверены опытом, а не догадкой. Каталог сборки от опций
    FQBN не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
2026-09-12 Станция сама ходит за обновлением — на мачте иначе никак
    espota открывает соединение К плате, а оператор выдаёт CGNAT-адрес: входящего
    соединения до мачты не существует в принципе. Значит обновление должно быть
    тянущим, и команда `ota` перестала отвечать отказом.
    Право на заливку даёт подпись команды, а не TLS: url и sha256 едут внутри
    подписанного конверта, поэтому подменённый на хостинге фай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
2026-09-12 4G стоит половины резерва — энергобюджет пересчитан честно
    Шаг 36 задачи 10. Считать пришлось со стороны батареи, а не по шине: у станции
    две независимые ветки с разными КПД, и складывать их токи бессмысленно. ESP32
    и датчик идут через буст №2 (0.89 Вт на шине = 1.05 Вт от банки), модем — через
    свой буст №3 прямо с OUT+ TP4056 (0.57–1.15 Вт от банки).
    Итого 1.62–2.20 Вт, автономка 10–13 часов против 20.7 без моде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
2026-09-12 Очередь задач всё ещё обещала работу, которая уже сделана
    Строка задачи 10 в tasks/README.md называла шаги 38 и 39 незакрытыми,
    а чеклист самой задачи держал пункт про документацию открытым, хотя
    все пять шагов (36–39) закрыты. Открытым остаётся не документ,
    а три проверки на железе — они и названы блокером.
    Claude-Session: https://claude.ai/code/session_015fia8ck2Bp56tQJgyW5a1u
2026-09-26 Дисплей в корпусе: своя плата CYD по одному проводу, стекло Tinted
    «TPM408-2.8» оказался ESP32-2432S028 (Cheap Yellow Display) со своим ESP32,
    поэтому он не висит на пинах станции, а получает кадр /api/data по проводу
    GPIO23 → CN1 IO27, UART 115200, 5 раз в секунду. WiFi отвергнут: клиент на
    точке навсегда заглушил бы поиск домашней сети.
    Станция: HAS_DISPLAY_LINK, кадр пишется только если влезает в кольцо (dispDrop
    в телеметрии). Ради UART1 PPP пере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
2026-10-23 Выключатель на два полюса: одного мало, когда в шину входят два источника
    Задача 11. Куплена клавиша KCD4 (250 В / 16 А, четыре ножевых контакта) —
    то есть DPST, тот самый «апгрейд до двух полюсов», который раньше числился
    необязательным. Нужен он потому, что в шину идут адаптер через D1 и батарея
    через Boost#2 и D2: полюс в разрыве OUT+ гасит только батарейную ветку, и при
    воткнутом адаптере «выключе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
2026-10-23 Байткод Python больше не в истории
    Генераторы images/*.py при каждом запуске переписывали .pyc, и они тихо
    уезжали в коммиты (в прошлом — bb_lib.cpython-313.pyc). Десять файлов
    сняты с учёта (на диске остались), __pycache__/ и *.pyc — в .gitignore.
2026-11-07 Страница-установщик на GitHub Pages: файлы с Google Диска, компьютер не нужен
    Кнопки ведут на постоянные id в Kiwi_Drop/updates, поэтому ссылка всегда
    отдаёт свежую сборку. Копия desktop/site/index.html.
